MCBailey-CTS/0Library/0Customer/Tower/Bardstown-specific/Nitro Manifold/photo 1.JPG

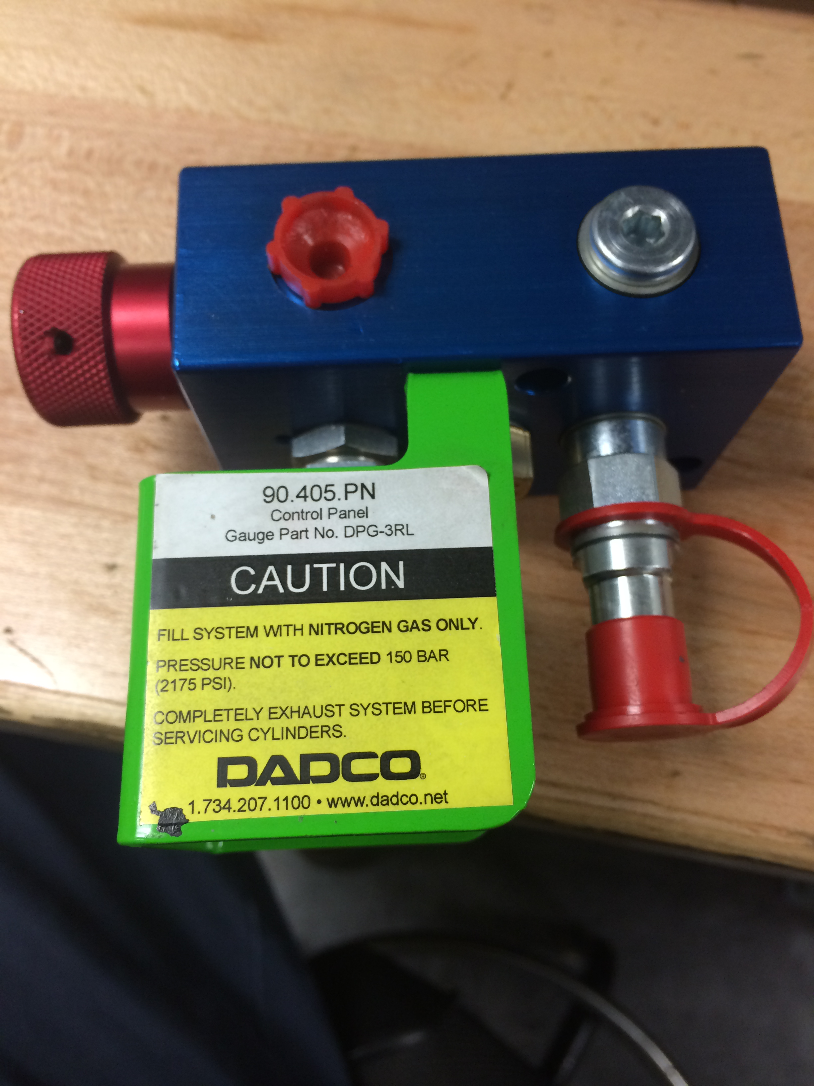
0Customer/Tower/Bardstown-specific/Nitro Manifold/photo 1.JPG
