MCBailey-CTS/0Library/CurveImport/ReadMe.txt

User Defined Reusable Object

Select Folder location from Folder View
Enter Descriptive Name and Part File.
Define Preview Image with Graphic Area
Select all objects with "General" filter (at the top)
