MCBailey-CTS/0Library/SeedFiles/ClampFeetDocs/Van Rob Aurora clamping and hilo info.txt

All clamping lugs/ears should be a standard height of 2" x 3" wide x 3" deep 
All slots in clamping lugs/ears to be 1.125" - 1.250" (clearance for a 1" T-bolt) 
All clamping is manual with the exception of P221 which has hydraulic clamps, 
for which you are not building any tools To confirm, all Van-Rob locations use the same cone type locators.

Regards,

Chuck Haller
Tooling Co-ordinator
Van-Rob, Aurora
Tel. 905-727-8585 ext. 207
Cell. 647-296-0548

HI-LO

6 inches wide forks 
72 outside to outside is max width
