MCBailey-CTS/0Library/0Customer/UGS/Sample Design/2103-000_Binder Cover.docx

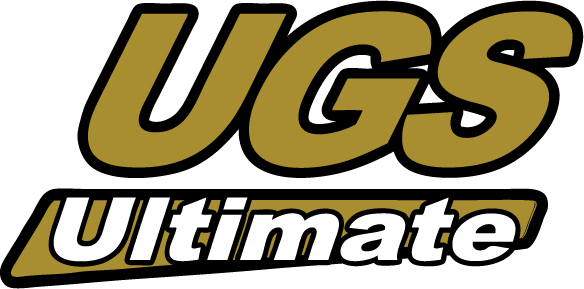
[picture p3: figure]
UGS-Logo

Ultimate Gaging Systems

555 Plymouth Ave. NE

Grand Rapids, MI 49505

616-264-6962

Part name: BRKT SPARE TIRE HOIS

Part #: anu21851.geo_fin001.001002

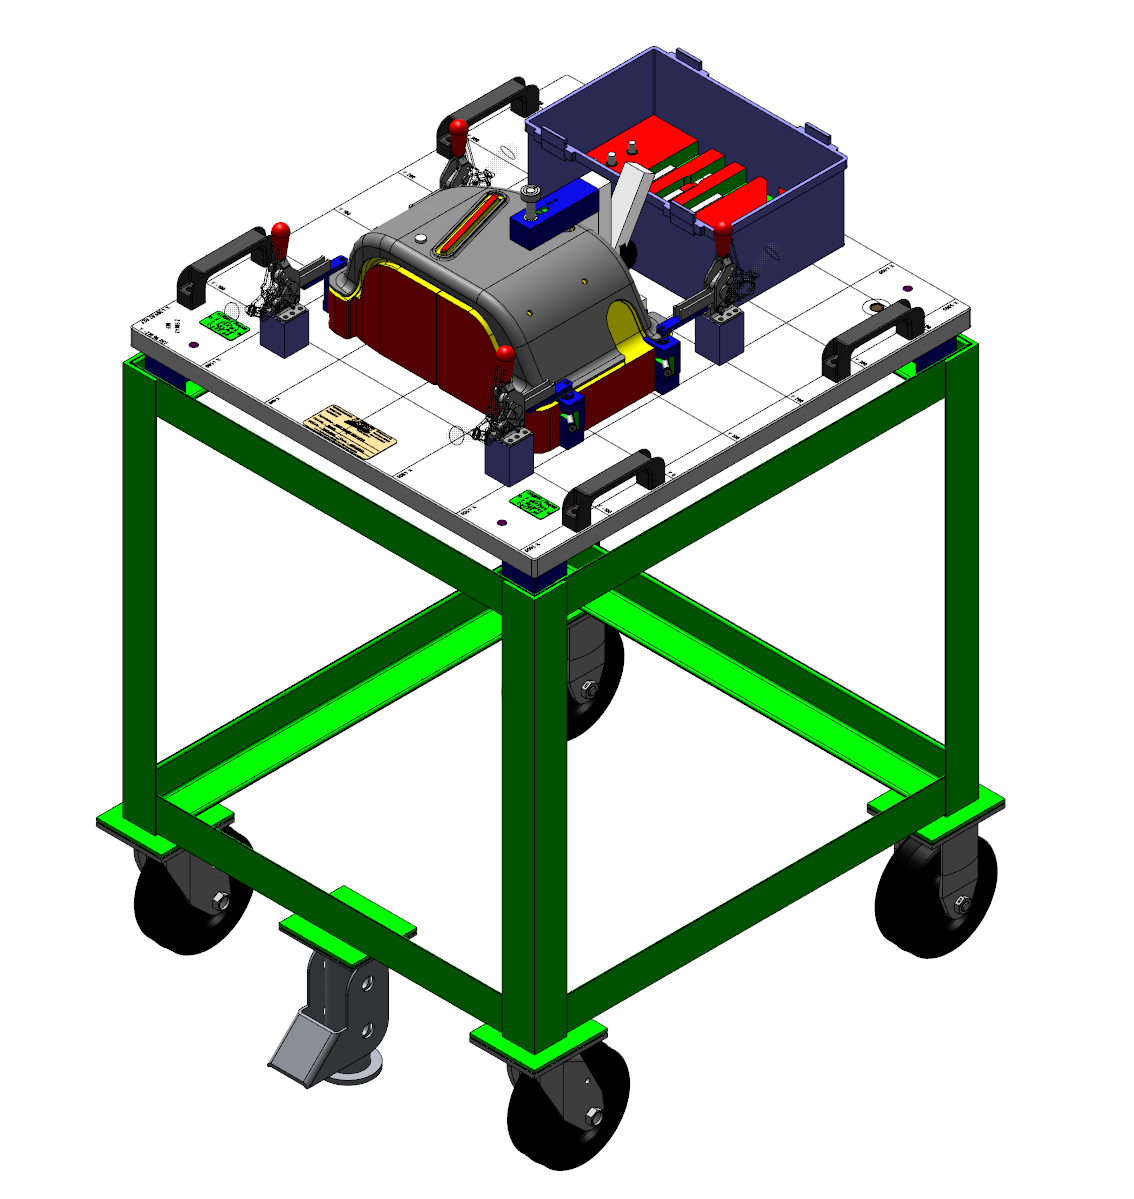
[picture p4: figure]

UGS Job: 2103-000

Customer: ETS

Contact: Brian Bkius
