MCBailey-CTS/0Library/Gauges/Misumi/Misumi Nest Gauges Upper Sub Tools.docx

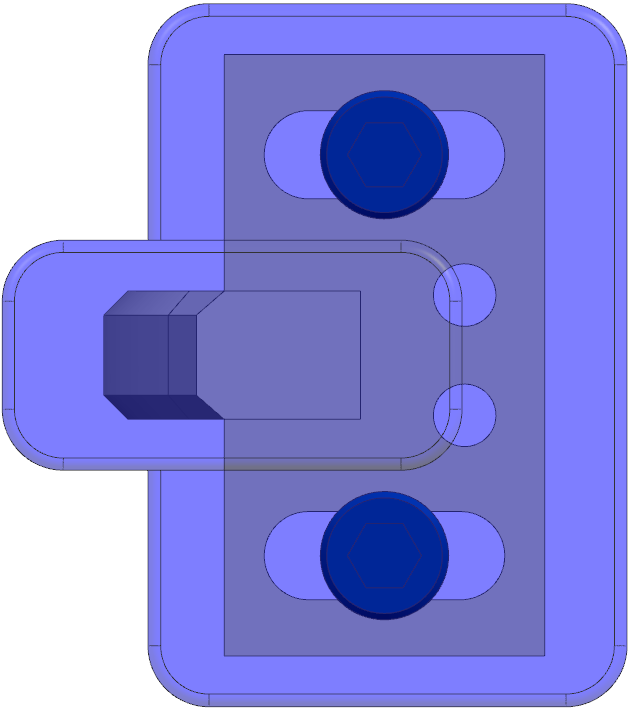
[picture p5: figure]

LEFT

RIGHT

FRONT

BACK

FRONT & BACK – Defaults to SlotWidth/2 +.125”
