MCBailey-CTS/0Library/SeedFiles/ClampFeetDocs/Fanello Die Mounting.pptx

## Die Mounting

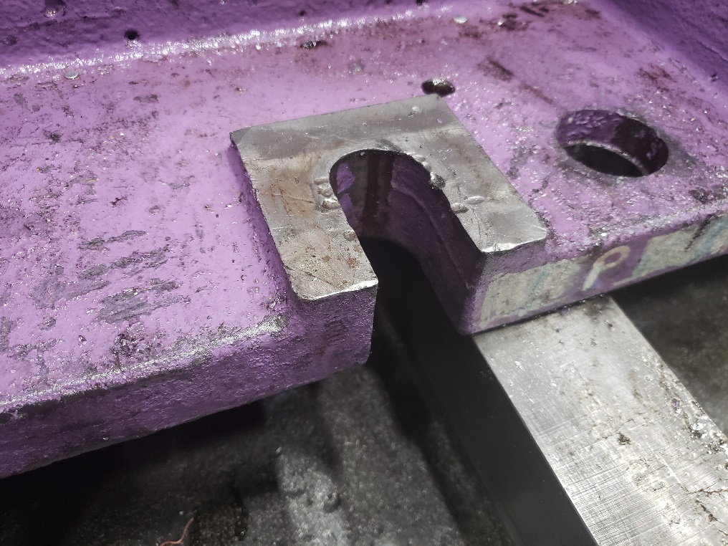
[picture p6: figure]
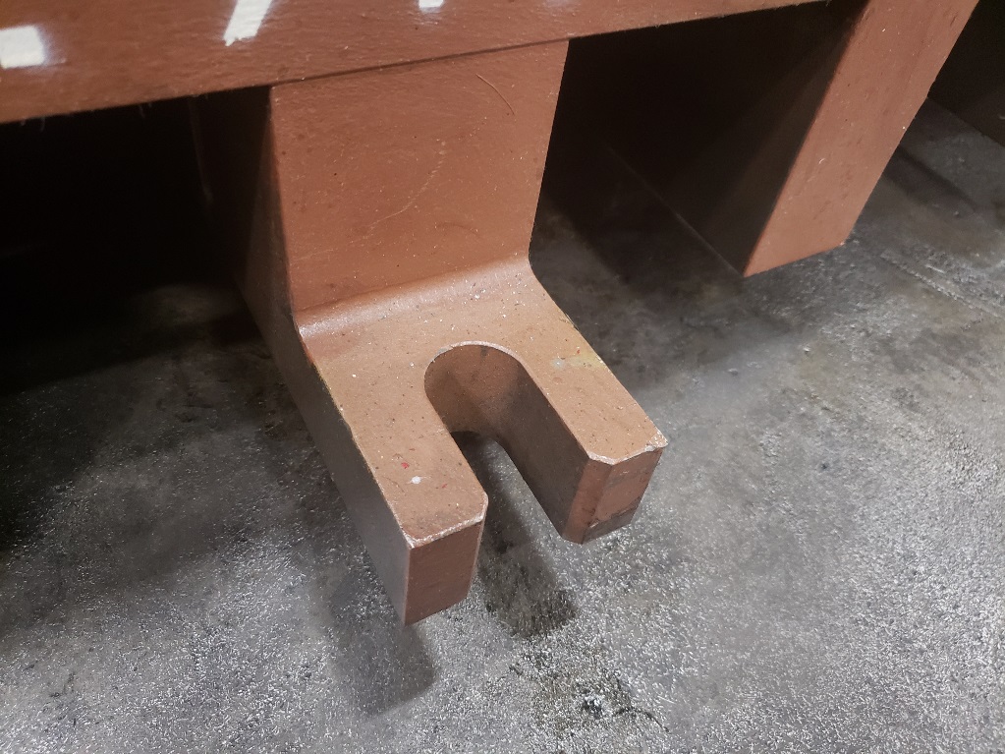
[picture p7: figure]

Slot in either die shoe or parallels. Slots must be 1.125” wide by min of 3” deep
