MCBailey-CTS/0Library/SeedFiles/ClampFeetDocs/MAGNA AUTOTEK.pptx

MAGNA AUTOTEK LOWER

125mm

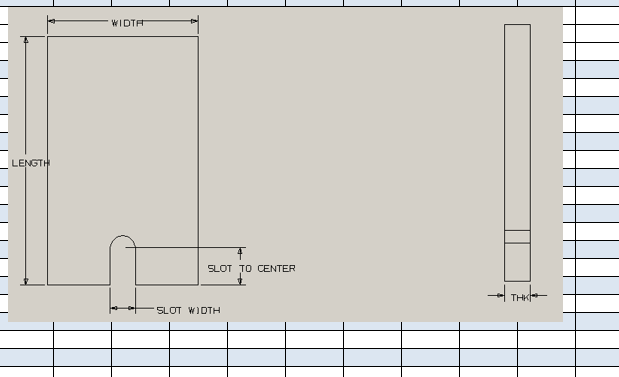
[picture p8: figure]

135mm

98.5mm

63.5mm

35mm

## Slide 2

MAGNA AUTOTEK UPPER

125mm

135mm

98.5mm

63.5mm

50mm
