MCBailey-CTS/0Library/Documentation/CamPositiveReturns.pdf

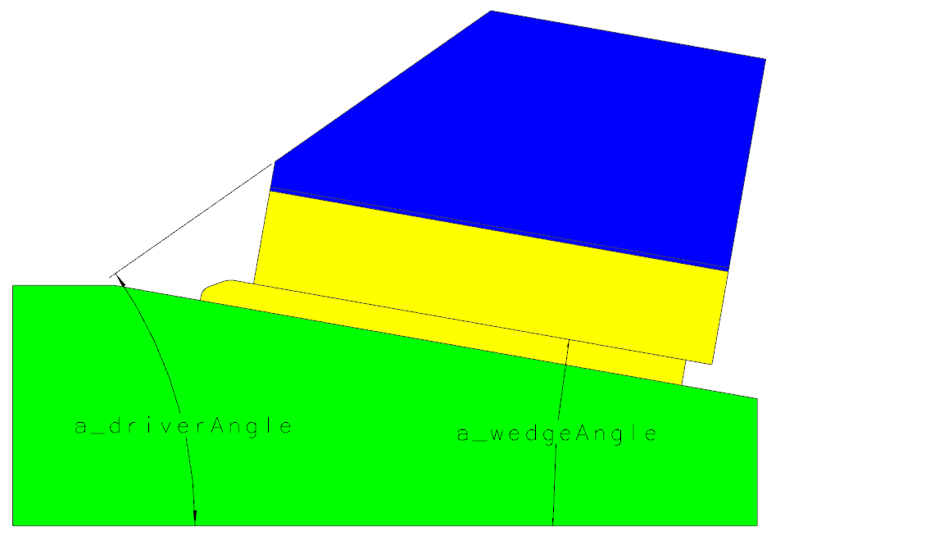
[picture p13: page 1]

DIE MOUNT CAM

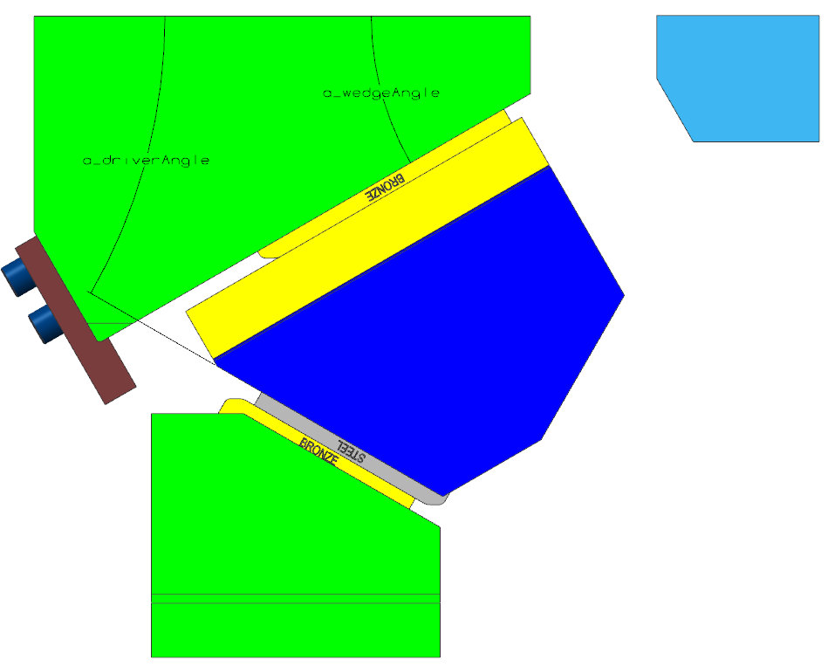
[picture p14: page 2]

AERIAL CAM

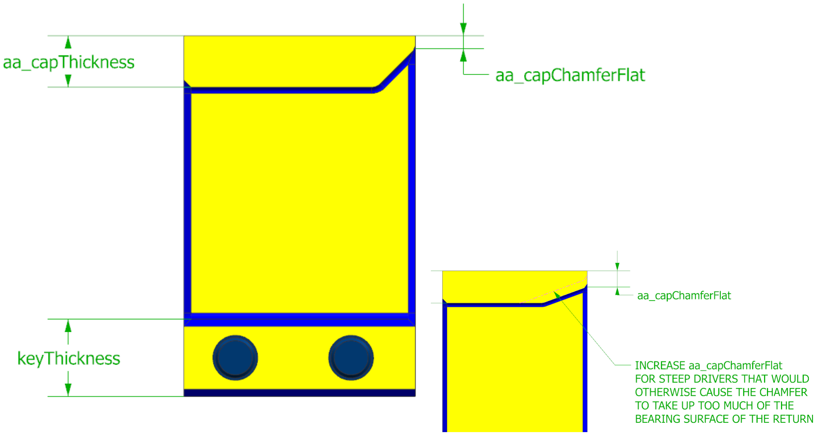
[picture p15: page 3]
