MCBailey-CTS/0Library/SeedFiles/ClampFeetDocs/AE_Metals Stamping Global_2012 21.pdf

Johnson Controls Automotive Experience Global Supplier Standards Manual Tooling and Equipment
Chapter 2
Metals Stamping Dies – Global Tooling Standards

December 2012

Uncontrolled if printed | Page 21 of 40
4.12.3. Stops to be manufactured to the exact inside shut height. Each stop block to be grooved at the center 10mm wide and 1.25mm deep.
4.12.4. All stop blocks to be located between upper and lower parallels.
4.12.5. One safety-block location to be provided on each side of the die.

### 4.13. Parallels

4.13.1. All parallels are to be ground top and bottom.
4.13.2. Proper feed line and shut height to be maintained on all dies per Figure 4.
4.13.3. Parallels used for clamping and locating must be dowelled to the die shoes and sub plates (if present).

4.13.3.a. Parallels must have slotted feet for clamping. Slots will be 28.5mm wide and 65mm long. The position of the upper and lower clamping slots must match the JCI/CM press specified.

4.13.3.b. Clamping flat area must be 100mm long and wide.

4.13.3.c. Clamping height above press ram and bolster must be 50mm.

4.13.3.d. If feet are not outside the die-set periphery, 127mm clearance is required above the clamping surface, for both upper and lower die-set.

4.13.3.e. Lower parallels must have locating features to match the JCI/CM press specified. Tools must have die locators as shown in Figure 8.

4.13.4. Parallels for dies 300 ton and over will be a minimum of 50mm thick.
4.13.5. Parallels for dies 800 ton and over will be a minimum of 62mm thick.
4.13.6. Bolts used for fastening parallels must be a minimum of 19mm diameter.

### 4.14. Transfer Tools

4.14.1 All transfer tools require lower change master plate.
