MCBailey-CTS/0Library/SeedFiles/ClampFeetDocs/Pages from UPDATED FORMEX DIE STD_September-2017 R1.pdf

# FORMEX DIE STANDARDS

## Clamps Model PTC & AIDA Presses

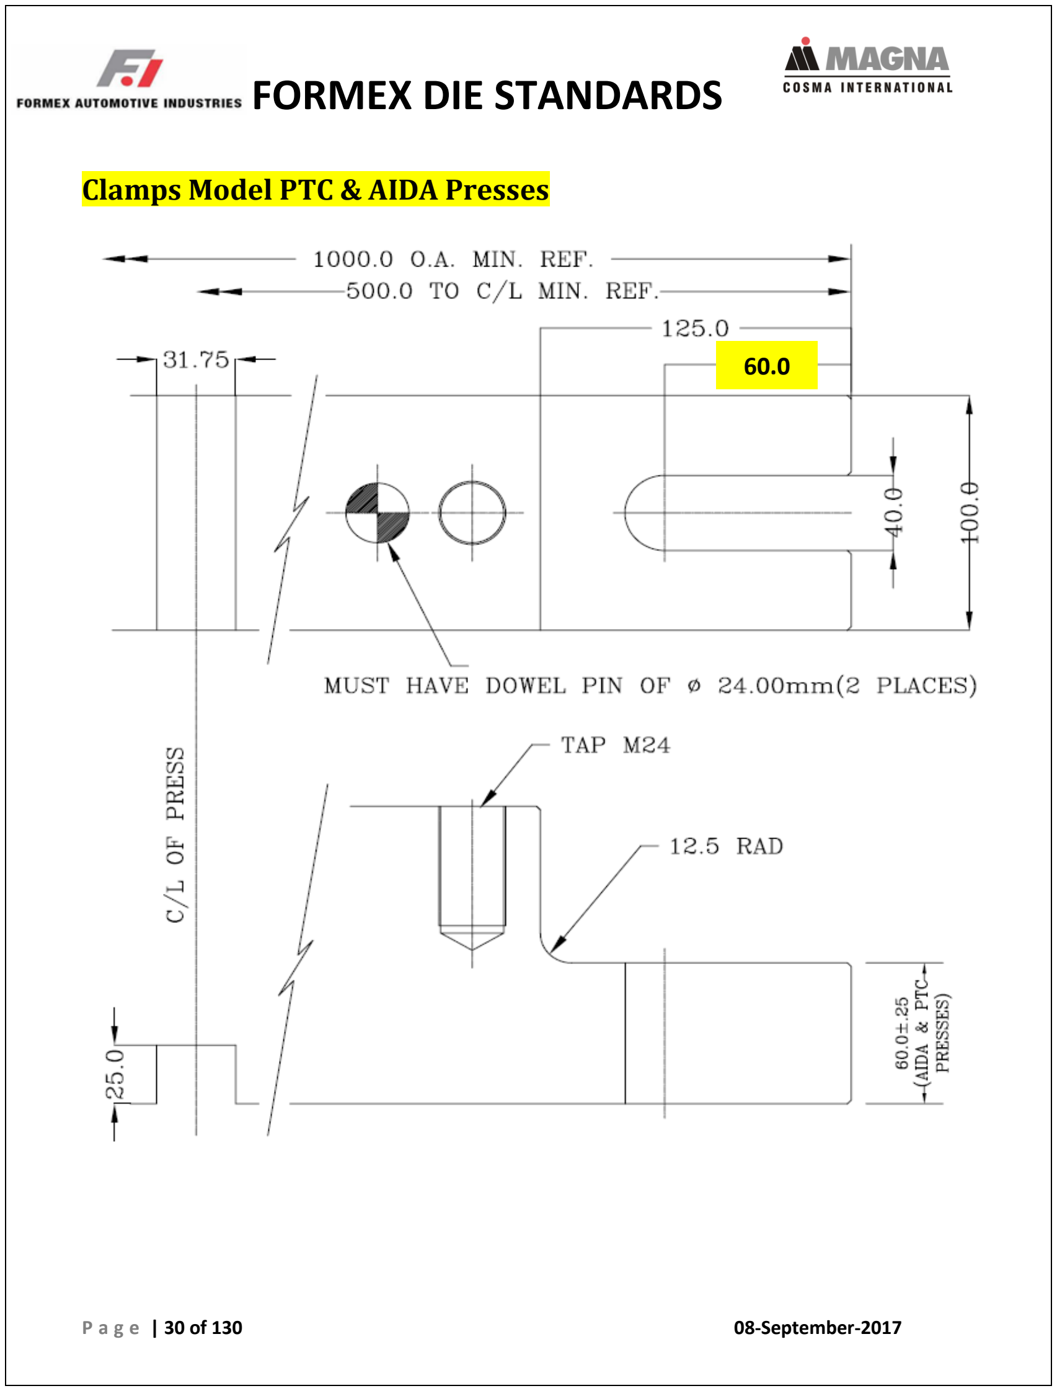
[picture p16: page 1]

P a g e | 30 of 130 | 08-September-2017

60.0
