MCBailey-CTS/0Library/0Customer/UGS/Design Worksheet Checklist 6-21-2017.xls

Design Worksheet Checklist |  | YES | NO | N/A | FIXED
1 | Verify design satisfy all items on Quote & GD&T are Being Checked
2 | Verify datums match GD&T
3 | Verify flatness area is identified
4 | Verify SPC Checks are identified
5 | Verify that if possible the base is within our CNC work envelope
 | The vise max opening in 12.250"
 | The Hurco is 24.5" X 52"
 | The YCM is 24.5" X 52" or 21" X 57"
6 | Verify all Go/Nogo pins are identified and accounted for
7 | Verify feeler and flush areas are identified.
8 | Verify stabs are identified and it's clear where they are used.
9 | Verify Layout Drawing(s) indicate usage of hand apply items.
10 | Verify that any missing information is noted.
11 | Verify design used customer standards.
12 | Is any missing information noted
13 | Does GD&T match the CAD.
14 | Verify the proper data level is being used.
15 | Verify the proper GD&T level is being used.
16 | Verify all details are useable.
 | Can you use all the stabs on the job without interference.
 | Can you use the indicators in all SPC bushings without interference.
 | Can you open the clamps without interference.
 | Can you open the swings without interference.
17 | Verify mountings holes matched to their mating details.
18 | Verify details are using the proper material type.
19 | Verify all details included in stocklist with correct quantity.
20 | Can you load and unload a part
21 | Is there any features that require adjustability
22 | Do purchase items have the correct part number
23 | Verify details prints indicate additional process if needed.
24 | Verify pin tolerances are labeled to customer tolerances.
25 | Did you create Edrawing files
26 | Did you create .iges files for CMM
27 | Did you update the 2D and 3D .pdf files
28 | Did you export a .step file of the model
29 | Verify the gage instructions are in the book.
30 | Make outsource files if needed.
31 | Delete old files.
Note for Design Update:
