MCBailey-CTS/0Library/SeedFiles/ClampFeetDocs/Toledo Clamp Specs for 1000 3000 presses.xlsx

1000 T CLAMPING INFORMATION UPPER AND LOWER
3000 T CLAMPING INFORMATION UPPER AND LOWER
