MCBailey-CTS/0Library/0Customer/UGS/Sample Design/2103-000_Booking Check List 6-8-2017.xls

Design Checker Checklist |  |  | DATE : |  | 2018-05-08
CUSTOMER : |  | ETS | JOB# : |  | 2103
CHECKED BY : |  | TN | YES | NO | N/A | FIXED
1 | Can part be load / unload without interference?
2 | Verify all details are useable?
3 | Can you use all the stabs on the job without interference?
4 | Can you use the indicators in all SPC bushings without interference?
5 | Can you open the clamps without interference?
6 | Can you open the swings without interference?
7 | Verify all details included in stocklist with correct quantity.
8 | Verify mountings holes matched to their mating details.
9 | Verify all details that requires details print accounted for.
10 | Verify details prints & stocklist for proper material type.
11 | Verify details prints & stocklist use the proper size.
12 | Verify details prints indicate additional process if needed.
13 | Verify details prints include all info required to make details.
14 | Verify pin tolerances are labeled to customer tolerances.
15 | Create Edrawing files
16 | Create .iges files for CMM
17 | Update the 2D and 3D .pdf files
18 | Export a .step file of the model
19 | Verify the gage instructions are in the book.
20 | Make outsource files if needed.
21 | Delete old files.
Note for Design Update:
