MCBailey-CTS/0Library/SeedFiles/ClampFeetDocs/Gonvarri_Clamp_Specs.pptx

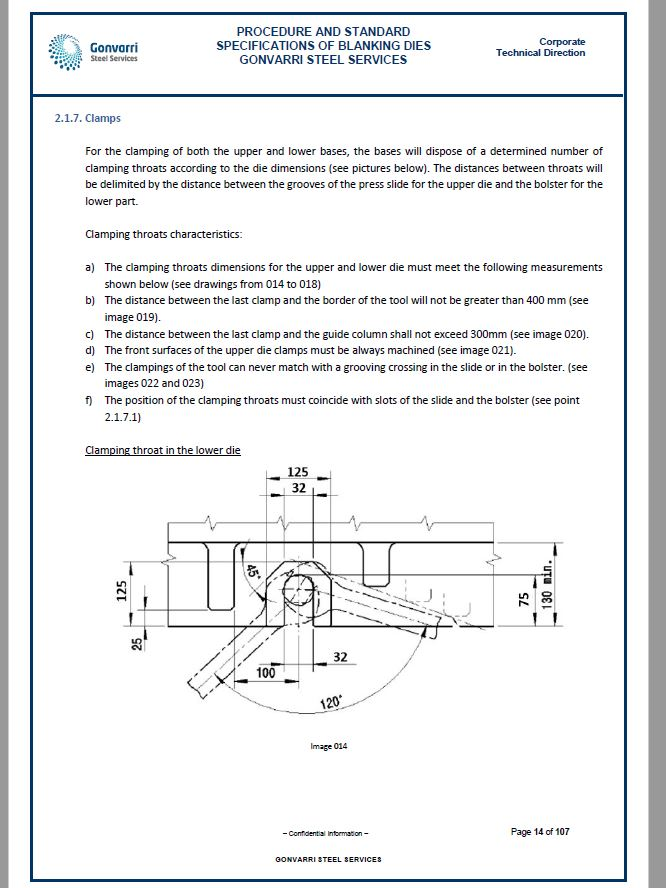
[picture p17: figure]

## Slide 2

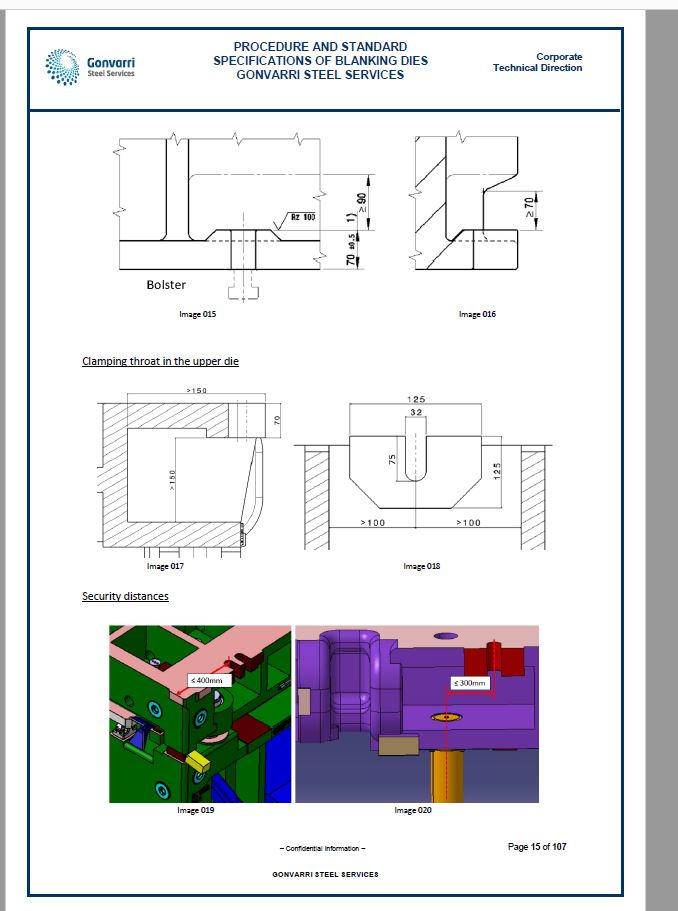
[picture p18: figure]

## Slide 3

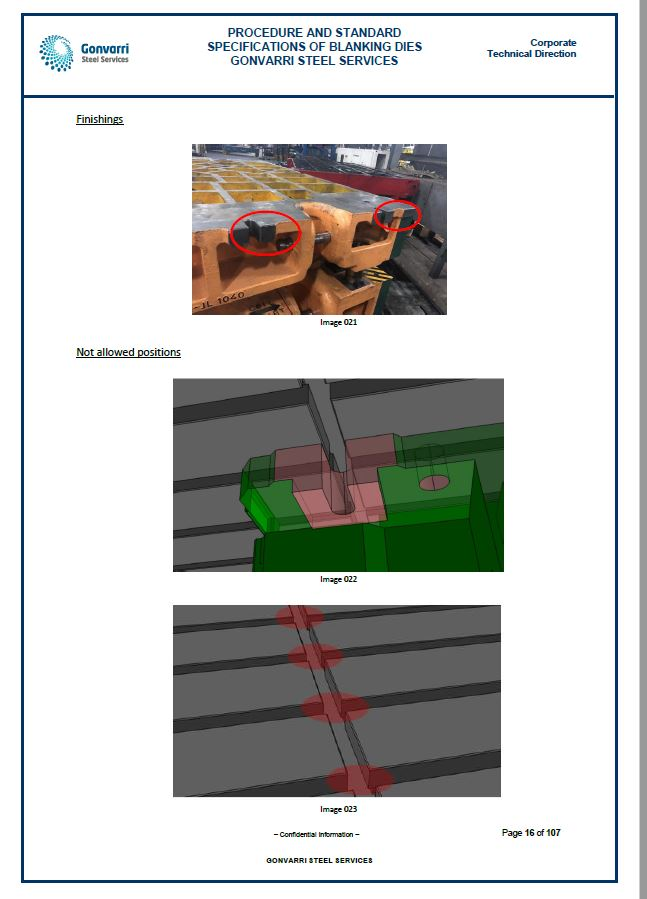
[picture p19: figure]

## Slide 4

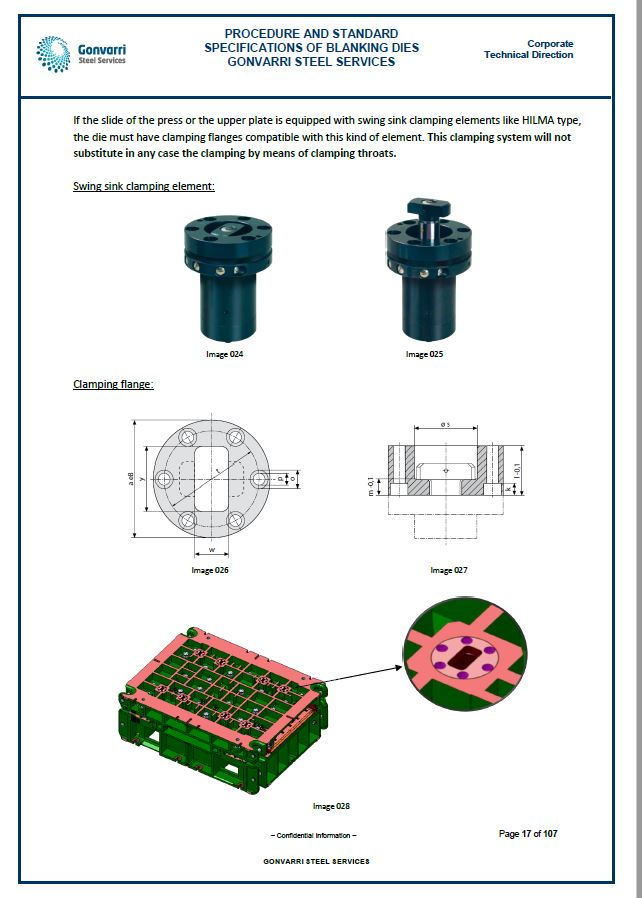
[picture p20: figure]
