MCBailey-CTS/0Library/SeedFiles/ClampFeetDocs/Shiloh Clamp Feet Specs.docx

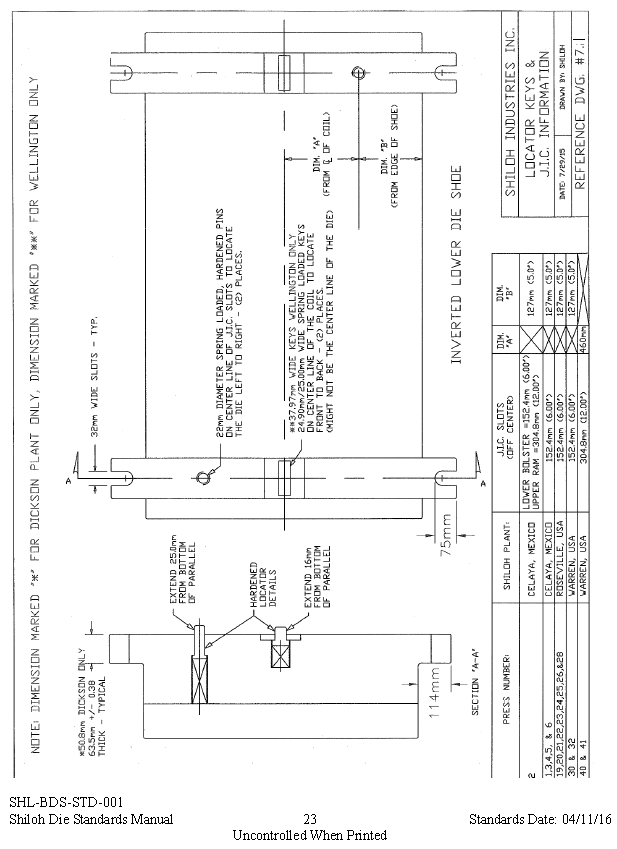
[picture p21: figure]
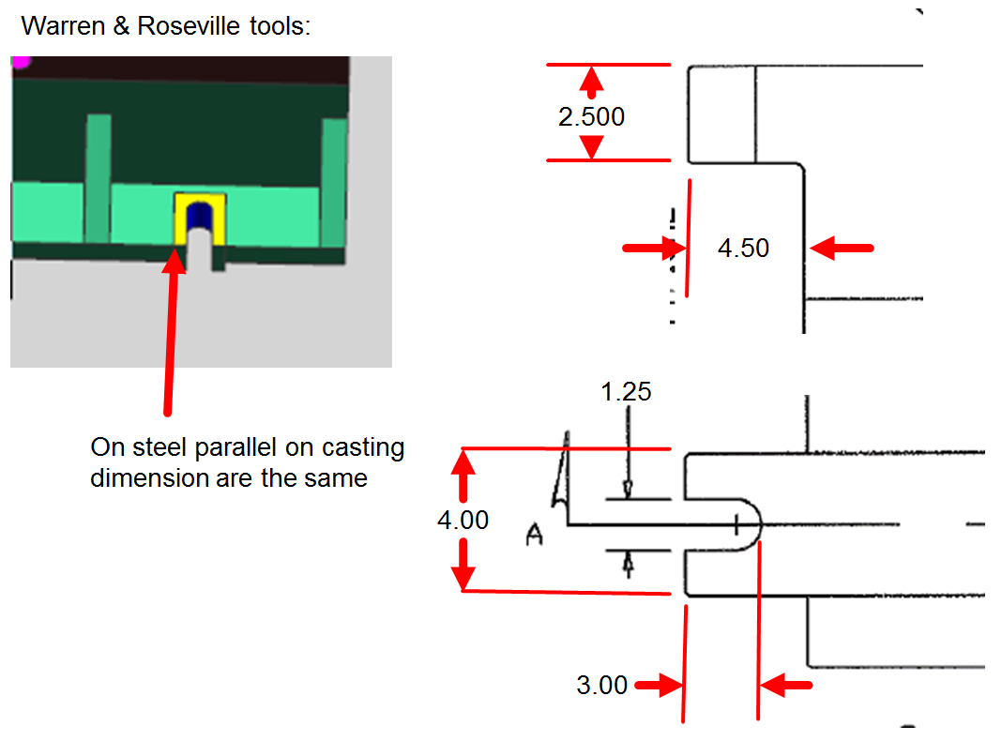
[picture p22: figure]
