MCBailey-CTS/0Library/SeedFiles/ClampFeetDocs/186 - PK USA - 200Ton C Frame.docx

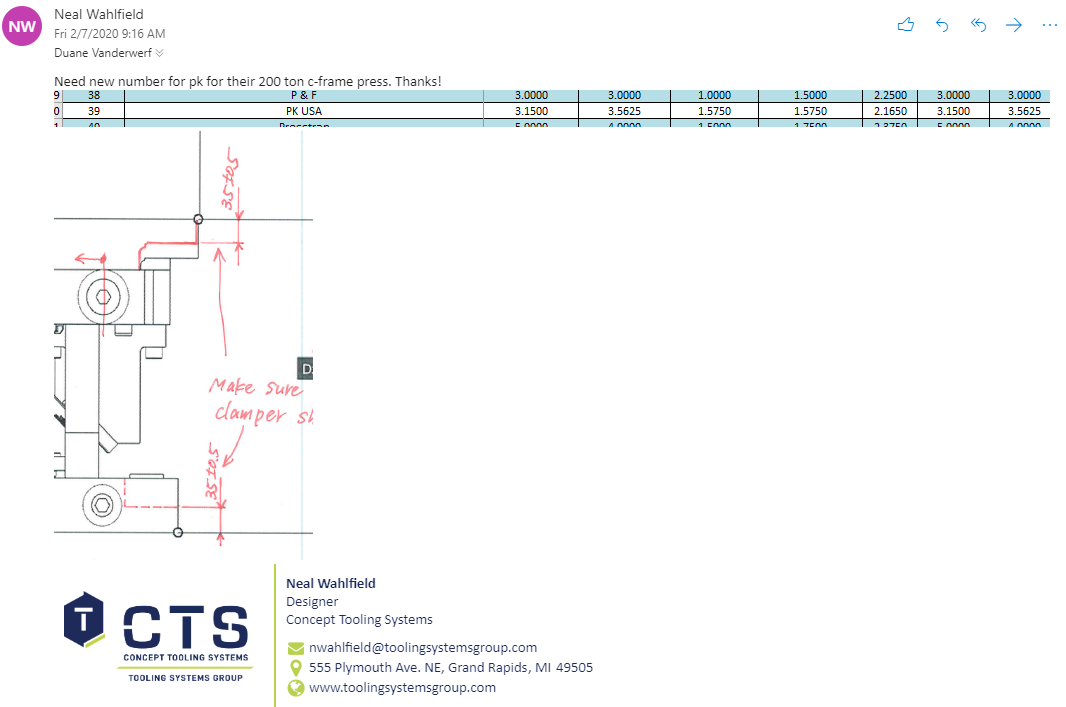
[picture p69: figure]
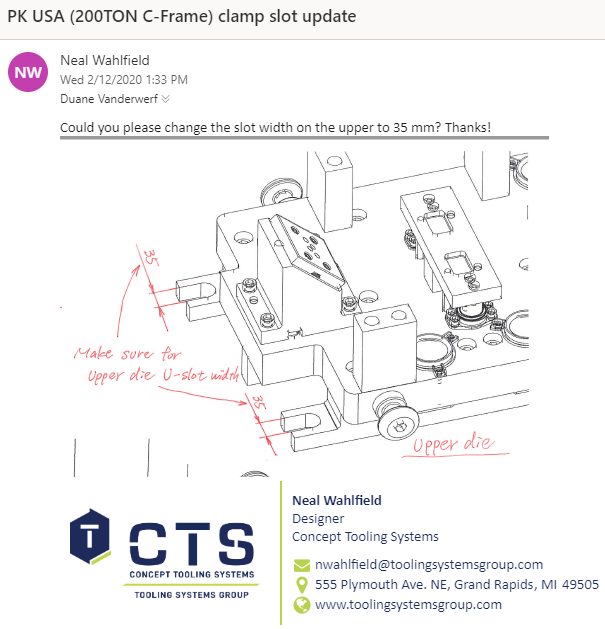
[picture p70: figure]
