MCBailey-CTS/0Library/SeedFiles/ClampFeetDocs/209 - Kirchhoff 550 Ton Press.docx

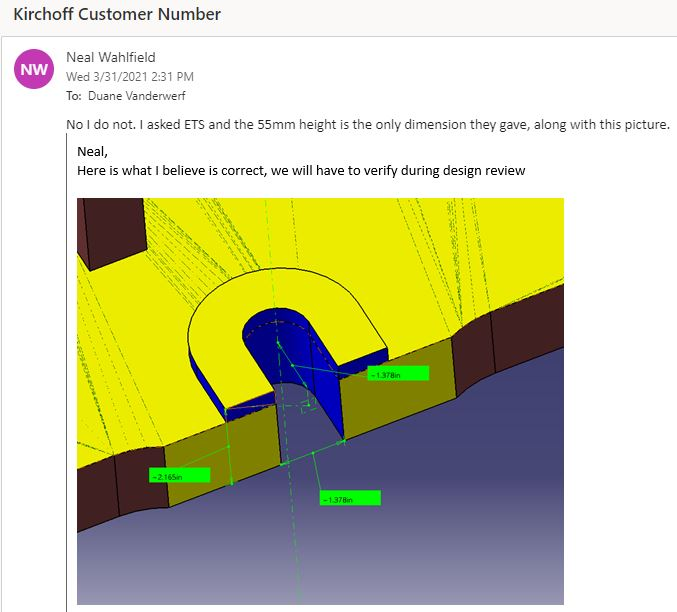
[picture p71: figure]
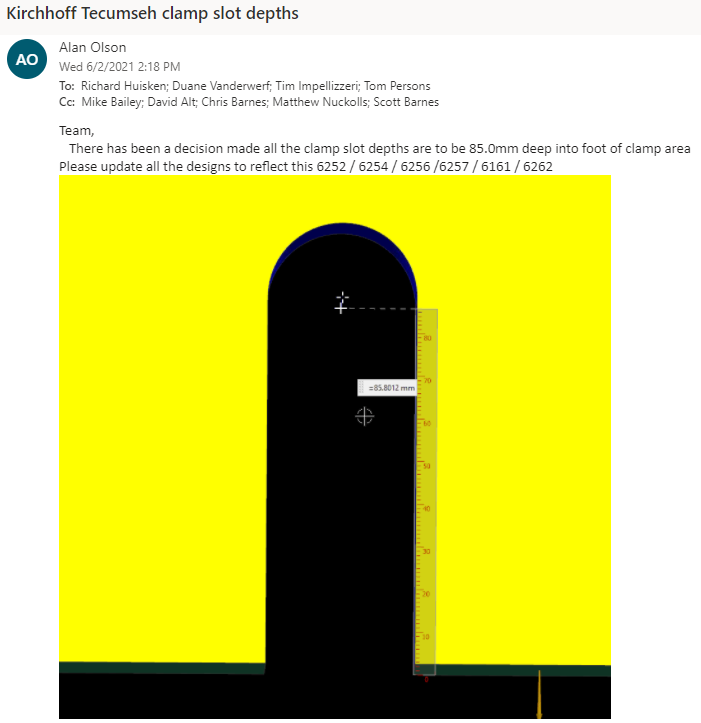
[picture p72: figure]
