MCBailey-CTS/0Library/SeedFiles/ClampFeetDocs/213 - Tesla Eson Mexico.docx

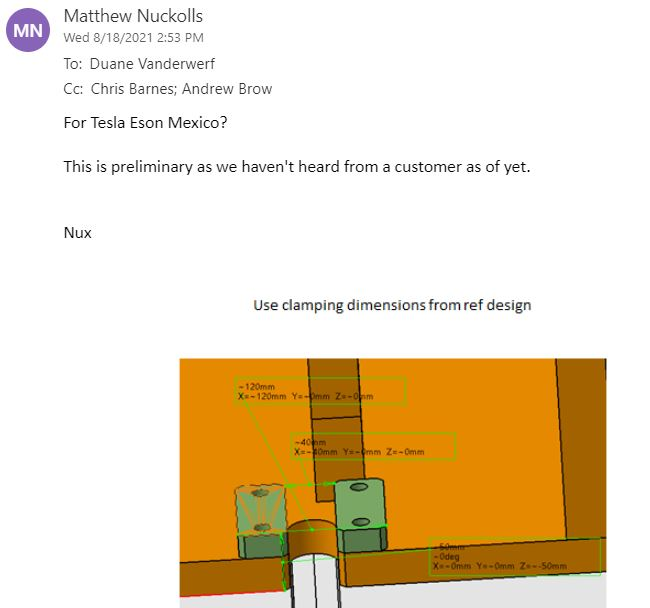
[picture p73: figure]
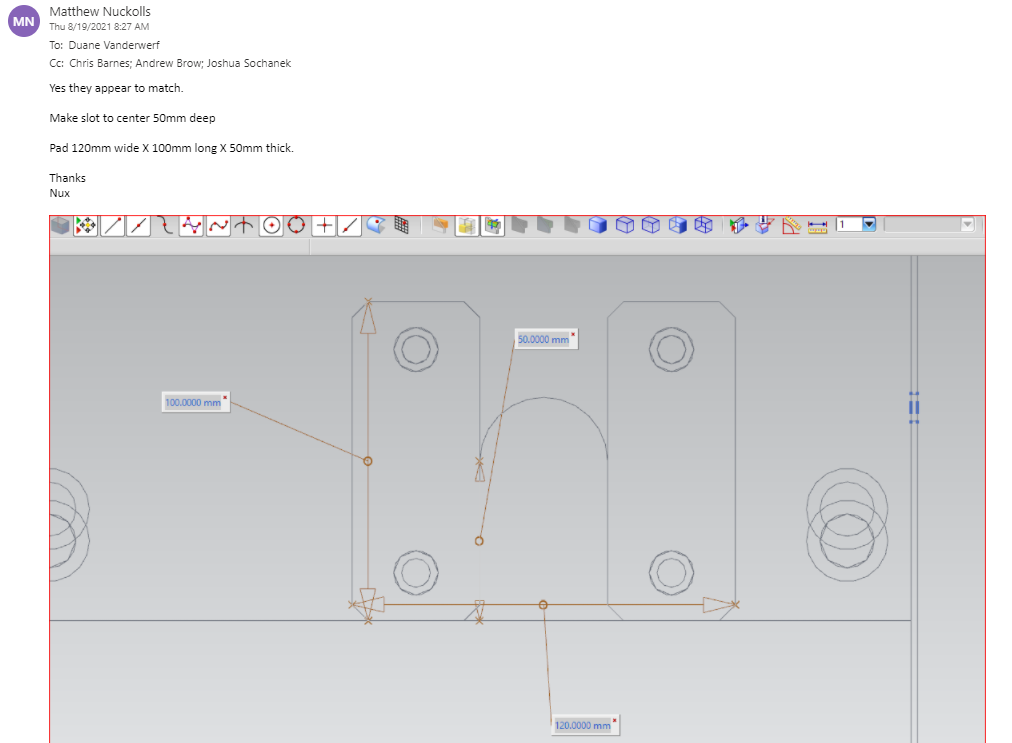
[picture p74: figure]
