MCBailey-CTS/0Library/SeedFiles/ClampFeetDocs/215 - Erdrich 500Ton.docx

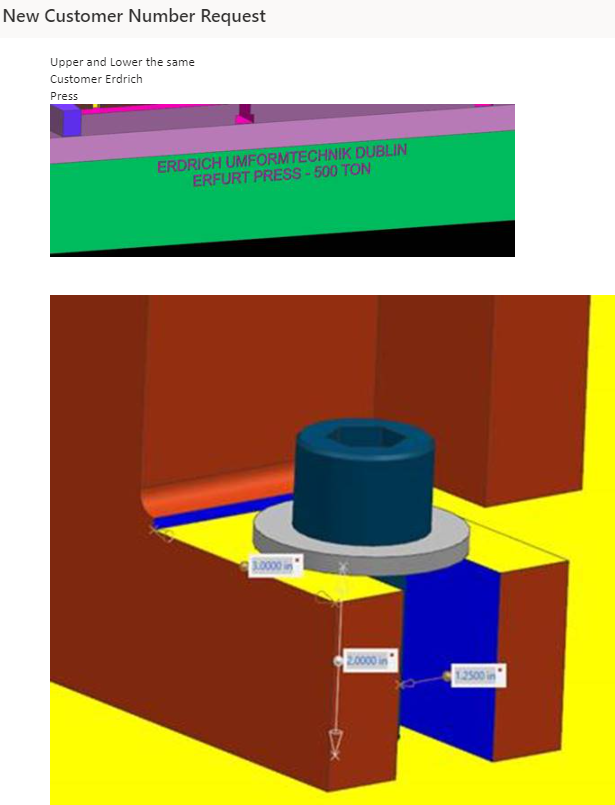
[picture p75: figure]
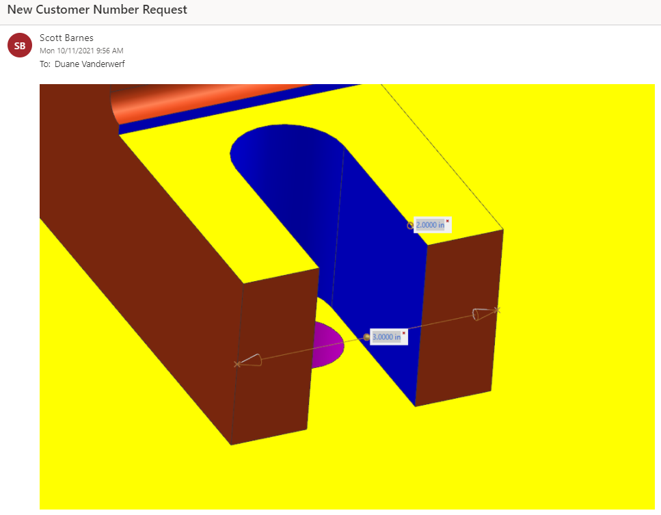
[picture p76: figure]
