MCBailey-CTS/0Library/SeedFiles/ClampFeetDocs/GeStamp Mexico CustomerNo 83.docx

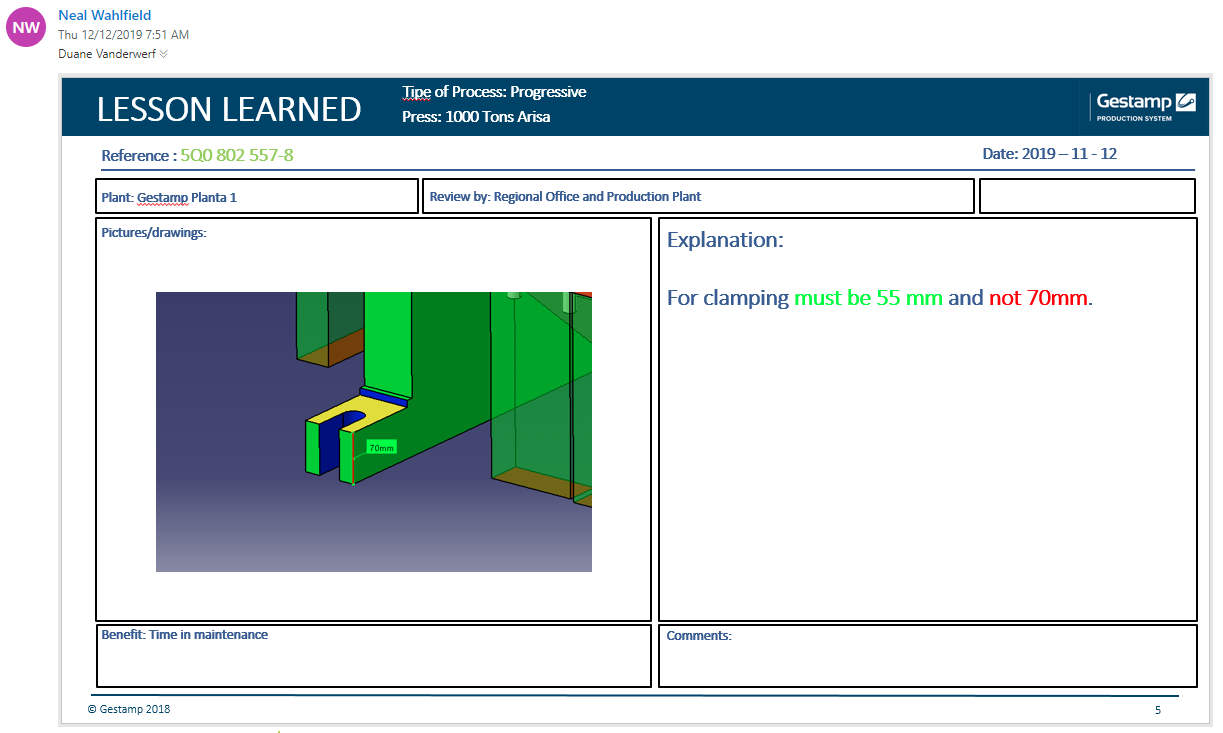
[picture p77: figure]
