MCBailey-CTS/0Library/SeedFiles/ClampFeetDocs/Highland Diversified Services.docx

Chad Kooienga

Mon 4/15/2019 9:53 AM

https://toolingsystemsgroup.sharepoint.com/TSG/PM20/Customer%20Standards%20Library/Forms/AllItems.aspx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

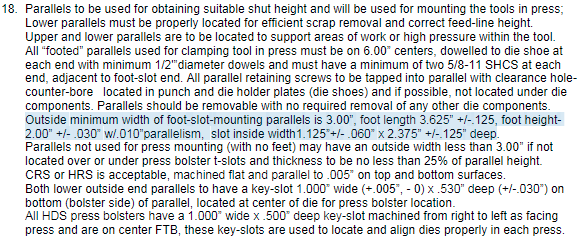
[picture p78: figure]

Chad Kooienga

CTS

Designer/Diemaker

ckooienga@toolingsystemsgroup.com

616-264-6952
