MCBailey-CTS/0Library/SeedFiles/ClampFeetDocs/Tenneco Walker-Elkhart 400 Ton.docx

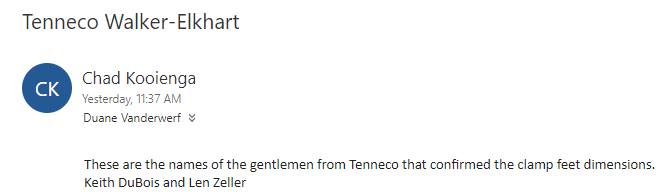
[picture p79: figure]
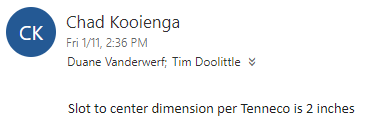
[picture p80: figure]
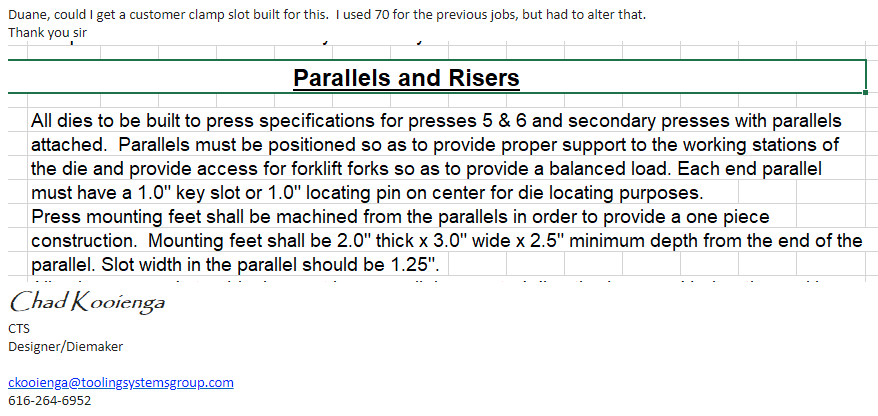
[picture p81: figure]
