MCBailey-CTS/0Library/SeedFiles/ClampFeetDocs/Tower Bardstown Press 1 and 2.docx

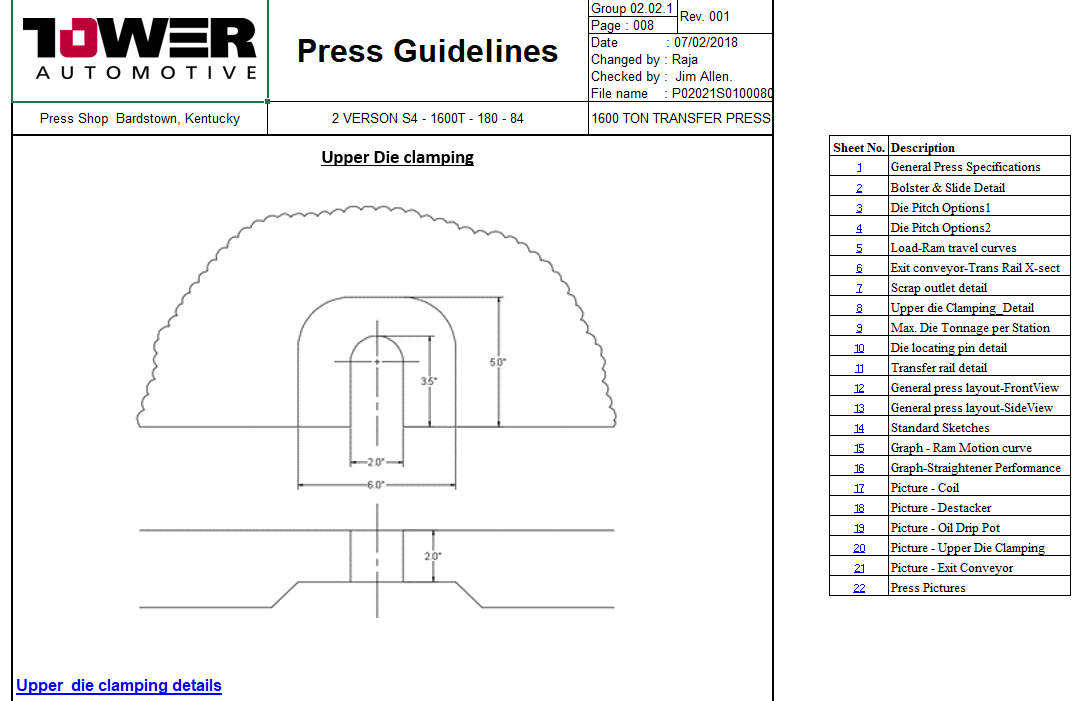
[picture p82: figure]

SharePoint – Presses – Tower Automotive – Press Documents – Bardstown – 02-1600Ton
