MCBailey-CTS/0Library/SeedFiles/ClampFeetDocs/Tower Chicago Presses 1-2-3.pptx

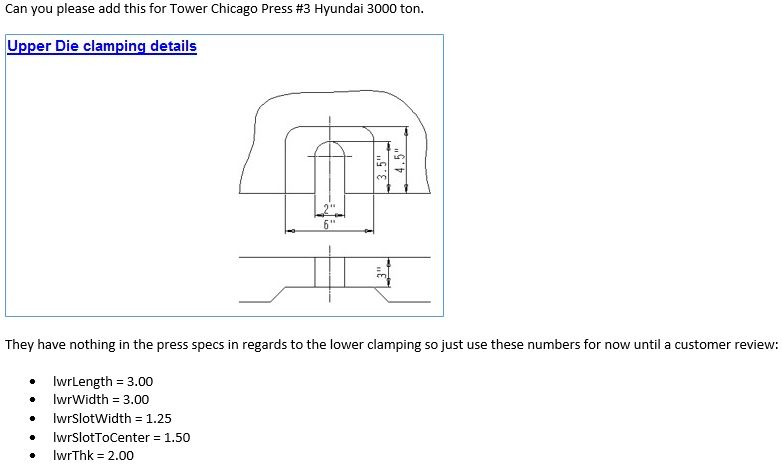
[picture p83: figure]

## Slide 2

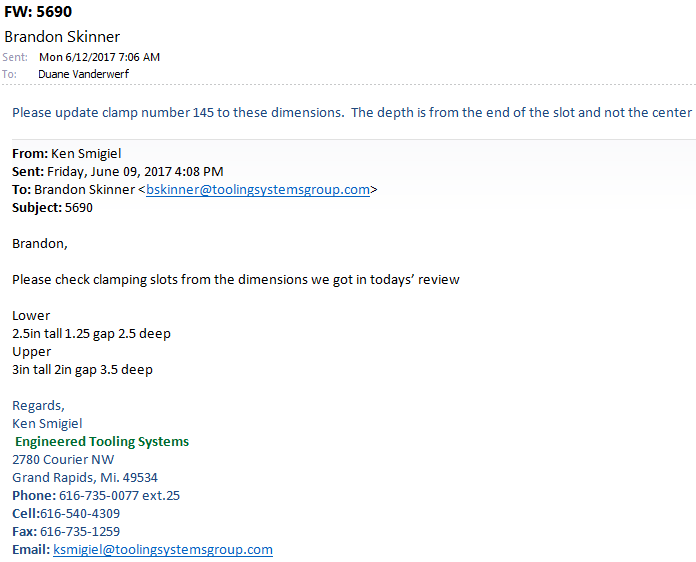
[picture p84: figure]
