MCBailey-CTS/0Library/SeedFiles/Layout/Deploy Updates Process.docx

XXXX-900-strip

XXXX-010-strip

XXXX-010-strip

XXXX-010-layout

XXXX-020-layout

XXXX-strip-control

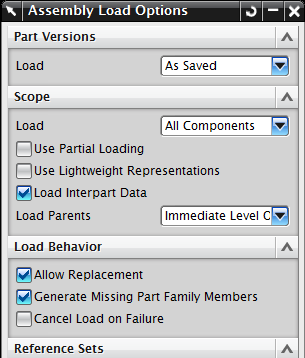
[picture p85: figure]
