MCBailey-CTS/0Library/Stamps/CumsaMarkingUnits/4-digit stamp.pptx

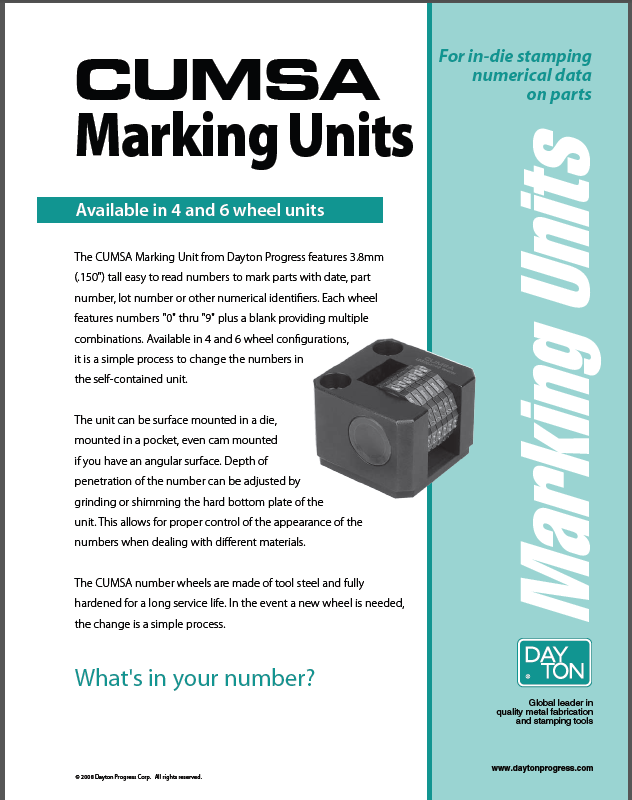
[picture p86: figure]

## Slide 2

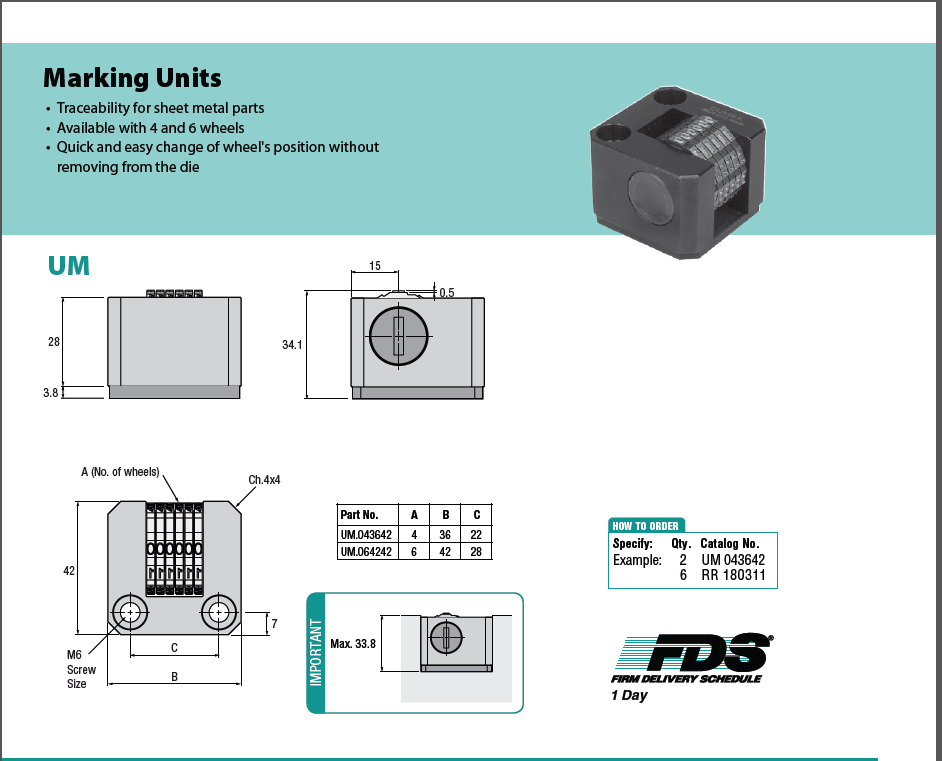
[picture p87: figure]

We will be using the 4-digit version
