MCBailey-CTS/0Library/SeedFiles/ClampFeetDocs/Gedia Standard Page 43.pdf

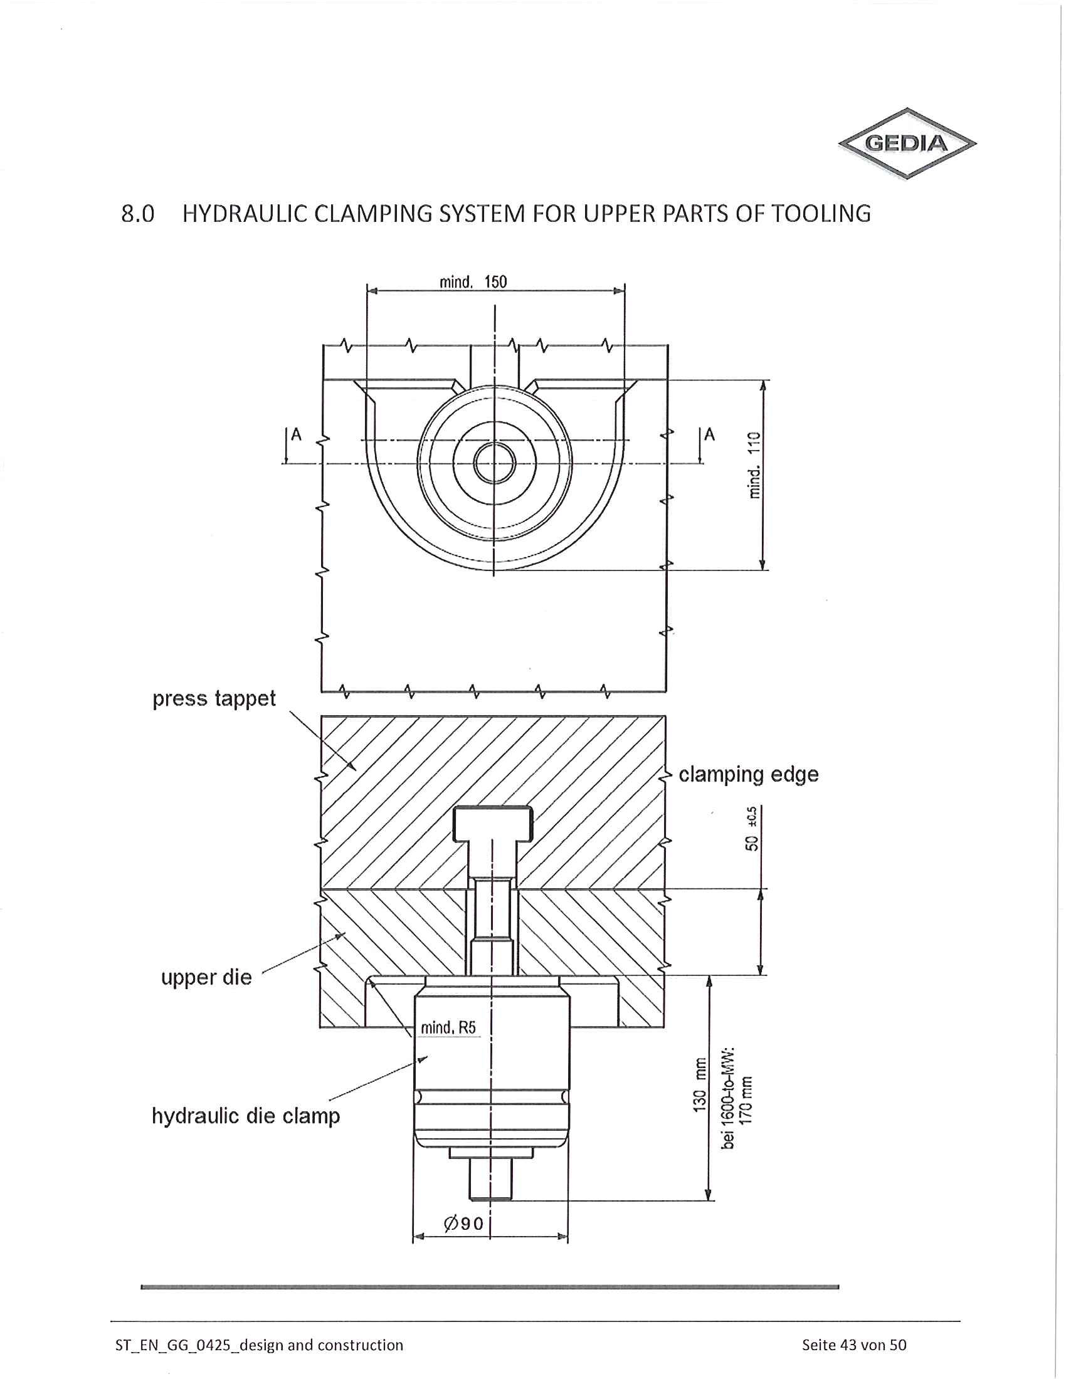
[picture p88: page 1]
