MCBailey-CTS/0Library/SeedFiles/ClampFeetDocs/Shiloh Progressive Dies.pdf

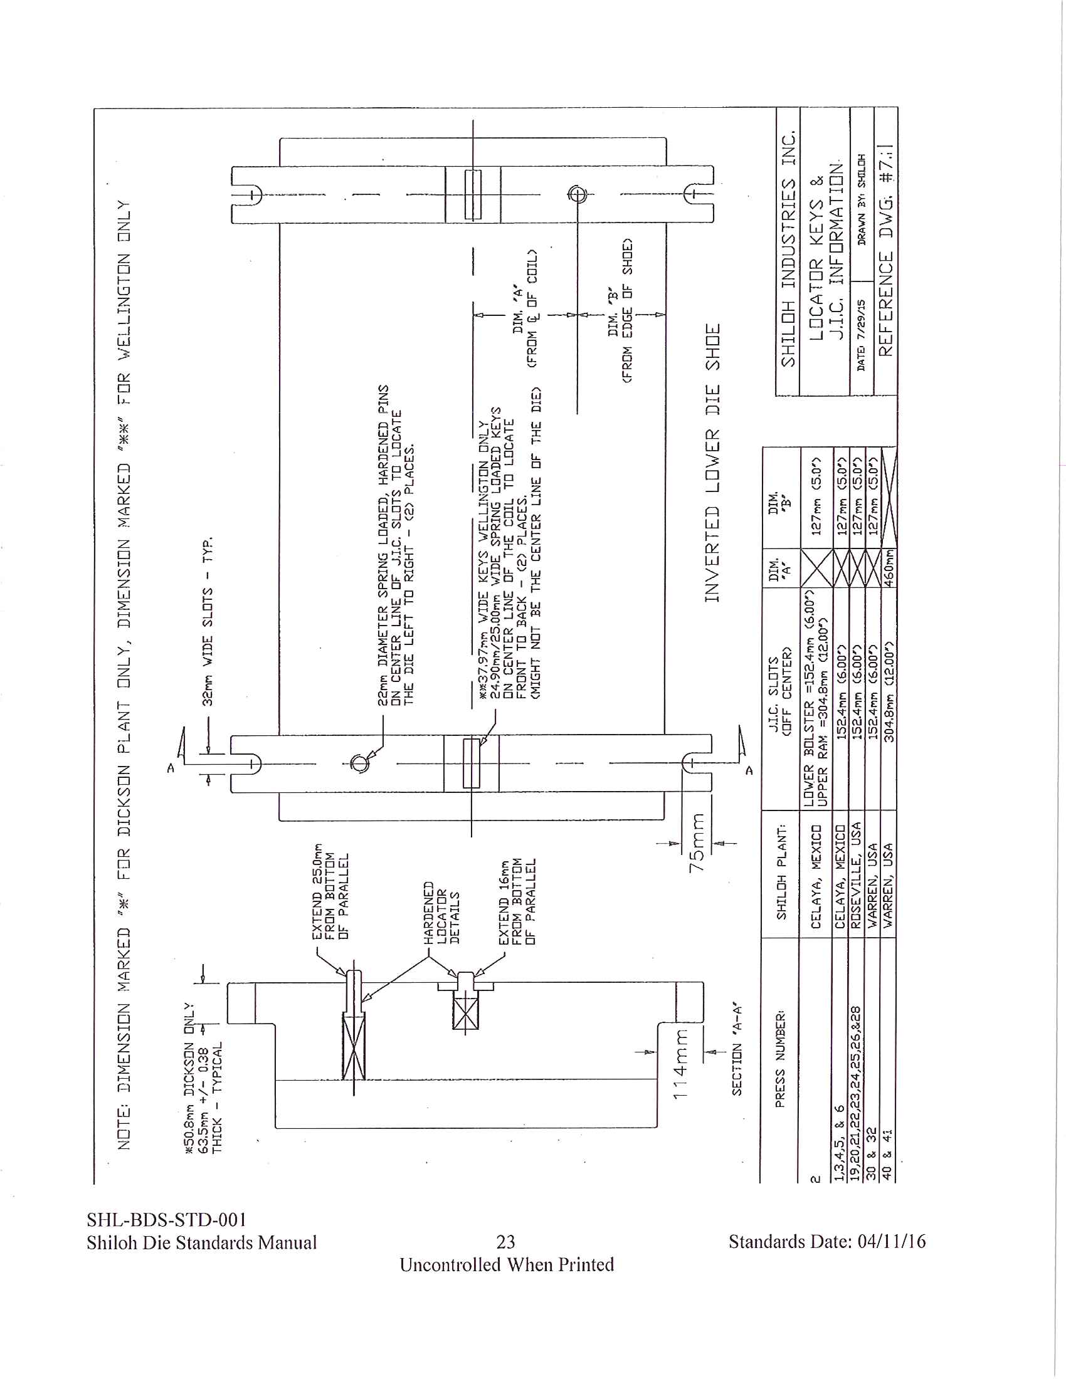
[picture p89: page 1]
