MCBailey-CTS/0Library/SeedFiles/ClampFeetDocs/Obsolete/Tower-Bardstown 136 - Addtional Sub Tool in Upper.docx

Needs additional sub tool in upper as shown below.

W:\standards\Tower\Standards\Tower-Plant-specific\Bardstown-specific\start shoe for 1600 ton presses\1600ton-prog-501.prt

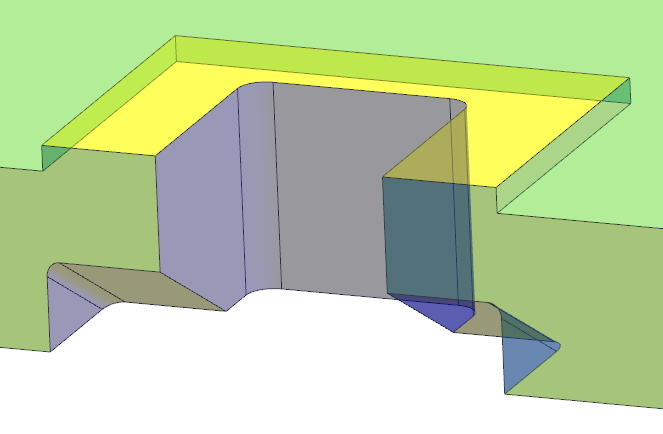
[picture p90: figure]
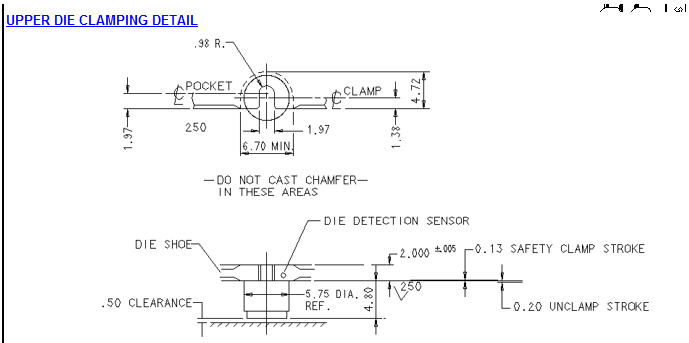
[picture p91: figure]
