MCBailey-CTS/0Library/Documentation/90 deg. arial cam.PNG

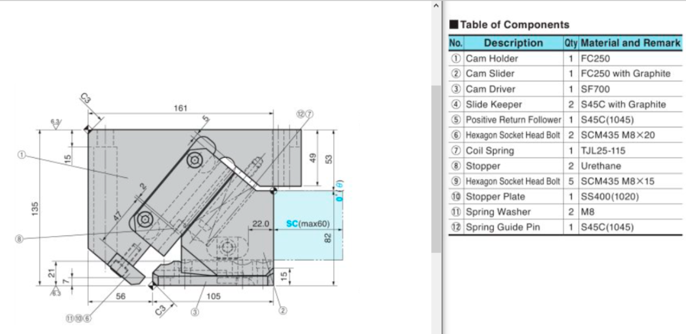
Documentation/90 deg. arial cam.PNG
