MCBailey-CTS/0Library/Documentation/999 Block.PNG

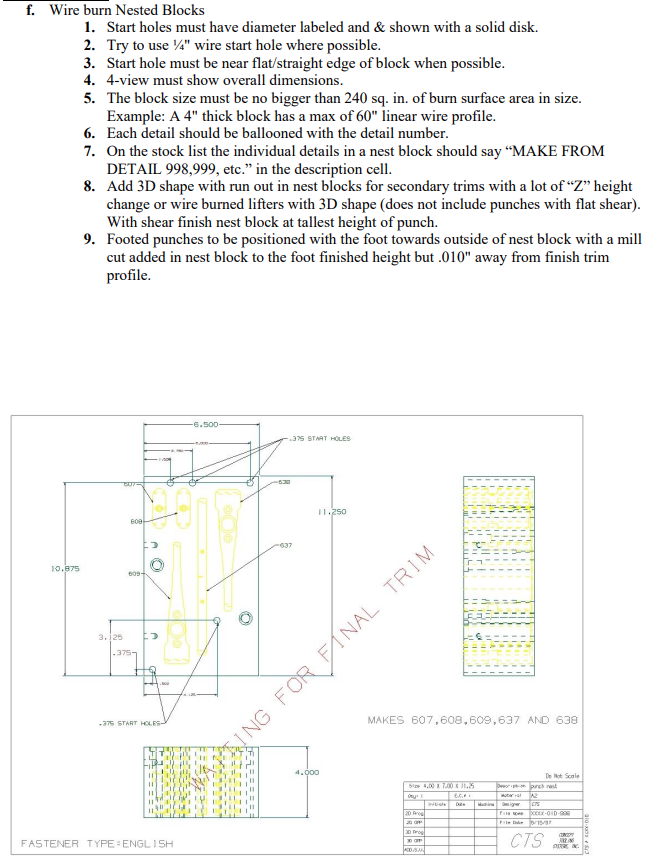
Documentation/999 Block.PNG
