MCBailey-CTS/0Library/Documentation/AerialCamParallel.JPG

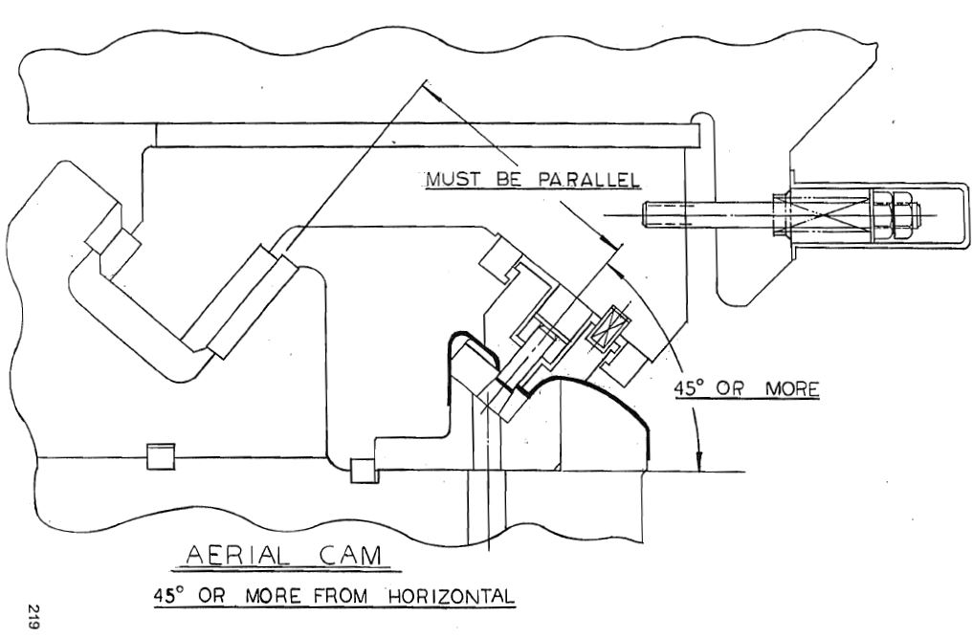
Documentation/AerialCamParallel.JPG
