MCBailey-CTS/0Library/Documentation/Bypass Notches.PNG

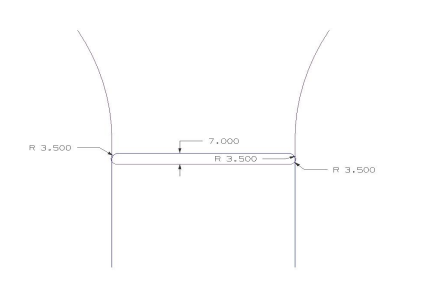
Documentation/Bypass Notches.PNG
