MCBailey-CTS/0Library/Documentation/Color Codes.PNG

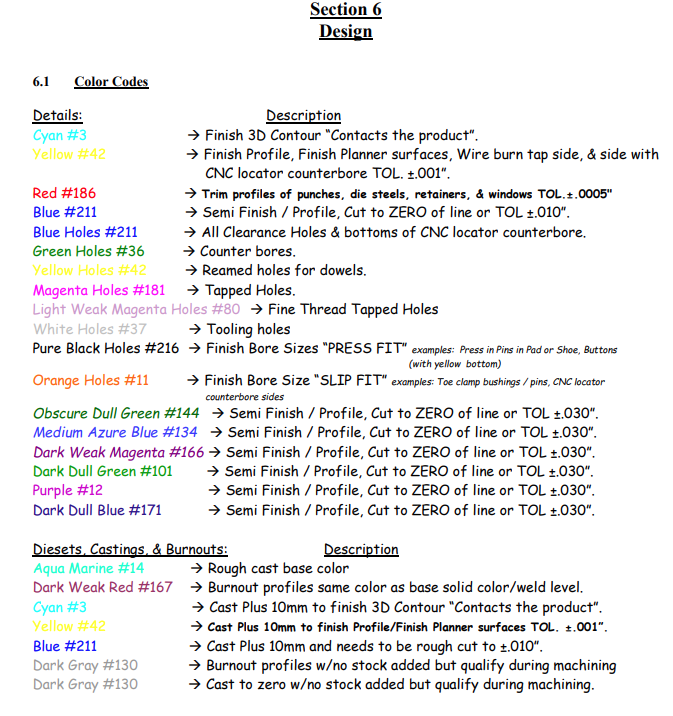
Documentation/Color Codes.PNG
