MCBailey-CTS/0Library/Documentation/Drop Thru.PNG

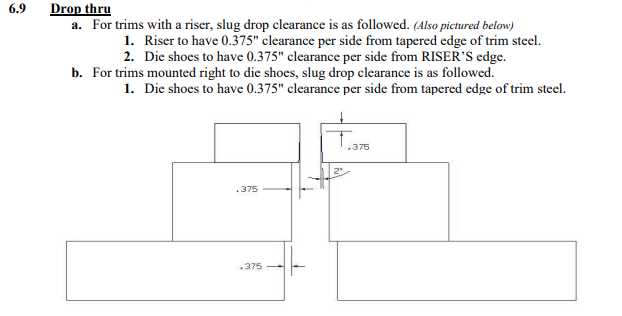
Documentation/Drop Thru.PNG
