MCBailey-CTS/0Library/Documentation/Scrap Cutter.PNG

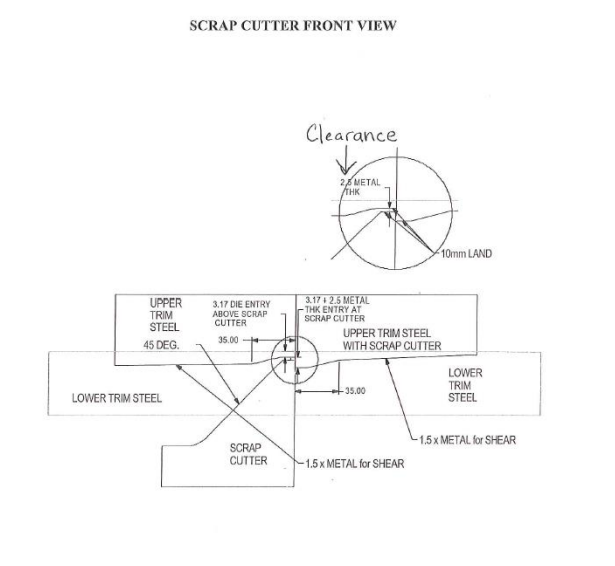
Documentation/Scrap Cutter.PNG
