MCBailey-CTS/0Library/Documentation/Standard Tooling Length.PNG

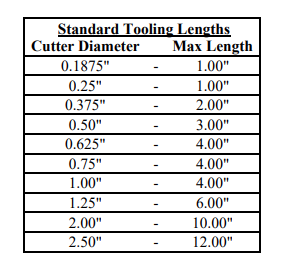
Documentation/Standard Tooling Length.PNG
