MCBailey-CTS/0Library/Documentation/StopBlocks.JPG

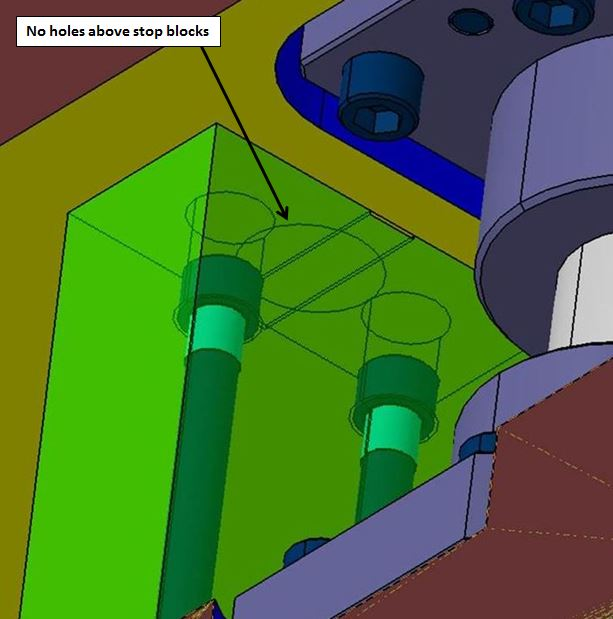
Documentation/StopBlocks.JPG
