MCBailey-CTS/0Library/Documentation/Vertical Trim.PNG

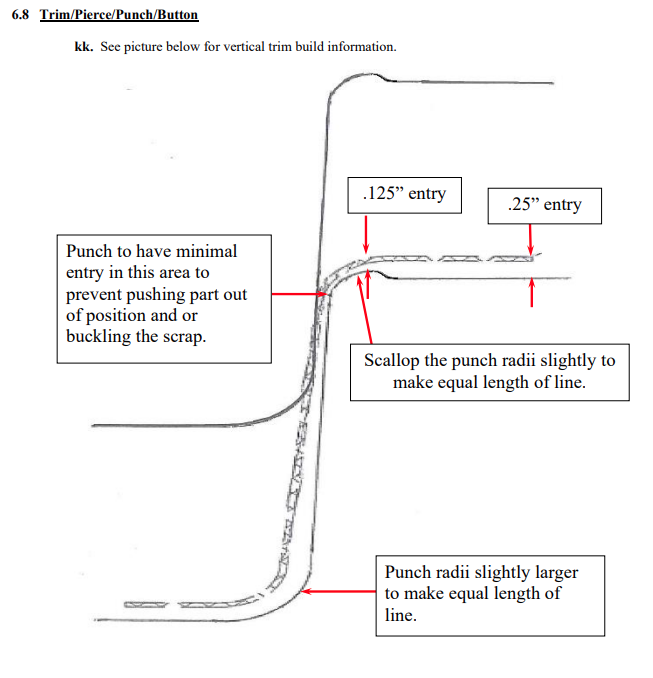
Documentation/Vertical Trim.PNG
