MCBailey-CTS/0Library/Fittings/Dadco/(LEDGEND).PNG

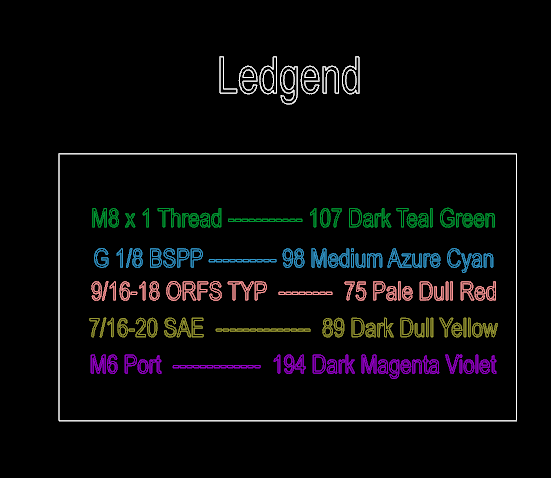
Fittings/Dadco/(LEDGEND).PNG
