MCBailey-CTS/0Library/Fittings/Kaller/MICRO EO24 COMPONETS/MICRO HOSE.JPG

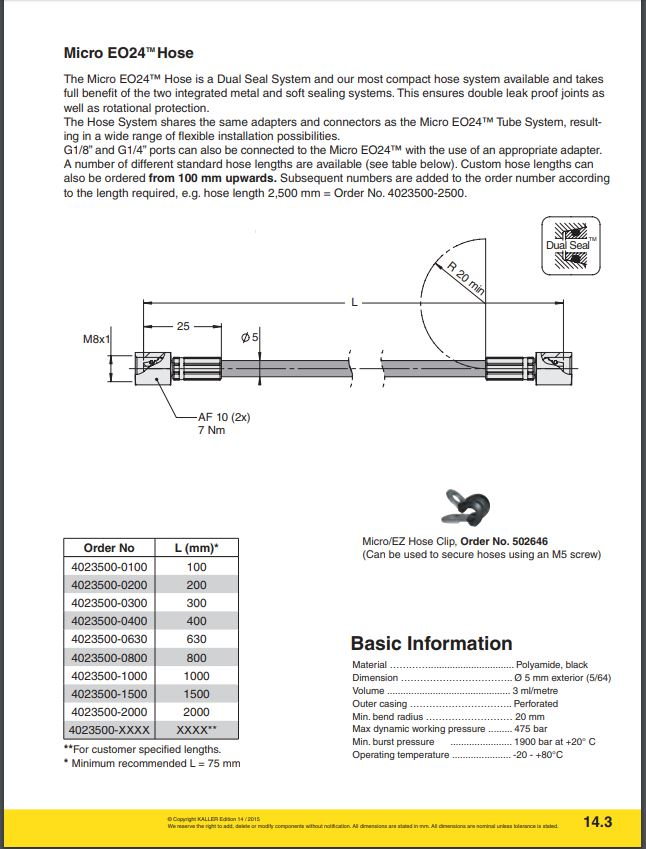
Fittings/Kaller/MICRO EO24 COMPONETS/MICRO HOSE.JPG
