MCBailey-CTS/0Library/LiftLugs/Metric/DoorKnob/door knob size chart.JPG

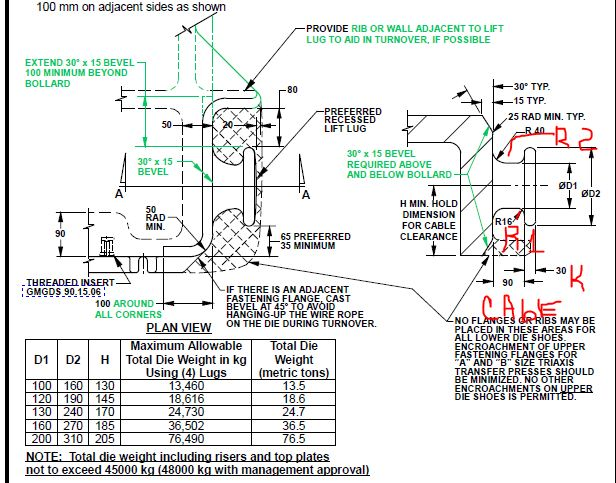
LiftLugs/Metric/DoorKnob/door knob size chart.JPG
