MCBailey-CTS/0Library/LiftLugs/Metric/ScrewIn/Lift Lugs Preview Pic.JPG

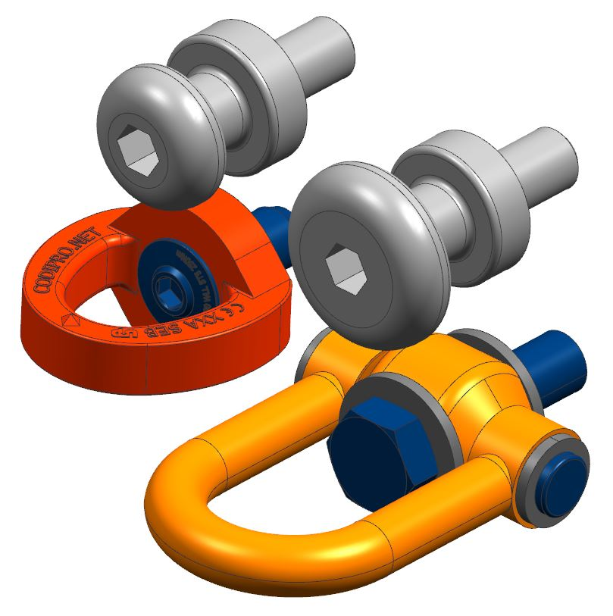
LiftLugs/Metric/ScrewIn/Lift Lugs Preview Pic.JPG
