MCBailey-CTS/0Library/NitroCylinders/Metric/Kaller/Catalog/Dadco C - Kaller Micro.PNG

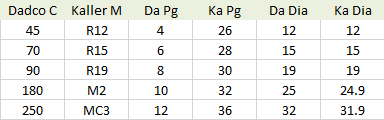
NitroCylinders/Metric/Kaller/Catalog/Dadco C - Kaller Micro.PNG
