MCBailey-CTS/0Library/NitroCylinders/Metric/Kaller/Catalog/Dadco U - Kaller X.PNG

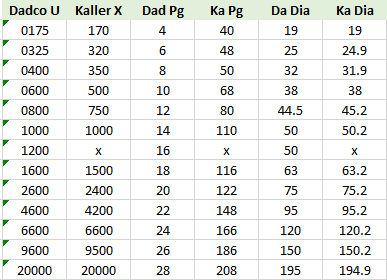
NitroCylinders/Metric/Kaller/Catalog/Dadco U - Kaller X.PNG
