MCBailey-CTS/0Library/NitroCylinders/Metric/Kaller/Catalog/Kaller C-Series Equivelent.PNG

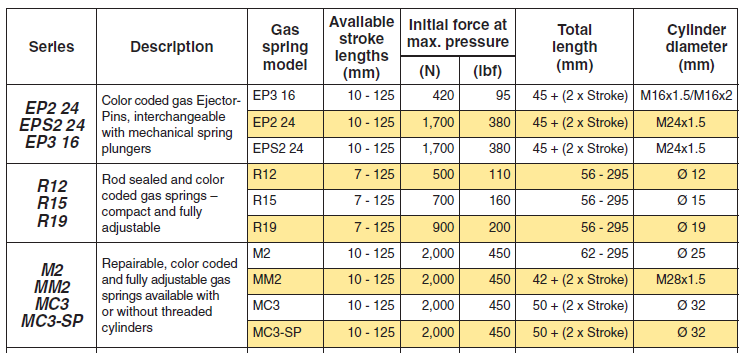
NitroCylinders/Metric/Kaller/Catalog/Kaller C-Series Equivelent.PNG
