MCBailey-CTS/0Library/NitroCylinders/Metric/Kaller/Catalog/Kaller U-Series Equivelent.PNG

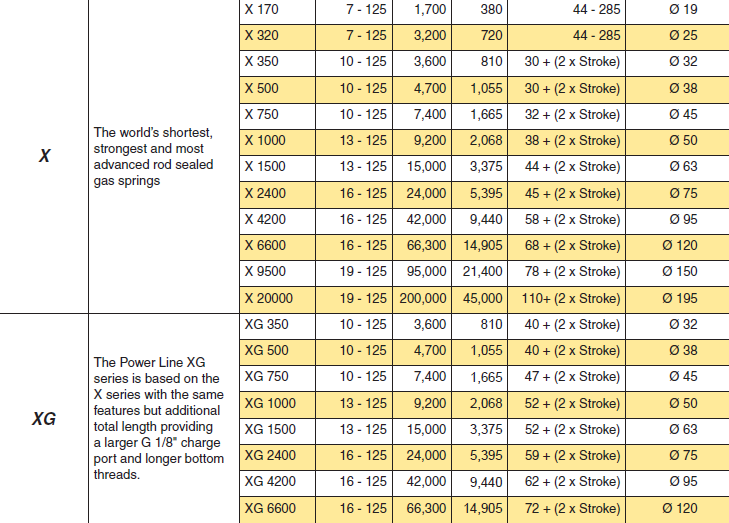
NitroCylinders/Metric/Kaller/Catalog/Kaller U-Series Equivelent.PNG
