MCBailey-CTS/0Library/SeedFiles/ClampFeetDocs/32 - Metalsa E-Town (Press K3 & K4).PNG

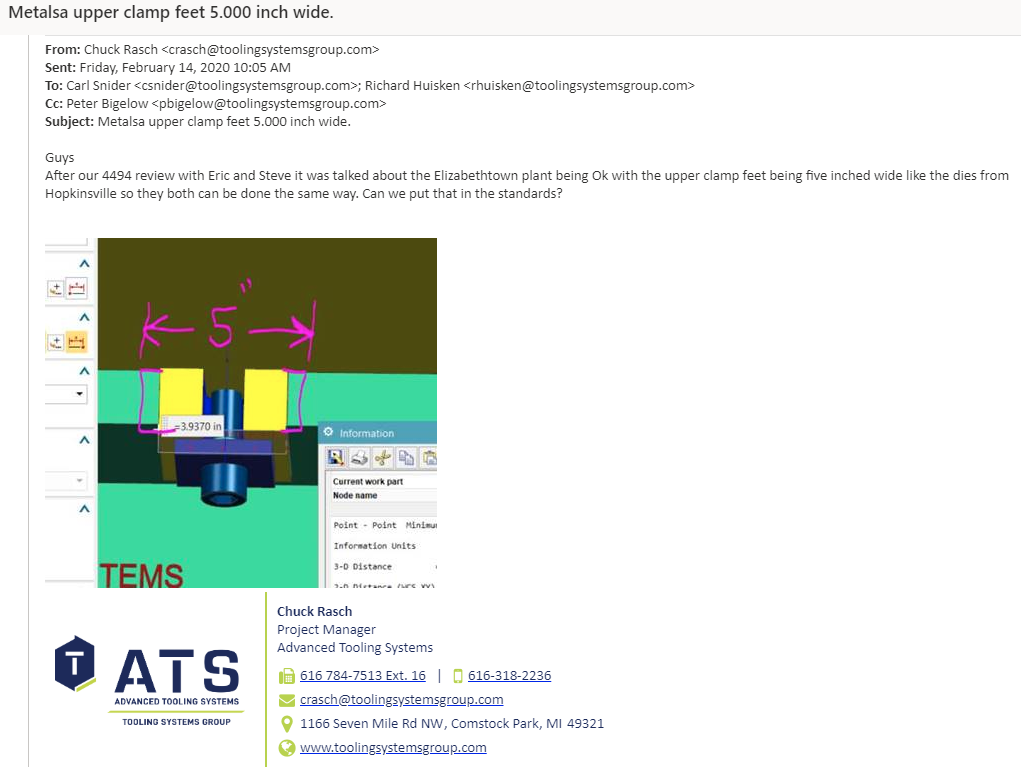
SeedFiles/ClampFeetDocs/32 - Metalsa E-Town (Press K3 & K4).PNG
