MCBailey-CTS/0Library/SeedFiles/ClampFeetDocs/109 - Tower Elkton V-Line.PNG

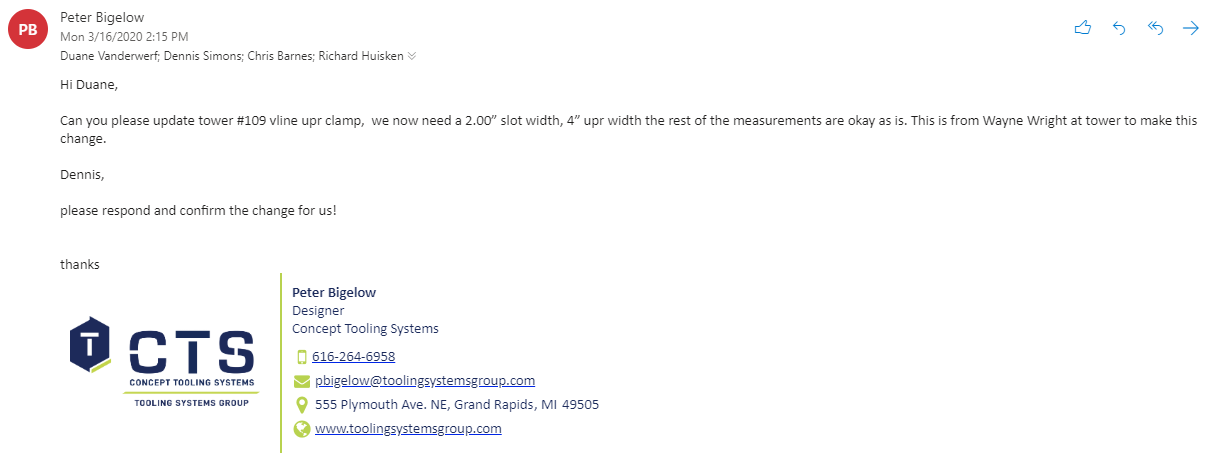
SeedFiles/ClampFeetDocs/109 - Tower Elkton V-Line.PNG
