MCBailey-CTS/0Library/SeedFiles/ClampFeetDocs/184 - Lydall S-550.PNG

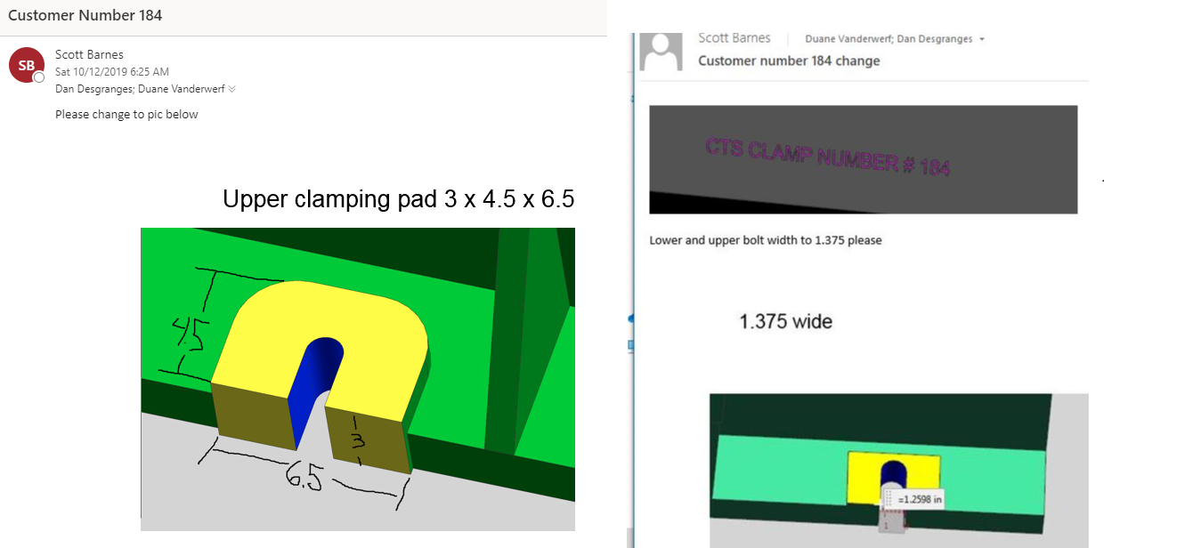
SeedFiles/ClampFeetDocs/184 - Lydall S-550.PNG
