MCBailey-CTS/0Library/SeedFiles/ClampFeetDocs/195 - Bopp and Busch - Kamatsu AP142 Press - 300 Ton.JPG

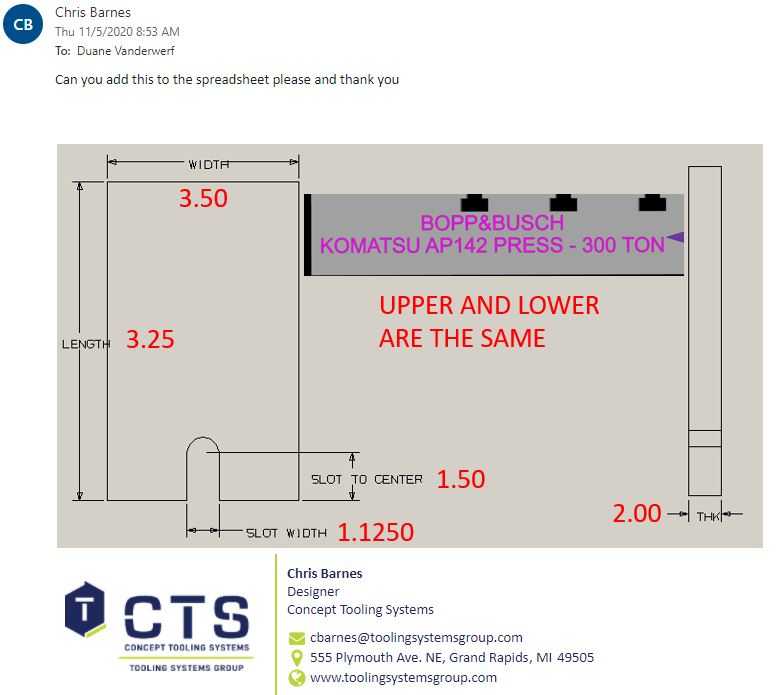
SeedFiles/ClampFeetDocs/195 - Bopp and Busch - Kamatsu AP142 Press - 300 Ton.JPG
