MCBailey-CTS/0Library/SeedFiles/ClampFeetDocs/AGS.JPG

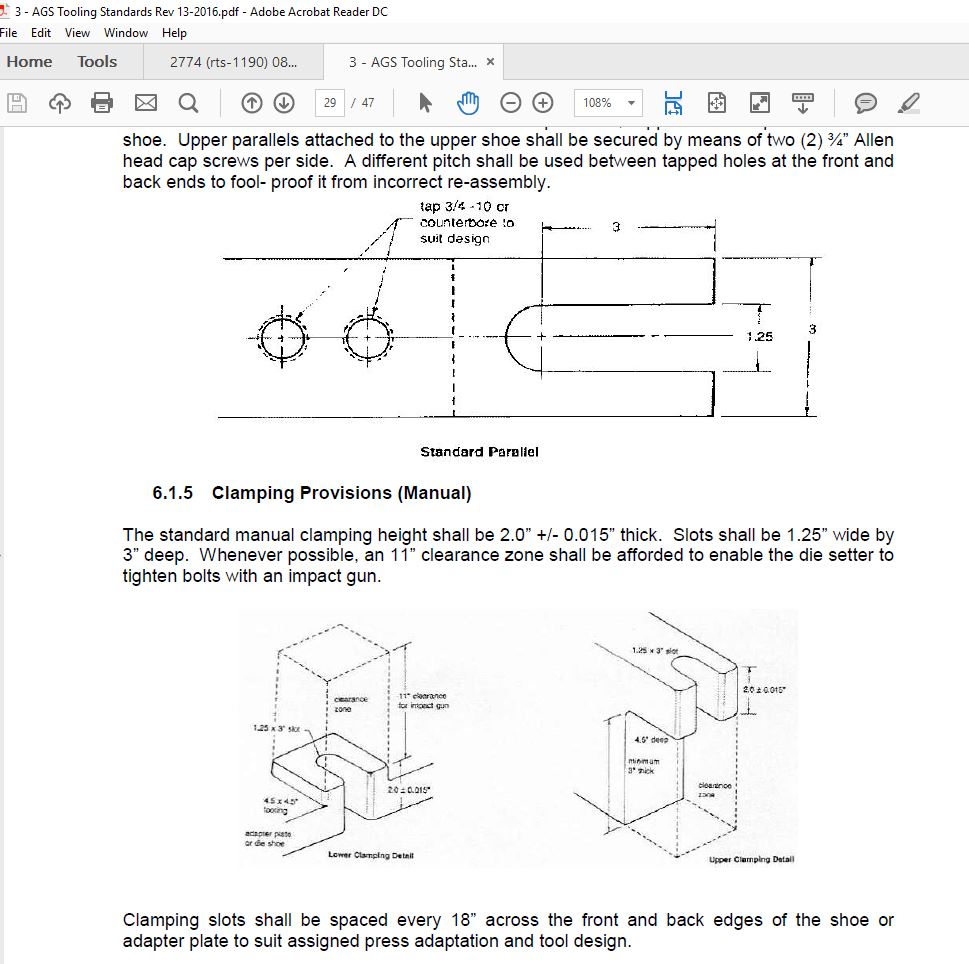
SeedFiles/ClampFeetDocs/AGS.JPG
