MCBailey-CTS/0Library/SeedFiles/ClampFeetDocs/ARJ.JPG

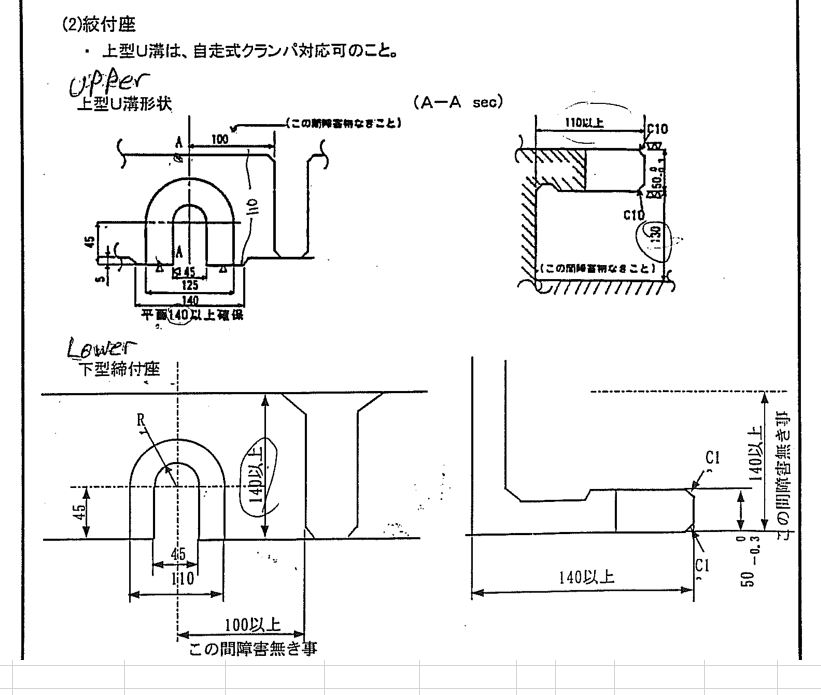
SeedFiles/ClampFeetDocs/ARJ.JPG
