MCBailey-CTS/0Library/SeedFiles/ClampFeetDocs/Camaco-Amvian.JPG

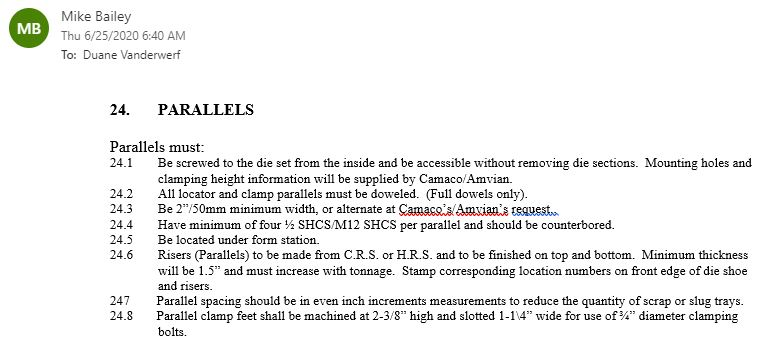
SeedFiles/ClampFeetDocs/Camaco-Amvian.JPG
