MCBailey-CTS/0Library/SeedFiles/ClampFeetDocs/F-N-G Globel Standards REV5 1 JULY 19.PNG

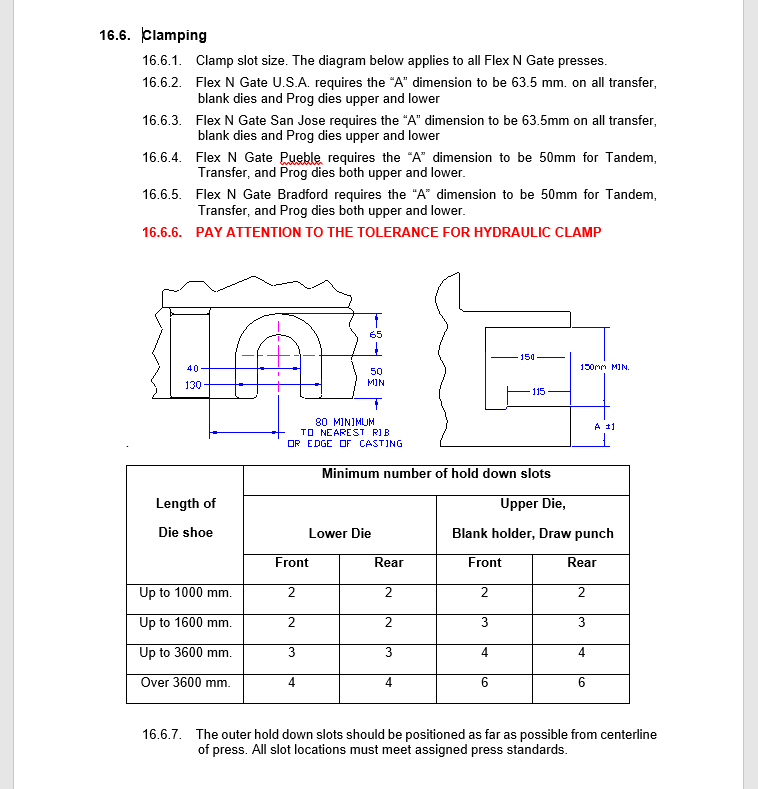
SeedFiles/ClampFeetDocs/F-N-G Globel Standards REV5 1 JULY 19.PNG
