MCBailey-CTS/0Library/SeedFiles/ClampFeetDocs/Flex N Gate Detroit Schuler 2750 ton.JPG

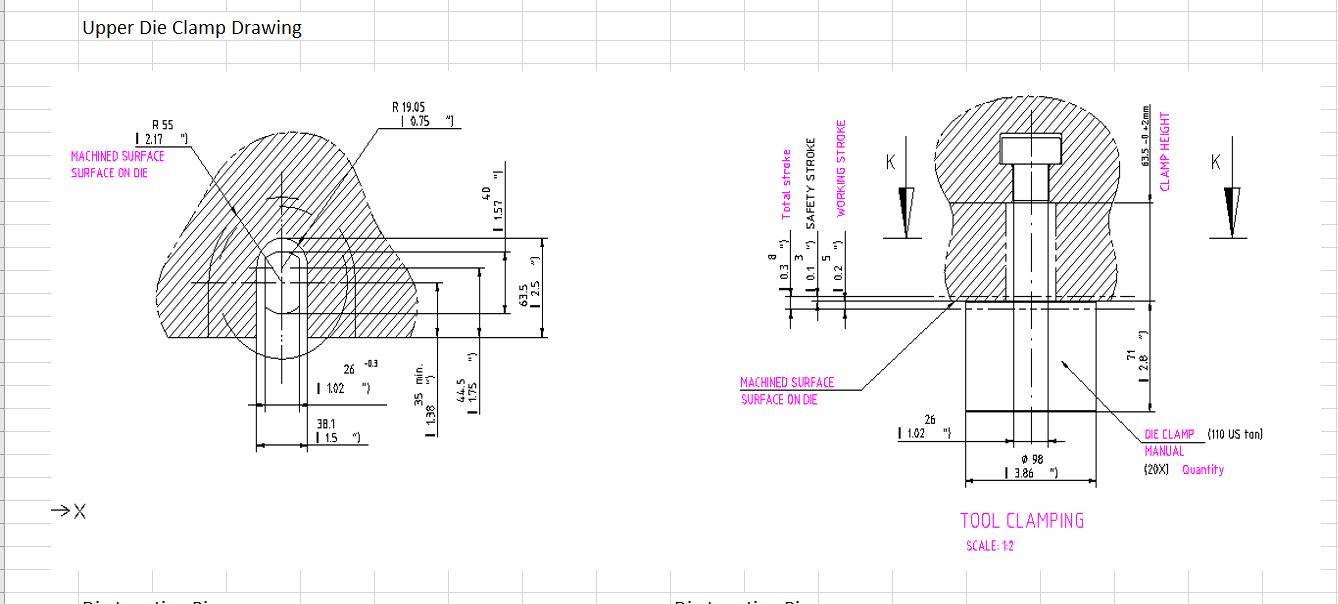
SeedFiles/ClampFeetDocs/Flex N Gate Detroit Schuler 2750 ton.JPG
