MCBailey-CTS/0Library/SeedFiles/ClampFeetDocs/Flex N Gate Howard Plant.PNG

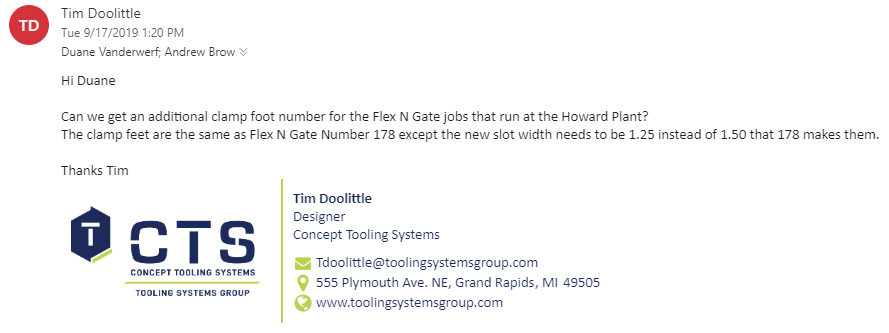
SeedFiles/ClampFeetDocs/Flex N Gate Howard Plant.PNG
