MCBailey-CTS/0Library/SeedFiles/ClampFeetDocs/GA PRESS.JPG

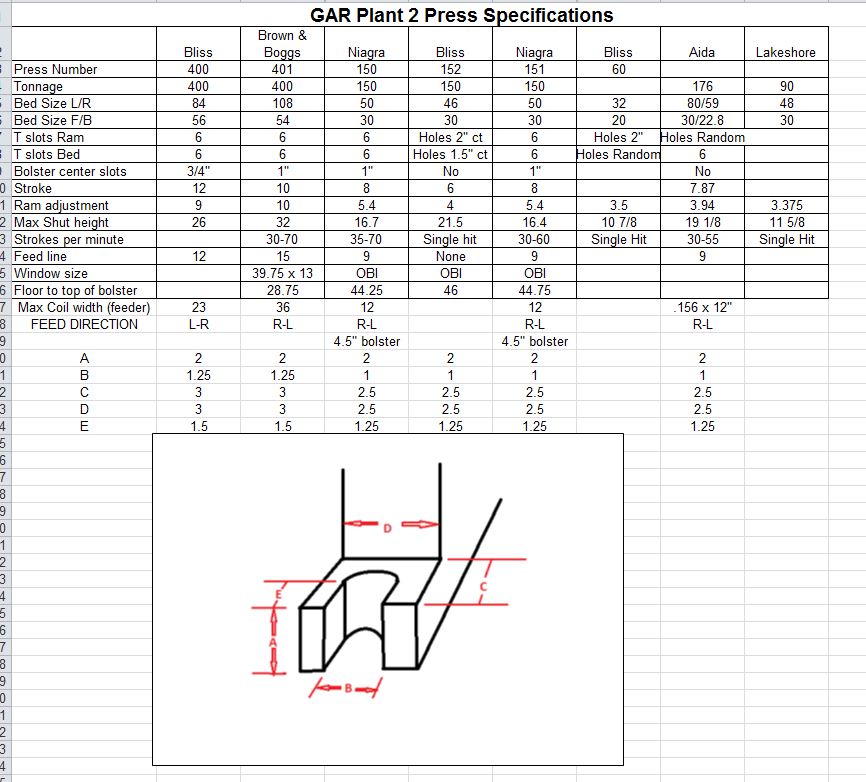
SeedFiles/ClampFeetDocs/GA PRESS.JPG
