MCBailey-CTS/0Library/SeedFiles/ClampFeetDocs/GE Kentucky.PNG

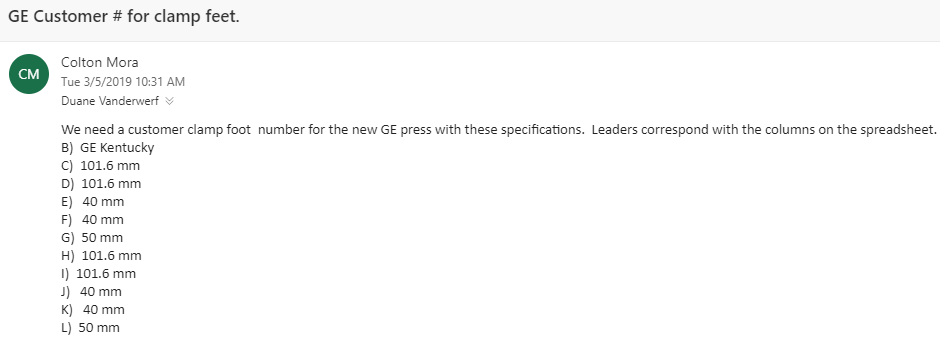
SeedFiles/ClampFeetDocs/GE Kentucky.PNG
