MCBailey-CTS/0Library/SeedFiles/ClampFeetDocs/GEA_From_RFQ_Die_STD..JPG

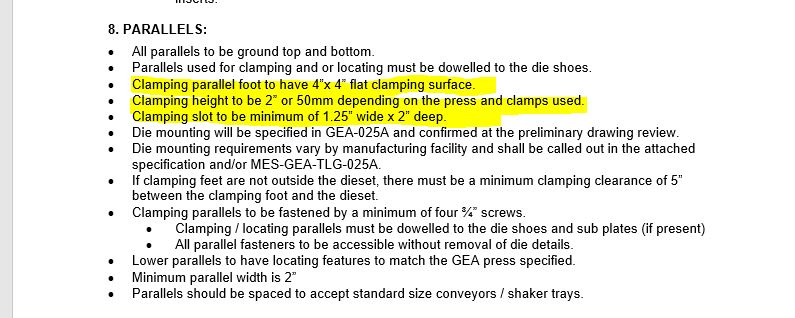
SeedFiles/ClampFeetDocs/GEA_From_RFQ_Die_STD..JPG
