MCBailey-CTS/0Library/SeedFiles/ClampFeetDocs/GestampChattenooga2ClampSpecs.JPG

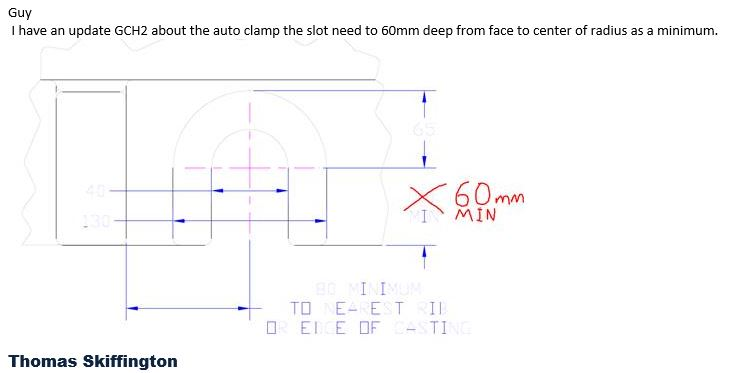
SeedFiles/ClampFeetDocs/GestampChattenooga2ClampSpecs.JPG
