MCBailey-CTS/0Library/SeedFiles/ClampFeetDocs/Kirchhoff Queretaro Presses202thru206-208-222.JPG

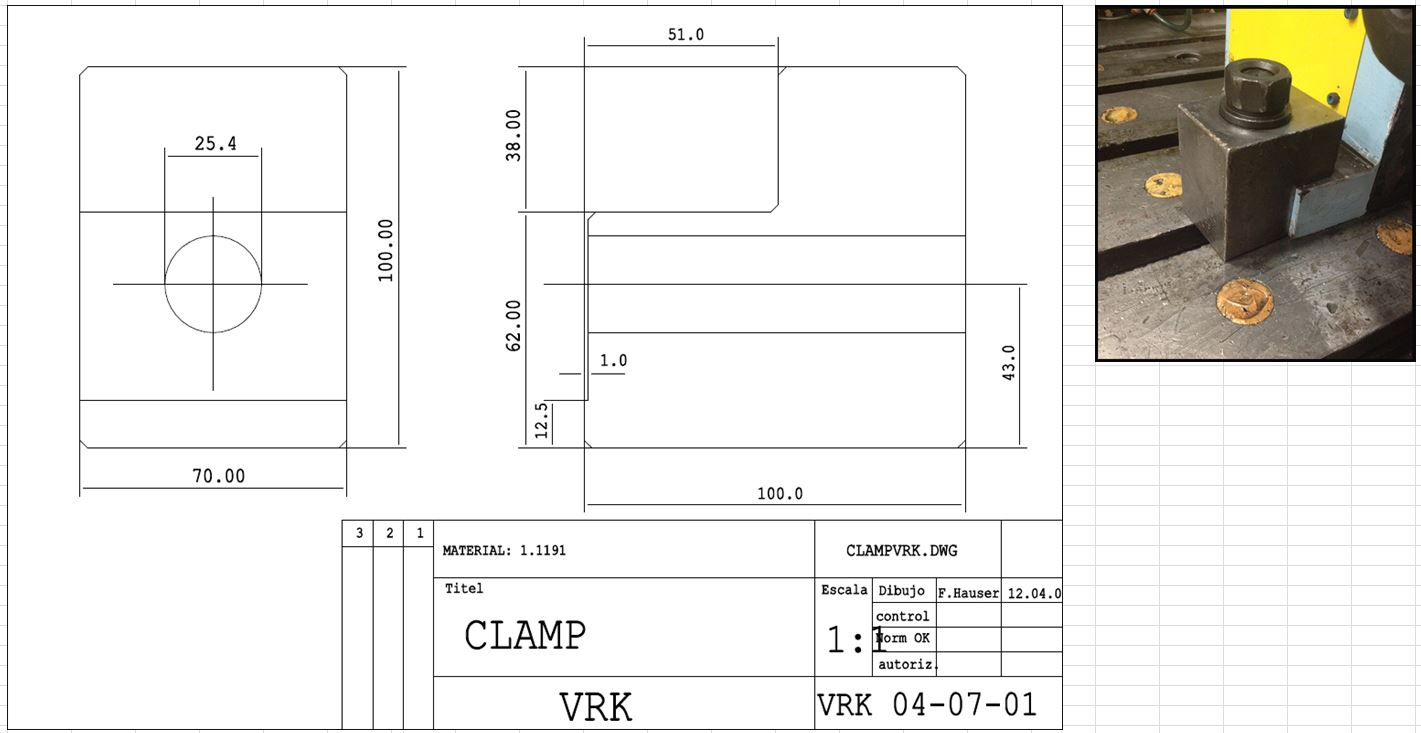
SeedFiles/ClampFeetDocs/Kirchhoff Queretaro Presses202thru206-208-222.JPG
