MCBailey-CTS/0Library/SeedFiles/ClampFeetDocs/Kirchhoff Queretaro Presses New550.JPG

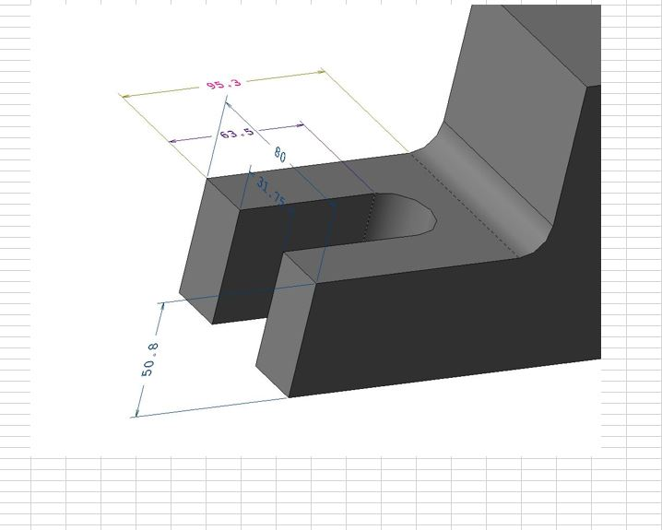
SeedFiles/ClampFeetDocs/Kirchhoff Queretaro Presses New550.JPG
