MCBailey-CTS/0Library/SeedFiles/ClampFeetDocs/L & W (Plant 2 - 1200 Ton - Verson T1).PNG

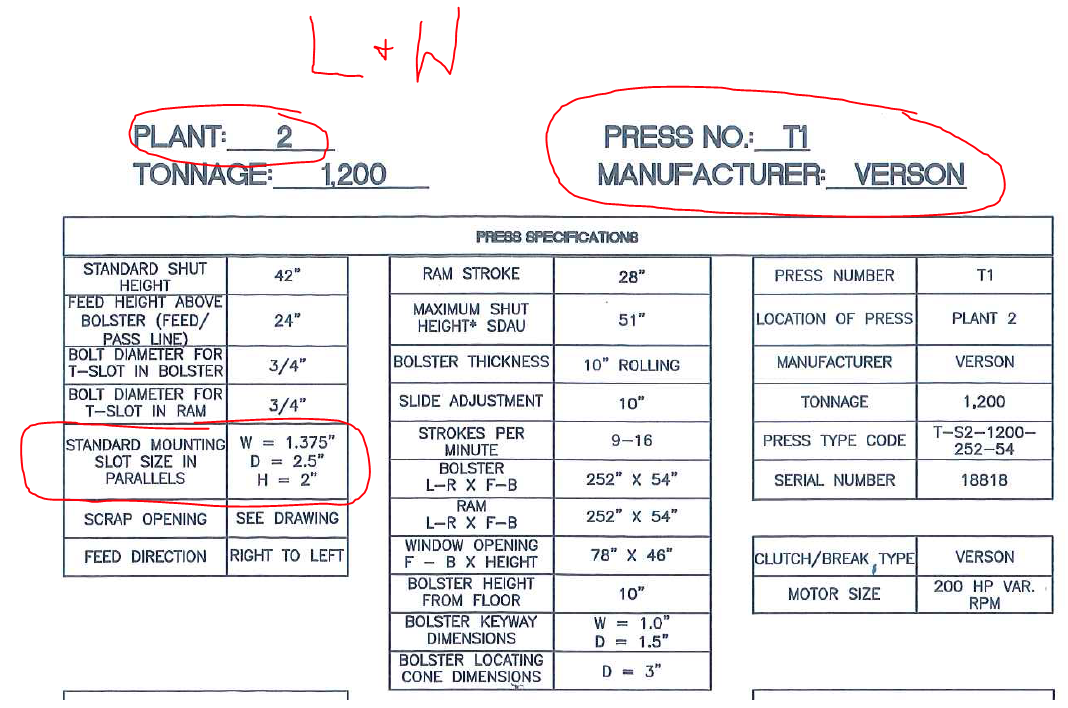
SeedFiles/ClampFeetDocs/L & W (Plant 2 - 1200 Ton - Verson T1).PNG
