MCBailey-CTS/0Library/SeedFiles/ClampFeetDocs/L&W_Plant2_T3_1700Ton.PNG

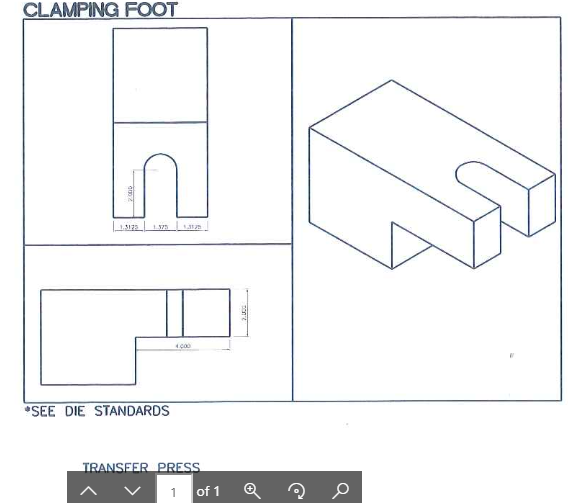
SeedFiles/ClampFeetDocs/L&W_Plant2_T3_1700Ton.PNG
