MCBailey-CTS/0Library/SeedFiles/ClampFeetDocs/McGREGOR.JPG

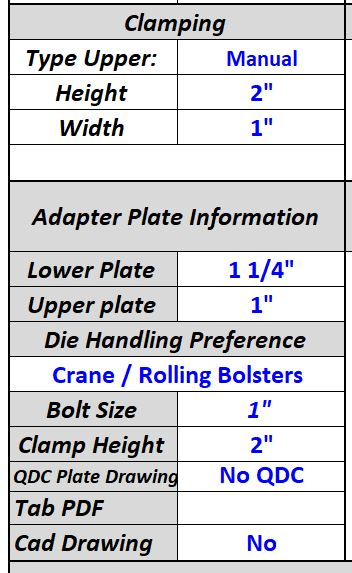
SeedFiles/ClampFeetDocs/McGREGOR.JPG
