MCBailey-CTS/0Library/SeedFiles/ClampFeetDocs/Metalsa Apodaca WW & CO Press Clamp Dims.jpeg

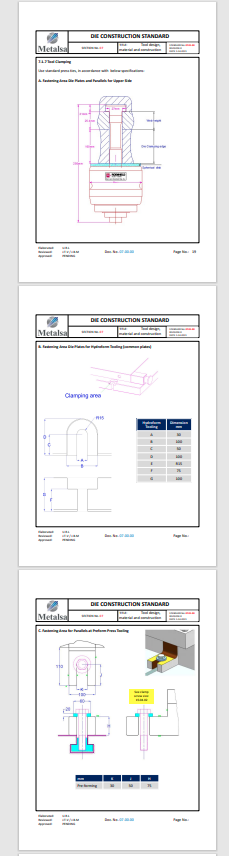
SeedFiles/ClampFeetDocs/Metalsa Apodaca WW & CO Press Clamp Dims.jpeg
