MCBailey-CTS/0Library/SeedFiles/ClampFeetDocs/Metalsa_Hopkinsville_rev52.JPG

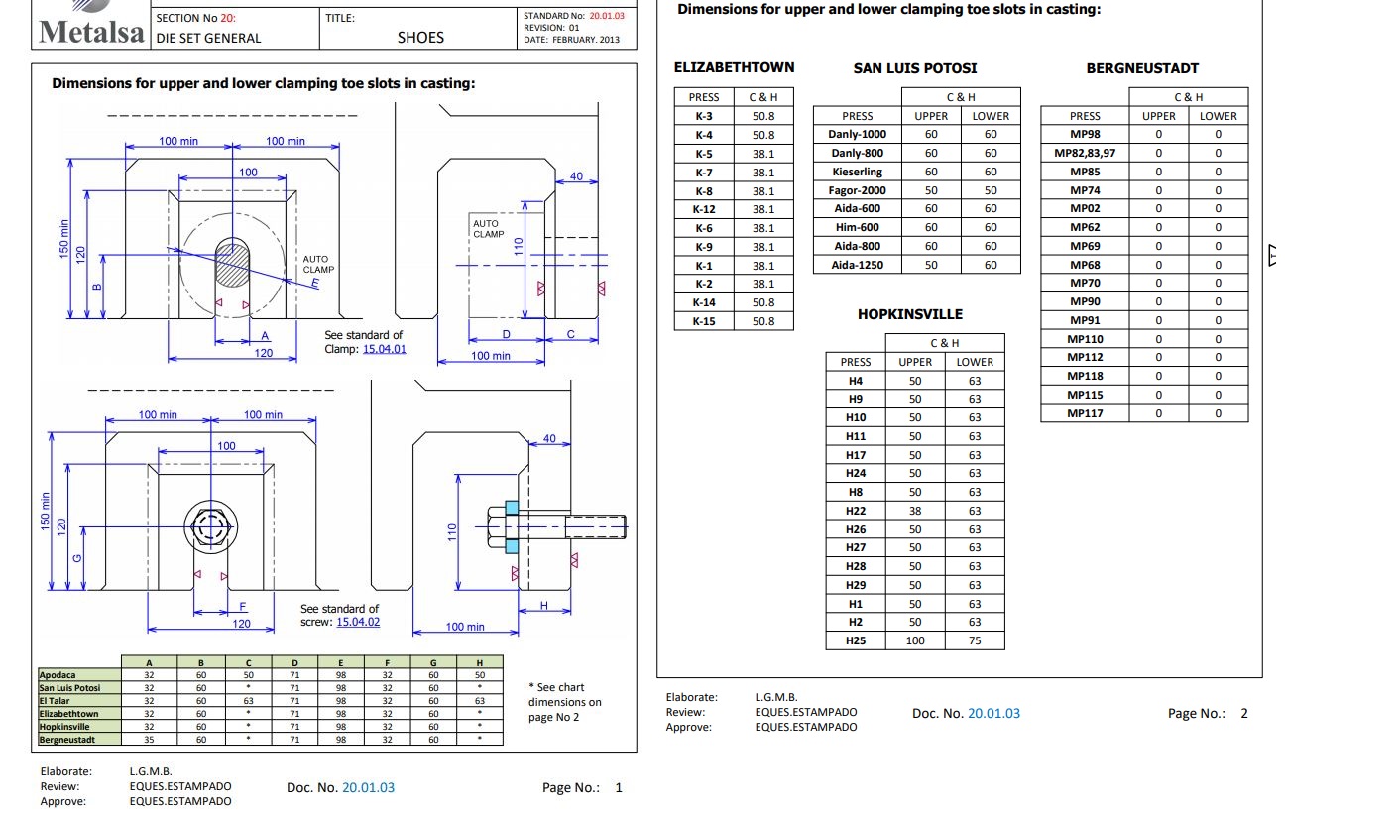
SeedFiles/ClampFeetDocs/Metalsa_Hopkinsville_rev52.JPG
