MCBailey-CTS/0Library/SeedFiles/ClampFeetDocs/Midway_Generic_Clamp_Size.JPG

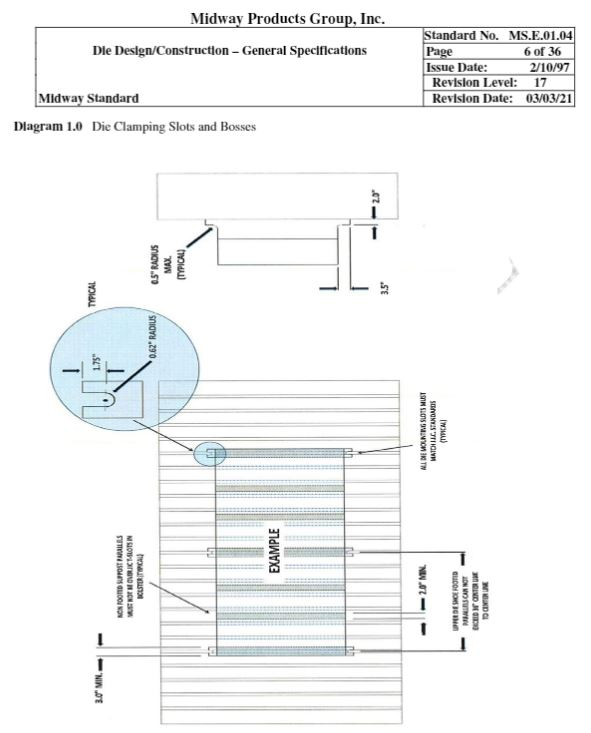
SeedFiles/ClampFeetDocs/Midway_Generic_Clamp_Size.JPG
