MCBailey-CTS/0Library/SeedFiles/ClampFeetDocs/Midway_PPI_T1_2200Ton.JPG

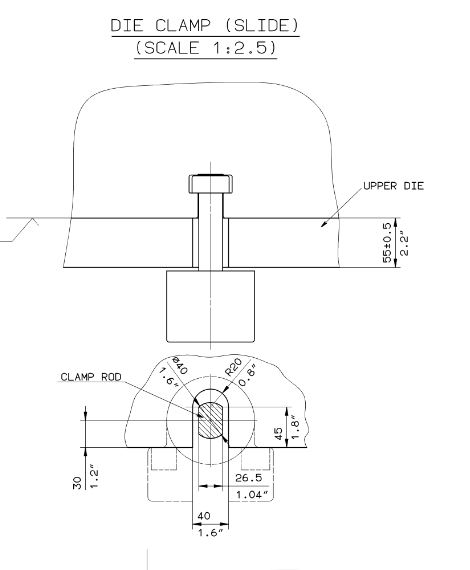
SeedFiles/ClampFeetDocs/Midway_PPI_T1_2200Ton.JPG
