MCBailey-CTS/0Library/SeedFiles/ClampFeetDocs/MPI-Page_33_rev02JPG.JPG

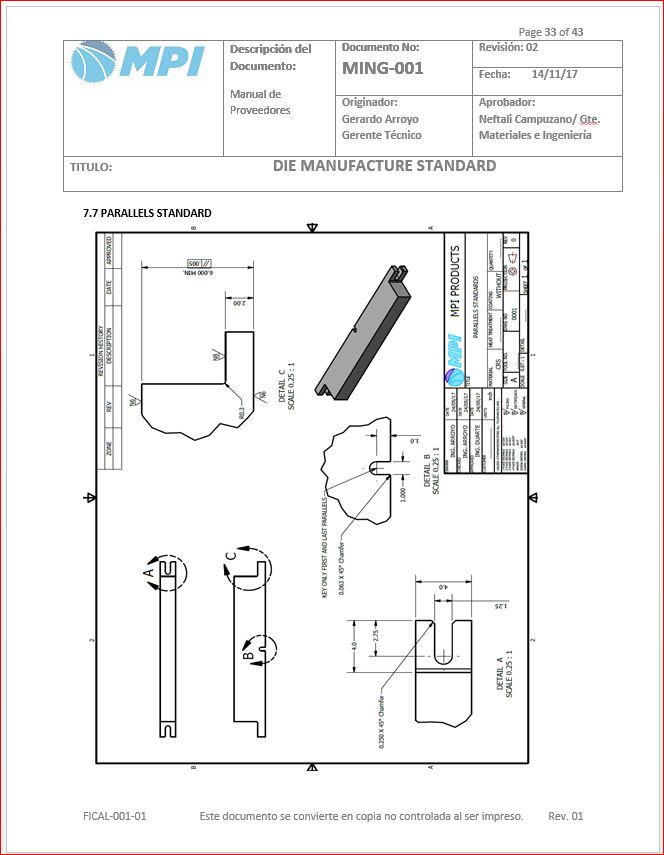
SeedFiles/ClampFeetDocs/MPI-Page_33_rev02JPG.JPG
