MCBailey-CTS/0Library/SeedFiles/ClampFeetDocs/Multimatic Toledo Press 101.JPG

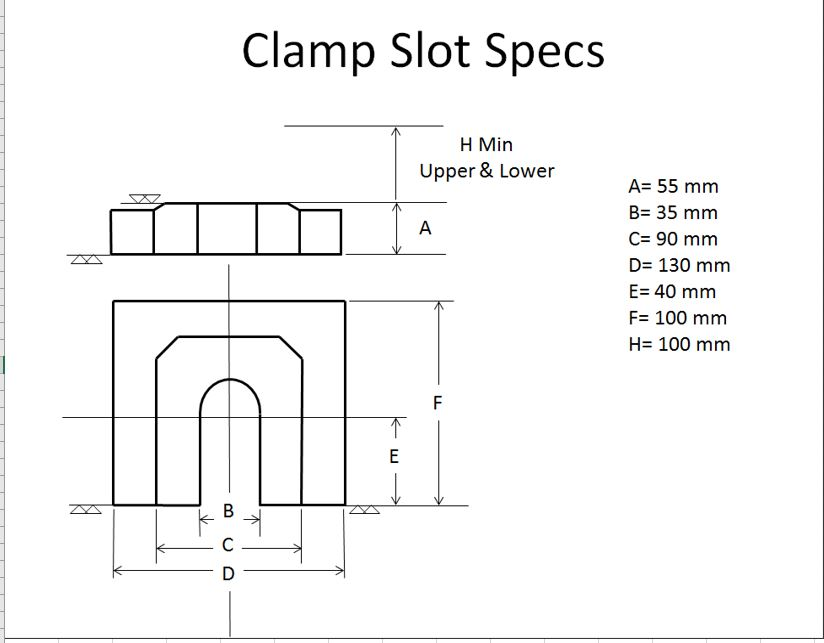
SeedFiles/ClampFeetDocs/Multimatic Toledo Press 101.JPG
