MCBailey-CTS/0Library/SeedFiles/ClampFeetDocs/Multimatic_Page13_14.JPG

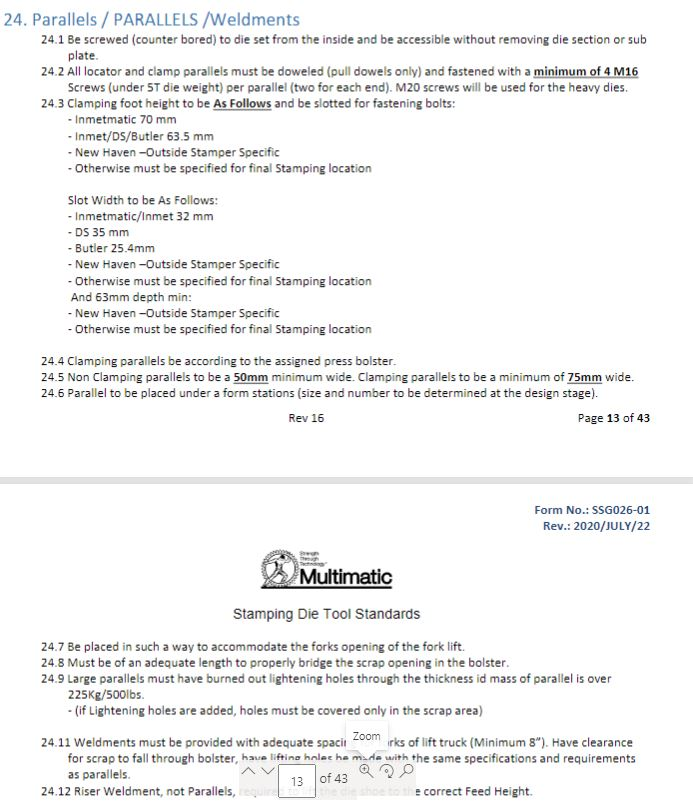
SeedFiles/ClampFeetDocs/Multimatic_Page13_14.JPG
