MCBailey-CTS/0Library/SeedFiles/ClampFeetDocs/ODM P10 1000Ton.JPG

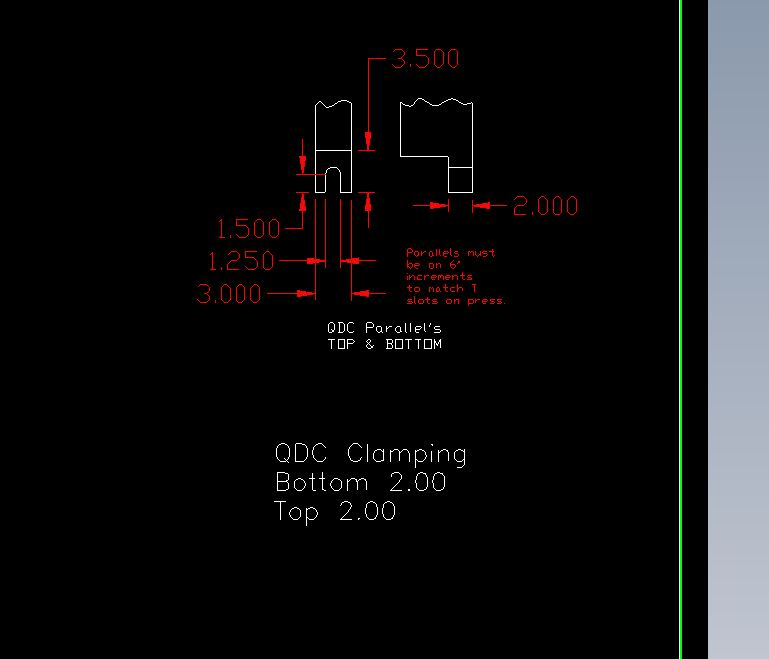
SeedFiles/ClampFeetDocs/ODM P10 1000Ton.JPG
