MCBailey-CTS/0Library/SeedFiles/ClampFeetDocs/Otscon 300 Ton.PNG

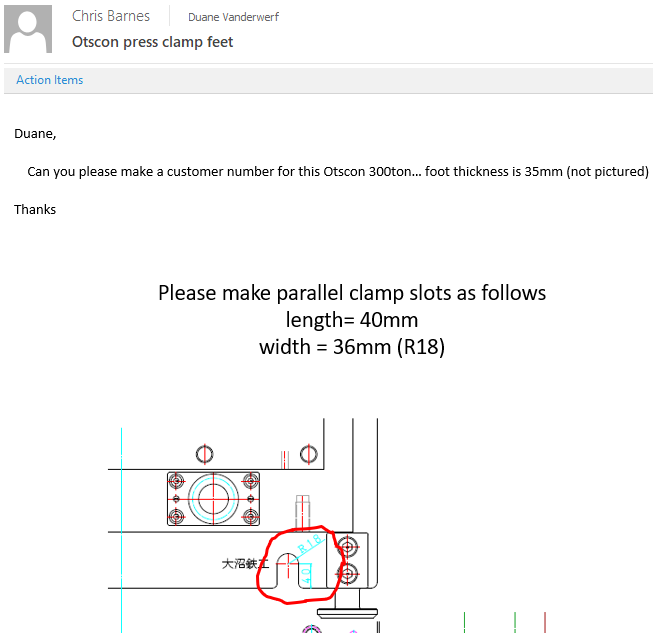
SeedFiles/ClampFeetDocs/Otscon 300 Ton.PNG
