MCBailey-CTS/0Library/SeedFiles/ClampFeetDocs/Rivian - C-Line.JPG

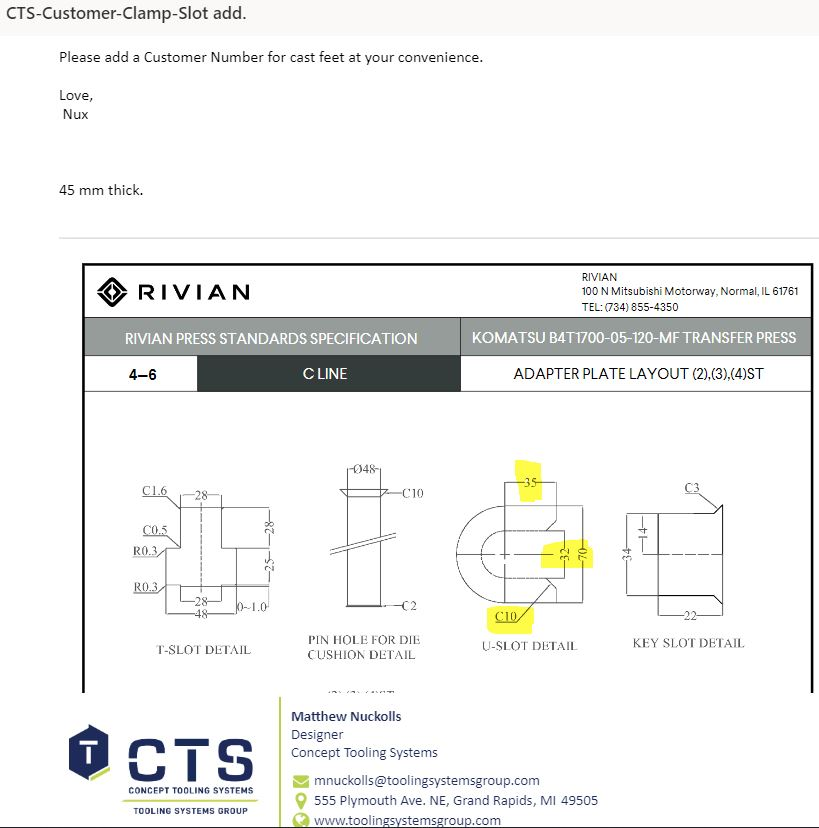
SeedFiles/ClampFeetDocs/Rivian - C-Line.JPG
