MCBailey-CTS/0Library/SeedFiles/ClampFeetDocs/Schaller Group Presses.JPG

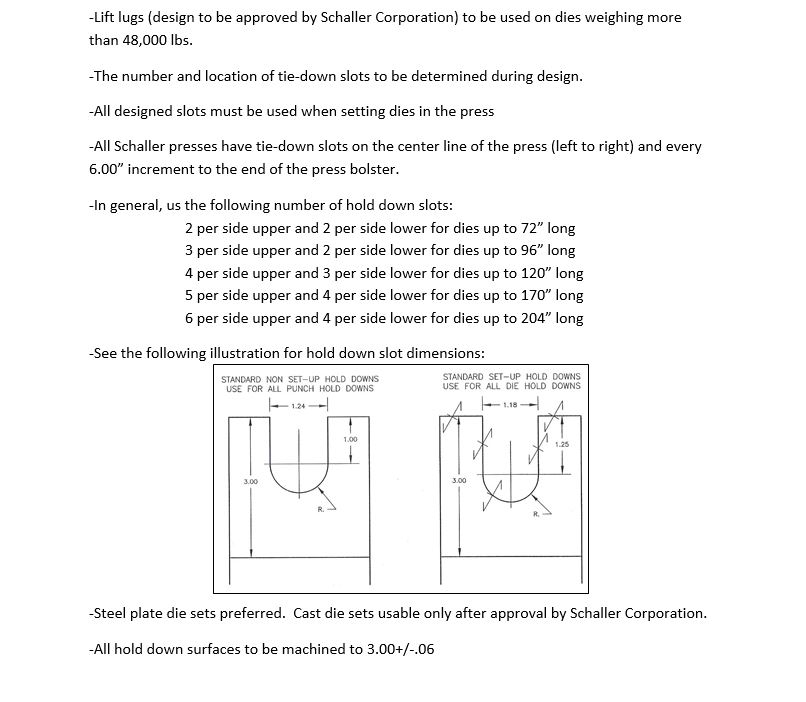
SeedFiles/ClampFeetDocs/Schaller Group Presses.JPG
