MCBailey-CTS/0Library/SeedFiles/ClampFeetDocs/ShapeLwrClampFoot.PNG

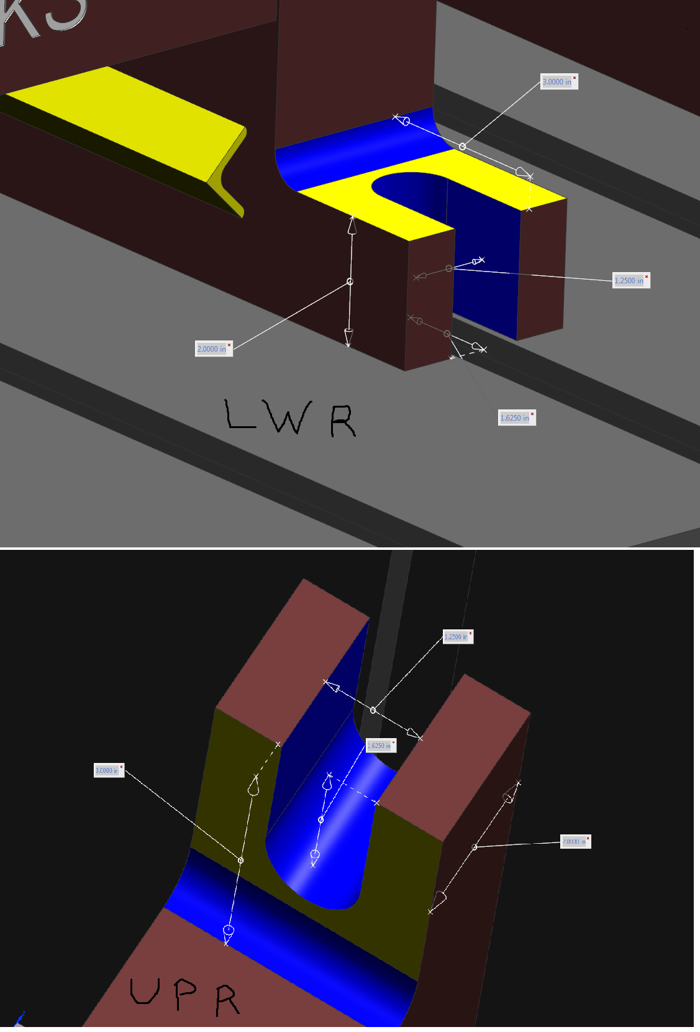
SeedFiles/ClampFeetDocs/ShapeLwrClampFoot.PNG
