MCBailey-CTS/0Library/SeedFiles/ClampFeetDocs/ShapeUprClampFoot.PNG

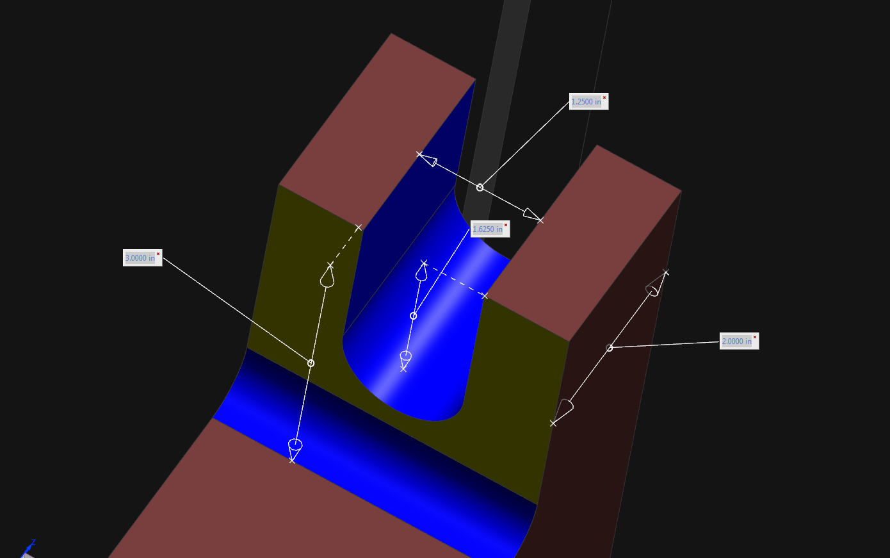
SeedFiles/ClampFeetDocs/ShapeUprClampFoot.PNG
