MCBailey-CTS/0Library/SeedFiles/ClampFeetDocs/Thai Summit South Africa 250Ton Press Upper.JPG

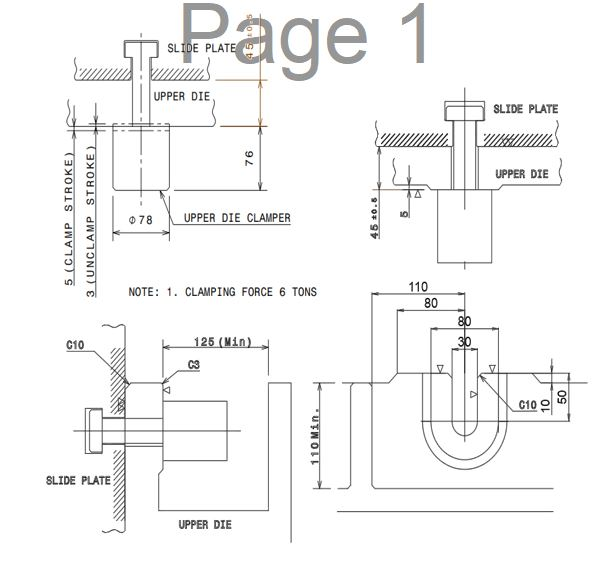
SeedFiles/ClampFeetDocs/Thai Summit South Africa 250Ton Press Upper.JPG
