MCBailey-CTS/0Library/SeedFiles/ClampFeetDocs/Thai Summit South Africa 250Ton Prress.JPG

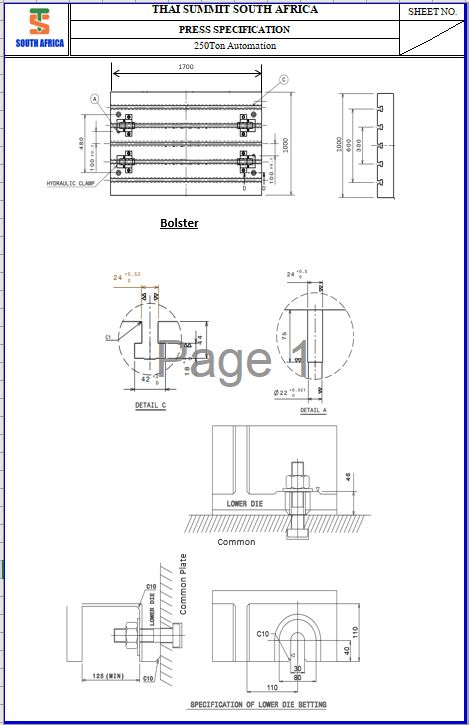
SeedFiles/ClampFeetDocs/Thai Summit South Africa 250Ton Prress.JPG
