MCBailey-CTS/0Library/SeedFiles/ClampFeetDocs/Thai Summit South Africa 300, 600, 1200, 2500Ton Press Upper.JPG

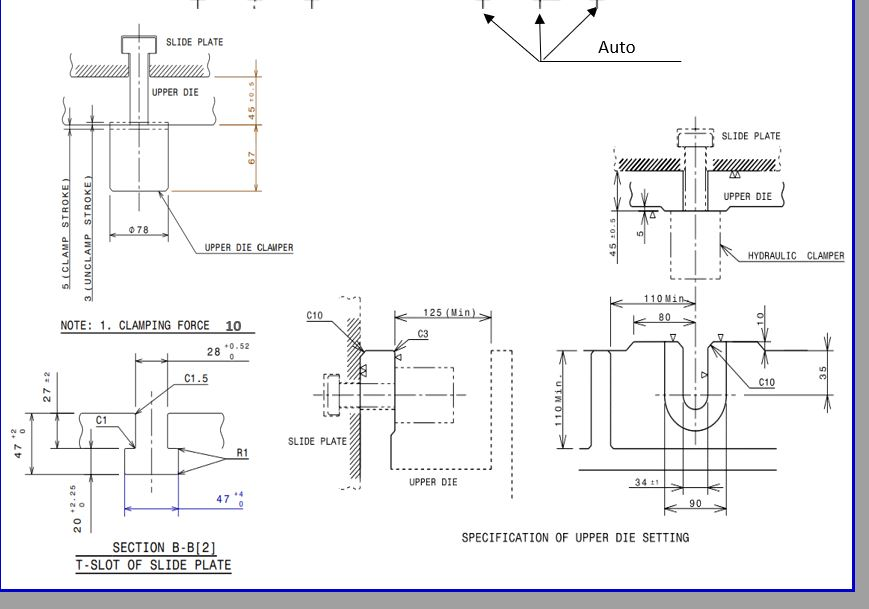
SeedFiles/ClampFeetDocs/Thai Summit South Africa 300, 600, 1200, 2500Ton Press Upper.JPG
