MCBailey-CTS/0Library/SeedFiles/ClampFeetDocs/Tower Auburn 1000 Ton.JPG

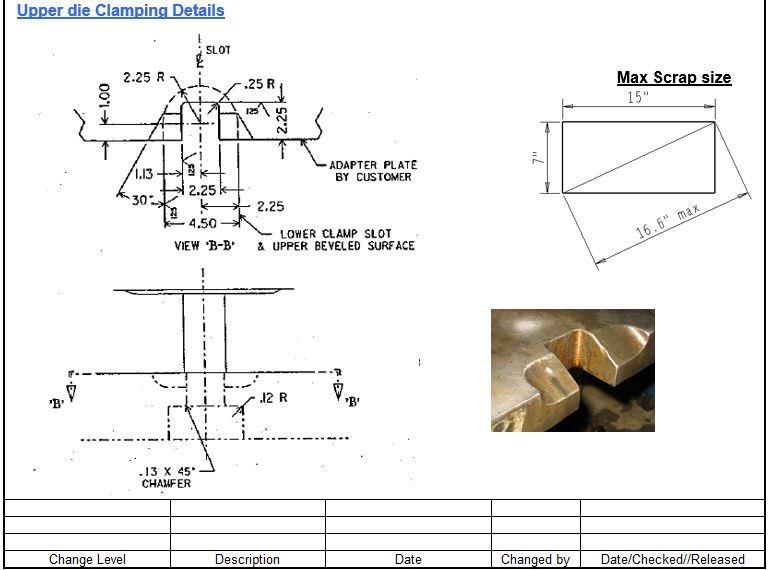
SeedFiles/ClampFeetDocs/Tower Auburn 1000 Ton.JPG
