MCBailey-CTS/0Library/SeedFiles/ClampFeetDocs/Tower Bardstown Press 9.JPG

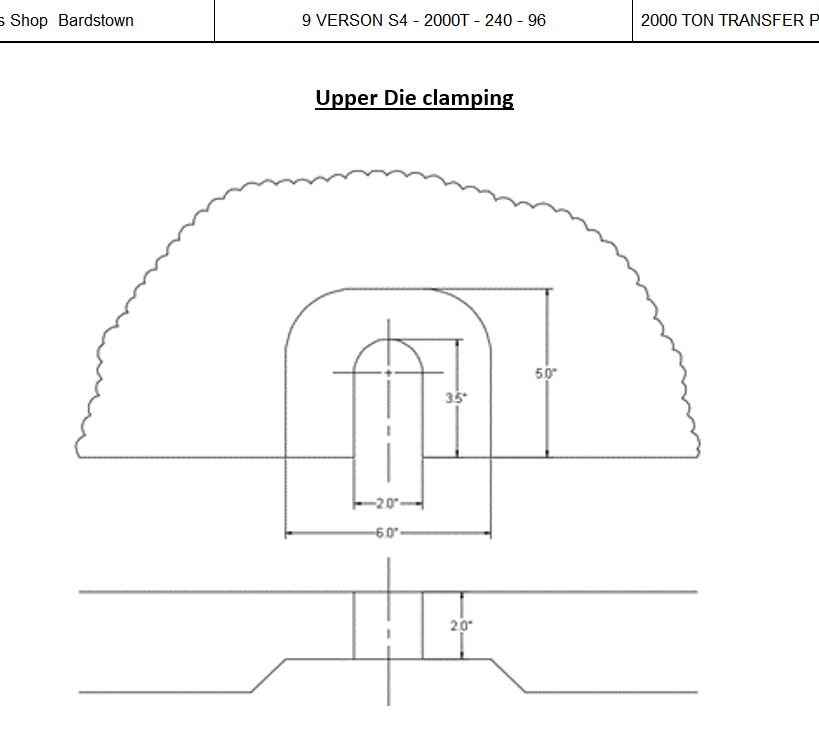
SeedFiles/ClampFeetDocs/Tower Bardstown Press 9.JPG
