MCBailey-CTS/0Library/SeedFiles/ClampFeetDocs/Tower Clinton A line press A1.JPG

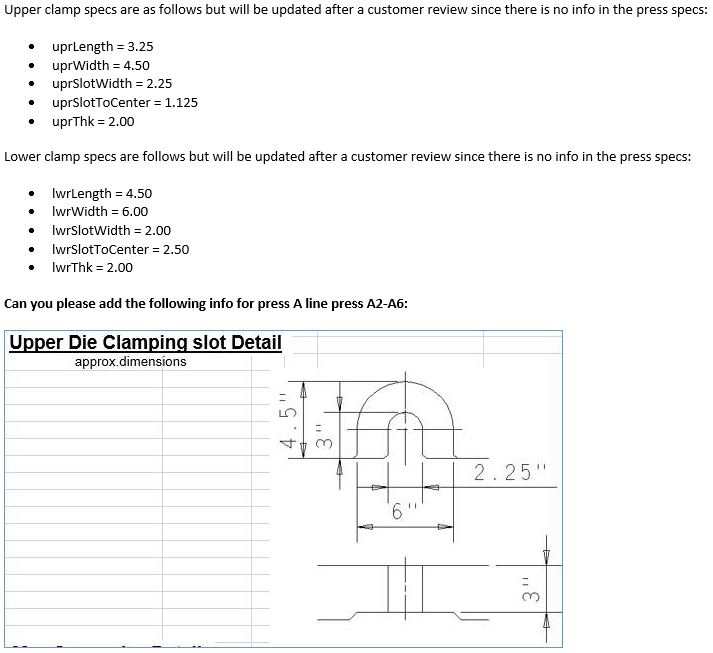
SeedFiles/ClampFeetDocs/Tower Clinton A line press A1.JPG
