MCBailey-CTS/0Library/SeedFiles/ClampFeetDocs/Tower Elkton W-Line.JPG

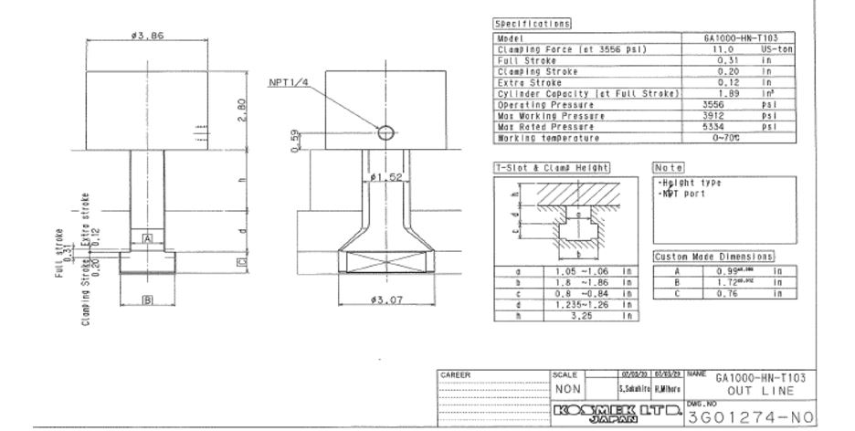
SeedFiles/ClampFeetDocs/Tower Elkton W-Line.JPG
