MCBailey-CTS/0Library/SeedFiles/ClampFeetDocs/Walker Corp Clamp Info.JPG

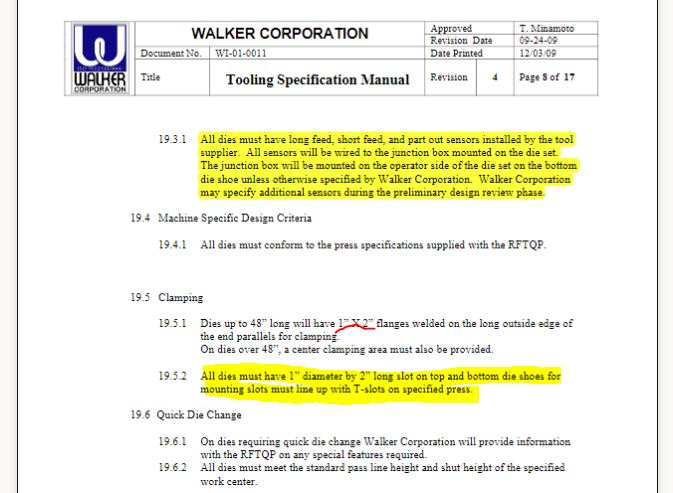
SeedFiles/ClampFeetDocs/Walker Corp Clamp Info.JPG
