MCBailey-CTS/0Library/TriggerPitchStop/Metric/Martinrea/Martinrea Corporate Die Eng Std Pitch Notches.JPG

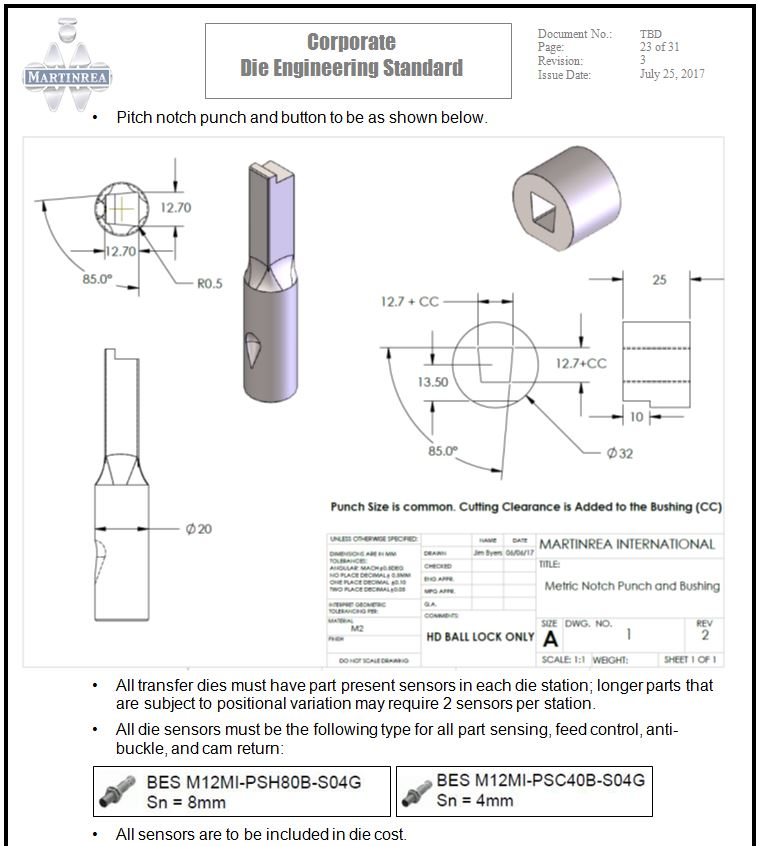
TriggerPitchStop/Metric/Martinrea/Martinrea Corporate Die Eng Std Pitch Notches.JPG
