MCBailey-CTS/0Library/0Customer/UGS/Sample Design/2103-000_Stock List.xlsx

 |  | Ultimate Gaging Systems
 |  | A Tooling Systems Group Member
 |  | 555 PLYMOUTH AVENUE NE, Grand Rapids, MI 49505 |  |  |  |  | SFT Ref #
 |  |  |  |  | Hold
 |  |  |  |  | Change/Re-order
 |  |  |  |  | Already Ordered
http://www.toolingsystemsgroup.com/ |  |  |  |  | Additional Detail
 |  |  |  |  | Not Ordered
 |  |  |  |  | Customer Specified Item
 |  |  | Date: | 2018-04-24
 |  |  | Job No. | 2103-000
 |  |  | CUSTOMER: | ETS
DETAIL | REQ'D | DESCRIPTION | MATERIAL | VENDOR | RAW STEEL PO # | MACHINE COMPLETE | NOTES / FINISH MACHINE PO# | E.C. # / DELIVERY DATE FOR RAW STEEL | DELIVERY DATE FOR MACHINE COMPLETE | COST CODE | OPTIONAL INFO
100 | 1 | 25.00 X 27.00 X 1.00 | CT & J Aluminum | Clinton
101 | 4 | Plastic Handle JCL-1675 | PUR | ESS
102 | 4 | DESTACO CLAMP # TC-2002-U | PUR | ESS
103 | 4 | 1/2 ID X 5/8 OD X 3/4 L | PUR | United
104 | 1 | 200.00 X 200.00 X 150.00 - NBF-32018 | PUR | MouserElectronics
105 | 1 | 9.00 X 6.00 X 7.50 | 4140 PRE-HARD | Goodmet
106 | 1 | 7.75 X 7.50 X 6.50 | 4140 PRE-HARD | Goodmet
107 | 1 | Shaft Collar #6435K130 | PUR | McMaster
108 | 4 | Shoulder Screw 91259A544 | PUR | McMaster
109 | 1 | DIA 9/16" HSS DB | PUR | United
110 | 2 | 1.500 X 1.500 X 2.25 | 6061 ALUM | Clinton
111 | 2 | .250 X .500 X 2.750 | CRS | Goodmet
112 | 2 | 2.0000 X 1.500 X 1.500 | 6061 ALUM | Clinton
113 | 2 | .250 X .500 X 2.750 | CRS | Goodmet
114 | 4 | Bushing P-20-8-0.1563ID | PUR | United
115 | 1 | Bushing P-40-12-0.4063ID | PUR | United
116 | 4 | Bushing P-40-8-0.5000ID | PUR | United
120 | 1 | 8.50(+.00/-.02)MM X 11.50(+.02/-.00)MM Straight Feeler | PUR | United
121 | 1 | 5.50(+.00/-.02)MM X 6.50(+.02/-.00)MM Ball Feeler | PUR | United
122 | 1 | 0.125 X 0.375 X 0.500 | O-1 GS | UGS Stock
123 | 1 | 1.000 X 1.250 X 4.250 | Aluminum | CLINTON
131 | 1 | 5/8" HSS DB | PUR | United
136 | 1 | 1.250 X 7.500 X 7.500 | RED BOARD (PP-1052) | UGS
138 | 2 | 3WSE (HANDLE) | PUR | United
139 | 1 | 3WDE (HANDLE) | PUR | United
140 | 1 | DIA 4.60 MM HSS DB | PUR | United
144 | 1 | DIA 3/8" HSS DB | PUR | United
145 | 1 | DIA 3/8" HSS DB | PUR | United
147 | 1 | DIA 13/32" HSS DB | PUR | United
148 | 1 | 7.00 MM HSS RB | PUR | United
149 | 1 | DIA 10.50 MM HSS RB | PUR | United
155 | 1 | Misumi Vertical Hinge_JHTS30-60 | PUR | MISUMI
167 | 2 | 1/2" HSS DB | PUR | United
168 | 2 | 1/2" HSS DB | PUR | United
171 | 1 | DIA 3/8" HSS DB | PUR | United
172 | 1 | 1.0000 X 2.2500 X 4.0000 | Aluminum | Clinton
180 | 4 | .5000 X 0.5000 X 1.0000 | O-1 GS | Goodmet
200 | 1 | Cart Weldment Fit Base 24.000 x 26.000 See Print | PUR | TSG
