MCBailey-CTS/0Library/0Customer/UGS/2103-000 VTAM  summary.xlsx

Sheet: Dim & Weight
D2LC/D2JC/D2SB - Formex Automotive Industries
GM MILESTONES
Item | Visual ID | Supplier Part Number | GM Part Number | Description | PLACA ID VTAM | Dim. X | Dim. Y | Dim. Z | Weight
1 |  | 00181264 | anu82283 | BRKT SPARE TIRE HOIST |  | 635 | 685.8 | 254 | 109 kg

Sheet: A1,A2,A3
anu82283
 | X | Y | Z
A1 | 4536.79 | 54.9 | 653.03
A2 | 4536.79 | -32.32 | 653.03
A3 | 4886.18 | 118.34 | 659.1
A4 | 4886.18 | -30.91 | 659.1
