MCBailey-CTS/0Library/SeedFiles/ClampFeetDocs/DEXTER 1200ton clamp_.xls

Sheet: Summary
Press |  | 1 | 2 | 3 | 5 | 8 | 9 | 10 | 14 | 20 | 22 | 24 | 25 | 26 | 27 | 30 | 32 | 34 | TN 1200 TON | TN 400 TON | TN PRESS 15 | TN 600 TON | TN 60 TON
Make |  | BLISS | NIAGARA | BLISS | BLISS | BLISS | BLISS | MINSTER | NIAGARA | VERSON | JOHNSON | BLISS | BLISS | MINSTER | MINSTER | MINSTER | MUELLER | AIDA | AIDA | AIDA | NIAGARA | AIDA | Kamatsu
Tonnage |  | 300 | 200 | 45 | 35 | 35 | 150 | 300 | 300 | 800 | 27 | 200 | 250 | 600C | 600B | 1200 | 1000 Metric | 400 Metric (440.92 Ton) | 1200 TON | 400 TON | 300 TON | 600 TON | 60 TON
Bed Size | L | 72" | 72" | 29" | 26" | 26" | 72" | 96" | 84" | 108” |  | 58" | 58" | 108" | 84" | 144" | 4500mm | 3650mm (143.71") | 6000mm | 2450mm | 84" | 3650mm (143.71') | 800mm
 | W | 42" | 36" | 19" | 17" | 17" | 36" | 48" | 48" | 60" |  | 34" | 34" | 54" | 48" | 72" | 1200mm | 1800mm (70.87") | 2000mm | 1250mm | 48" | 1500mm (59.06") | 550mm
Ram Size | L | 72" | 72" | 29" | 26" | 26" | 72" | 96" | 84" | 108” |  | 36" | 39" | 108" | 84" | 144" | 4500mm | 3650mm (143.71") | 6000mm | 2450mm | 84" | 3650mm (143.71') | 450mm
 | W | 36" | 36" | 19" | 17" | 17" | 24" | 48" | 48" | 60" |  | 28" | 28" | 54" | 48" | 72" | 1200mm | 1800mm (70.87") | 2000mm | 1150mm | 48" | 1500mm (59.06") | 350mm
Max Shut Height |  | 20” | 25” | 9.75" | 9.75" | 9.75" | 18" | 26" | 25" | 30.0” |  | 20” | 20” | 25.0” | 25.0” | 30.0” | 700mm | 800mm (31.5") | 1000mm | 550mm | 25" | 850mm (33.46") | 285mm
Ram Adj. |  | 6” | 10” | 3" | 2.5" | 2.5" | 4" | 6” | 11” | 10” |  | 4.5" | 4.5" | 6” | 6” | 6” | 160mm | 300mm (11.81") | 200mm | 100mm | 11” | 300mm (11.81") | 70mm
Precision Shut Height |  | 20.0” | 20.0” |  |  |  |  |  |  | 24.25” |  | 19.0" | 19.0" | 24.25” | 24.25” | 29.0” | 450mm | 800mm (31.5") | 450mm | 510mm |  | 762MM
Feed Height (above Bolster) |  | 9.5” ±1 | 9.5” ±1 | 4.5" ± 0.25 | 4.0" ± 0.25 | 4.0" ± 0.25 | 10.5" ± 0.25 | 11.0" ± 0.25 | 10.5" ± 0.25 | NA |  | NA | NA | 12” ±1 | 12” ±1 | 15.0” ±1 | 500mm |  |  | 310mm | 10.5" ± 0.25 | 381mm - 533mm
Window Size | W | 27” | 22” |  |  |  | 18" | 28" | 30" | 40" |  |  |  | 33” | 33” | 56” | 900mm | 1950mm (76.78") | 200mm | 1170mm | mm | 1250mm (49.218")
 | H | 23" | 24" |  |  |  | 12" | 14" | 16" | 20" |  |  |  | 20" | 20" | 35" | 500mm |  | 80mm | 820mm | 16" | 850mm (33.46")
Stroke |  | 6” | 6” | 4" | 2" | 3" | 6" | 12” | 8” | 16” |  | 10" | 10" | 12” | 12” | 16” | 450mm | 400mm (15.75") | 450mm | 200mm | 8” | 400mm (15.75") | 150mm
Strokes/Minute |  | 0 – 70 | 0 – 70 | 30-100 |  | 100 | 30 – 90 | 0 – 80 | 35-70 | 18 – 20 |  | 40 – 40 | 40 – 40 | 0 – 60 | 0 – 60 | 0 – 50 | 5 – 45 | 20 - 50 | 15 - 30 | 30 - 80 | 35-70 | 0-86
Bolster Thickness |  | 7” | 6” |  |  |  | 6" | 6" | 7" | 18” |  | 5” | 5” | 7” | 7” | 9” | 140mm | 200mm (7.875") | -- | 270mm | 7" | 175mm (6.89") | 75mm
Coil Box OD (Min) |  |  |  |  |  |  |  |  |  |  |  |  |  |  |  |  |  |  | 20" | 20" | 20"
Coil Box OD (Max) |  | 60” | 60” |  |  |  |  | 72" | 24" | 20" |  |  |  | 72” | 72” | 72” |  | 1828.57mm (72") | 1400mm | 1500mm | 62"
Capacity (lbs) |  | 6000 | 6000 |  |  |  | 2500-4000 | 20000 | 2500-4000 | 2500-4000 |  |  |  | 20000 | 10000 | 30000 | 9070kg | 11,339.81kg (25,000lbs) | 5000kg | 5000kg (x2) | 2500-4000
Straightener Width |  | 12” Max | 18” Max | N/A |  | N/A | N/A | 30" | 18" | 18" |  |  |  | 30” Max | 36” Max | 55” Max | 1016mm | 761.90mm (30") | 300-1500mm | 100-800mm | 18"
Straightener Thickness | MIN |  | 0.02 |  |  | N/A | N/A |  |  |  |  |  |  |  | 0.02 | 0.025” | 1.00mm | 1.523mm @761.9mm (.060 @ 30") | 0.5mm | 0.5mm
 | MAX | 0.240 @ 30” | 0.200 @12” |  |  |  |  |  |  |  |  |  |  | 0.240 @ 30” | 0.240 @ 36” | 0.300” | 6.35mm | 7.923mm @304.76mm (.312 @ 12") | 3.2mm | 6.0mm
Feeder Width |  | 12” Max | 24” Max | 9" |  | 8" | 16" | 30" | 24" | 24" |  |  |  | 30” Max | 30” Max | 55” Max | 1016mm | 761mm (30") | 300-1500mm | 100-800mm | 24"
Feeder Thickness | MIN |  | 0.02 |  |  |  |  |  |  |  |  |  |  |  | 0.02 | 0.025 | 1.00mm | 1.523mm @761.9mm (.060 @ 30") | 0.5mm | 0.5mm
 | MAX | 0.24 @ 30” | 0.25 @ 6” |  |  |  | 0.187 |  | 0.187 | 0.187 |  |  |  | 0.24 @ 30” | 0.28” | 0.25 | 6.35mm | 7.923mm @304.76mm (.312 @ 12") | 3.2mm | 6.0mm | 0.187
Feeder Stroke |  | 99” | 18” | 99" |  | 4" |  |  | 99" | 99" |  |  |  | 99” | 99” | 99” | 99" |  | 30 m/min | 10-500mm | 99"

Sheet: TN 1200 TON
 |  | (5) | See the drawing below for the lower die clamp shape
 |  | (6) | Lower die base surface need to take the sharp edges out all the
 |  |  | way around (C2～3) to not hurt the bolster surface.
No. | Item | Specification Contents |  | Check
 |  | (7) | Hole size should be φ48＋0.2～＋0.4 for the locator pins.
 |  |  | Make a great chamfer on C10 for easier inserts. See the drawing
 |  |  | below
 |  | (8) | Chamfer C50 the lower common base corners.
 |  |  | (Same as the upper die)
 |  | (9) | Lower common base front and back length is 1500mm in minimum
 |  |  | and 1800mm in maximum. Try to unify the 1 part die (6 process)
 |  |  | lower common base sizes. (Include idols)
5 | Upper die clamp | (1) | See the separate attachment, "Slide drawing", for the upper die
 |  |  | clamping location. Clamp 4 locations.
 |  |  | (See the drawing below for the upper common base)
 |  | (2) | See the drawing below for the base thickness on the clamp and
 |  |  | clamp shape.
 |  |  | ・Thickness : 50mm (base plate 50mm)
 |  |  | ･Clamp diameter : φ78mm
 |  | (3) | See the drawing below for the upper die clamp shape
 |  | ・Common clamps for front and rear side
 |  | (4) | Take all the sharp edges out form the upper die base(C2～3)
 |  |  | to not damage the sliding surface.
