MCBailey-CTS/0Library/TsgComponents/DieTags/ETS DieTag.pdf

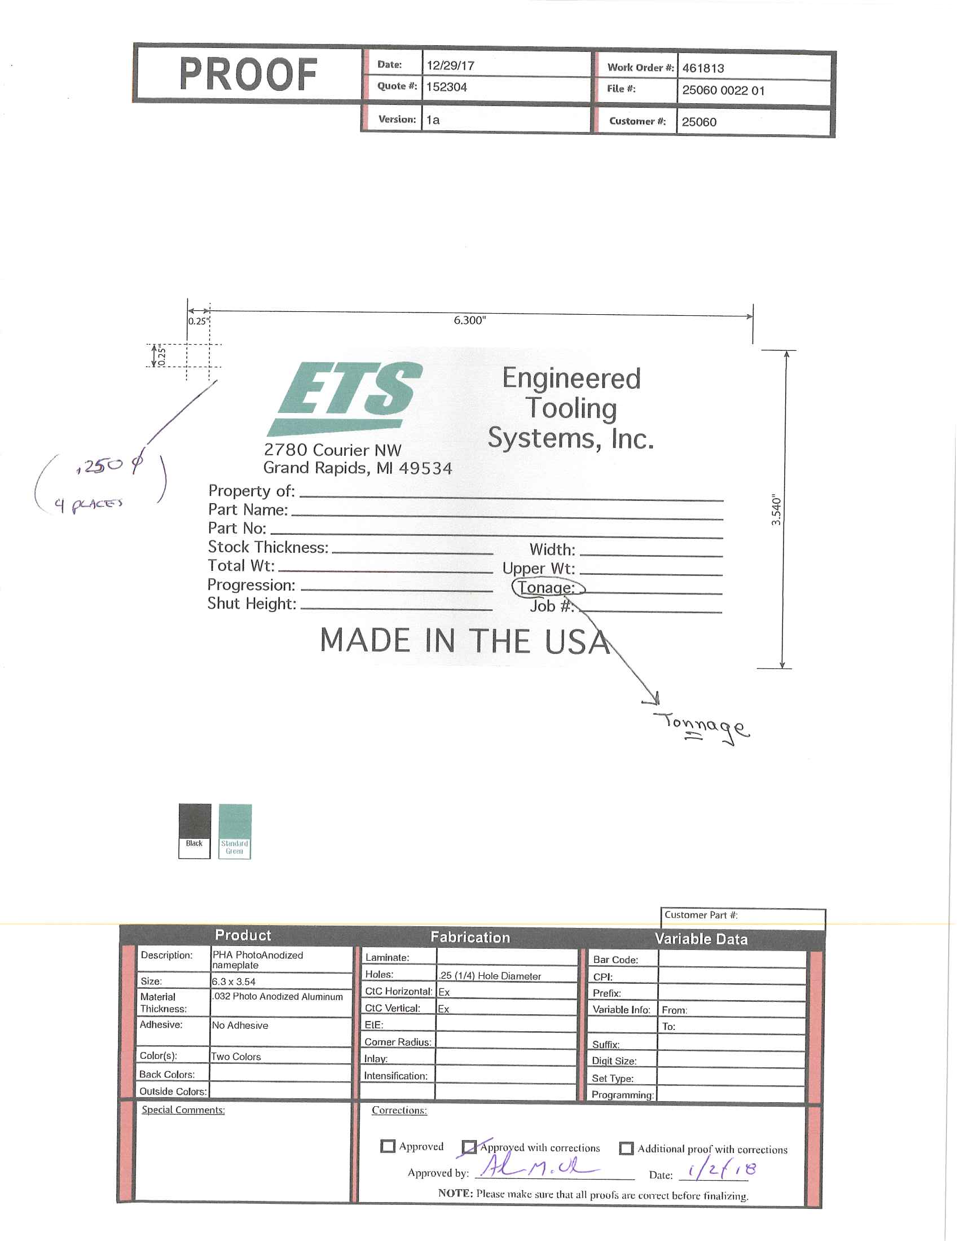
[picture p153: page 1]
