MCBailey-CTS/0Library/CamAssemblies/Cam Assembly Wear Plate Sizes.xlsx

G:\0Library\CamAssemblies\English\Components\ | Size | Description | Material | Vendor | Version
Smart Selflube NSX (Steel) English 1 | 1 X 6 X 4 | nsx8604-wearplate | Steel | SELFLUBE | 1.21
Smart Selflube NSX (Steel) English 2 | 1 X 4 X 6 | nsx8406-wearplate | Steel | SELFLUBE | 1.21
Smart Selflube NSX (Steel) English 3 | 1 X 4 X 5 | nsx8405-wearplate | Steel | SELFLUBE | 1.21
Smart Selflube NYG (Bronze) English 1 | 1 X 5 X 8 | nyg8508-wearplate | Bronze | SELFLUBE | 1.41
Smart Selflube NYG (Bronze) English 2 | 1 X 6 X 4 | nyg8604-wearplate | Bronze | SELFLUBE | 1.41
Smart Selflube NYG (Bronze) English 3 | 1 X 6 X 8 | nyg8608-wearplate | Bronze | SELFLUBE | 1.41
Smart Selflube NYG (Bronze) English 4 | 1 X 4 X 5 | nyg8405-wearplate | Bronze | SELFLUBE | 1.41
Smart Selflube NYG (Bronze) English 5 | 1 X 4 X 6 | nyg8406-wearplate | Bronze | SELFLUBE | 1.41
Smart Selflube Wearstrips English 1 | 0.625 X 1.5 X 6 | 5-12-48G wearstrip | Bronze-Graphite | SELFLUBE | 2.00
G:\0Library\CamAssemblies\Metric\Components\ | Size | Description | Material | Vendor | Version
Smart NAAMS Wearplate Metric 1 | 20 X 160 X 100 | W031610 WEARPLATE | Bronze-Graphite | NAAMS | 1.22
Smart NAAMS Wearplate Metric 2 | 20 X 160 X 200 | W031620 WEARPLATE | Bronze-Graphite | NAAMS | 1.22
Smart NAAMS Wearplate Metric 3 | 20 X 125 X 200 | W031220 WEARPLATE | Bronze-Graphite | NAAMS | 1.22
Smart NAAMS Wearplate Metric 4 | 20 X 100 X 150 | W031015 WEARPLATE | Bronze-Graphite | NAAMS | 1.22
Smart NAAMS Wearplate Metric 5 | 20 X 160 X 100 | W021610 WEARPLATE | Steel | NAAMS | 1.22
Smart NAAMS Wearplate Metric 6 | 20 X 100 X 150 | W021015 WEARPLATE | Steel | NAAMS | 1.22
Smart Selflube G Wearstrips Metric 1 | 0.625 X 1.5 X 6 | metric 5-12-48g wearstrip M8shcs | Bronze-Graphite | SELFLUBE | 2.01
Smart Misumi-Selflube-Sankyo Wearplate Metric 1 | 20 X 58 X 75 | SEW 58 - 75 WEARPLATE | Bronze-Graphite | Misumi | 1.90
Smart Misumi-Selflube-Sankyo Wearplate Metric 2 | 20 X 100 X 150 | SEW 100 - 150 WEARPLATE | Bronze-Graphite | Misumi | 1.90
Smart Misumi-Selflube-Sankyo Wearplate Metric 3 | 10 X 28 X 150 | STW 28 - 150 WEARPLATE | Bronze-Graphite | Misumi | 1.90
