MCBailey-CTS/0Library/0Customer/UGS/2103-000 Formex checking fixture summary pin chart (002).xls

Sheet: EXAMPLE
 |  |  | Checking fixture summary pin chart
 | Project |  |  | Part name |  |  |  |  |  |  | Part number |  |  |  | Engineering level
 | QRXX |  |  | Extension front floor |  |  |  |  |  |  | 123456 |  |  |  | AB
TYPE | LABEL | NOMINAL |  | +TOL. | -TOL. | POS. TOL. |  | CHECK SIZE |  | TOL. |  | GO SIZE | TOL. |  | NO-GO SIZE | TOL.
4-WAY | B | 8.000 |  | 0.120 | 0.030 | 0.000 |  | 7.970 |  | + | 0.000 | 7.970 | + | 0.000 | 8.120 | + | 0.020
MALE |  |  |  |  |  |  |  |  |  | - | 0.020 |  | - | 0.020 |  | - | 0.000
2-WAY | C | 10.000 |  | 0.120 | 0.030 | 0.000 |  | 9.970 |  | + | 0.000 | 9.970 | + | 0.000 | 10.120 | + | 0.020
MALE |  |  |  |  |  |  |  |  |  | - | 0.020 |  | - | 0.020 |  | - | 0.000
2-WAY |  | 13.000 |  | 0.250 | 0.250 | 1.000 |  | 11.750 |  | + | 0.000 | 12.750 | + | 0.000 | 13.250 | + | 0.020
MALE |  |  |  |  |  |  |  |  |  | - | 0.020 |  | - | 0.020 |  | - | 0.000
STAKE | D | 15.000 |  | 0.500 | 0.500 | 1.500 |  | 13.000 |  | + | 0.000 | 14.500 | + | 0.000 | 15.500 | + | 0.020
MALE |  |  |  |  |  |  |  |  |  | - | 0.020 |  | - | 0.020 |  | - | 0.000
STAKE | E | 5.000 |  | 0.200 | 0.200 | 1.000 |  | 3.800 |  | + | 0.000 | 4.800 | + | 0.000 | 5.200 | + | 0.020
MALE |  |  |  |  |  |  |  |  |  | - | 0.020 |  | - | 0.020 |  | - | 0.000
 |  |  |  |  |  |  |  | FALSE |  | + | FALSE | FALSE | + | FALSE | FALSE | + | FALSE
 |  |  |  |  |  |  |  |  |  | - | FALSE |  | - | FALSE |  | - | FALSE
 |  |  |  |  |  |  |  | FALSE |  | + | FALSE | FALSE | + | FALSE | FALSE | + | FALSE
 |  |  |  |  |  |  |  |  |  | - | FALSE |  | - | FALSE |  | - | FALSE
 |  |  |  |  |  |  |  | FALSE |  | + | FALSE | FALSE | + | FALSE | FALSE | + | FALSE
 |  |  |  |  |  |  |  |  |  | - | FALSE |  | - | FALSE |  | - | FALSE
 |  |  |  |  |  |  |  | FALSE |  | + | FALSE | FALSE | + | FALSE | FALSE | + | FALSE
 |  |  |  |  |  |  |  |  |  | - | FALSE |  | - | FALSE |  | - | FALSE
 |  |  |  |  |  |  |  | FALSE |  | + | FALSE | FALSE | + | FALSE | FALSE | + | FALSE
 |  |  |  |  |  |  |  |  |  | - | FALSE |  | - | FALSE |  | - | FALSE
 |  |  |  |  |  |  |  | FALSE |  | + | FALSE | FALSE | + | FALSE | FALSE | + | FALSE
 |  |  |  |  |  |  |  |  |  | - | FALSE |  | - | FALSE |  | - | FALSE
 |  |  |  |  |  |  |  | FALSE |  | + | FALSE | FALSE | + | FALSE | FALSE | + | FALSE
 |  |  |  |  |  |  |  |  |  | - | FALSE |  | - | FALSE |  | - | FALSE
 |  |  |  |  |  |  |  | FALSE |  | + | FALSE | FALSE | + | FALSE | FALSE | + | FALSE
 |  |  |  |  |  |  |  |  |  | - | FALSE |  | - | FALSE |  | - | FALSE
 |  |  |  |  |  |  |  | FALSE |  | + | FALSE | FALSE | + | FALSE | FALSE | + | FALSE
 |  |  |  |  |  |  |  |  |  | - | FALSE |  | - | FALSE |  | - | FALSE
 |  |  |  |  |  |  |  | FALSE |  | + | FALSE | FALSE | + | FALSE | FALSE | + | FALSE
 |  |  |  |  |  |  |  |  |  | - | FALSE |  | - | FALSE |  | - | FALSE
 |  |  |  |  |  |  |  | FALSE |  | + | FALSE | FALSE | + | FALSE | FALSE | + | FALSE
 |  |  |  |  |  |  |  |  |  | - | FALSE |  | - | FALSE |  | - | FALSE
 |  |  |  |  |  |  |  | FALSE |  | + | FALSE | FALSE | + | FALSE | FALSE | + | FALSE
 |  |  |  |  |  |  |  |  |  | - | FALSE |  | - | FALSE |  | - | FALSE
 |  |  |  |  |  |  |  | FALSE |  | + | FALSE | FALSE | + | FALSE | FALSE | + | FALSE
 |  |  |  |  |  |  |  |  |  | - | FALSE |  | - | FALSE |  | - | FALSE
 |  |  |  |  |  |  |  | FALSE |  | + | FALSE | FALSE | + | FALSE | FALSE | + | FALSE
 |  |  |  |  |  |  |  |  |  | - | FALSE |  | - | FALSE |  | - | FALSE
 |  |  |  |  |  |  |  | FALSE |  | + | FALSE | FALSE | + | FALSE | FALSE | + | FALSE
 |  |  |  |  |  |  |  |  |  | - | FALSE |  | - | FALSE |  | - | FALSE
 |  |  |  |  |  |  |  | FALSE |  | + | FALSE | FALSE | + | FALSE | FALSE | + | FALSE
 |  |  |  |  |  |  |  |  |  | - | FALSE |  | - | FALSE |  | - | FALSE
 |  |  |  |  |  |  |  | FALSE |  | + | FALSE | FALSE | + | FALSE | FALSE | + | FALSE
 |  |  |  |  |  |  |  |  |  | - | FALSE |  | - | FALSE |  | - | FALSE
 |  |  |  |  |  |  |  | FALSE |  | + | FALSE | FALSE | + | FALSE | FALSE | + | FALSE
 |  |  |  |  |  |  |  |  |  | - | FALSE |  | - | FALSE |  | - | FALSE
 |  |  |  | FEELERS
 |  |  |  | LABEL | NOMINAL | +TOL. | -TOL. | GO SIZE | NO-GO SIZE
 |  |  |  | A | 6.000 | 0.600 | 0.600 | 5.400 | 6.600
 |  |  |  | B | 6.000 | 0.900 | 0.900 | 5.100 | 6.900
 |  |  |  | C | 10.000 | 0.500 | 0.500 | 9.500 | 10.500
 |  |  |  |  |  |  |  | 0.000 | 0.000
 |  |  |  |  |  |  |  | 0.000 | 0.000

Sheet: Pin Chart
 |  |  | Checking fixture summary pin chart
 | Project |  |  | Part name |  |  |  |  |  |  | Part number |  |  |  | Engineering level
TYPE | LABEL | NOMINAL |  | +TOL. | -TOL. | POS. TOL. |  | CHECK SIZE |  | TOL. |  | GO SIZE | TOL. |  | NO-GO SIZE | TOL.
 |  |  |  |  |  |  |  | FALSE |  | + | FALSE | FALSE | + | FALSE | FALSE | + | FALSE
 |  |  |  |  |  |  |  |  |  | - | FALSE |  | - | FALSE |  | - | FALSE
 |  |  |  |  |  |  |  | FALSE |  | + | FALSE | FALSE | + | FALSE | FALSE | + | FALSE
 |  |  |  |  |  |  |  |  |  | - | FALSE |  | - | FALSE |  | - | FALSE
 |  |  |  |  |  |  |  | FALSE |  | + | FALSE | FALSE | + | FALSE | FALSE | + | FALSE
 |  |  |  |  |  |  |  |  |  | - | FALSE |  | - | FALSE |  | - | FALSE
 |  |  |  |  |  |  |  | FALSE |  | + | FALSE | FALSE | + | FALSE | FALSE | + | FALSE
 |  |  |  |  |  |  |  |  |  | - | FALSE |  | - | FALSE |  | - | FALSE
 |  |  |  |  |  |  |  | FALSE |  | + | FALSE | FALSE | + | FALSE | FALSE | + | FALSE
 |  |  |  |  |  |  |  |  |  | - | FALSE |  | - | FALSE |  | - | FALSE
 |  |  |  |  |  |  |  | FALSE |  | + | FALSE | FALSE | + | FALSE | FALSE | + | FALSE
 |  |  |  |  |  |  |  |  |  | - | FALSE |  | - | FALSE |  | - | FALSE
 |  |  |  |  |  |  |  | FALSE |  | + | FALSE | FALSE | + | FALSE | FALSE | + | FALSE
 |  |  |  |  |  |  |  |  |  | - | FALSE |  | - | FALSE |  | - | FALSE
 |  |  |  |  |  |  |  | FALSE |  | + | FALSE | FALSE | + | FALSE | FALSE | + | FALSE
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
 |  |  |  | FEELERS
 |  |  |  | LABEL | NOMINAL | +TOL. | -TOL. | GO SIZE | NO-GO SIZE
 |  |  |  |  |  |  |  | 0.000 | 0.000
 |  |  |  |  |  |  |  | 0.000 | 0.000
 |  |  |  |  |  |  |  | 0.000 | 0.000
 |  |  |  |  |  |  |  | 0.000 | 0.000
 |  |  |  |  |  |  |  | 0.000 | 0.000

Sheet: INFO
4-WAY | MALE | D
2-WAY | FEMALE | C
STAKE |  | P
GO/NOGO |  | JE
 |  | E
 |  | O
