MCBailey-CTS/0Library/0Customer/UGS/2103-000 Model BRKT Spare Tire Hoist_Pn 181264.SLDASM

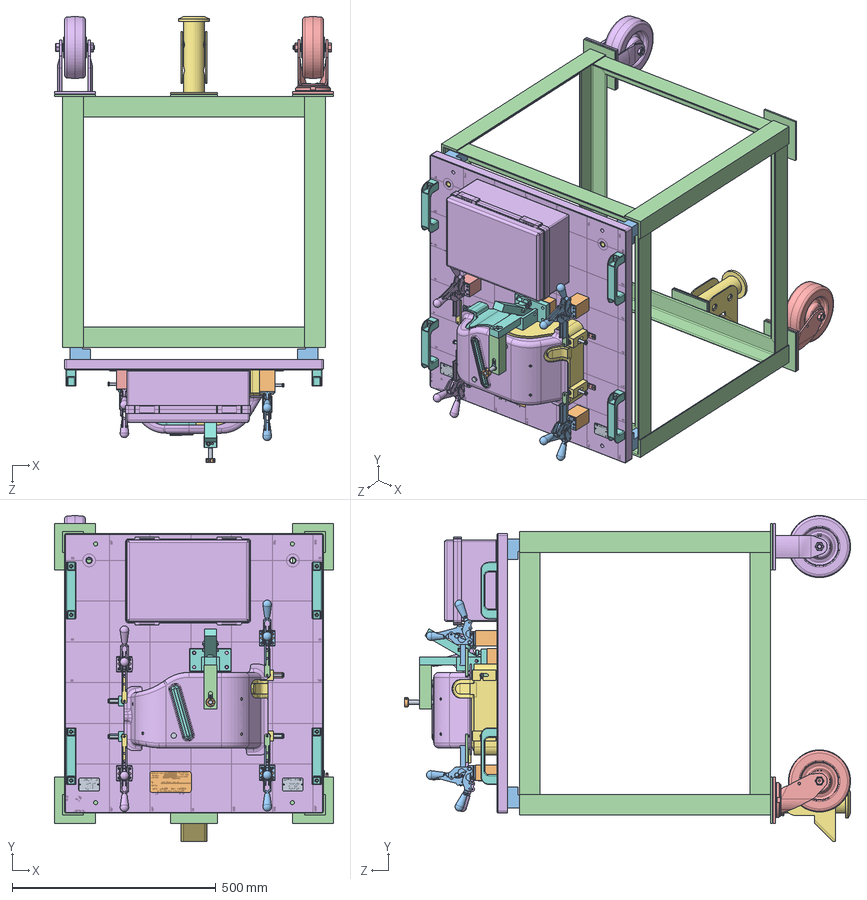
[picture p154: CAD file, 2026-10-29]
0Customer/UGS/2103-000 Model BRKT Spare Tire Hoist_Pn 181264.SLDASM
685.8 x 800.1 x 1094.9 mm
2103-000-109 -B-, -C- MMC Locator x 2
2103-000-110 2002 Clamp Riser x 2
2103-000 Destaco TC-2002_U x 2
2103-000-111 Clamp Ext x 2
2103-000 M6 Softip Set Screw x 4
2103-000 NEMA Box - Configurable (Bud Industries Inc)
2103-000 'B' Straight Feeler
2103-000 3WDE HANDLE
2103-000-131 -B-, -C- GoNogo
2103-000-149 Stab #2 GoNogo
2103-000 3WSE HANDLE x 2
2103-000-148 Stab #1 GoNogo
2103-000-136 Pin Holder
2103-000-144 Flush Gage 'A'
2103-000-140 Stab #1
2103-000 Ball Feeler 'A'
2103-000-145 Flush Gage 'B'
2103-000-171 Flush Gage 'C'
2103-000 Ball Feeler 'C'
2103-000 'D' Straight Feeler
2103-000-112 1 2002 Clamp Riser x 2
2103-000 1 Destaco TC-2002_U x 2
2103-000-113 1 Clamp Ext x 2
2103-000-167 Retractable A1, A2 x 2
2103-000 91259A544_ALLOY STEEL SHOULDER SCREW x 4
2103-000 Retractable -A- Net Bushing x 8
2103-000-180 Retractable Net Stop x 2
2103-000-168 Retractable A3, A4 x 2
2103-000-181 Retractor Stop Block x 2
2103-000-100 Base Plate With Bushings for Single Part
2103-000-103 Setup Bushing x 4
2103-000-101 Gage Handle x 4
2103-000 Tooling Bushing Tag x 2
2103-000 UGS Tag
2103-000-170 Formex Base Foot x 4
2103-000-155 Misumi Vertical Hinge_JHTS30-60
2103-000-147 Stab #2
2103-000 6435K130_ONE-PIECE CLAMP-ON SHAFT COLLAR (1)
2130-000-122 Key
2103-000-123 Stab Block
2103-000 Bushing
anu82283.geo_fin001.002001
2103-000-105 Main Riser #1
2103-000-106 Main Riser #2
2103-000 Stab Bushing 1 x 4
2103-000-172_Hinge-Riser
