MCBailey-CTS/0Library/0Customer/UGS/Gage Details/Asm & Pur Components/Stab #4 GoNogo, -B-, -C- GoNogo.SLDASM

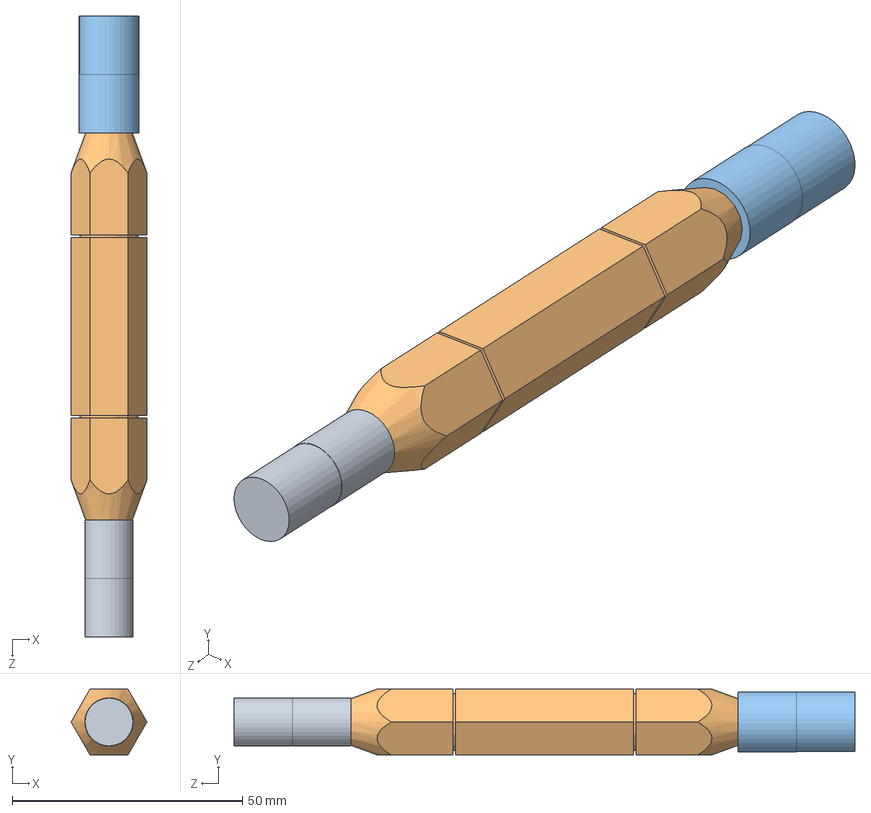
[picture p156: CAD file, 2026-10-29]
0Customer/UGS/Gage Details/Asm & Pur Components/Stab #4 GoNogo, -B-, -C- GoNogo.SLDASM
16.5 x 14.3 x 134.9 mm
2103-000 3WDE HANDLE
2103-000-131 -B-, -C- GoNogo
2103-000-149 Stab #2 GoNogo
