MCBailey-CTS/0Library/0Customer/UGS/Gage Details/2103-000-105 Main Riser #1.SLDPRT

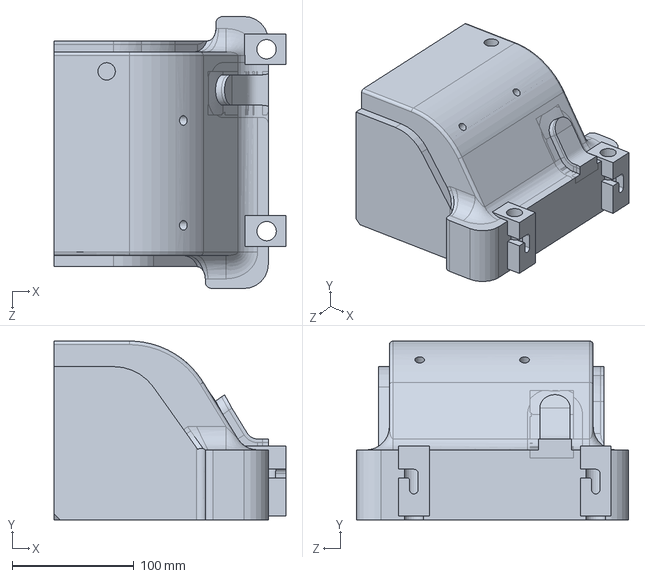
[picture p157: CAD file, 2026-10-29]
0Customer/UGS/Gage Details/2103-000-105 Main Riser #1.SLDPRT
190.3 x 146.8 x 223.2 mm
