MCBailey-CTS/0Library/0Customer/UGS/Gage Details/Asm & Pur Components/Swing Stab Asm.SLDASM

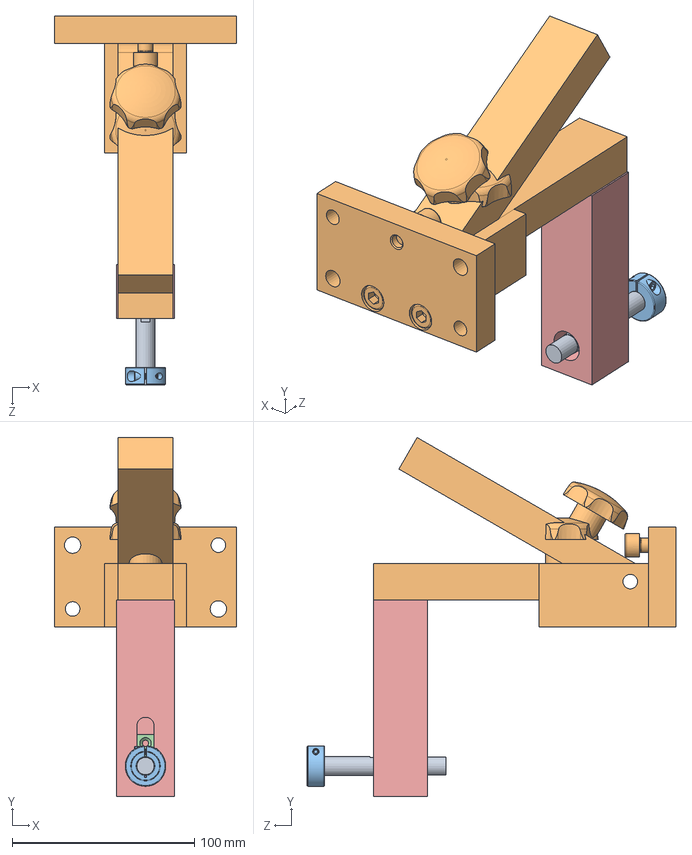
[picture p158: CAD file, 2026-10-29]
0Customer/UGS/Gage Details/Asm & Pur Components/Swing Stab Asm.SLDASM
100.0 x 197.1 x 202.4 mm
2103-000-155 Misumi Vertical Hinge_JHTS30-60
2103-000-147 Stab #2
2103-000 6435K130_ONE-PIECE CLAMP-ON SHAFT COLLAR (1)
2130-000-122 Key
2103-000-123 Stab Block
2103-000 Bushing
