MCBailey-CTS/0Library/0Customer/UGS/Gage Details/2103-000_Feeler Blate With Clip.SLDASM

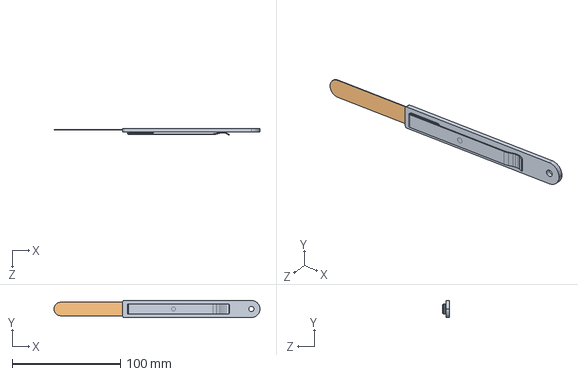
[picture p159: CAD file, 2026-10-29]
0Customer/UGS/Gage Details/2103-000_Feeler Blate With Clip.SLDASM
190.5 x 15.9 x 6.24 mm
2103-000_Gage Stock Holder
2103-000_Feeler Blade
