MCBailey-CTS/0Library/0Customer/UGS/Gage Details/2103-000-106 Main Riser #2.SLDPRT

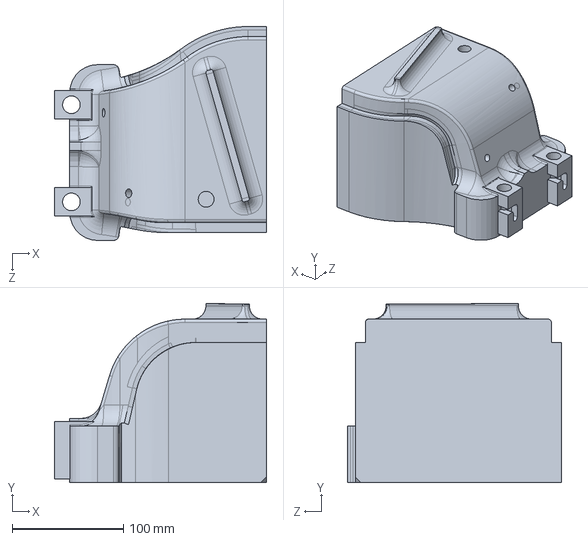
[picture p160: CAD file, 2026-10-29]
0Customer/UGS/Gage Details/2103-000-106 Main Riser #2.SLDPRT
190.5 x 160.9 x 192.2 mm
