MCBailey-CTS/0Library/0Customer/UGS/Gage Details/Asm & Pur Components/Stab #2 GoNogo.SLDASM

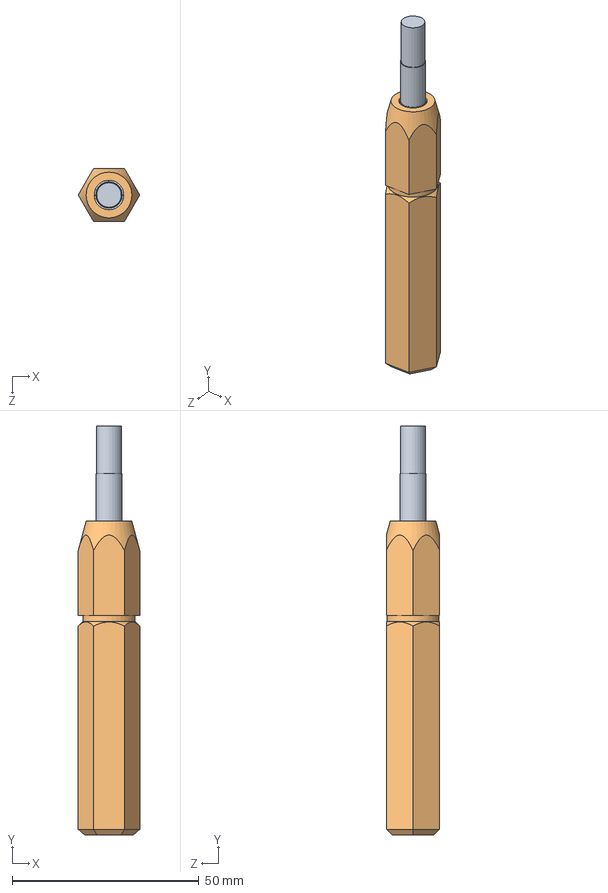
[picture p161: CAD file, 2026-10-29]
0Customer/UGS/Gage Details/Asm & Pur Components/Stab #2 GoNogo.SLDASM
16.5 x 109.5 x 14.3 mm
2103-000 3WSE HANDLE
2103-000-148 Stab #1 GoNogo
