MCBailey-CTS/0Library/0Customer/UGS/Gage Details/Asm & Pur Components/Pin Box.SLDASM

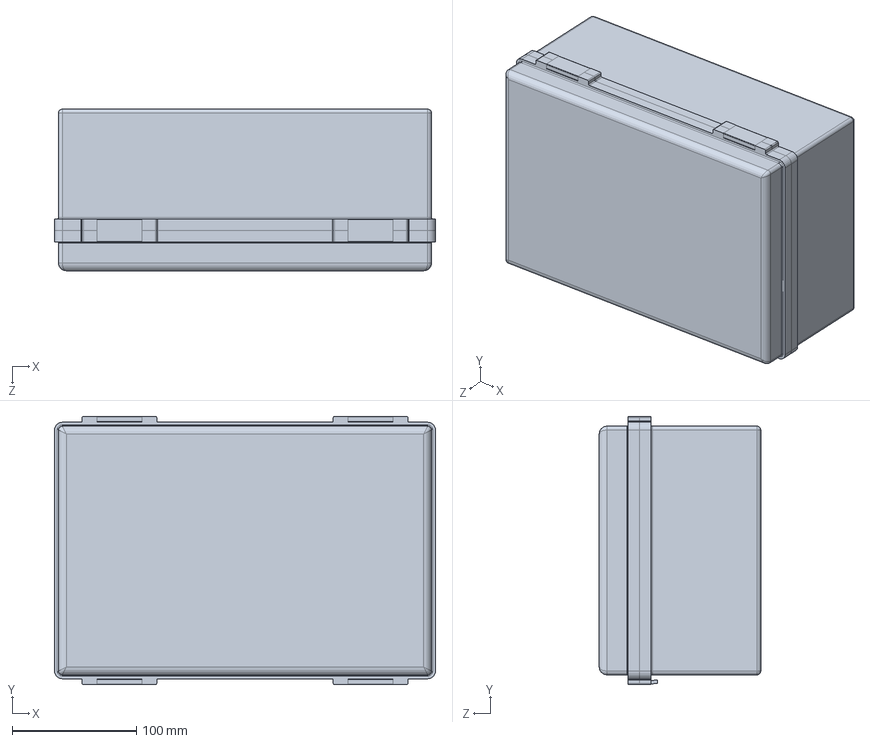
[picture p162: CAD file, 2026-10-29]
0Customer/UGS/Gage Details/Asm & Pur Components/Pin Box.SLDASM
306.4 x 215.9 x 130.0 mm
2103-000 NEMA Box - Configurable (Bud Industries Inc)
2103-000 'B' Straight Feeler
2103-000 3WDE HANDLE
2103-000-131 -B-, -C- GoNogo
2103-000-149 Stab #2 GoNogo
2103-000 3WSE HANDLE x 2
2103-000-148 Stab #1 GoNogo
2103-000-136 Pin Holder
2103-000-144 Flush Gage 'A'
2103-000-140 Stab #1
2103-000 Ball Feeler 'A'
2103-000-145 Flush Gage 'B'
2103-000-171 Flush Gage 'C'
2103-000 Ball Feeler 'C'
2103-000 'D' Straight Feeler
