MCBailey-CTS/0Library/0Customer/UGS/Gage Details/Asm & Pur Components/2103-000 1 Clamp Asm 2002-U_With Ext.SLDASM

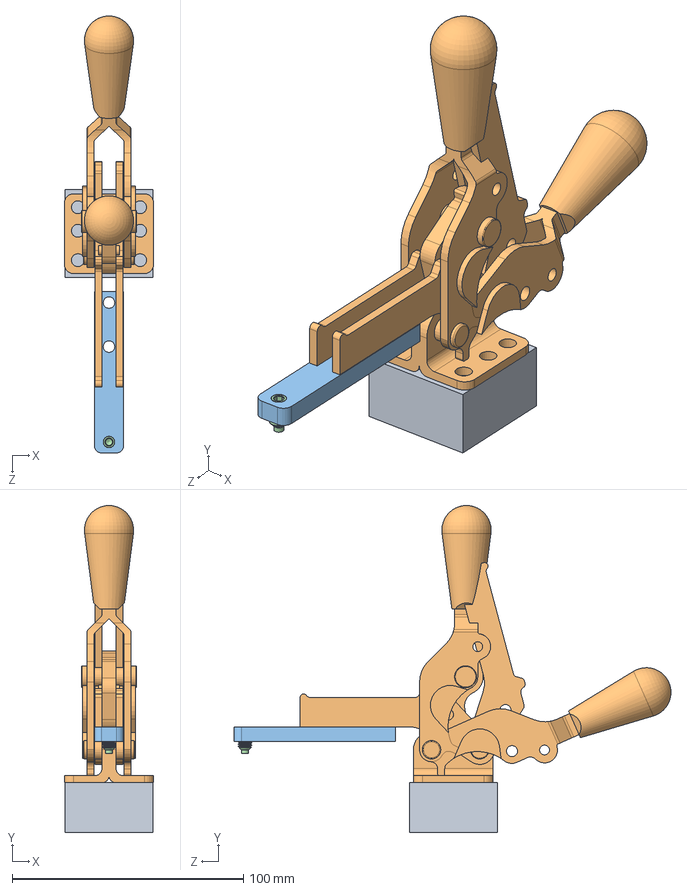
[picture p163: CAD file, 2026-10-29]
0Customer/UGS/Gage Details/Asm & Pur Components/2103-000 1 Clamp Asm 2002-U_With Ext.SLDASM
38.6 x 141.5 x 189.1 mm
2103-000-112 1 2002 Clamp Riser
2103-000 1 Destaco TC-2002_U
2103-000-113 1 Clamp Ext
2103-000 M6 Softip Set Screw
