MCBailey-CTS/0Library/0Customer/UGS/Gage Details/Asm & Pur Components/2103-000- Retractable Net #2 Asm.SLDASM

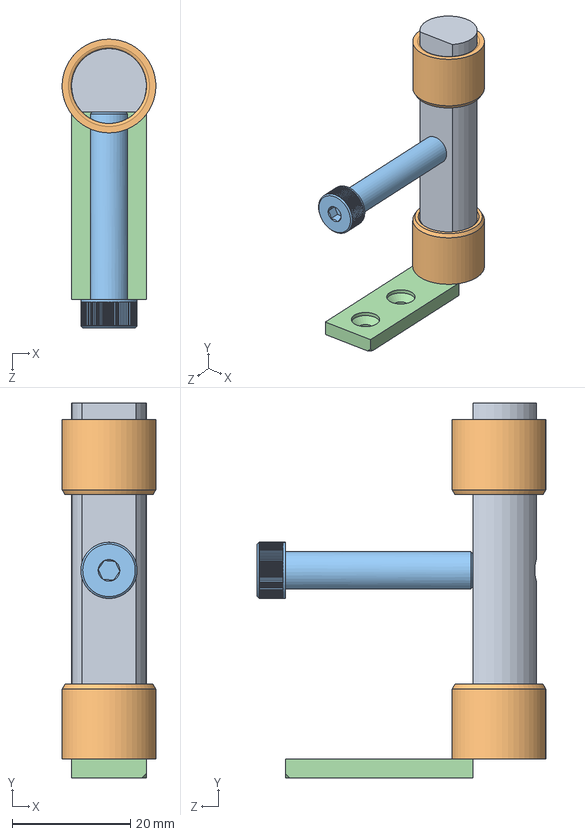
[picture p164: CAD file, 2026-10-29]
0Customer/UGS/Gage Details/Asm & Pur Components/2103-000- Retractable Net #2 Asm.SLDASM
15.9 x 63.5 x 48.9 mm
2103-000-168 Retractable A3, A4
2103-000 Retractable -A- Net Bushing x 2
2103-000 91259A544_ALLOY STEEL SHOULDER SCREW
2103-000-181 Retractor Stop Block
