MCBailey-CTS/0Library/0Customer/UGS/Gage Details/Asm & Pur Components/2103-000 Clamp Asm 2002-U_With Ext.SLDASM

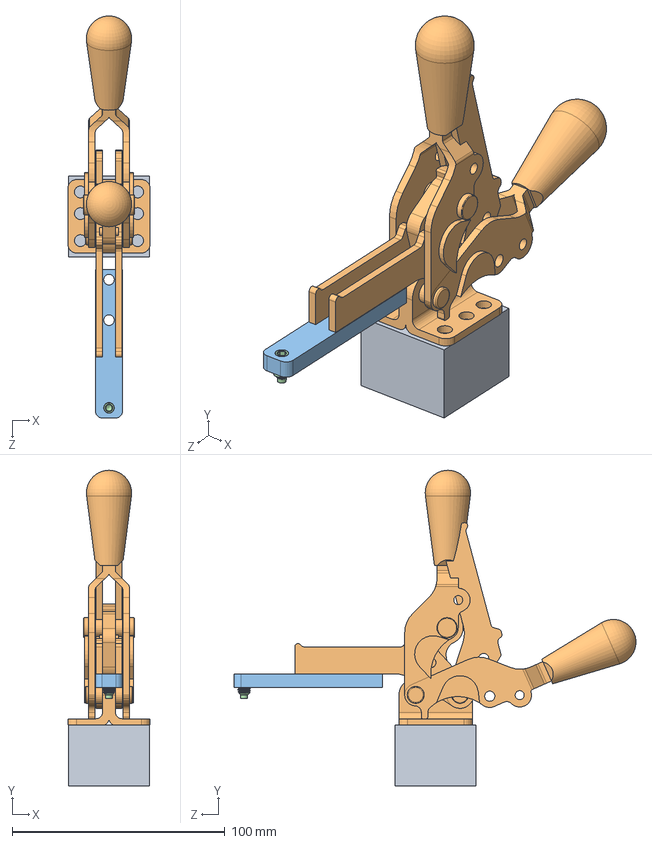
[picture p165: CAD file, 2026-10-29]
0Customer/UGS/Gage Details/Asm & Pur Components/2103-000 Clamp Asm 2002-U_With Ext.SLDASM
38.6 x 148.4 x 189.1 mm
2103-000-110 2002 Clamp Riser
2103-000 Destaco TC-2002_U
2103-000-111 Clamp Ext
2103-000 M6 Softip Set Screw
