MCBailey-CTS/0Library/0Customer/UGS/Gage Details/Asm & Pur Components/2103-000 Angle Cart Weldment Asm (Configurable_4Post_6post_8post).SLDASM

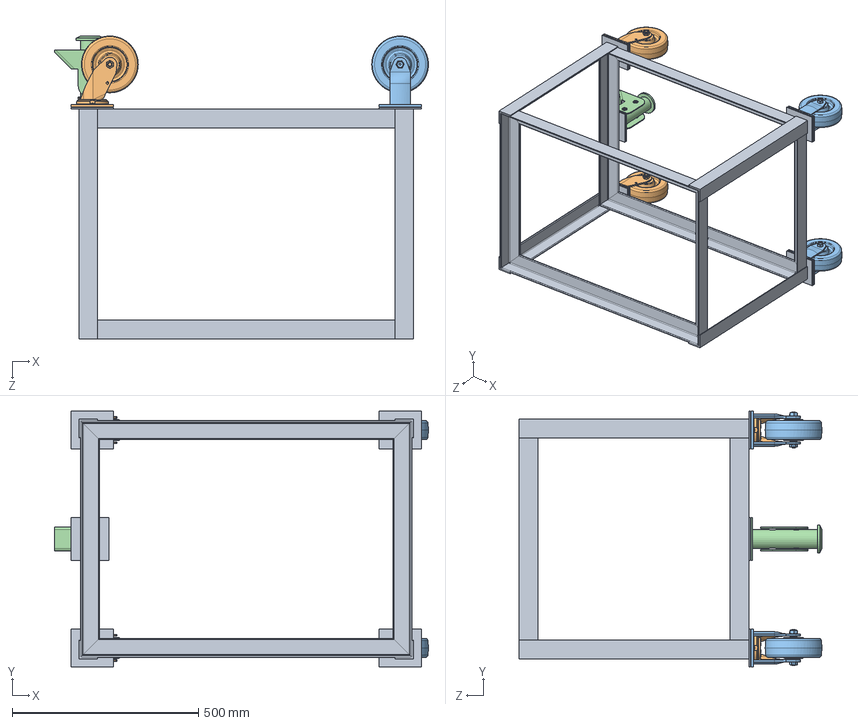
[picture p166: CAD file, 2026-10-29]
0Customer/UGS/Gage Details/Asm & Pur Components/2103-000 Angle Cart Weldment Asm (Configurable_4Post_6post_8post).SLDASM
1003.3 x 685.8 x 812.8 mm
2103-000 Angle Cart Weldment_2017Oct02
2103-000 Colson 6 in. Swivel Phen. Caster - (4.06109.339) - GLC x 2
2103-000 Colson 6 in. Rigid Phen. Caster - (4.06108.339) - GLC x 2
2103-000 Colson 6 in. Floor Lock - (9.06045.6) - GLC
