MCBailey-CTS/0Library/0Customer/UGS/Gage Details/Asm & Pur Components/2103-000 Base With Bushings Asm_for Single Part.SLDASM

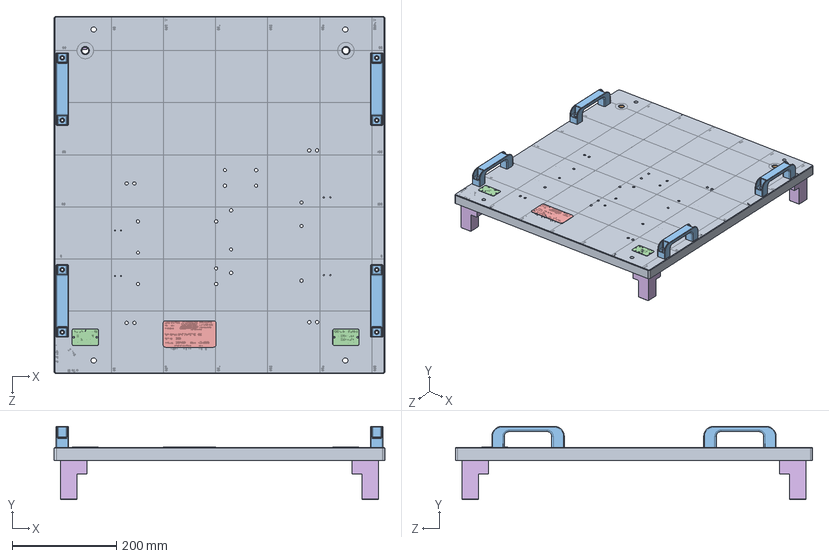
[picture p167: CAD file, 2026-10-29]
0Customer/UGS/Gage Details/Asm & Pur Components/2103-000 Base With Bushings Asm_for Single Part.SLDASM
635.0 x 140.5 x 685.8 mm
2103-000-100 Base Plate With Bushings for Single Part
2103-000-103 Setup Bushing x 4
2103-000-101 Gage Handle x 4
2103-000 Tooling Bushing Tag x 2
2103-000 UGS Tag
2103-000-170 Formex Base Foot x 4
