MCBailey-CTS/0Library/0Customer/UGS/Gage Details/Asm & Pur Components/2103-000 Stab #1 Asm.SLDASM

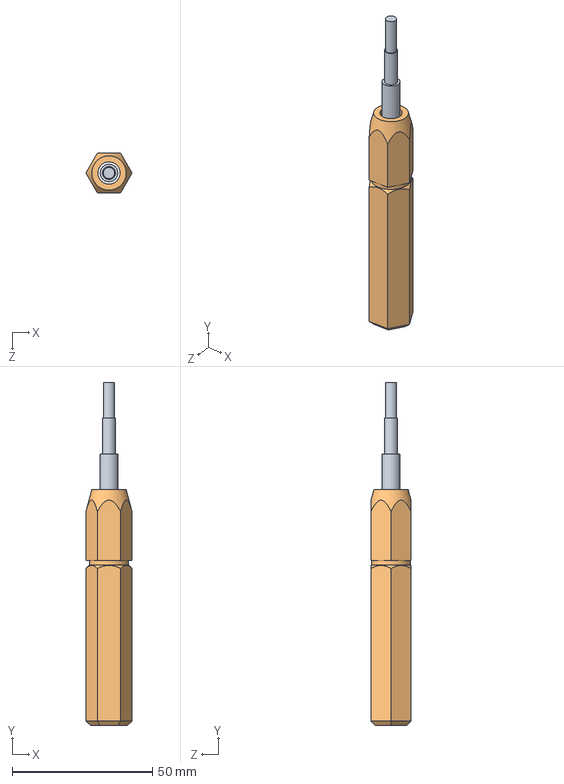
[picture p168: CAD file, 2026-10-29]
0Customer/UGS/Gage Details/Asm & Pur Components/2103-000 Stab #1 Asm.SLDASM
16.5 x 122.2 x 14.3 mm
2103-000-140 Stab #1
2103-000 3WSE HANDLE
