MCBailey-CTS/0Library/0Customer/UGS/Gage Details/2103-000-144 Flush Gage 'A'.SLDPRT

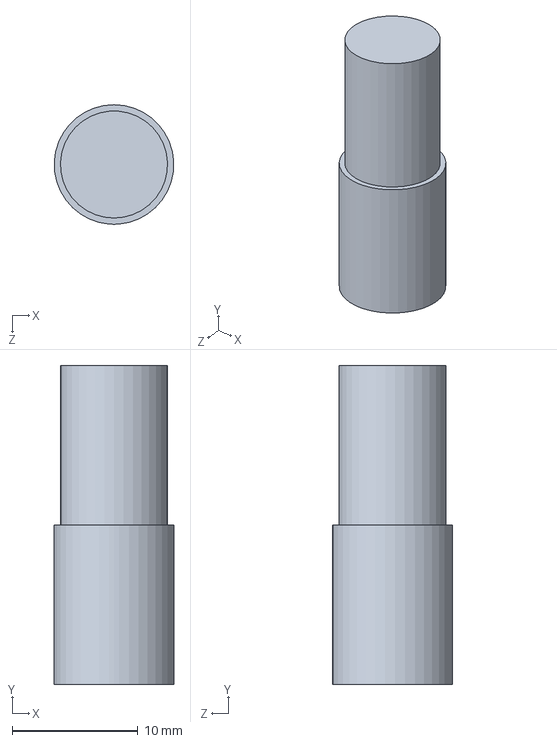
[picture p169: CAD file, 2026-10-29]
0Customer/UGS/Gage Details/2103-000-144 Flush Gage 'A'.SLDPRT
9.52 x 25.4 x 9.53 mm
