MCBailey-CTS/0Library/0Customer/UGS/Gage Details/Asm & Pur Components/2103-000 Ball Feeler 'C'.SLDPRT

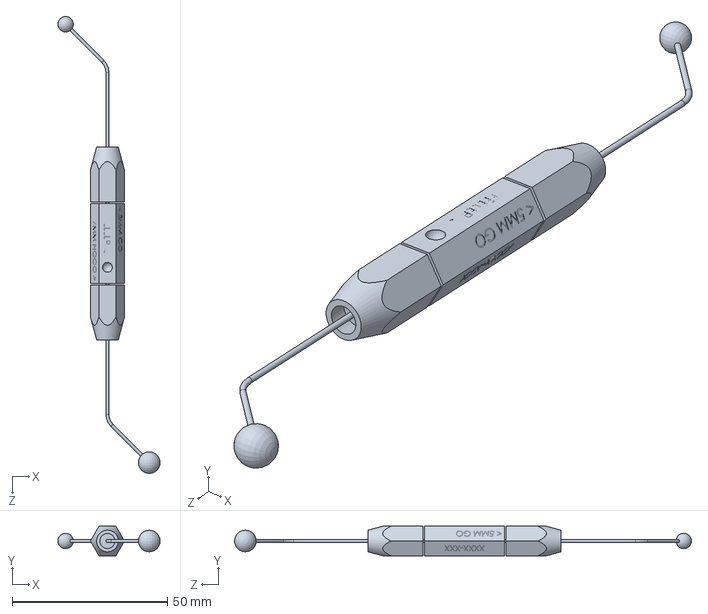
[picture p170: CAD file, 2026-10-29]
0Customer/UGS/Gage Details/Asm & Pur Components/2103-000 Ball Feeler 'C'.SLDPRT
32.9 x 9.53 x 147.2 mm
