MCBailey-CTS/0Library/0Customer/UGS/Gage Details/Parts/2103-000_Feeler Blade.SLDPRT

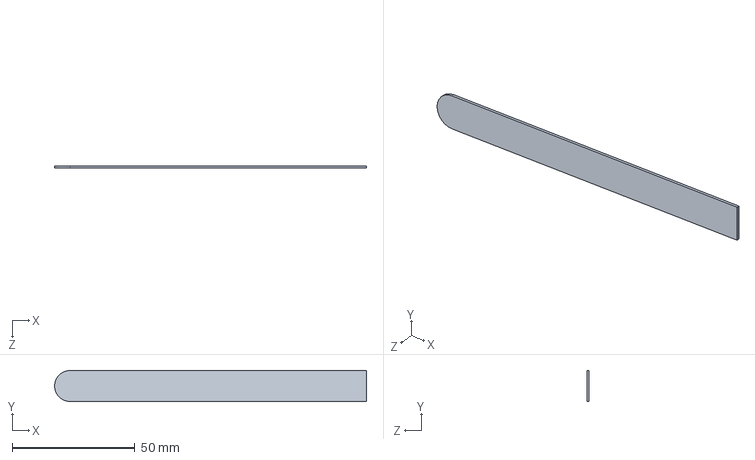
[picture p171: CAD file, 2026-10-29]
0Customer/UGS/Gage Details/Parts/2103-000_Feeler Blade.SLDPRT
127.0 x 12.7 x 1.00 mm
