MCBailey-CTS/0Library/0Customer/UGS/Outsource/2103-000-200_Cart.STEP

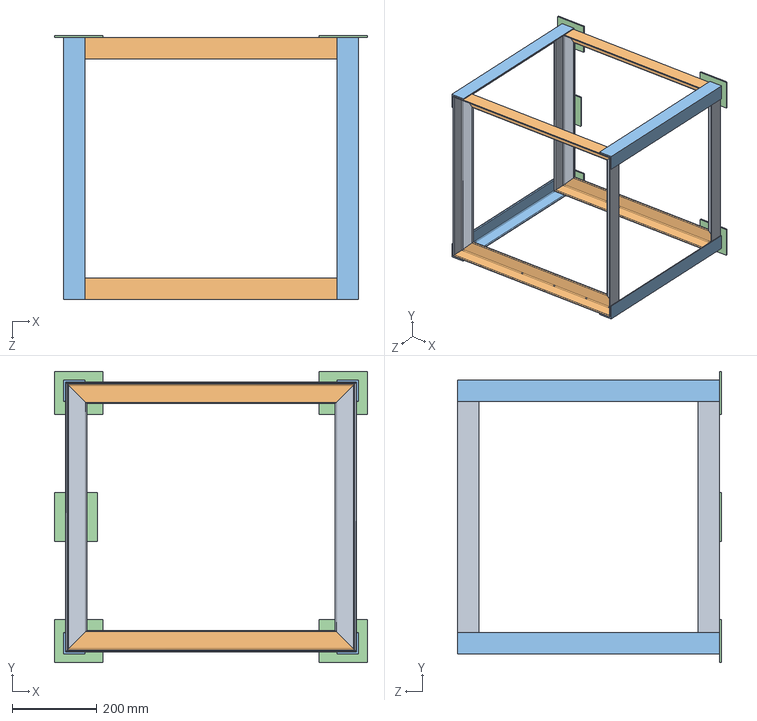
[picture p172: CAD file, 2026-10-29]
0Customer/UGS/Outsource/2103-000-200_Cart.STEP
736.6 x 685.8 x 621.4 mm
