MCBailey-CTS/0Library/0Customer/UGS/Gage Details/2103-000-180 Retractable Net Stop.SLDPRT

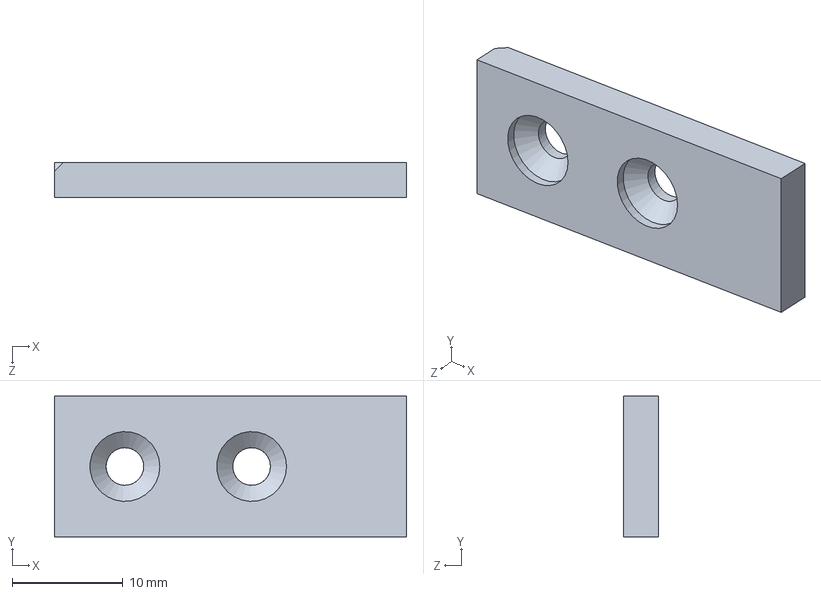
[picture p173: CAD file, 2026-10-29]
0Customer/UGS/Gage Details/2103-000-180 Retractable Net Stop.SLDPRT
31.8 x 12.7 x 3.17 mm
