MCBailey-CTS/0Library/0Customer/UGS/Gage Details/Asm & Pur Components/2103-000-101 Gage Handle.SLDPRT

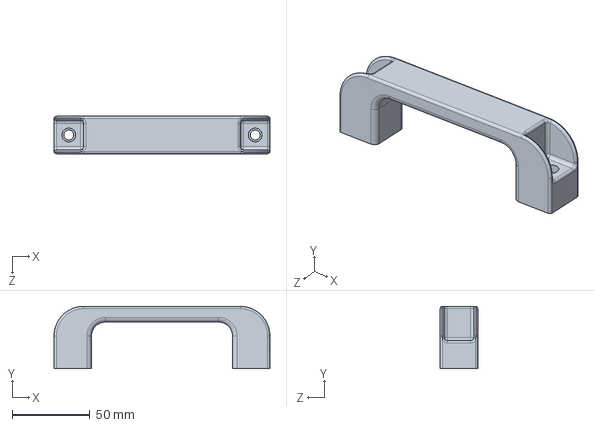
[picture p174: CAD file, 2026-10-29]
0Customer/UGS/Gage Details/Asm & Pur Components/2103-000-101 Gage Handle.SLDPRT
138.9 x 40.1 x 24.1 mm
