MCBailey-CTS/0Library/0Customer/UGS/Gage Details/Parts/2103-000_Gage Stock Holder.SLDPRT

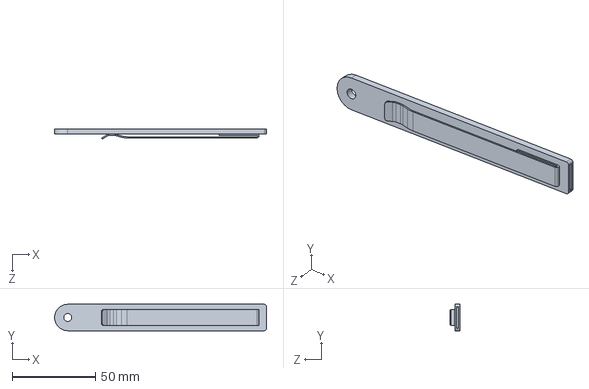
[picture p175: CAD file, 2026-10-29]
0Customer/UGS/Gage Details/Parts/2103-000_Gage Stock Holder.SLDPRT
127.0 x 15.9 x 6.24 mm
