MCBailey-CTS/0Library/0Customer/UGS/Outsource/2103-000-100_Base.STEP

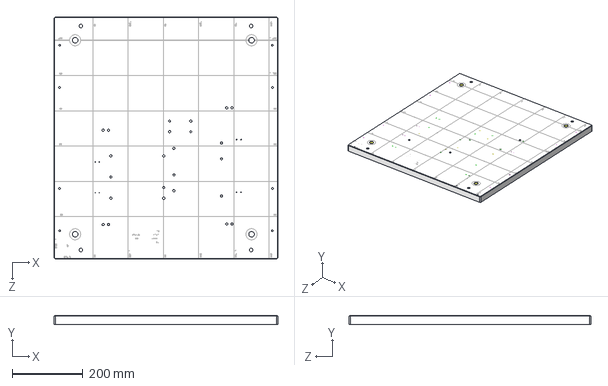
[picture p176: CAD file, 2026-10-29]
0Customer/UGS/Outsource/2103-000-100_Base.STEP
635.0 x 25.4 x 685.8 mm
