MCBailey-CTS/0Library/0Customer/UGS/Gage Details/2103-000-131 -B-, -C- GoNogo.SLDPRT

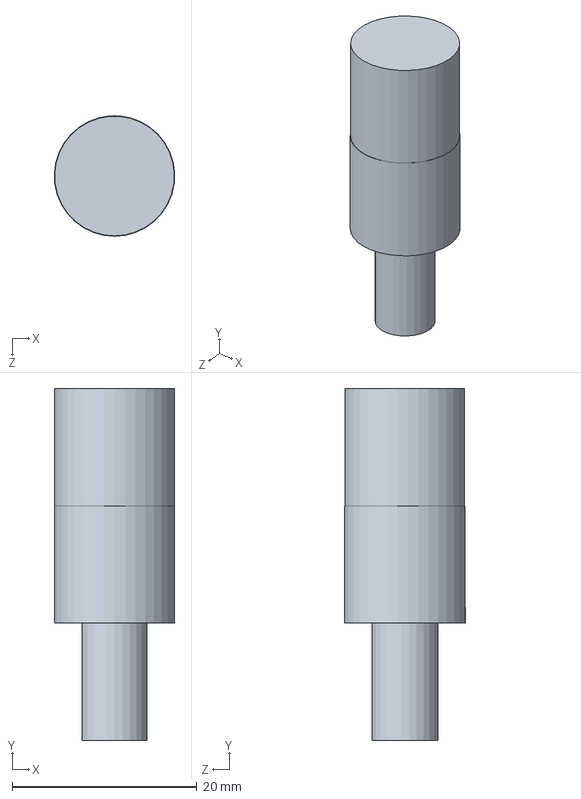
[picture p177: CAD file, 2026-10-29]
0Customer/UGS/Gage Details/2103-000-131 -B-, -C- GoNogo.SLDPRT
13.0 x 38.1 x 13.1 mm
