MCBailey-CTS/0Library/0Customer/UGS/Gage Details/Asm & Pur Components/2103-000-103 Setup Bushing.SLDPRT

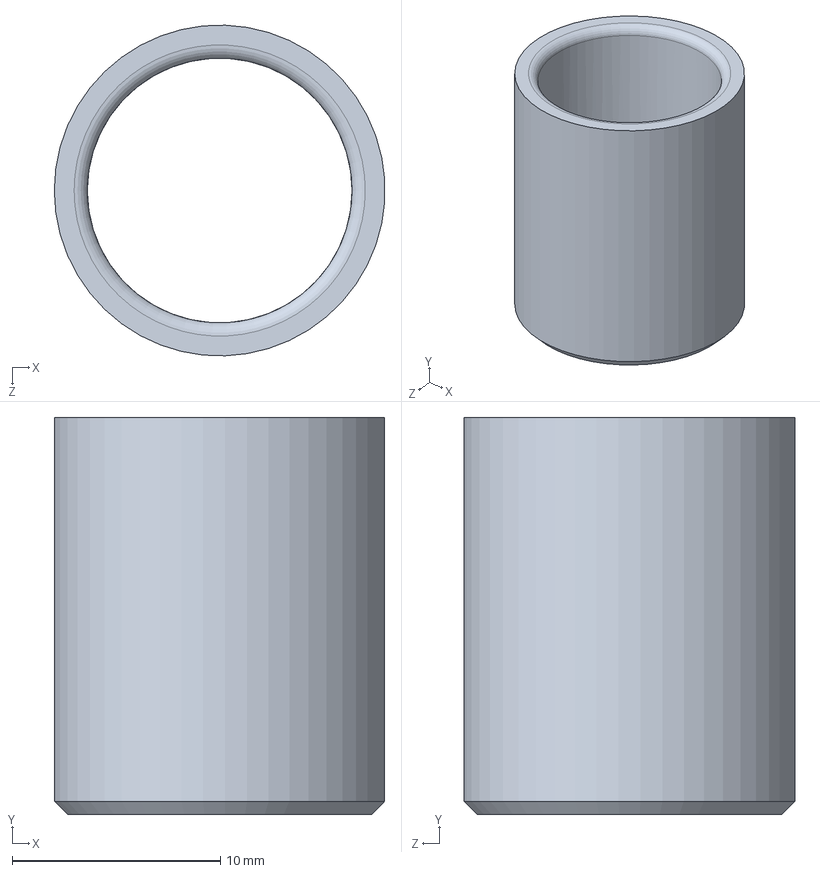
[picture p178: CAD file, 2026-10-29]
0Customer/UGS/Gage Details/Asm & Pur Components/2103-000-103 Setup Bushing.SLDPRT
15.9 x 19.1 x 15.9 mm
