MCBailey-CTS/0Library/0Customer/UGS/Gage Details/2103-000-172_Hinge-Riser.SLDPRT

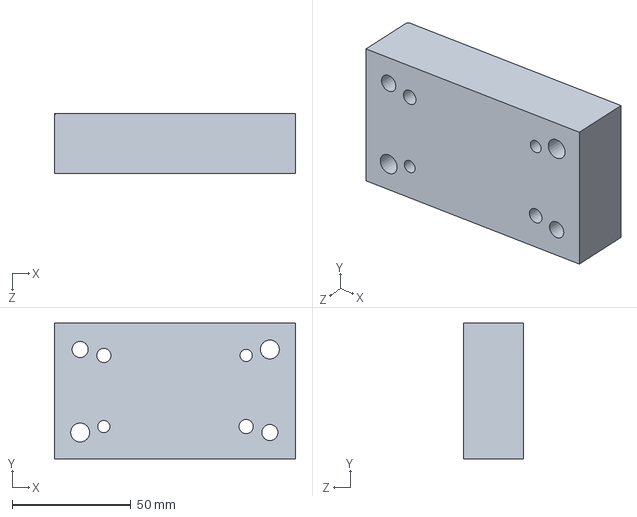
[picture p179: CAD file, 2026-10-29]
0Customer/UGS/Gage Details/2103-000-172_Hinge-Riser.SLDPRT
101.6 x 57.1 x 25.4 mm
