MCBailey-CTS/0Library/0Customer/UGS/Gage Details/2103-000-147 Stab #2.SLDPRT

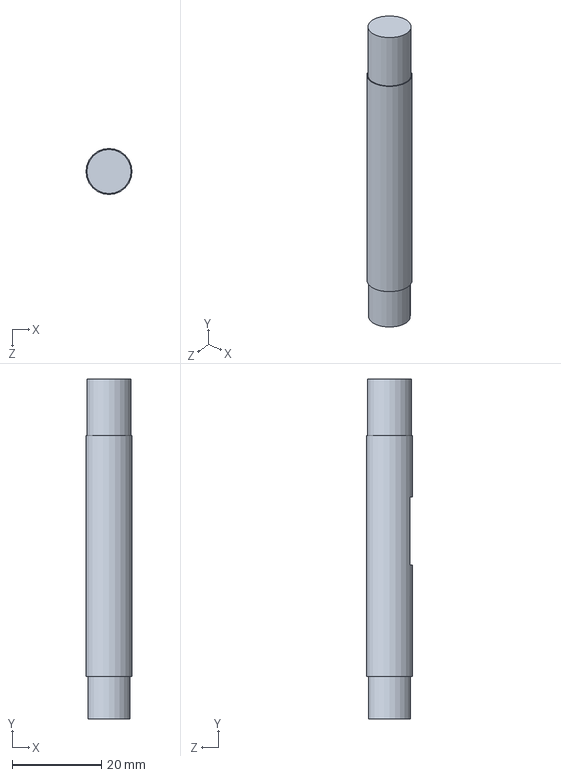
[picture p180: CAD file, 2026-10-29]
0Customer/UGS/Gage Details/2103-000-147 Stab #2.SLDPRT
10.3 x 76.2 x 10.3 mm
