MCBailey-CTS/0Library/0Customer/UGS/Gage Details/Asm & Pur Components/2103-000 'D' Straight Feeler.SLDPRT

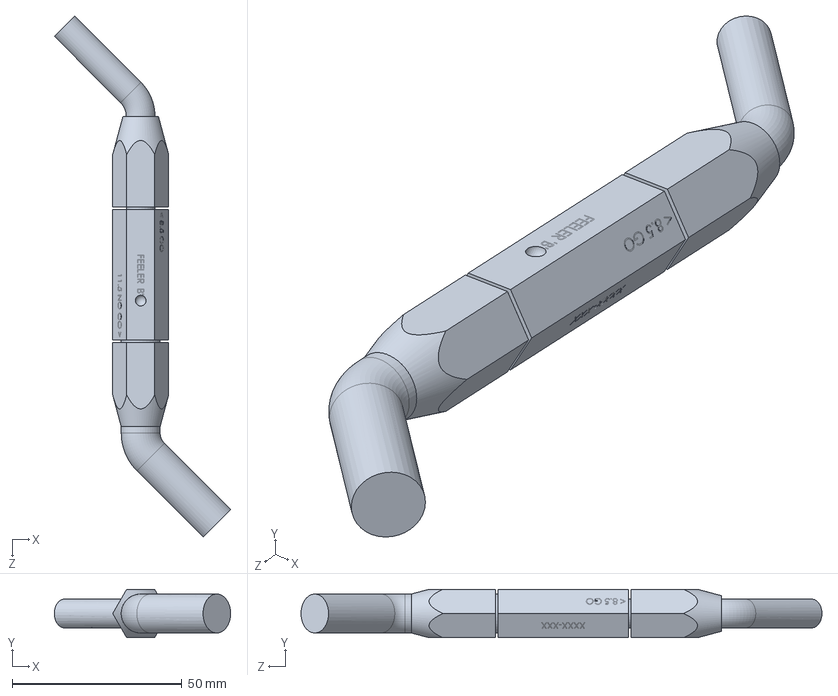
[picture p181: CAD file, 2026-10-29]
0Customer/UGS/Gage Details/Asm & Pur Components/2103-000 'D' Straight Feeler.SLDPRT
52.0 x 14.3 x 153.6 mm
