MCBailey-CTS/0Library/0Customer/UGS/Gage Details/2103-000-109 -B-, -C- MMC Locator.SLDPRT

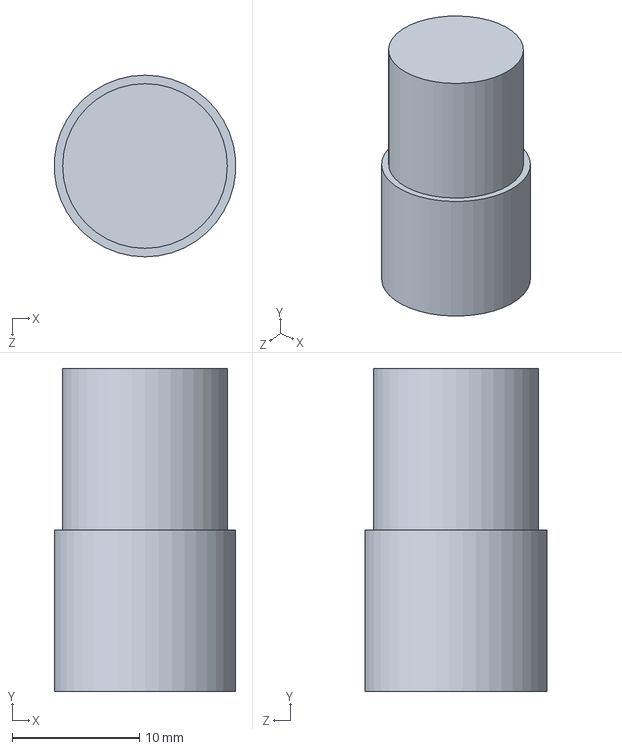
[picture p182: CAD file, 2026-10-29]
0Customer/UGS/Gage Details/2103-000-109 -B-, -C- MMC Locator.SLDPRT
14.2 x 25.4 x 14.3 mm
