MCBailey-CTS/0Library/0Customer/UGS/Gage Details/Asm & Pur Components/2103-000 6435K130_ONE-PIECE CLAMP-ON SHAFT COLLAR (1).SLDPRT

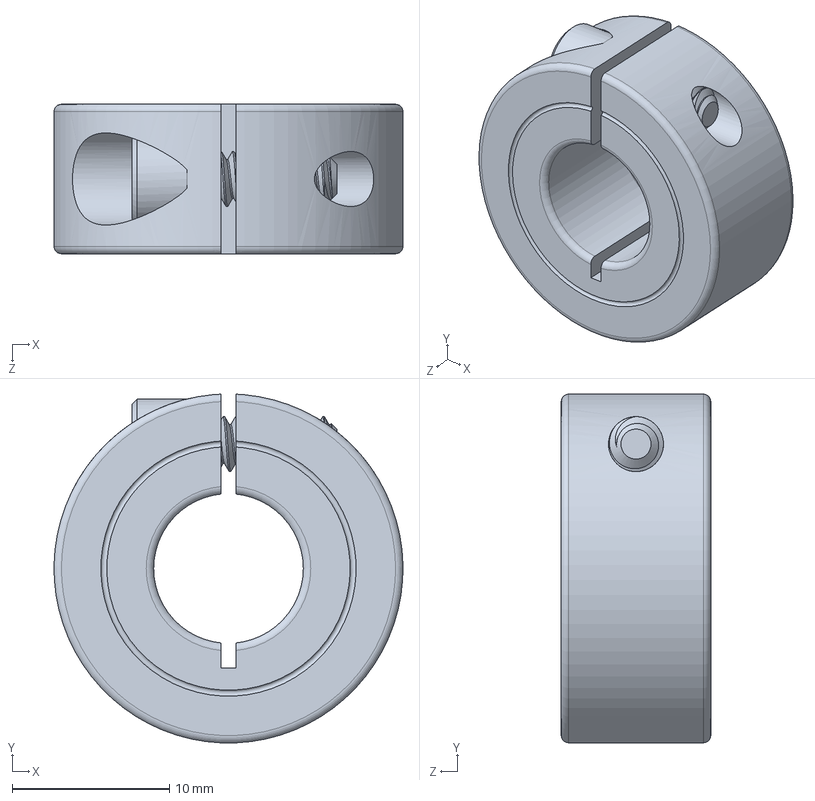
[picture p183: CAD file, 2026-10-29]
0Customer/UGS/Gage Details/Asm & Pur Components/2103-000 6435K130_ONE-PIECE CLAMP-ON SHAFT COLLAR (1).SLDPRT
22.2 x 22.2 x 9.53 mm
