MCBailey-CTS/0Library/0Customer/UGS/Gage Details/2103-000-171 Flush Gage 'C'.SLDPRT

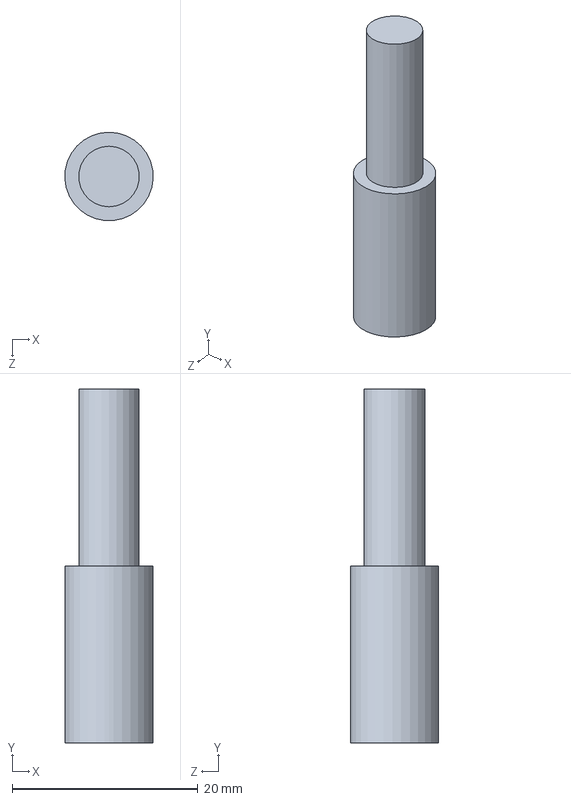
[picture p184: CAD file, 2026-10-29]
0Customer/UGS/Gage Details/2103-000-171 Flush Gage 'C'.SLDPRT
9.51 x 38.1 x 9.53 mm
