MCBailey-CTS/0Library/0Customer/UGS/Gage Details/Asm & Pur Components/2103-000 NEMA Box - Configurable (Bud Industries Inc).SLDPRT

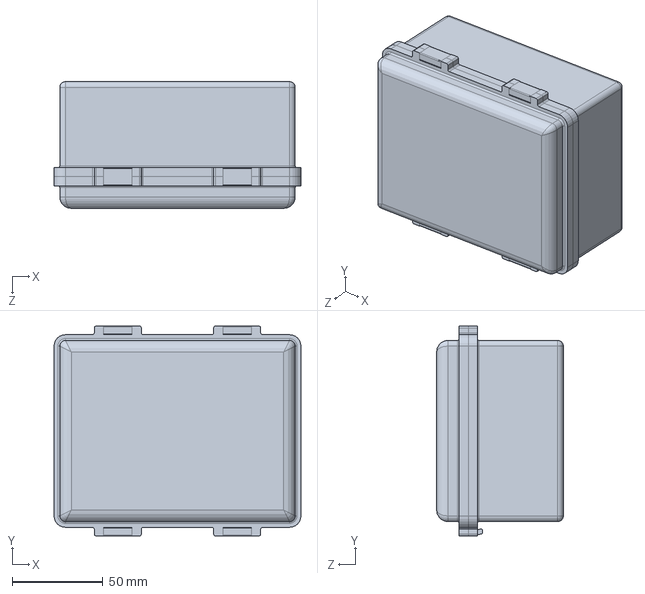
[picture p185: CAD file, 2026-10-29]
0Customer/UGS/Gage Details/Asm & Pur Components/2103-000 NEMA Box - Configurable (Bud Industries Inc).SLDPRT
136.4 x 115.9 x 70.0 mm
