MCBailey-CTS/0Library/0Customer/UGS/Gage Details/2103-000-145 Flush Gage 'B'.SLDPRT

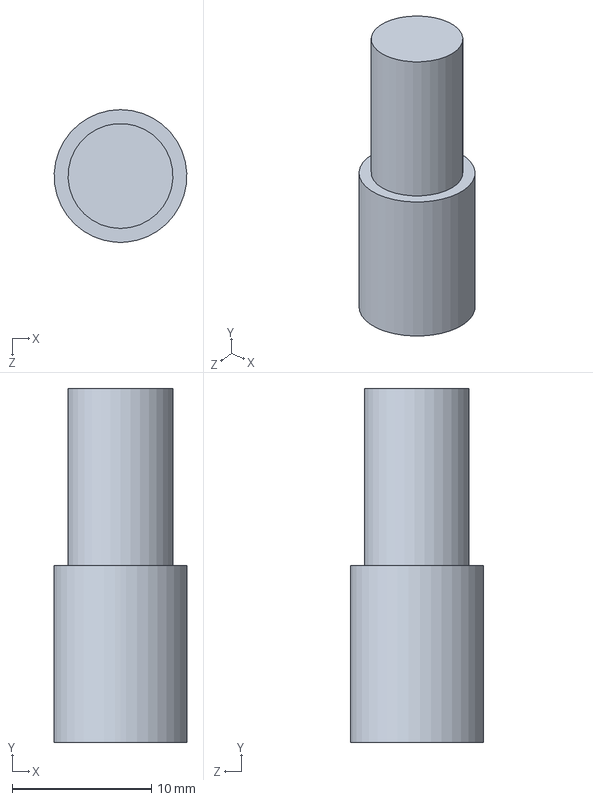
[picture p186: CAD file, 2026-10-29]
0Customer/UGS/Gage Details/2103-000-145 Flush Gage 'B'.SLDPRT
9.52 x 25.4 x 9.53 mm
