MCBailey-CTS/0Library/0Customer/UGS/Gage Details/2103-000-110 2002 Clamp Riser.SLDPRT

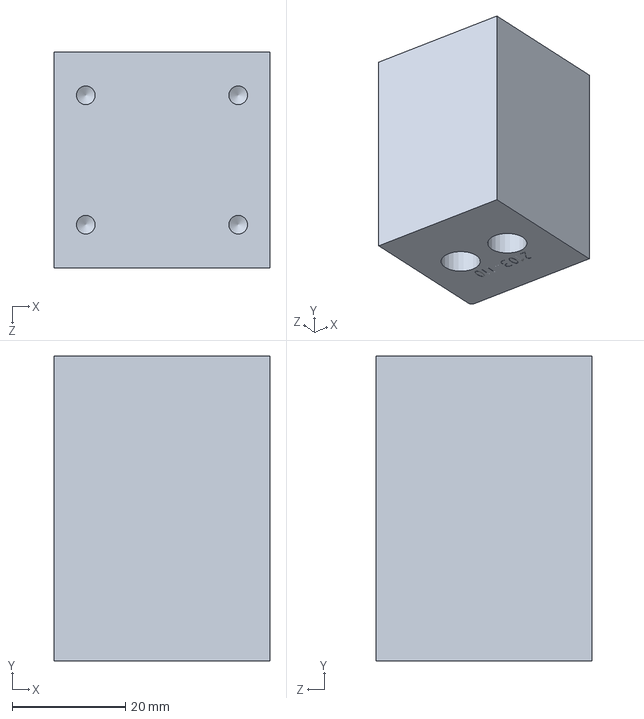
[picture p187: CAD file, 2026-10-29]
0Customer/UGS/Gage Details/2103-000-110 2002 Clamp Riser.SLDPRT
38.1 x 53.9 x 38.1 mm
