MCBailey-CTS/0Library/0Customer/UGS/Gage Details/Asm & Pur Components/2103-000 Colson 6 in. Floor Lock - (9.06045.6) - GLC.SLDPRT

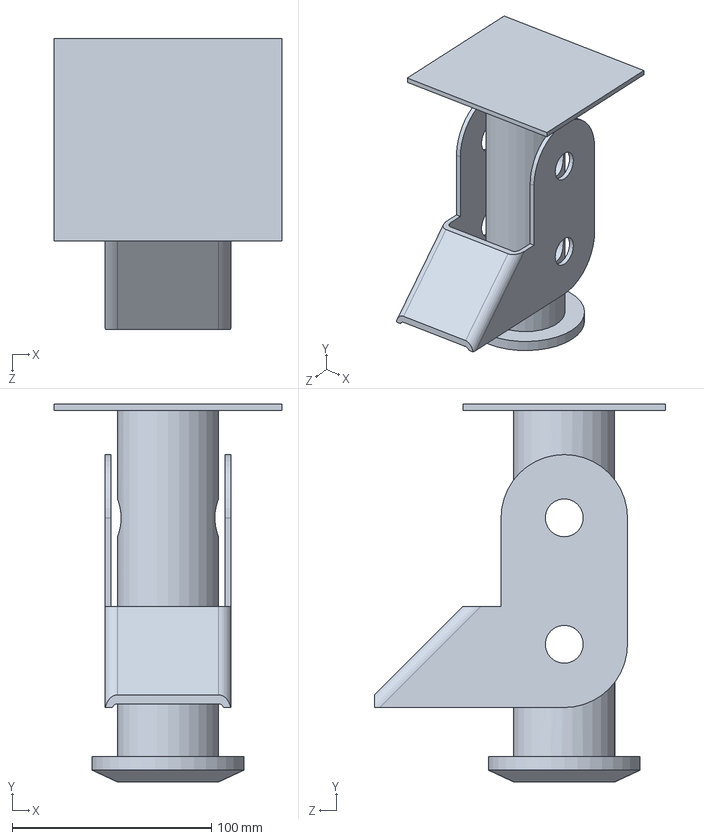
[picture p188: CAD file, 2026-10-29]
0Customer/UGS/Gage Details/Asm & Pur Components/2103-000 Colson 6 in. Floor Lock - (9.06045.6) - GLC.SLDPRT
114.3 x 189.8 x 146.1 mm
