MCBailey-CTS/0Library/0Customer/UGS/Gage Details/2130-000-122 Key.SLDPRT

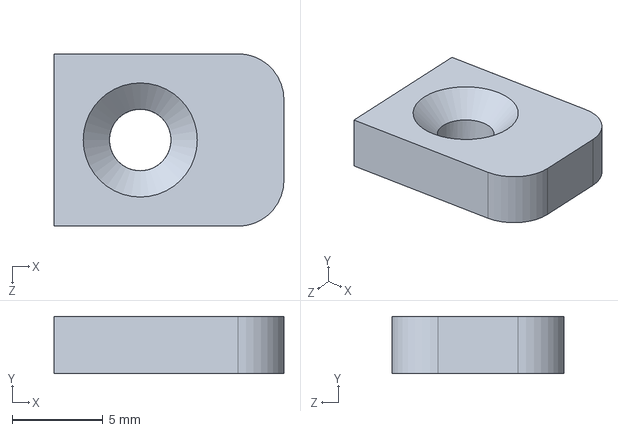
[picture p189: CAD file, 2026-10-29]
0Customer/UGS/Gage Details/2130-000-122 Key.SLDPRT
12.7 x 3.17 x 9.53 mm
