MCBailey-CTS/0Library/0Customer/UGS/Gage Details/Asm & Pur Components/2103-000 UGS Tag.SLDPRT

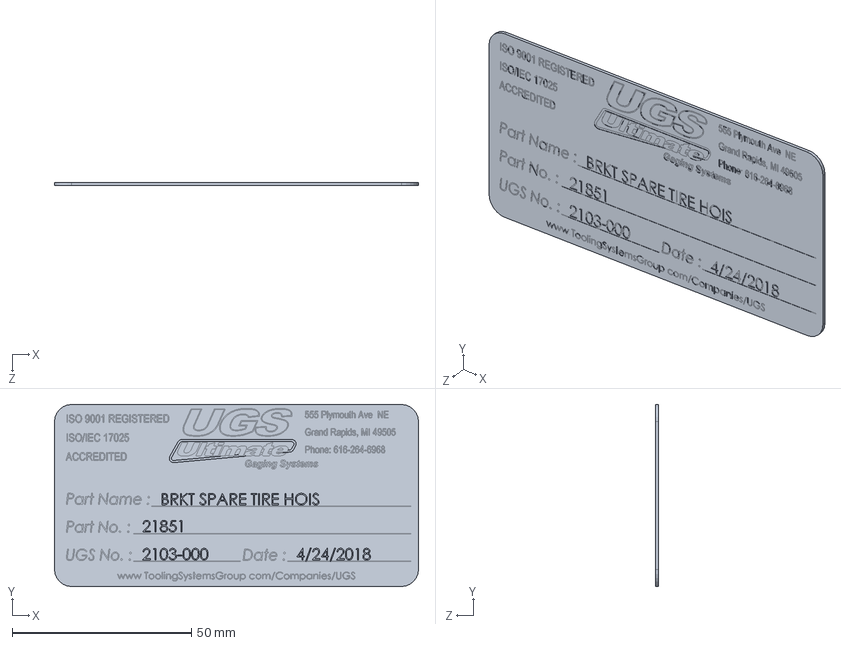
[picture p190: CAD file, 2026-10-29]
0Customer/UGS/Gage Details/Asm & Pur Components/2103-000 UGS Tag.SLDPRT
101.6 x 50.8 x 0.813 mm
