MCBailey-CTS/0Library/0Customer/UGS/Gage Details/2103-000-140 Stab #1.SLDPRT

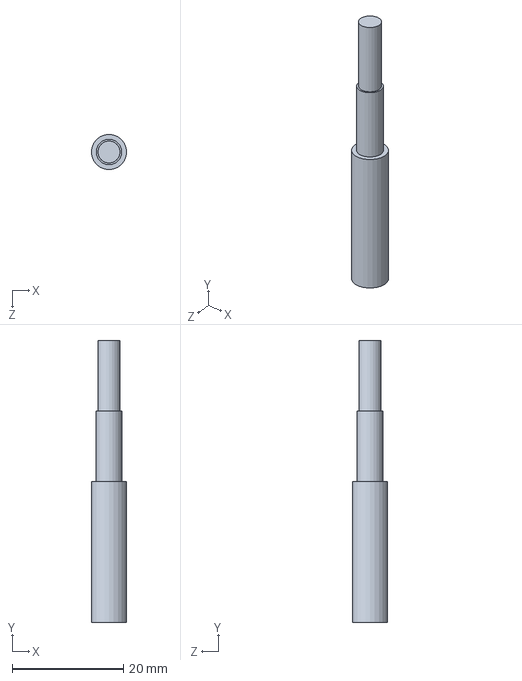
[picture p191: CAD file, 2026-10-29]
0Customer/UGS/Gage Details/2103-000-140 Stab #1.SLDPRT
6.35 x 50.8 x 6.35 mm
