MCBailey-CTS/0Library/0Customer/UGS/Gage Details/2103-000-170 Formex Base Foot.SLDPRT

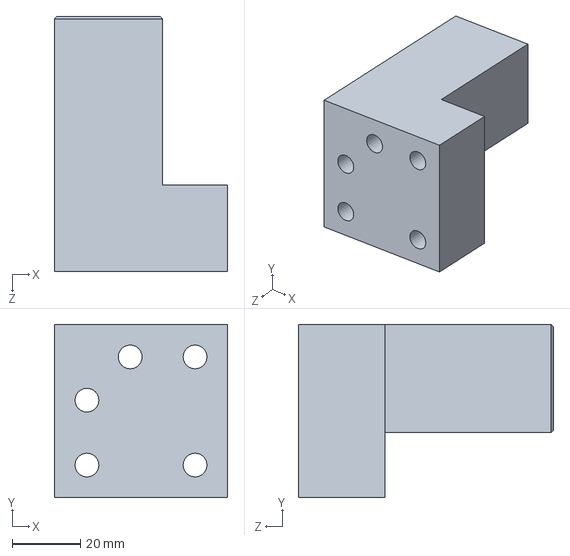
[picture p192: CAD file, 2026-10-29]
0Customer/UGS/Gage Details/2103-000-170 Formex Base Foot.SLDPRT
50.8 x 50.8 x 75.0 mm
