MCBailey-CTS/0Library/0Customer/UGS/Gage Details/2103-000-136 Pin Holder.SLDPRT

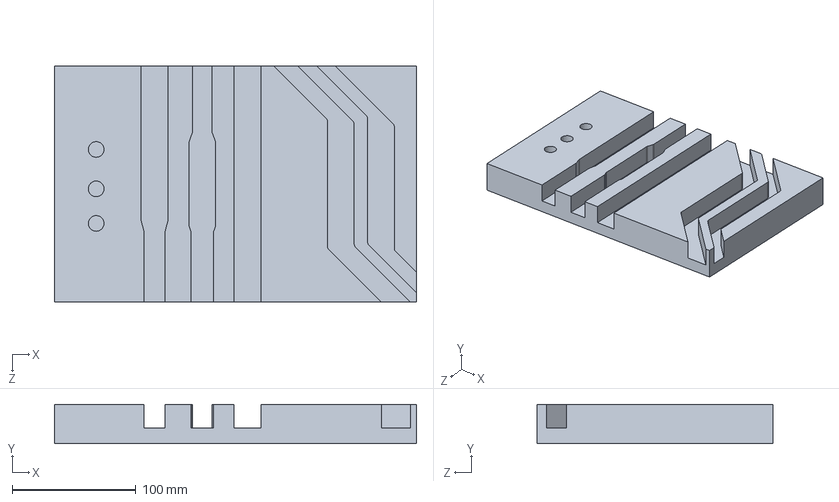
[picture p193: CAD file, 2026-10-29]
0Customer/UGS/Gage Details/2103-000-136 Pin Holder.SLDPRT
292.1 x 31.8 x 190.5 mm
