MCBailey-CTS/0Library/0Customer/UGS/Gage Details/Asm & Pur Components/2103-000 Colson 6 in. Swivel Phen. Caster - (4.06109.339) - GLC.SLDPRT

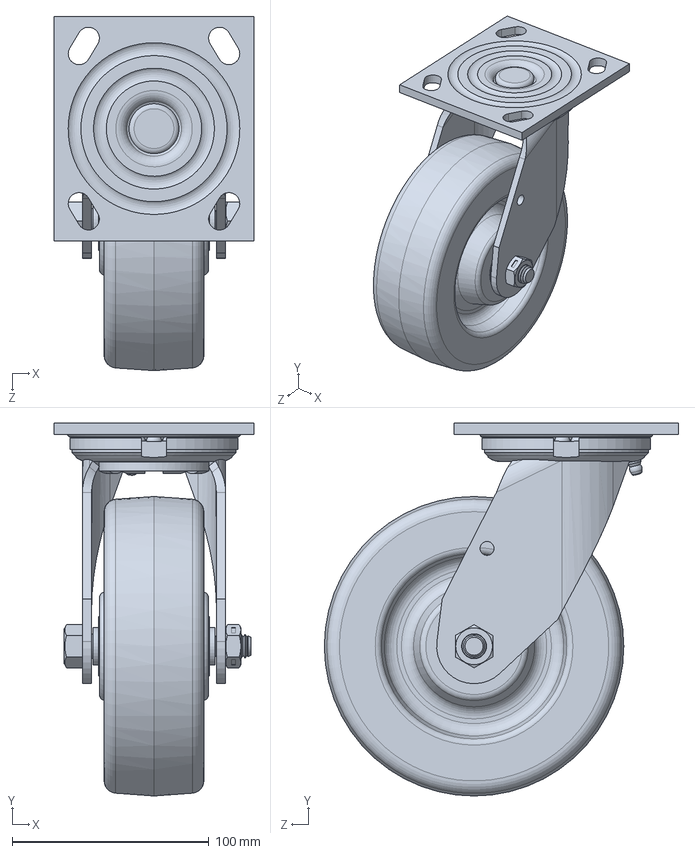
[picture p194: CAD file, 2026-10-29]
0Customer/UGS/Gage Details/Asm & Pur Components/2103-000 Colson 6 in. Swivel Phen. Caster - (4.06109.339) - GLC.SLDPRT
101.6 x 189.8 x 180.3 mm
