MCBailey-CTS/0Library/0Customer/UGS/Gage Details/Asm & Pur Components/2103-000 Retractable -A- Net Bushing.SLDPRT

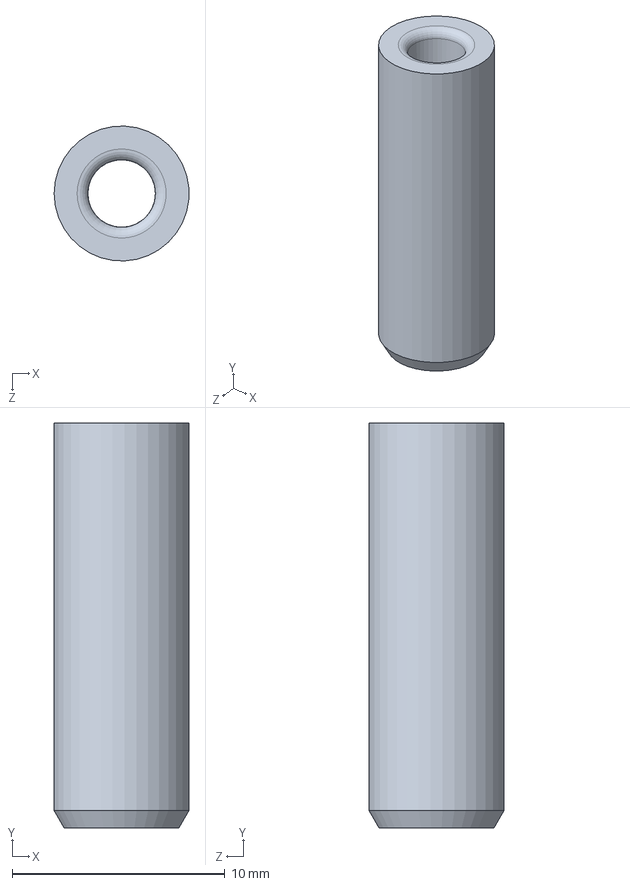
[picture p195: CAD file, 2026-10-29]
0Customer/UGS/Gage Details/Asm & Pur Components/2103-000 Retractable -A- Net Bushing.SLDPRT
6.34 x 19.1 x 6.34 mm
