MCBailey-CTS/0Library/0Customer/UGS/Gage Details/Asm & Pur Components/2103-000 Colson 6 in. Rigid Phen. Caster - (4.06108.339) - GLC.SLDPRT

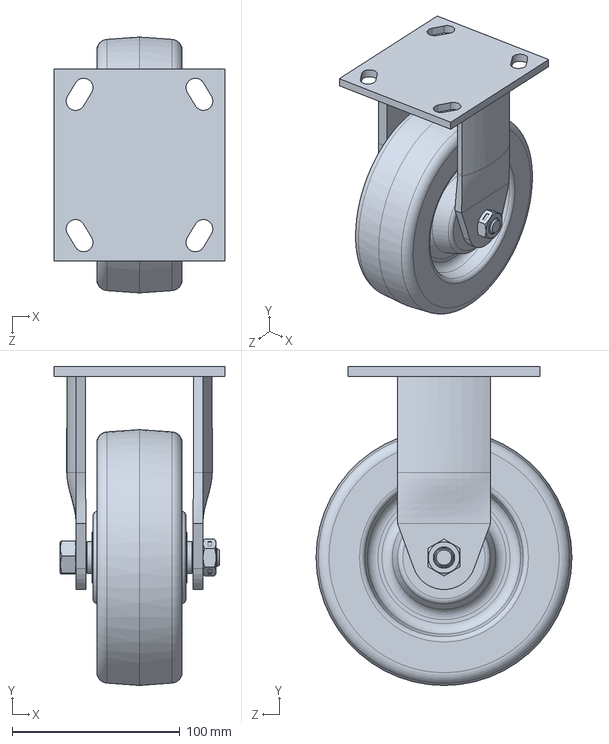
[picture p196: CAD file, 2026-10-29]
0Customer/UGS/Gage Details/Asm & Pur Components/2103-000 Colson 6 in. Rigid Phen. Caster - (4.06108.339) - GLC.SLDPRT
101.6 x 190.0 x 152.4 mm
