MCBailey-CTS/0Library/0Customer/UGS/Gage Details/2103-000-113 1 Clamp Ext.SLDPRT

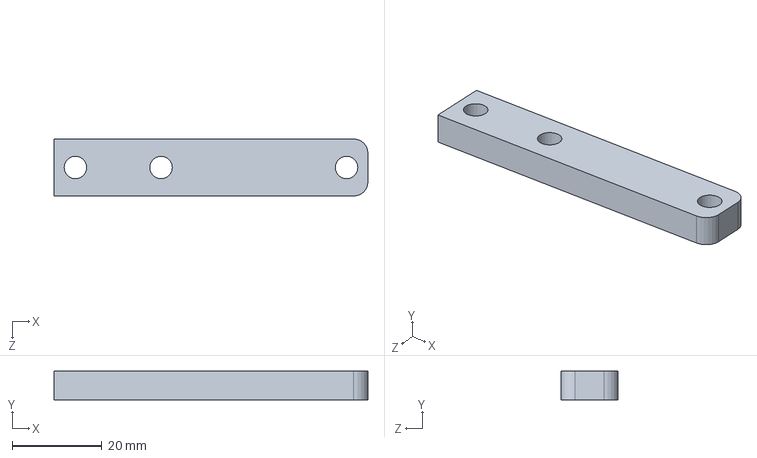
[picture p197: CAD file, 2026-10-29]
0Customer/UGS/Gage Details/2103-000-113 1 Clamp Ext.SLDPRT
69.8 x 6.35 x 12.7 mm
