MCBailey-CTS/0Library/0Customer/UGS/Gage Details/2103-000-148 Stab #1 GoNogo.SLDPRT

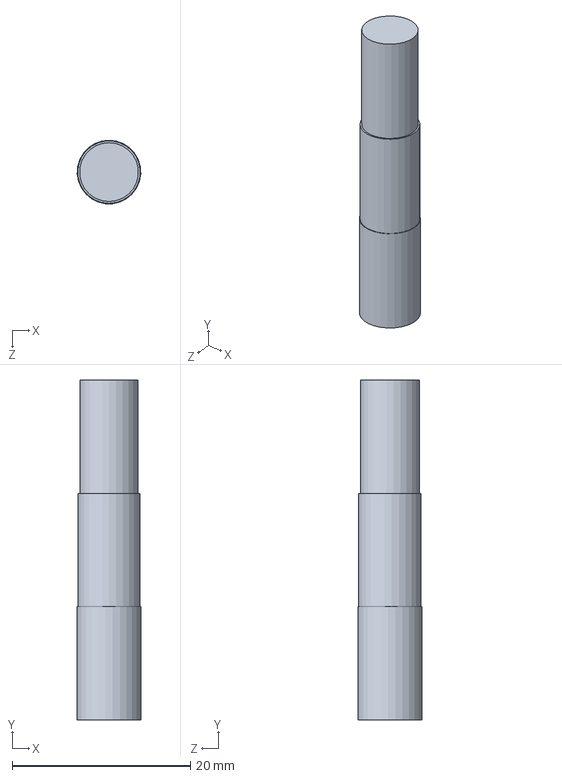
[picture p198: CAD file, 2026-10-29]
0Customer/UGS/Gage Details/2103-000-148 Stab #1 GoNogo.SLDPRT
7.13 x 38.1 x 7.12 mm
