MCBailey-CTS/0Library/0Customer/UGS/Gage Details/2103-000-168 Retractable A3, A4.SLDPRT

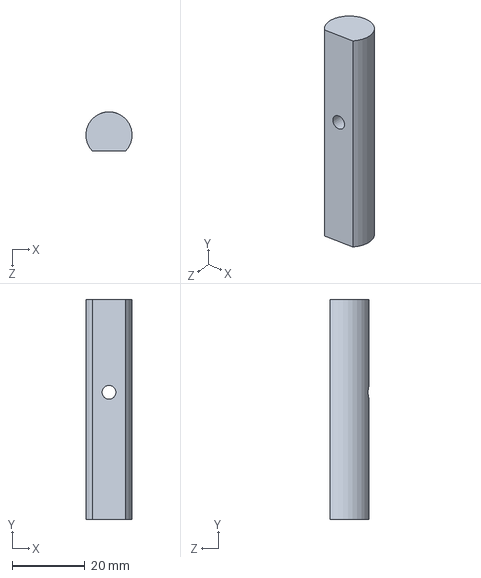
[picture p199: CAD file, 2026-10-29]
0Customer/UGS/Gage Details/2103-000-168 Retractable A3, A4.SLDPRT
12.7 x 60.3 x 10.8 mm
