MCBailey-CTS/0Library/0Customer/UGS/Gage Details/2103-000-149 Stab #2 GoNogo.SLDPRT

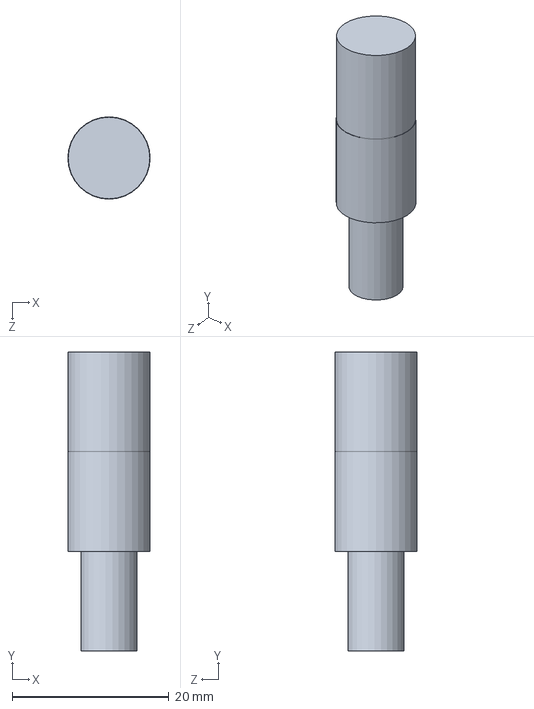
[picture p200: CAD file, 2026-10-29]
0Customer/UGS/Gage Details/2103-000-149 Stab #2 GoNogo.SLDPRT
10.5 x 38.1 x 10.5 mm
