MCBailey-CTS/0Library/0Customer/UGS/Gage Details/Asm & Pur Components/2103-000 Destaco TC-2002_U.SLDPRT

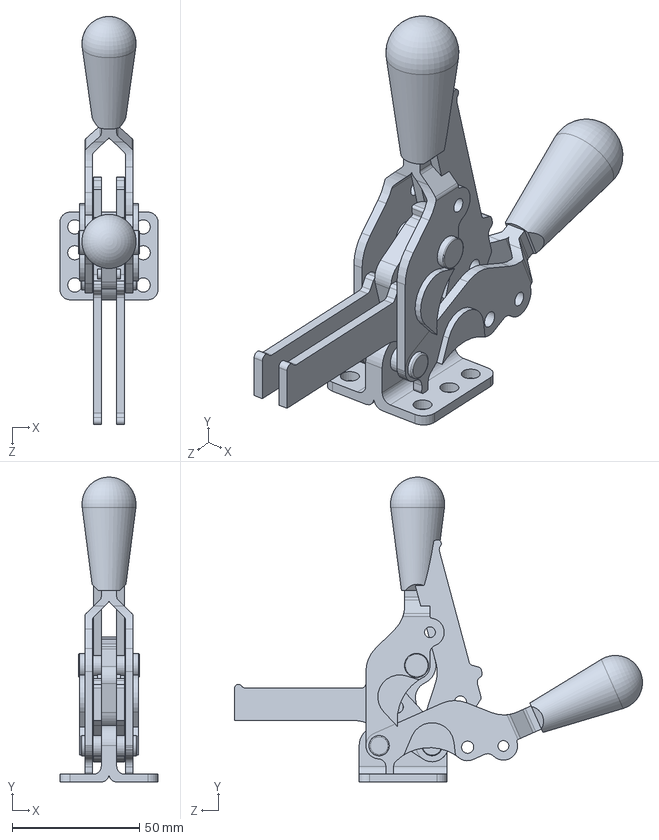
[picture p201: CAD file, 2026-10-29]
0Customer/UGS/Gage Details/Asm & Pur Components/2103-000 Destaco TC-2002_U.SLDPRT
38.6 x 119.9 x 160.5 mm
