MCBailey-CTS/0Library/0Customer/UGS/Gage Details/2103-000-112 1 2002 Clamp Riser.SLDPRT

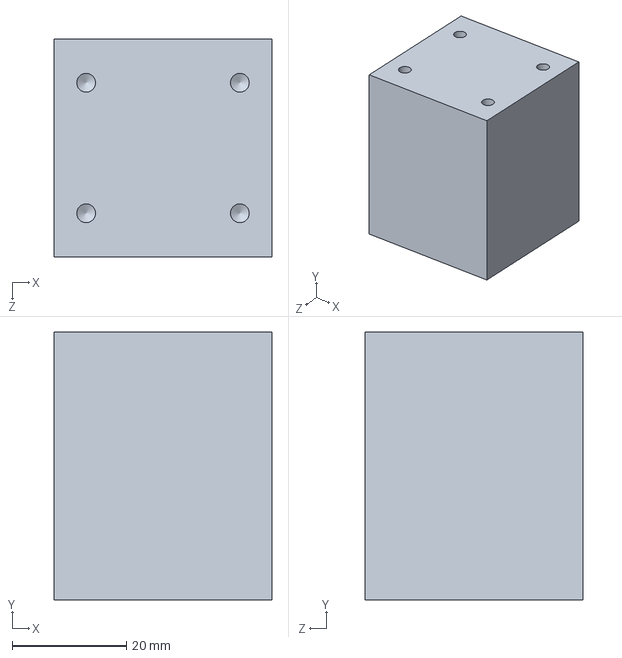
[picture p202: CAD file, 2026-10-29]
0Customer/UGS/Gage Details/2103-000-112 1 2002 Clamp Riser.SLDPRT
38.1 x 46.9 x 38.1 mm
