MCBailey-CTS/0Library/0Customer/UGS/Gage Details/2103-000-123 Stab Block.SLDPRT

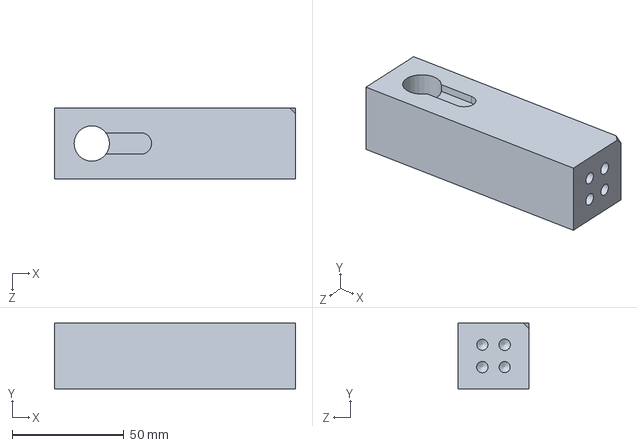
[picture p203: CAD file, 2026-10-29]
0Customer/UGS/Gage Details/2103-000-123 Stab Block.SLDPRT
108.0 x 29.5 x 31.8 mm
