MCBailey-CTS/0Library/0Customer/UGS/Gage Details/Asm & Pur Components/2103-000 Tooling Bushing Tag.SLDPRT

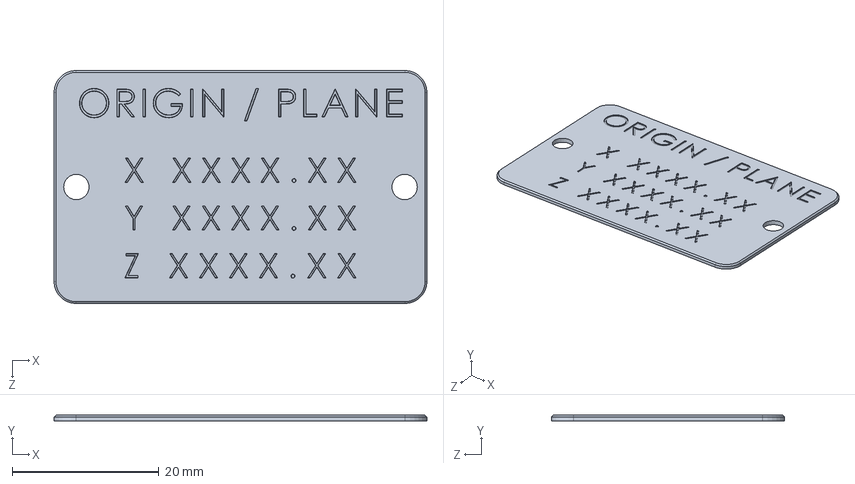
[picture p204: CAD file, 2026-10-29]
0Customer/UGS/Gage Details/Asm & Pur Components/2103-000 Tooling Bushing Tag.SLDPRT
50.8 x 0.762 x 31.8 mm
