MCBailey-CTS/0Library/0Customer/UGS/Gage Details/Asm & Pur Components/2103-000  Stab Bushing 1.SLDPRT

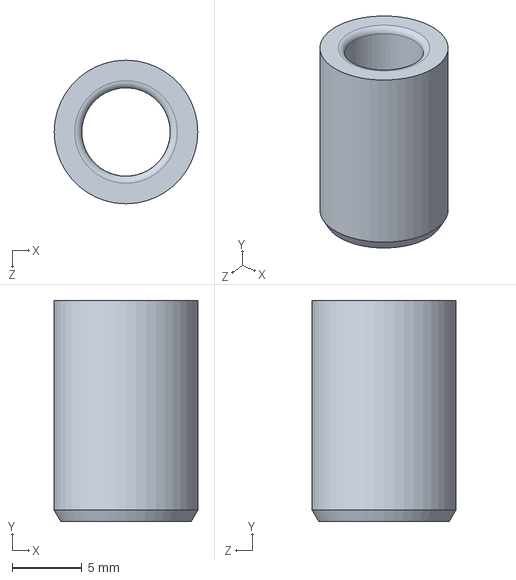
[picture p205: CAD file, 2026-10-29]
0Customer/UGS/Gage Details/Asm & Pur Components/2103-000 Stab Bushing 1.SLDPRT
10.3 x 15.9 x 10.3 mm
