MCBailey-CTS/0Library/0Customer/UGS/Gage Details/Asm & Pur Components/2103-000 Ball Feeler 'A'.SLDPRT

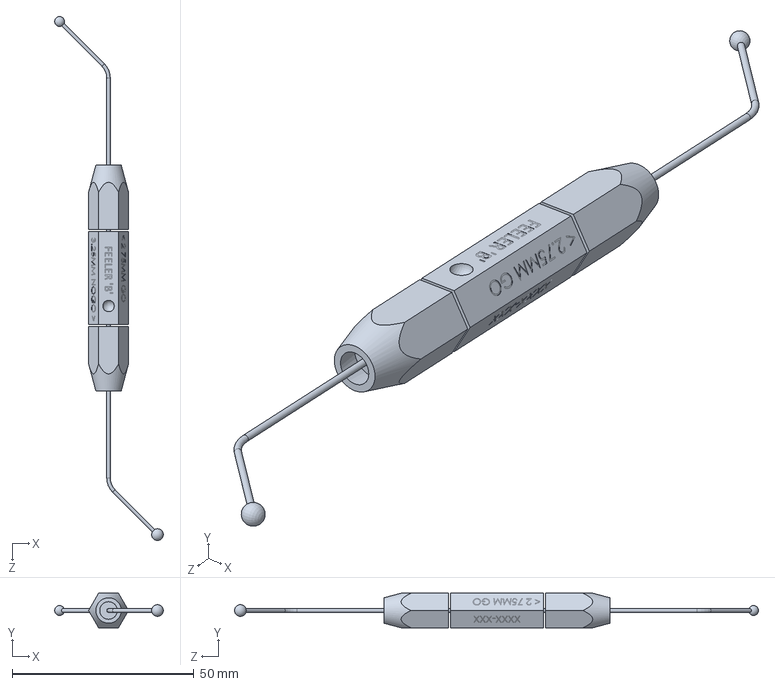
[picture p206: CAD file, 2026-10-29]
0Customer/UGS/Gage Details/Asm & Pur Components/2103-000 Ball Feeler 'A'.SLDPRT
29.9 x 9.53 x 144.2 mm
