MCBailey-CTS/0Library/0Customer/UGS/Gage Details/Asm & Pur Components/2103-000 3WSE HANDLE.SLDPRT

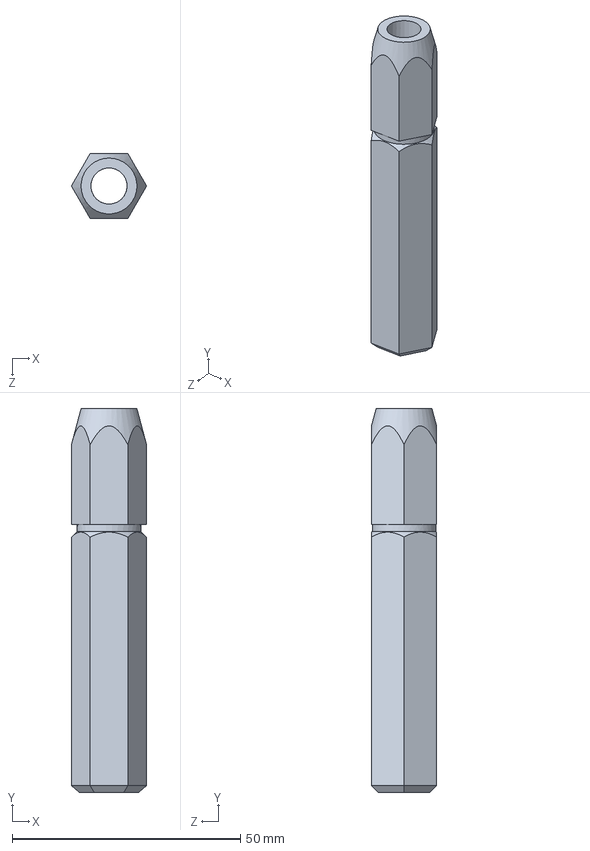
[picture p207: CAD file, 2026-10-29]
0Customer/UGS/Gage Details/Asm & Pur Components/2103-000 3WSE HANDLE.SLDPRT
16.5 x 84.1 x 14.3 mm
