MCBailey-CTS/0Library/(list of files, cad)

Other CAD files:
0Customer/UGS/Sample Design/2103-000 Model BRKT Spare Tire Hoist_Pn 181264.STEP
0Customer/UGS/Sample Design/NX/2103-000 Model BRKT Spare Tire Hoist_Pn 181264.stp
TsgComponents/StandardGuards/TSG-SINGLE-TAB.dwg
TsgComponents/StandardGuards/TSG-FOOTED-GUARD.dwg
TsgComponents/StandardGuards/TSG-DOUBLE-TAB.dwg
0Customer/UGS/Gage Details/Asm & Pur Components/2103-000 Angle Cart Weldment_2017Oct02.SLDPRT
0Customer/UGS/Gage Details/Asm & Pur Components/2103-000 'B' Straight Feeler.SLDPRT
0Customer/UGS/Gage Details/2103-000-181 Retractor Stop Block.SLDPRT
0Customer/UGS/Gage Details/2103-000-111 Clamp Ext.SLDPRT
0Customer/UGS/Gage Details/2103-000-167 Retractable A1, A2.SLDPRT
0Customer/UGS/Gage Details/Asm & Pur Components/2103-000 1 Destaco TC-2002_U.SLDPRT
0Customer/UGS/Gage Details/Asm & Pur Components/2103-000 Bushing.SLDPRT
0Customer/UGS/Gage Details/Asm & Pur Components/2103-000 3WDE HANDLE.SLDPRT
0Customer/UGS/Gage Details/Asm & Pur Components/2103-000-100 Base Plate With Bushings for Single Part.SLDPRT
0Customer/Enterprise Tool and Die/Fasteners/English/SocketHeadCapScrews/0250/0250-shcs-037_etd.prt
0Customer/Enterprise Tool and Die/Fasteners/English/SocketHeadCapScrews/0250/0250-shcs-050_etd.prt
0Customer/Enterprise Tool and Die/Fasteners/English/SocketHeadCapScrews/0250/0250-shcs-062_etd.prt
0Customer/Enterprise Tool and Die/Fasteners/English/SocketHeadCapScrews/0250/0250-shcs-075_etd.prt
0Customer/Enterprise Tool and Die/Fasteners/English/SocketHeadCapScrews/0250/0250-shcs-100_etd.prt
0Customer/Enterprise Tool and Die/Fasteners/English/SocketHeadCapScrews/0250/0250-shcs-125_etd.prt
0Customer/Enterprise Tool and Die/Fasteners/English/SocketHeadCapScrews/0250/0250-shcs-150_etd.prt
0Customer/Enterprise Tool and Die/Fasteners/English/SocketHeadCapScrews/0250/0250-shcs-175_etd.prt
0Customer/Enterprise Tool and Die/Fasteners/English/SocketHeadCapScrews/0250/0250-shcs-200_etd.prt
0Customer/Enterprise Tool and Die/Fasteners/English/SocketHeadCapScrews/0250/0250-shcs-225_etd.prt
0Customer/Enterprise Tool and Die/Fasteners/English/SocketHeadCapScrews/0250/0250-shcs-250_etd.prt
0Customer/Enterprise Tool and Die/Fasteners/English/SocketHeadCapScrews/0250/0250-shcs-275_etd.prt
0Customer/Enterprise Tool and Die/Fasteners/English/SocketHeadCapScrews/0250/0250-shcs-300_etd.prt
0Customer/Enterprise Tool and Die/Fasteners/English/SocketHeadCapScrews/0250/0250-shcs-325_etd.prt
0Customer/Enterprise Tool and Die/Fasteners/English/SocketHeadCapScrews/0250/0250-shcs-350_etd.prt
0Customer/Enterprise Tool and Die/Fasteners/English/SocketHeadCapScrews/0250/0250-shcs-400_etd.prt
0Customer/Enterprise Tool and Die/Fasteners/English/SocketHeadCapScrews/0250/0250-shcs-450_etd.prt
0Customer/Enterprise Tool and Die/Fasteners/English/SocketHeadCapScrews/0250/0250-shcs-500_etd.prt
0Customer/Enterprise Tool and Die/Fasteners/English/SocketHeadCapScrews/0313/0313-shcs-050_etd.prt
0Customer/Enterprise Tool and Die/Fasteners/English/SocketHeadCapScrews/0313/0313-shcs-062_etd.prt
0Customer/Enterprise Tool and Die/Fasteners/English/SocketHeadCapScrews/0313/0313-shcs-075_etd.prt
0Customer/Enterprise Tool and Die/Fasteners/English/SocketHeadCapScrews/0313/0313-shcs-100_etd.prt
0Customer/Enterprise Tool and Die/Fasteners/English/SocketHeadCapScrews/0313/0313-shcs-125_etd.prt
0Customer/Enterprise Tool and Die/Fasteners/English/SocketHeadCapScrews/0313/0313-shcs-150_etd.prt
0Customer/Enterprise Tool and Die/Fasteners/English/SocketHeadCapScrews/0313/0313-shcs-175_etd.prt
0Customer/Enterprise Tool and Die/Fasteners/English/SocketHeadCapScrews/0313/0313-shcs-200_etd.prt
0Customer/Enterprise Tool and Die/Fasteners/English/SocketHeadCapScrews/0313/0313-shcs-225_etd.prt
0Customer/Enterprise Tool and Die/Fasteners/English/SocketHeadCapScrews/0313/0313-shcs-250_etd.prt
0Customer/Enterprise Tool and Die/Fasteners/English/SocketHeadCapScrews/0313/0313-shcs-275_etd.prt
0Customer/Enterprise Tool and Die/Fasteners/English/SocketHeadCapScrews/0313/0313-shcs-300_etd.prt
0Customer/Enterprise Tool and Die/Fasteners/English/SocketHeadCapScrews/0313/0313-shcs-325_etd.prt
0Customer/Enterprise Tool and Die/Fasteners/English/SocketHeadCapScrews/0313/0313-shcs-350_etd.prt
0Customer/Enterprise Tool and Die/Fasteners/English/SocketHeadCapScrews/0313/0313-shcs-400_etd.prt
0Customer/Enterprise Tool and Die/Fasteners/English/SocketHeadCapScrews/0313/0313-shcs-450_etd.prt
0Customer/Enterprise Tool and Die/Fasteners/English/SocketHeadCapScrews/0313/0313-shcs-500_etd.prt
0Customer/Enterprise Tool and Die/Fasteners/English/SocketHeadCapScrews/0375/0375-shcs-062_etd.prt
0Customer/Enterprise Tool and Die/Fasteners/English/SocketHeadCapScrews/0375/0375-shcs-075_etd.prt
0Customer/Enterprise Tool and Die/Fasteners/English/SocketHeadCapScrews/0375/0375-shcs-100_etd.prt
0Customer/Enterprise Tool and Die/Fasteners/English/SocketHeadCapScrews/0375/0375-shcs-125_etd.prt
0Customer/Enterprise Tool and Die/Fasteners/English/SocketHeadCapScrews/0375/0375-shcs-150_etd.prt
0Customer/Enterprise Tool and Die/Fasteners/English/SocketHeadCapScrews/0375/0375-shcs-175_etd.prt
0Customer/Enterprise Tool and Die/Fasteners/English/SocketHeadCapScrews/0375/0375-shcs-200_etd.prt
0Customer/Enterprise Tool and Die/Fasteners/English/SocketHeadCapScrews/0375/0375-shcs-225_etd.prt
0Customer/Enterprise Tool and Die/Fasteners/English/SocketHeadCapScrews/0375/0375-shcs-250_etd.prt
0Customer/Enterprise Tool and Die/Fasteners/English/SocketHeadCapScrews/0375/0375-shcs-275_etd.prt
0Customer/Enterprise Tool and Die/Fasteners/English/SocketHeadCapScrews/0375/0375-shcs-300_etd.prt
0Customer/Enterprise Tool and Die/Fasteners/English/SocketHeadCapScrews/0375/0375-shcs-325_etd.prt
0Customer/Enterprise Tool and Die/Fasteners/English/SocketHeadCapScrews/0375/0375-shcs-350_etd.prt
0Customer/Enterprise Tool and Die/Fasteners/English/SocketHeadCapScrews/0375/0375-shcs-375_etd.prt
0Customer/Enterprise Tool and Die/Fasteners/English/SocketHeadCapScrews/0375/0375-shcs-400_etd.prt
0Customer/Enterprise Tool and Die/Fasteners/English/SocketHeadCapScrews/0375/0375-shcs-450_etd.prt
0Customer/Enterprise Tool and Die/Fasteners/English/SocketHeadCapScrews/0375/0375-shcs-500_etd.prt
0Customer/Enterprise Tool and Die/Fasteners/English/SocketHeadCapScrews/0375/0375-shcs-550_etd.prt
0Customer/Enterprise Tool and Die/Fasteners/English/SocketHeadCapScrews/0375/0375-shcs-600_etd.prt
0Customer/Enterprise Tool and Die/Fasteners/English/SocketHeadCapScrews/0500/0500-shcs-075_etd.prt
0Customer/Enterprise Tool and Die/Fasteners/English/SocketHeadCapScrews/0500/0500-shcs-100_etd.prt
0Customer/Enterprise Tool and Die/Fasteners/English/SocketHeadCapScrews/0500/0500-shcs-125_etd.prt
0Customer/Enterprise Tool and Die/Fasteners/English/SocketHeadCapScrews/0500/0500-shcs-150_etd.prt
0Customer/Enterprise Tool and Die/Fasteners/English/SocketHeadCapScrews/0500/0500-shcs-175_etd.prt
0Customer/Enterprise Tool and Die/Fasteners/English/SocketHeadCapScrews/0500/0500-shcs-200_etd.prt
0Customer/Enterprise Tool and Die/Fasteners/English/SocketHeadCapScrews/0500/0500-shcs-225_etd.prt
0Customer/Enterprise Tool and Die/Fasteners/English/SocketHeadCapScrews/0500/0500-shcs-250_etd.prt
0Customer/Enterprise Tool and Die/Fasteners/English/SocketHeadCapScrews/0500/0500-shcs-275_etd.prt
0Customer/Enterprise Tool and Die/Fasteners/English/SocketHeadCapScrews/0500/0500-shcs-300_etd.prt
0Customer/Enterprise Tool and Die/Fasteners/English/SocketHeadCapScrews/0500/0500-shcs-325_etd.prt
0Customer/Enterprise Tool and Die/Fasteners/English/SocketHeadCapScrews/0500/0500-shcs-350_etd.prt
0Customer/Enterprise Tool and Die/Fasteners/English/SocketHeadCapScrews/0500/0500-shcs-375_etd.prt
0Customer/Enterprise Tool and Die/Fasteners/English/SocketHeadCapScrews/0500/0500-shcs-400_etd.prt
0Customer/Enterprise Tool and Die/Fasteners/English/SocketHeadCapScrews/0500/0500-shcs-450_etd.prt
0Customer/Enterprise Tool and Die/Fasteners/English/SocketHeadCapScrews/0500/0500-shcs-500_etd.prt
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
