MCBailey-CTS/0Library/SeedFiles/ClampFeetDocs/Autotek Press Spec Quick Guide rev 11.2.pptx

ATK PRESS.

Revisión 11.2
25/10/18

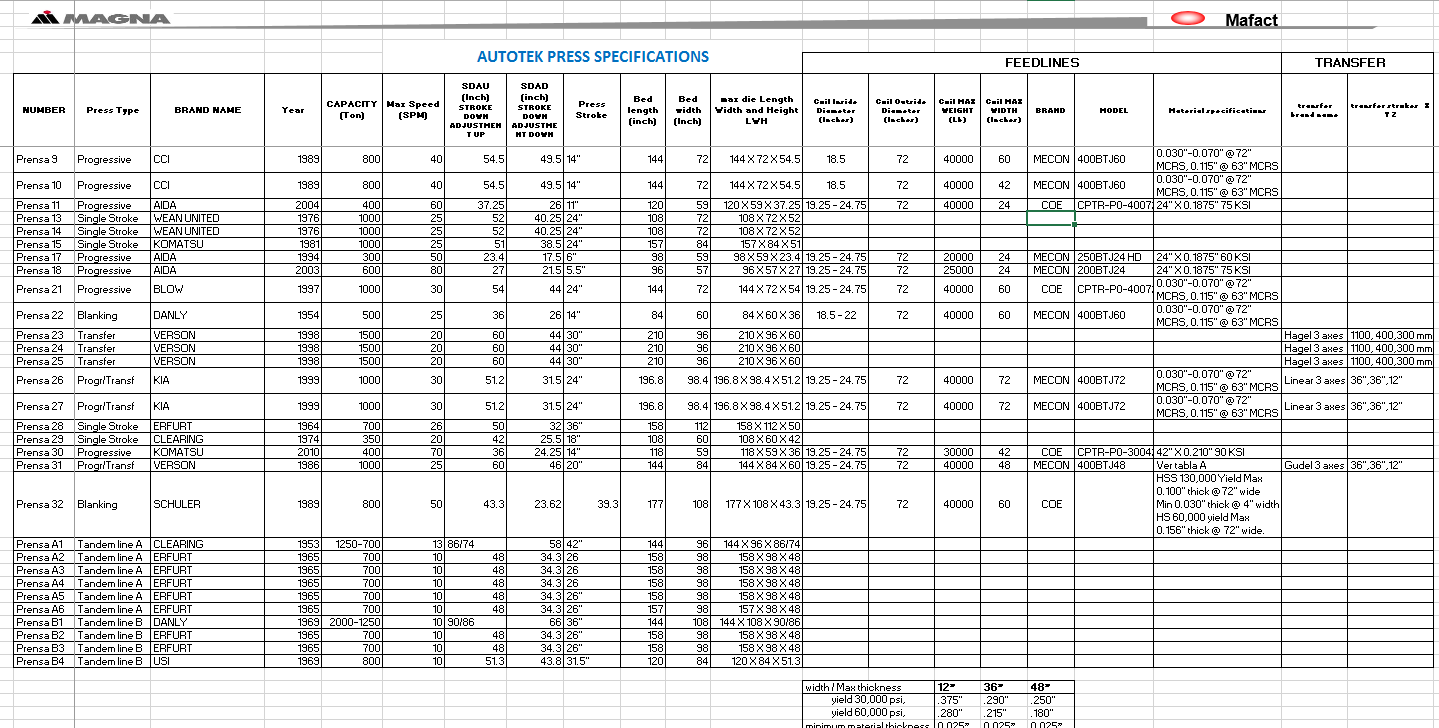
[picture p208: figure]
Recorte de pantalla

## Slide 2

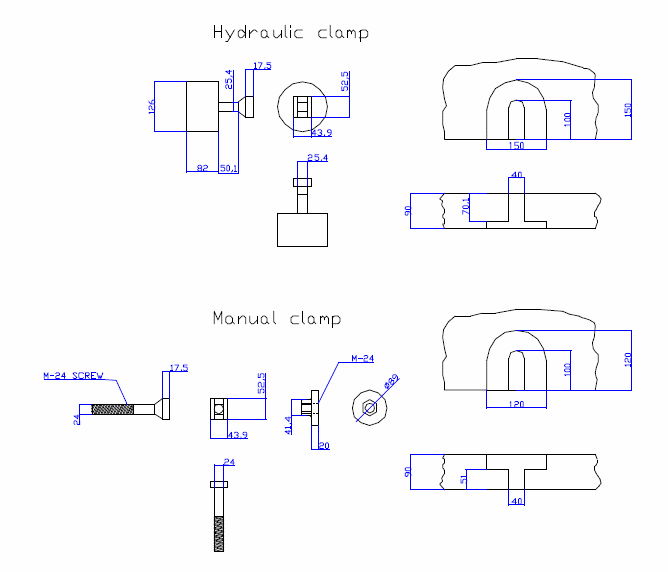
[picture p209: figure]

150

73.0

71.5

Upper Clamping

Lower Clamping

## Slide 3

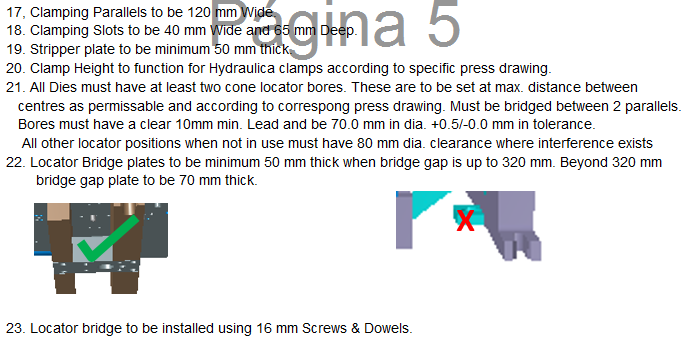
[picture p210: figure]
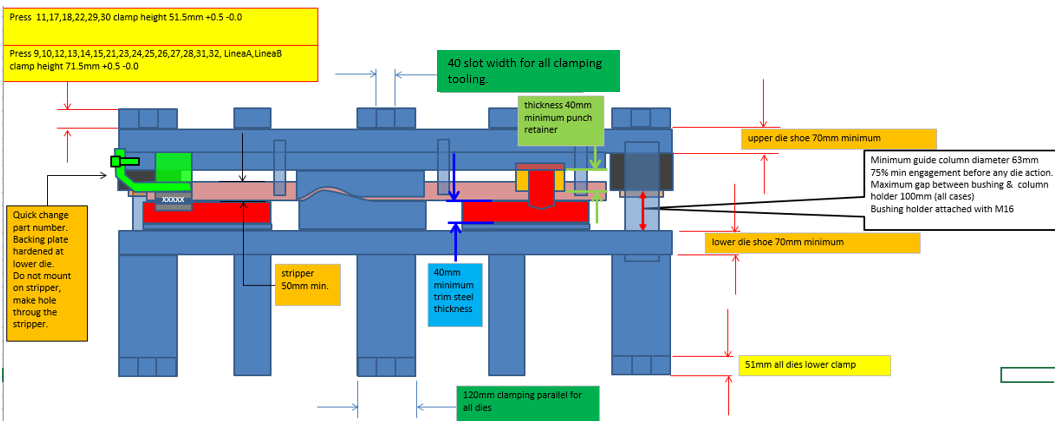
[picture p211: figure]

## Slide 4

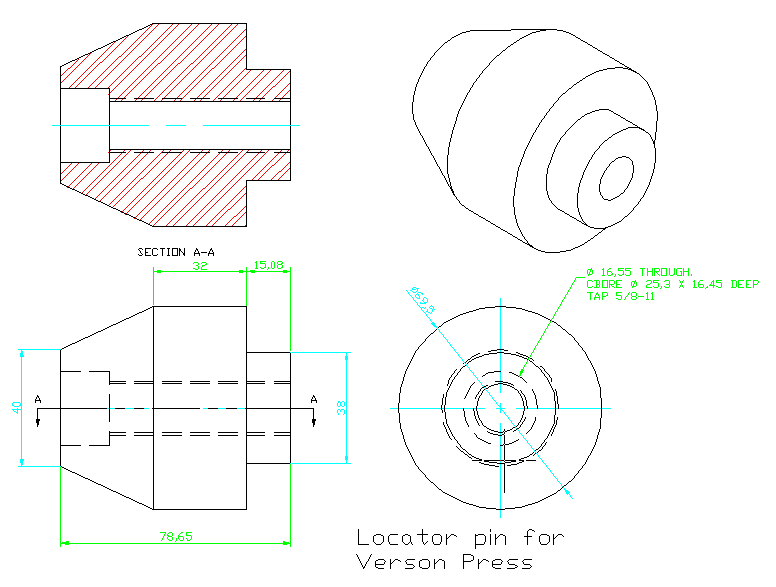
[picture p212: figure]

40

25.0

80.0

25.0

44.3
+0/-0.2

69.5
+0/-0.5

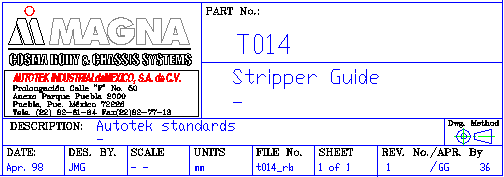
[picture p213: figure]

Press Locator
Press 9,10,21,23,24,25,26,27&31

T020

## Slide 5

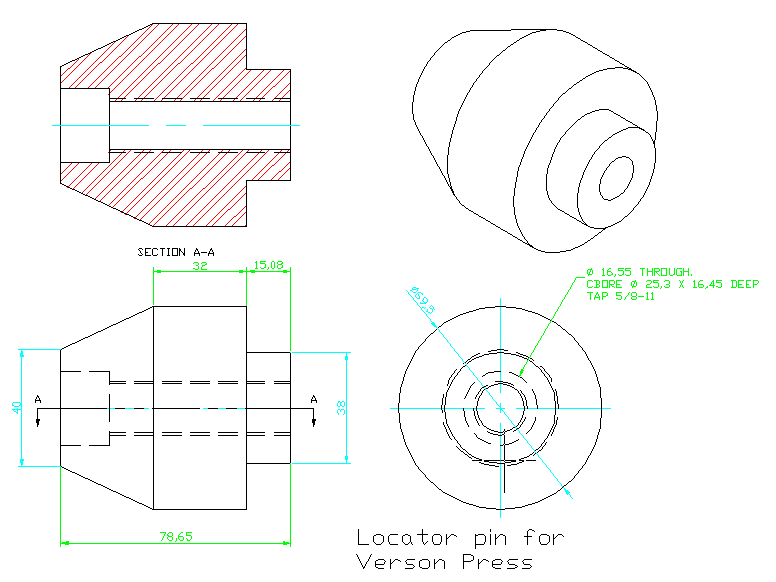
[picture p214: figure]

40

80

25.0

25.0

40.0
+0/-0.5

59.5
+0/-0.5

M 16 TAP
30mm DP

T021

## Slide 6

Make | Model | Bolster Size | Tonnage (metric) | Press Frame | Drive | SPM | Clamp Slot Pitch | Max. Shut Height | Min. Shut Height | Preferred Shut Height | Slide Stroke-(mm) | Bolster Capacity (kg) | Max Upper Die Weight (kg) | Auto Camps | Rolling Bolster Window | Furnace Layout
WIA | 1200 T | 3000mm x 2250mm | 1200 | Mono block | Hydraulic | 20 SPM | 152.4mm | 2200mm | 1000mm | 1200mm | 1200mm | 30,000 | 15,000 | Positions 0/3/6/-3/-6 | 2300mm x 2650mm | Double Roller Hearth

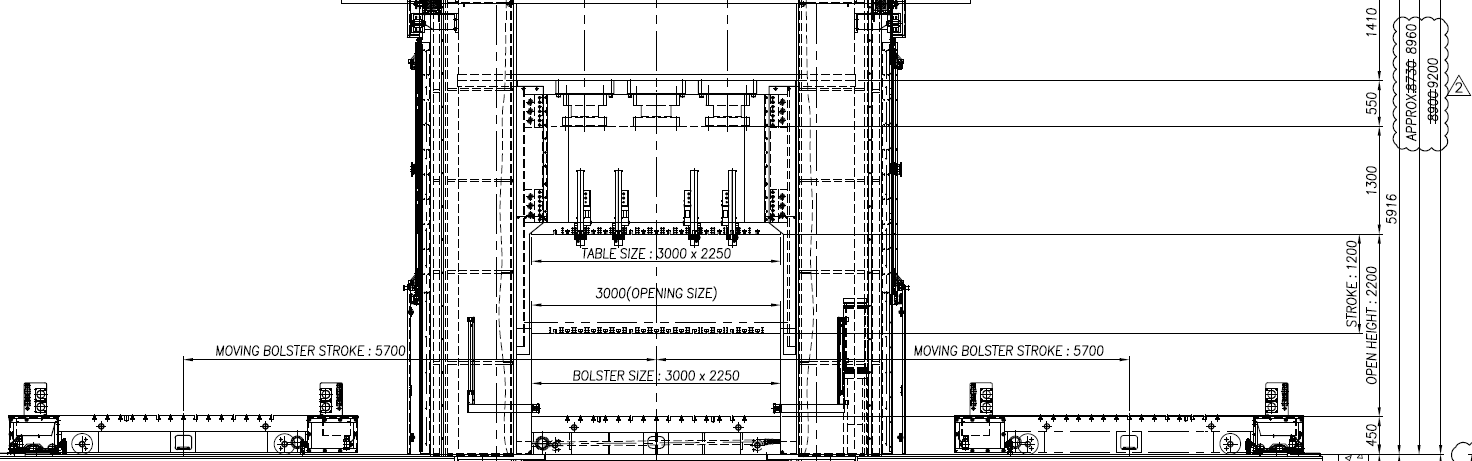
[picture p215: figure]
Recorte de pantalla

HS

PR HOT STAMPING

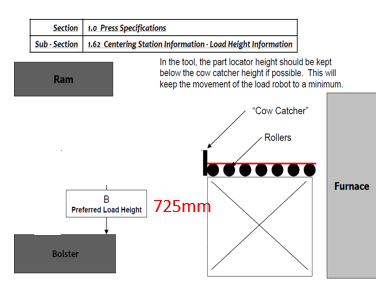
[picture p216: figure]

Common Shut Height

## Slide 7

PR13,PR14

Manual.

Press | Type | BOLSTER L-R | BOLSTER F-B | Common Coil Feed Height to Bols | STROKE | Common Shut Height | Minimum Shut Height | Maximum Shut Height | Ram Adjust | TONNAGE
PR13/PR14 | MANUAL | 2743 | 1829 | 635 | 610 | 1194 | 914 | 1321 | 406 | 1000

Image with closed press

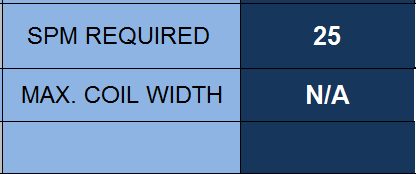
[picture p217: figure]

2743.2mm

1194mm

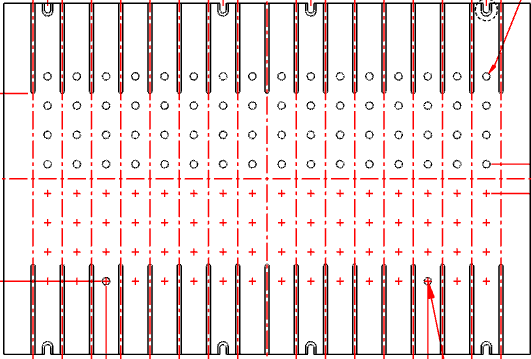
[picture p218: figure]
Recorte de pantalla

Common Shut Height

FRONT FLOW

1828.8mm

152.4mm

Distance between slots 6”

533.4mm

1676.4mm

Distance between locator

## Slide 8

PR15

Press | Type | BOLSTER L-R | BOLSTER F-B | Common Coil Feed Height to Bols | STROKE | Common Shut Height | Minimum Shut Height | Maximum Shut Height | Ram Adjust | TONNAGE
PR15 | MANUAL | 3988 | 2134 | 914 | 600 | 1194 | 991 | 1295 | 304 | 800

1194mm

225mm

300mm

Manual.

Image with closed press

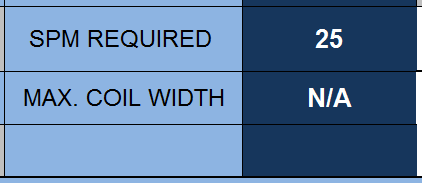
[picture p219: figure]

Common Shut Height

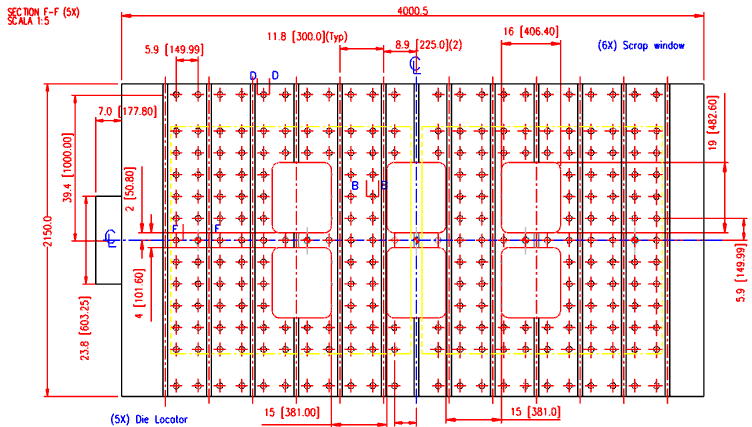
[picture p220: figure]
Recorte de pantalla

FRONT FLOW

Distance between slots

## Slide 9

PR28

Press | Type | BOLSTER L-R | BOLSTER F-B | STROKE | Common Shut Height | Minimum Shut Height | Maximum Shut Height | Ram Adjust | TONNAGE | Minimum Strokes P/Minute | Maximum Strokes P/Minute
PR28 | MANUAL | 3658 | 2438 | 950 | 1194 | 813 | 1270 | 457 | 700 | 0 | 4

Manual.

Image with closed press

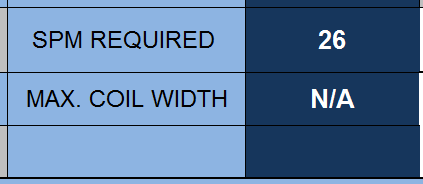
[picture p221: figure]

Common Shut Height

1200mm

3658mm

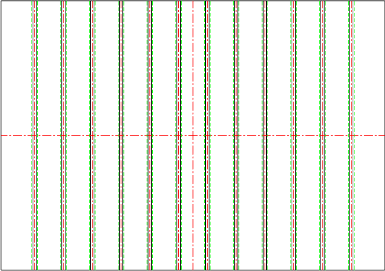
[picture p222: figure]
Recorte de pantalla

FRONT FLOW

FRONT FLOW

300mm

Distance between slots

2438mm

## Slide 10

PR29

Press | Type | BOLSTER L-R | BOLSTER F-B | STROKE | Common Shut Height | Minimum Shut Height | Maximum Shut Height | Ram Adjust | TONNAGE
PR29 | MANUAL | 6480 | 1524 | 457 | 787 | 660 | 1041 | 381 | 350

Manual.

Image with closed press

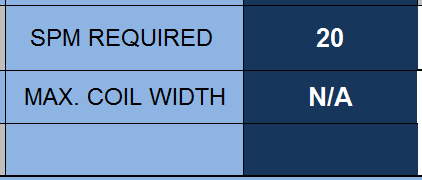
[picture p223: figure]

Common Shut Height

780mm

6480mm

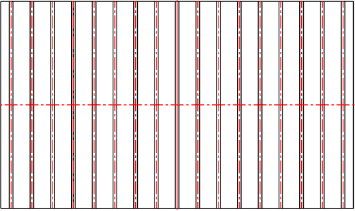
[picture p224: figure]
Recorte de pantalla

FRONT FLOW

1524mm

Distance between slots

300mm

## Slide 11

PR09,PR10,PR21

PROG

Press | Type | BOLSTER L-R | BOLSTER F-B | Common Coil Feed Height to Bols | STROKE | Common Shut Height | Minimum Shut Height | Maximum Shut Height | Ram Adjust | TONNAGE | Minimum Strokes P/Minute
PR09,PR10 ,PR21 | PROG | 3658 | 1829 | 500 | 356 | 934 | 1245 | 1372 | 140 | 800 PR21,1000 | 20

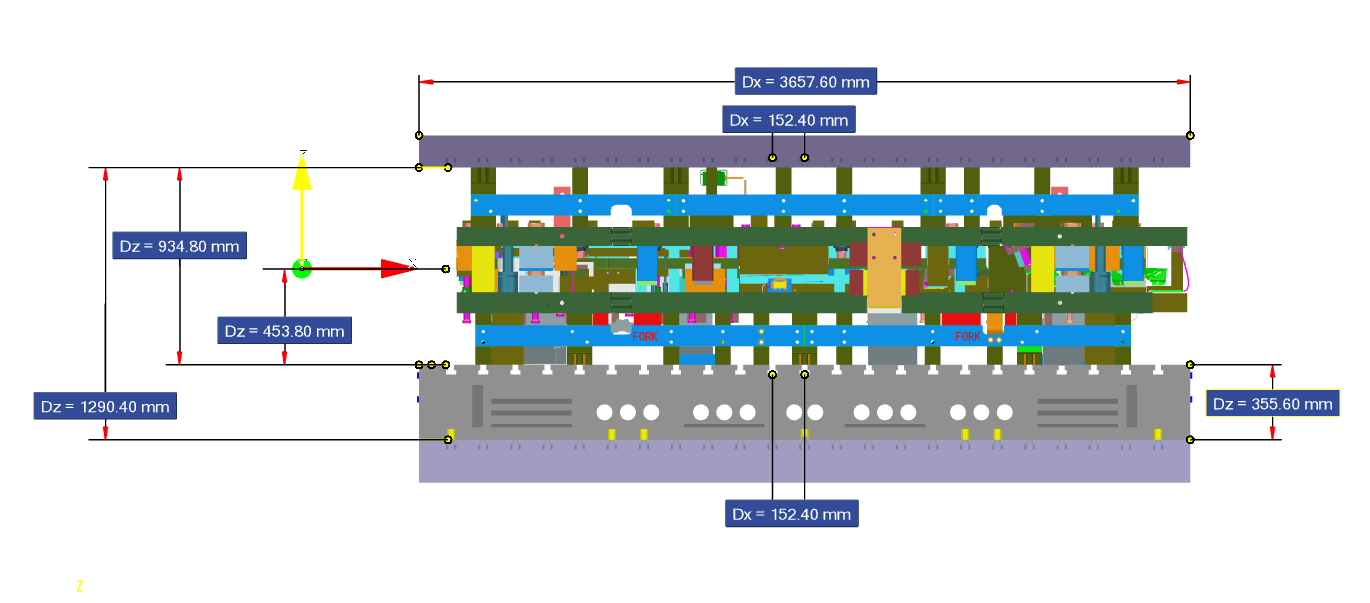
[picture p225: figure]
Recorte de pantalla

Common Shut Height

934

FRONT FLOW

Distance between slots 6”

Image with closed press

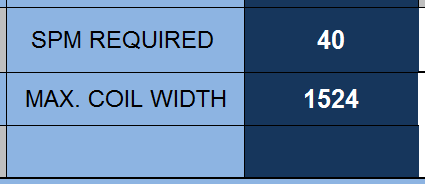
[picture p226: figure]
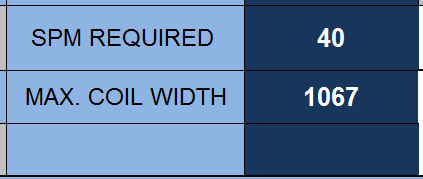
[picture p227: figure]

PR09

PR10

PR21

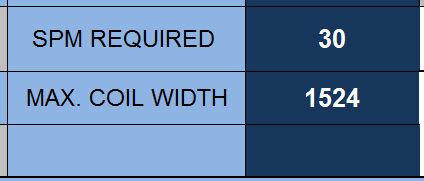
[picture p228: figure]
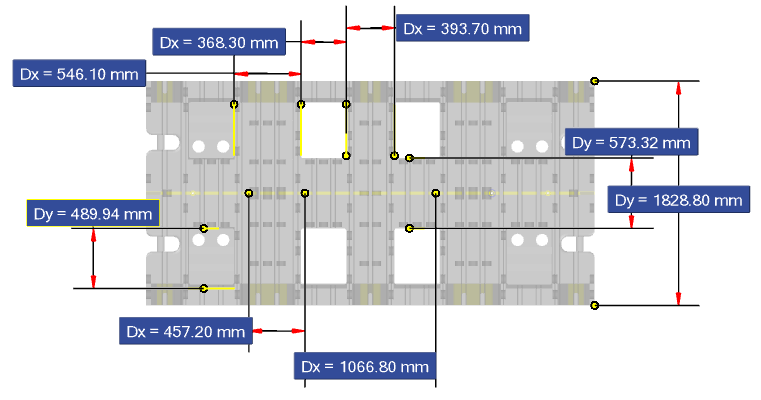
[picture p229: figure]
Recorte de pantalla

Riser

Locator T020

Distance between locator .

Common coil feed height with lifters extended

500mm

## Slide 12

PR11

Press | Type | BOLSTER L-R | BOLSTER F-B | Common Coil Feed Height to Bols | STROKE | Common Shut Height | Minimum Shut Height | Maximum Shut Height | Ram Adjust | TONNAGE | Minimum Strokes P/Minute | Maximum Strokes P/Minute
PR11 | PROG | 3050 | 1500 | 425 | 300 | 620 | 575 | 875 | 300 | 400 | 40 | 70

Hydraulic fixing system

Common Shut Height

Image with closed press

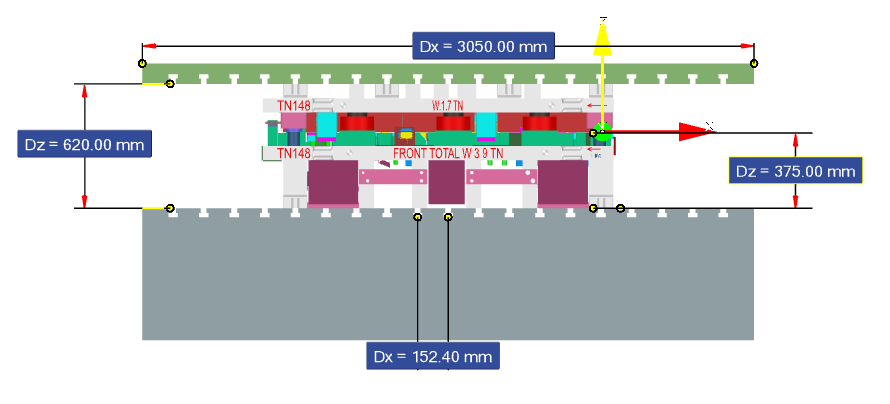
[picture p230: figure]
Recorte de pantalla

250mm

FRONT FLOW

Distance between slots 6”

PROG

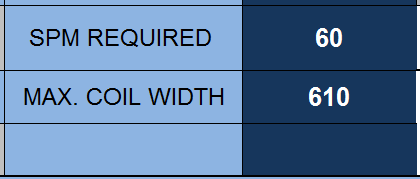
[picture p231: figure]
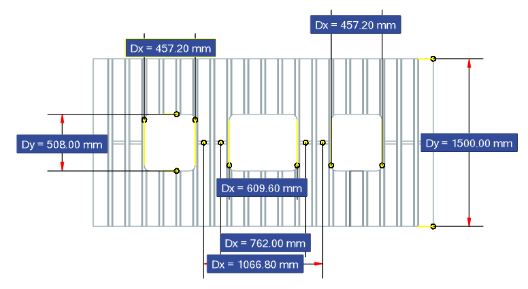
[picture p232: figure]
Recorte de pantalla

Locator T021

Bolster

Distance between locator

Common coil feed height with lifters extended

425mm

## Slide 13

PR17

Press | Type | BOLSTER L-R | BOLSTER F-B | Common Coil Feed Height to Bols | STROKE | Common Shut Height | Minimum Shut Height | Maximum Shut Height | Ram Adjust | TONNAGE | Minimum Strokes P/Minute | Maximum Strokes P/Minute
PR17 | PROG | 2500 | 1500 | 425 | 300 | 620 | 409 | 639 | 200 | 300 | 10 | 50

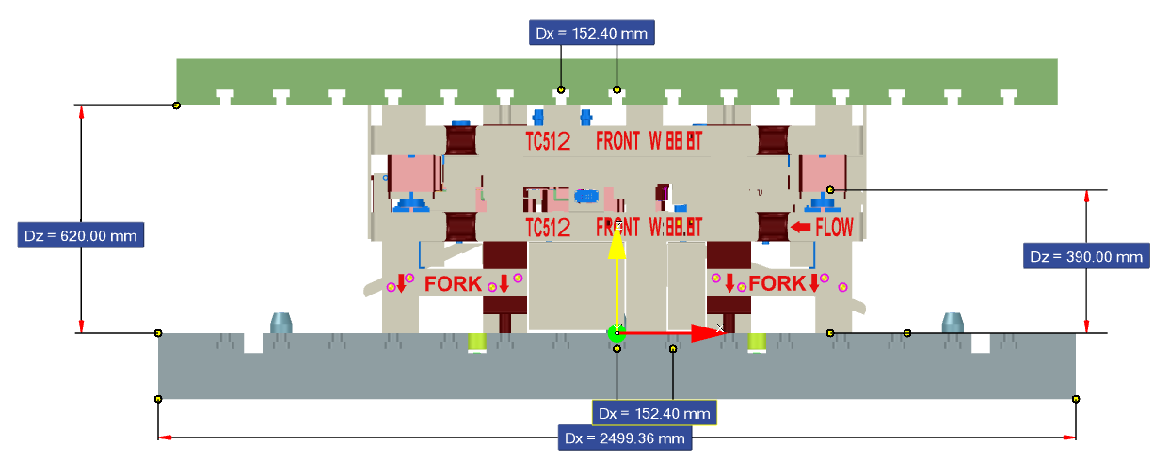
[picture p233: figure]
Recorte de pantalla

250mm

Distance between slots 6”

Common Shut Height

FRONT FLOW

Distance between slots 6”

PROG

Image with closed press

Common Coil Feed Height to Bols

425mm

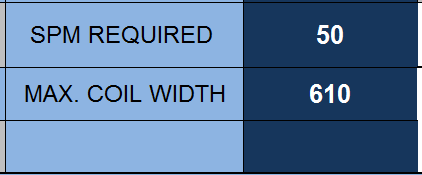
[picture p234: figure]
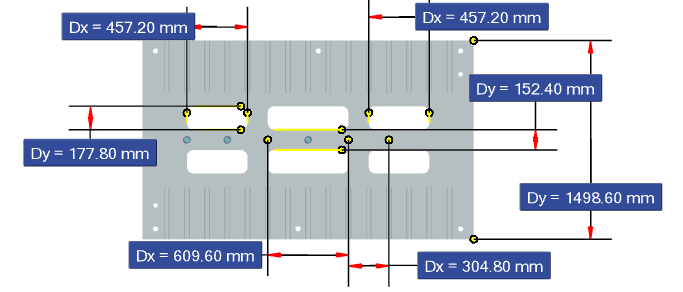
[picture p235: figure]
Recorte de pantalla

Locator T021

Distance between locator

Bolster

Common coil feed height with lifters extended

425mm

## Slide 14

PR 18

PROG

Press | Type | BOLSTER L-R | BOLSTER F-B | Common Coil Feed Height to Bols | STROKE | Common Shut Height | Minimum Shut Height | Maximum Shut Height | Ram Adjust | TONNAGE | Minimum Strokes P/Minute | Maximum Strokes P/Minute
PR18 | PROG | 2450 | 1250 | 425 | 250 | 620 | 552 | 702 | 150 | 660 | 30 | 60

Image with closed press

Hydraulic fixing system

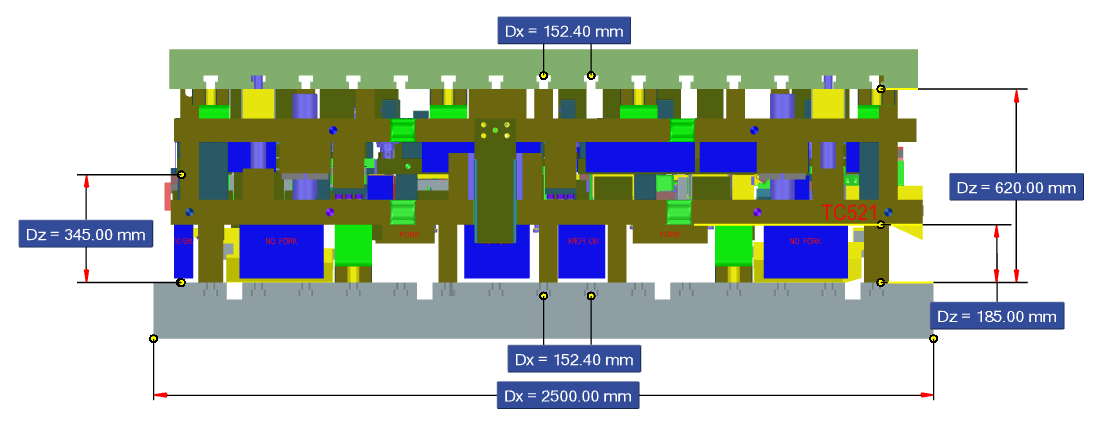
[picture p236: figure]
Recorte de pantalla

Distance between slots 6”

Common Shut Height

425 mm

200mm

FRONT FLOW

Distance between slots

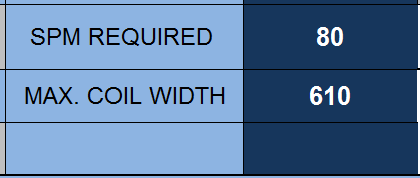
[picture p237: figure]

Common coil feed height with lifters extended

425mm

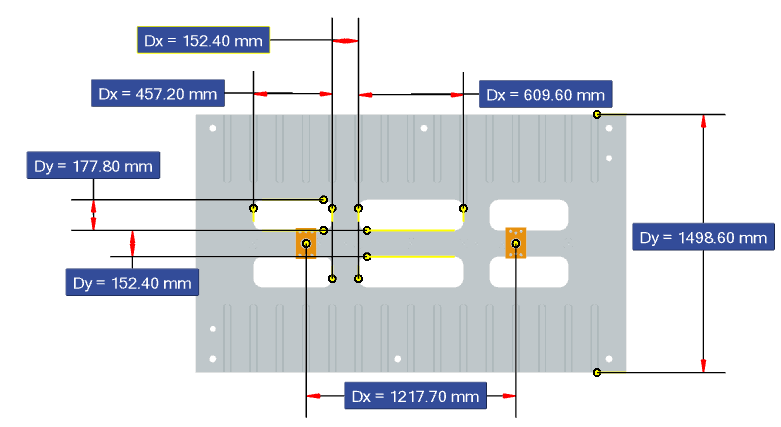
[picture p238: figure]
Recorte de pantalla

Locator T021

Distance between locator

Bolster

## Slide 15

PR22

Press | Type | BOLSTER L-R | BOLSTER F-B | Common Coil Feed Height to Bols | STROKE | Common Shut Height | Minimum Shut Height | Maximum Shut Height | Ram Adjust | TONNAGE | Minimum Strokes P/Minute | Maximum Strokes P/Minute
PR22 | PROG | 2134 | 1524 | 330 | 356 | 787 | 660 | 864 | 203 | 500 | 25 | 25

PROG BLANKING

Common coil feed height with lifters extended

Image with closed press

Common Shut Height

787mm

152.4mm

152.4mm

Distance between slots 6”

330mm

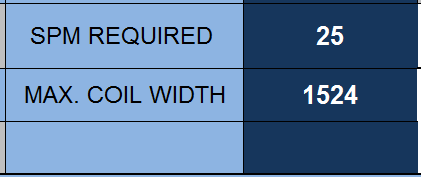
[picture p239: figure]

2134mm

FRONT FLOW

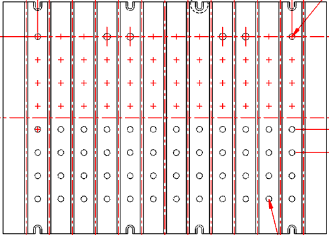
[picture p240: figure]
Recorte de pantalla

1524mm

## Slide 16

PR30

Press | Type | BOLSTER L-R | BOLSTER F-B | Common Coil Feed Height to Bols | STROKE | Common Shut Height | Minimum Shut Height | Maximum Shut Height | Ram Adjust | TONNAGE | Minimum Strokes P/Minute | Maximum Strokes P/Minute | Max Coil Width | Min Int. Dia Coil | Max Int. Dia Coil | Max Outside Dia Coil
PR30 | PROG | 3000 | 1500 | 425 | 300 | 620 | 560 | 860 | 300 | 400 | 25 | 70 | 1067 | 610 | 610 | 1829

Hydraulic fixing system

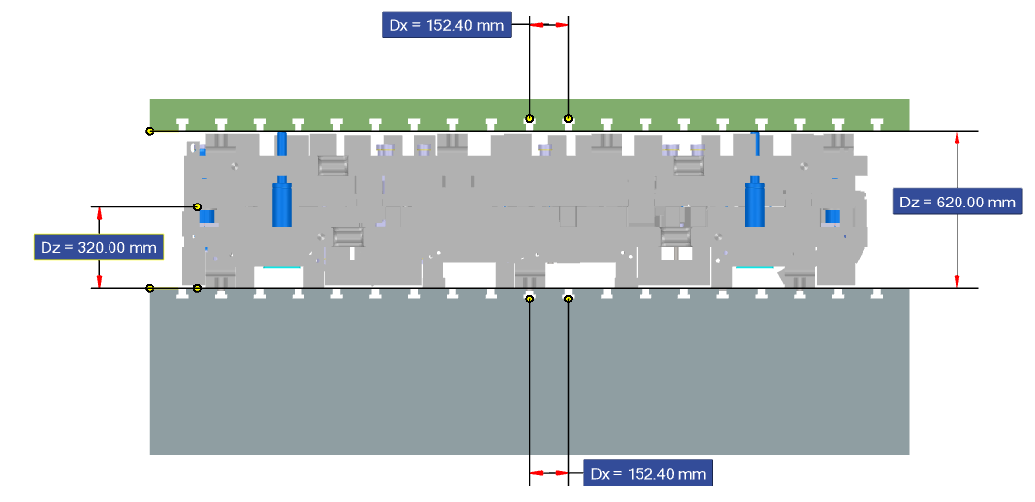
[picture p241: figure]
Recorte de pantalla

Distance between slots 6”

Common Shut Height

FRONT FLOW

Distance between slots

Image with closed press

PROG

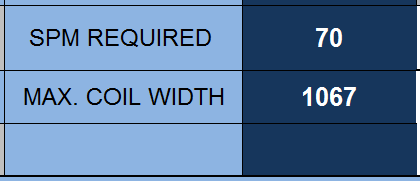
[picture p242: figure]

Common coil feed height with lifters extended

425mm

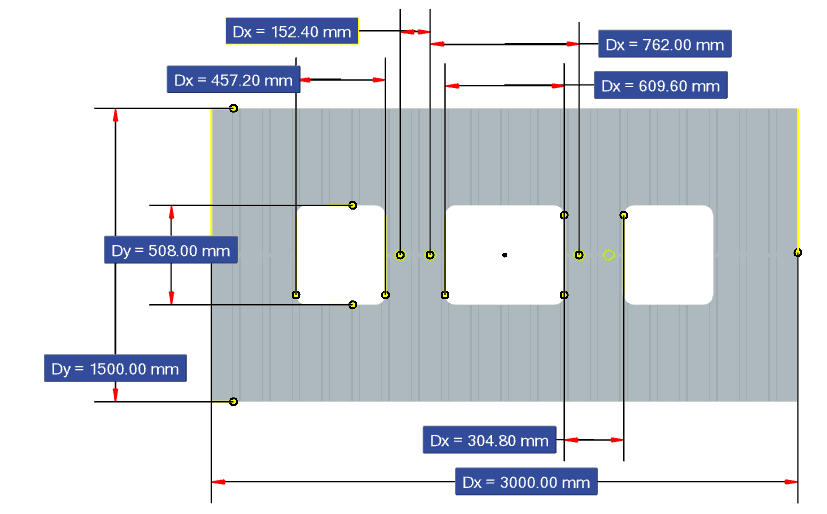
[picture p243: figure]
Recorte de pantalla

Distance between locator

Locator T021

## Slide 17

PR32

Press | Type | BOLSTER L-R | BOLSTER F-B | Common Coil Feed Height to Bols | STROKE | Common Shut Height | Minimum Shut Height | Maximum Shut Height | Ram Adjust | TONNAGE | Minimum Strokes P/Minute | Maximum Strokes P/Minute | Max Coil Width | Min Int. Dia Coil | Max Int. Dia Coil | Max Outside Dia Coil
PR32 | PROG | 4500 | 2750 | 600 | 320 | 1070 | 1050 | 1100 | 50 | 800 | 12 | 50 | 2000 | 400 | 610 | 2000

Image with closed press

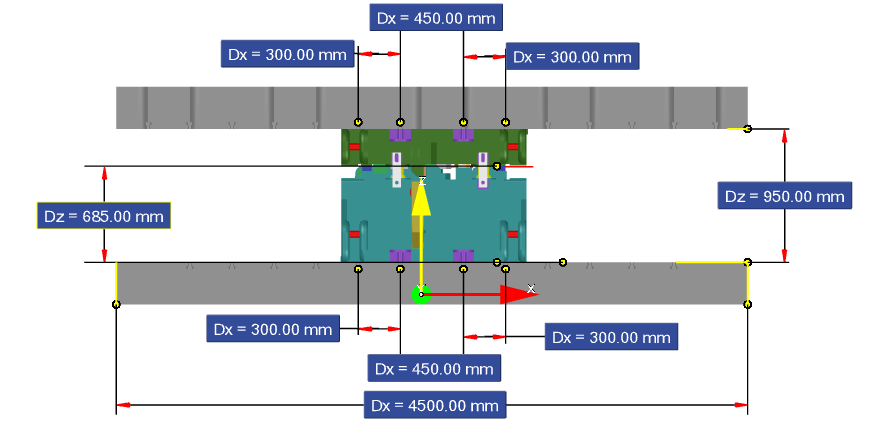
[picture p244: figure]
Recorte de pantalla

Distance between slots

1070mm

Common Shut Height

FRONT FLOW

Distance between slots

PROG BLANKING

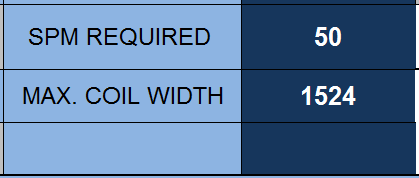
[picture p245: figure]

Common coil feed height with lifters extended

Locator T020

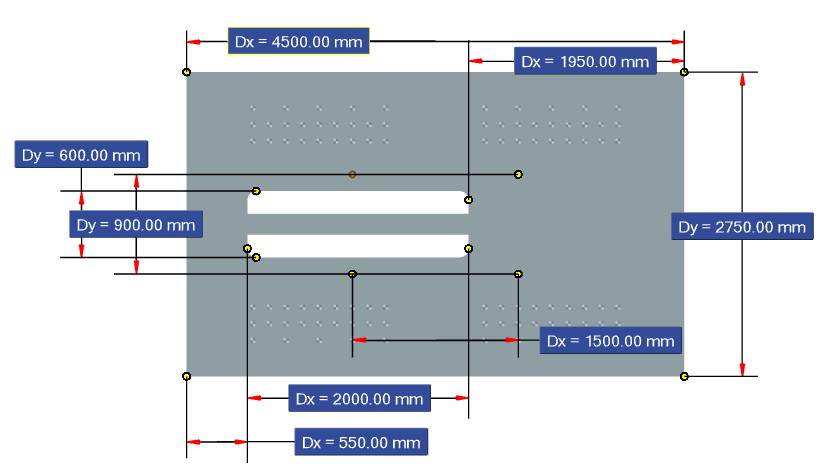
[picture p246: figure]
Recorte de pantalla

Bolster

Distance between locator

600mm

## Slide 18

PR23,PR24

Press | Type | BOLSTER L-R | BOLSTER F-B | STROKE | Common Shut Height | Minimum Shut Height | Maximum Shut Height | Ram Adjust | TONNAGE | Minimum Strokes P/Minute | Maximum Strokes P/Minute | Transfer Lift | Max. Pitch / Transfer Pitch | Common Pitch | Max. Transfer Travel In & Out | Max. distance between trans. bars | Min. distance between trans. bars
PR23 | MECH/TANS | 5334 | 2438 | 762 | 1194 | 1118 | 1524 | 406 | 1500 | 6 | 20 | 25.4-254 | 1100 | 18,24,30,36,42 | 420mm | 2650 | 1200

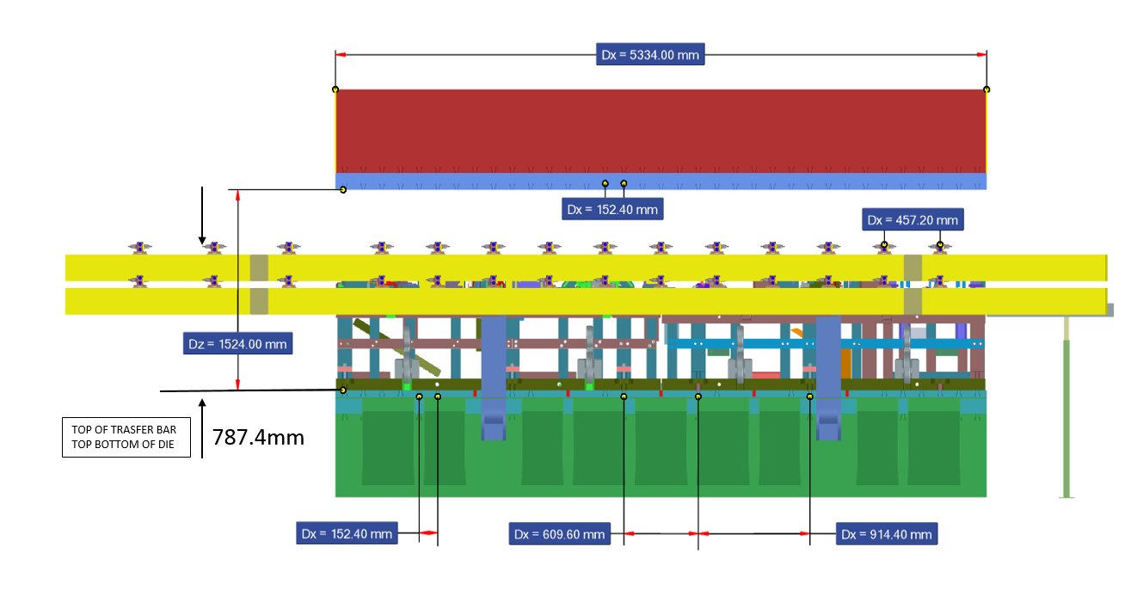
[picture p247: figure]

MECH/TRANS

Image with closed press

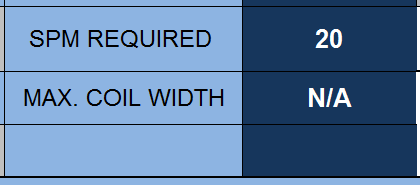
[picture p248: figure]

Distance between slots

Common Shut Height

1194 mm

FRONT FLOW

Locator T020

Distance between slots

## Slide 19

PR23,PR24

MECH/TRANS

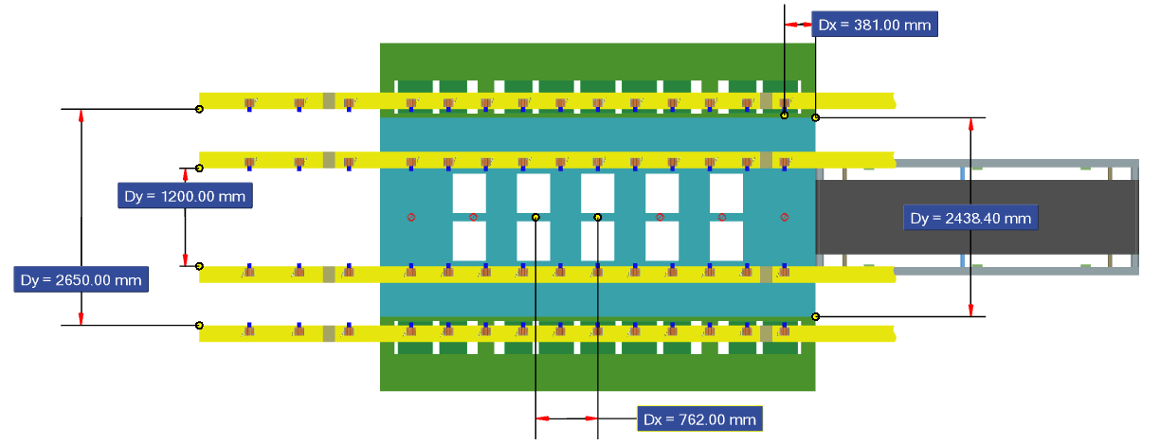
[picture p249: figure]
Recorte de pantalla

457.2mm

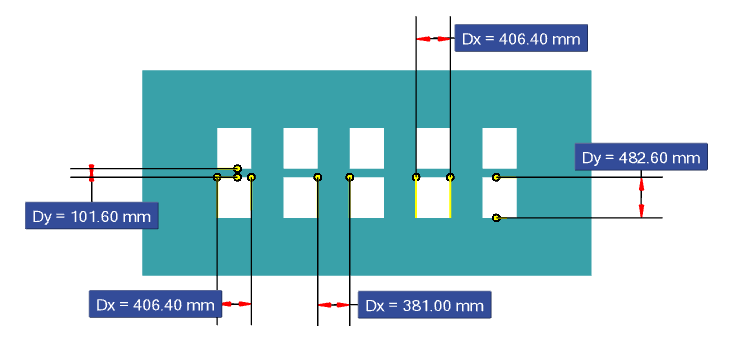
[picture p250: figure]
Recorte de pantalla

FRONT FLOW

Distance between locator

Bolster

2438mm

Locator T020

## Slide 20

PR25

Press | Type | BOLSTER L-R | BOLSTER F-B | STROKE | Common Shut Height | Minimum Shut Height | Maximum Shut Height | Ram Adjust | TONNAGE | Minimum Strokes P/Minute | Maximum Strokes P/Minute | Transfer Lift | Max. Pitch / Transfer Pitch | Common Pitch
PR25 | MECH/TANS | 5334 | 2388 | 762 | 1194 | 1117 | 1524 | 406 | 1500 | 6 | 20 | 25.4-254 | 1066.8 | 18,24,30,36,42

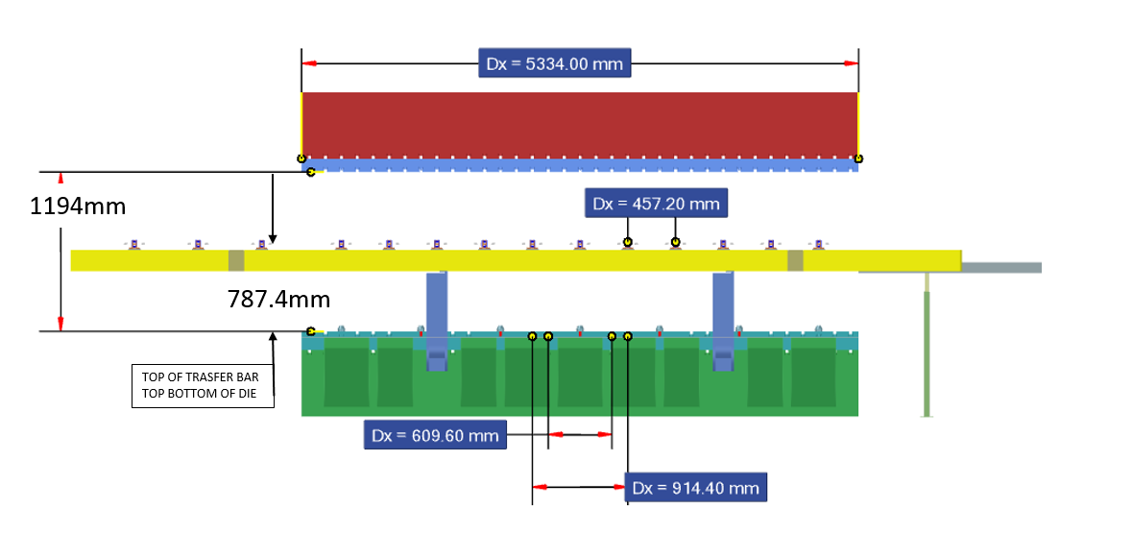
[picture p251: figure]

Common Shut Height

Locator T020

Distance between slots

MECH/TRANS

Image with closed press

FRONT FLOW

## Slide 21

PR25

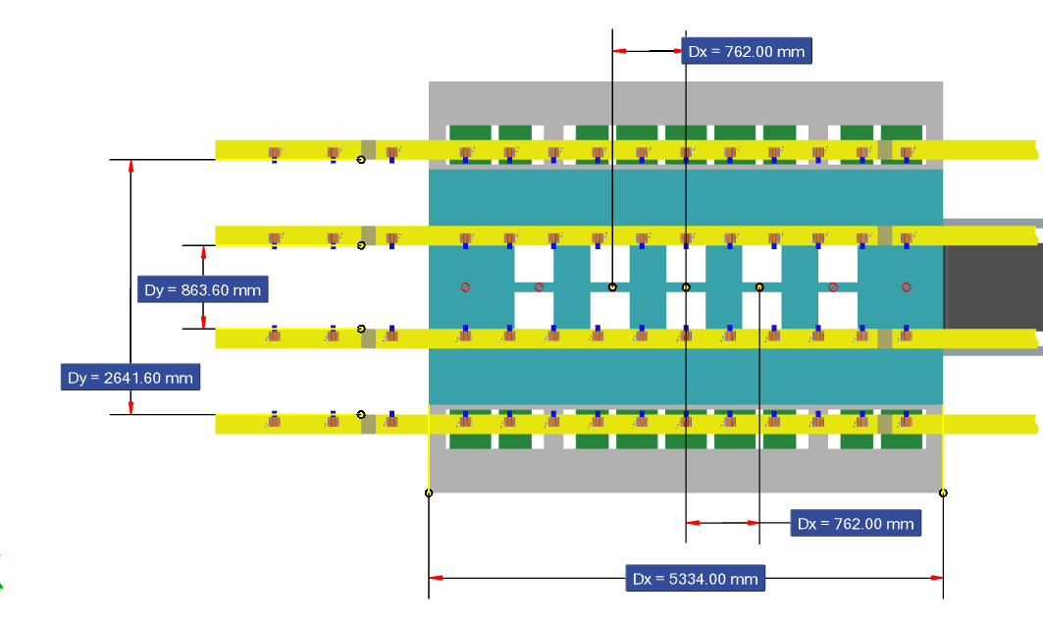
[picture p252: figure]
Recorte de pantalla

457.2mm

MECH/TRANS

FRONT FLOW

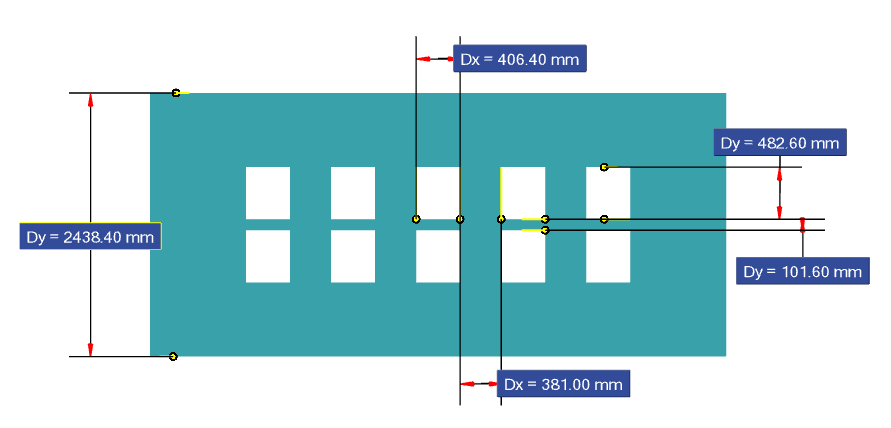
[picture p253: figure]
Recorte de pantalla

Bolster

Locator T020

## Slide 22

Press | Type | BOLSTER L-R | BOLSTER F-B | Common Coil Feed Height to Bols | STROKE | Common Shut Height | Minimum Shut Height | Maximum Shut Height | Ram Adjust | TONNAGE | Minimum Strokes P/Minute | Maximum Strokes P/Minute | Max Coil Width | Min Int. Die Coil | Max Int. Dia Coil | Max Outside Dia Coil
PR26 | PROG | 5000 | 2500 | 787 | 610 | 850 | 787 | 1295 | 508 | 1000 | 15 | 30 | 1829 | 470 | 559 | 1880

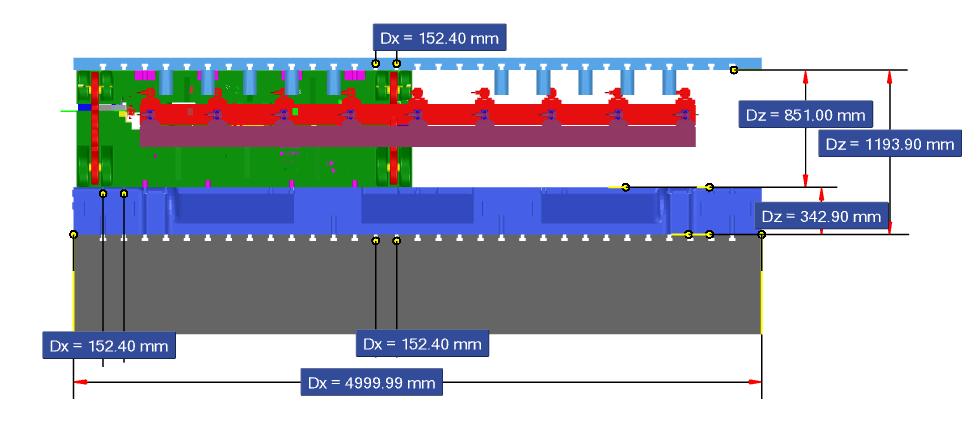
[picture p254: figure]
Recorte de pantalla

457.2mm

Locator T020

850 mm

Distance between slots

FRONT FLOW

Image with closed press

PR26,PR27

COIL FEED

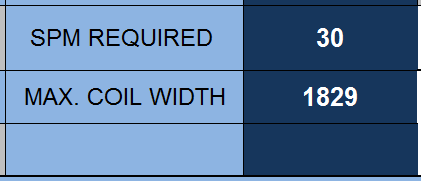
[picture p255: figure]

Common Shut Height With Riser

787mm

RISER

Distance between slots

Common coil feed height with lifters extended

## Slide 23

PR26,PR27

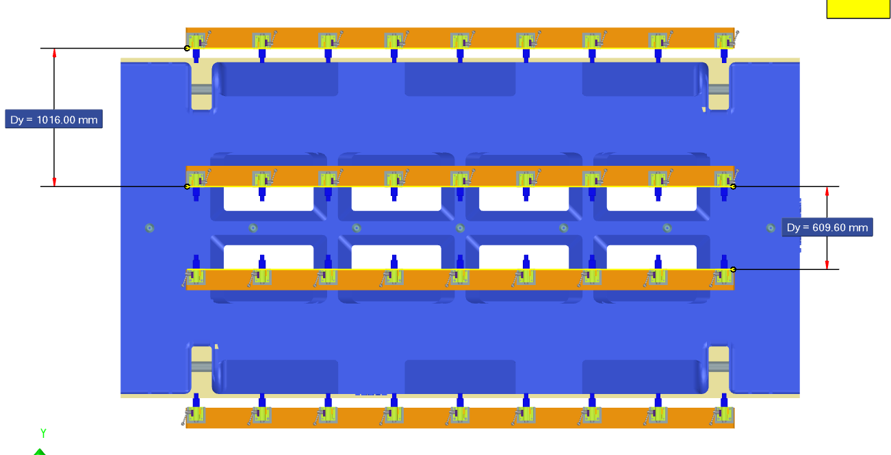
[picture p256: figure]

## Slide 24

PR26,PR27

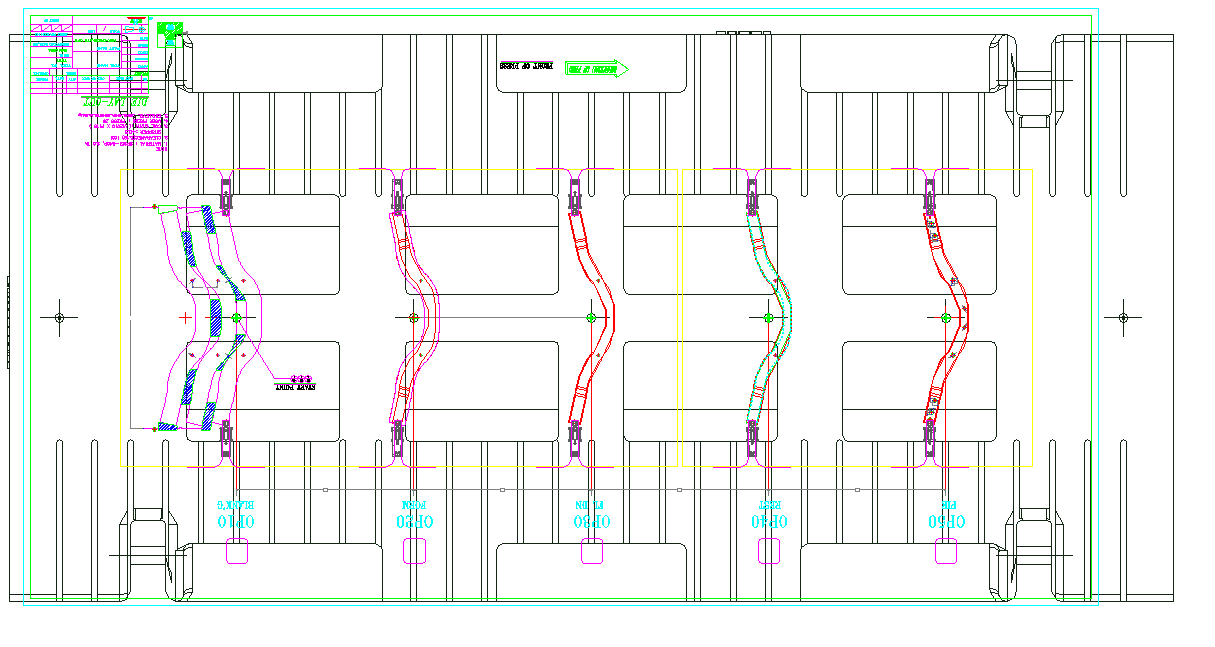
[picture p257: figure]

Consider that the Transfer system is limited to the size of our BOLSTER.
Therefore, it must be consider that a work station will be destined for the fall of the piece.

## Slide 25

RISER 26/27

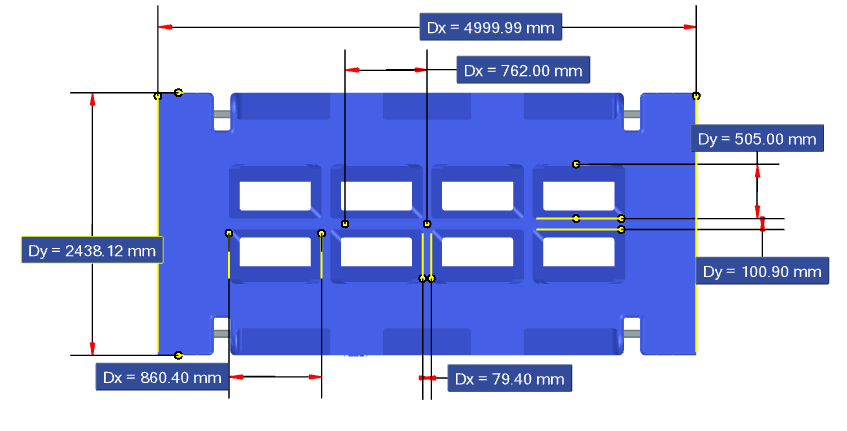
[picture p258: figure]
Recorte de pantalla

Distance between locator

Locator T020

## Slide 26

PR31

Press | Type | BOLSTER L-R | BOLSTER F-B | Common Coil Feed Height to Bols | STROKE | Common Shut Height | Minimum Shut Height | Maximum Shut Height | Ram Adjust | TONNAGE | Minimum Strokes P/Minute | Maximum Strokes P/Minute | Max Coil Width | Min Int. Dia Coil | Max Int. Dia Coil | Max Outside Dia Coil
PR31 | PROG | 3658 | 2134 | 787 | 508 | 910 | 864 | 1219 | 355 | 1000 | 13 | 26 | 1219 | 470 | 610 | 1778

Image with closed press

Distance between slots

7787.34

787mm

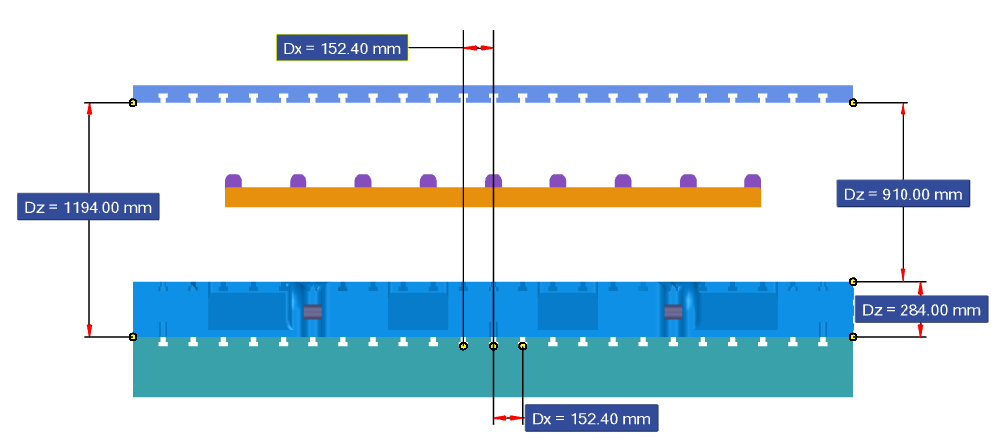
[picture p259: figure]
Recorte de pantalla

Common Shut Height With Riser

Common Coil Feed Height to Bols

FRONT FLOW

Distance between slots

COIL FEED

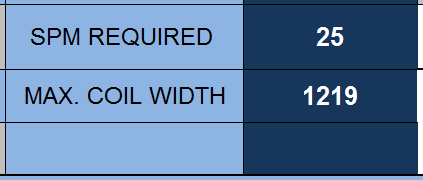
[picture p260: figure]
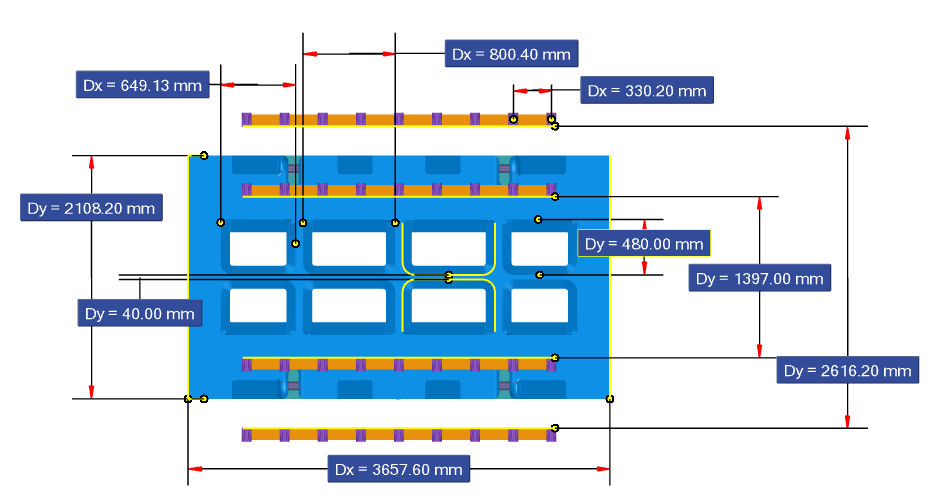
[picture p261: figure]
Recorte de pantalla

Common coil feed height with lifters extended

Locator T020

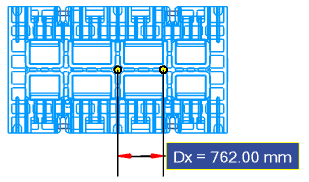
[picture p262: figure]
Recorte de pantalla

Distance between locator

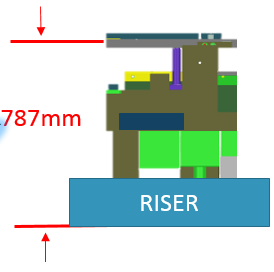
[picture p263: figure]
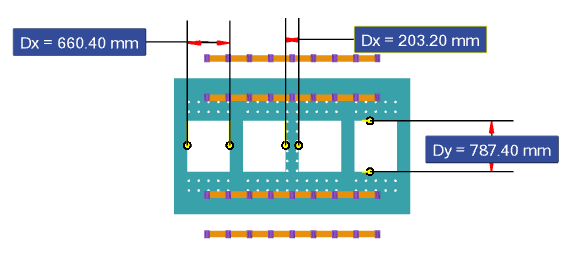
[picture p264: figure]
Recorte de pantalla

## Slide 27

PR31

Consider that the Transfer system is limited to the size of our BOLSTER.
Therefore, it must be consider that a work station will be destined for the fall of the piece.

## Slide 28

PR A1

TANDEM

Image with closed press

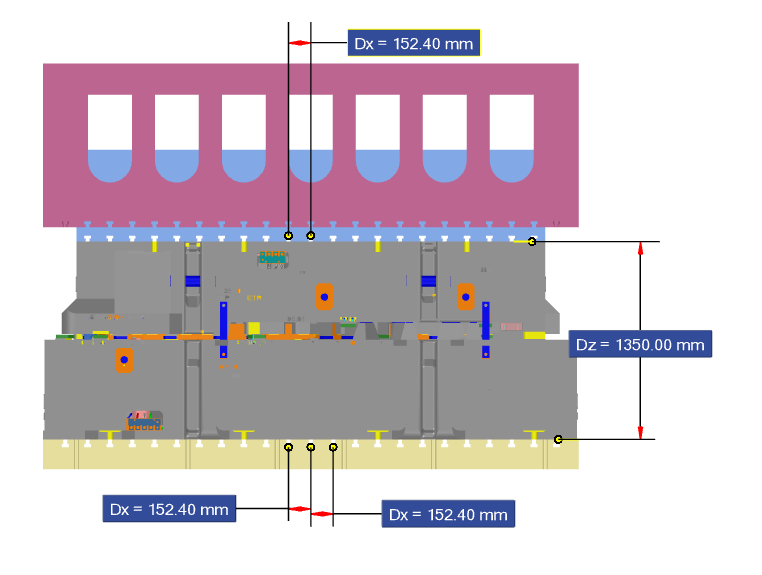
[picture p265: figure]
Recorte de pantalla

Distance between slots

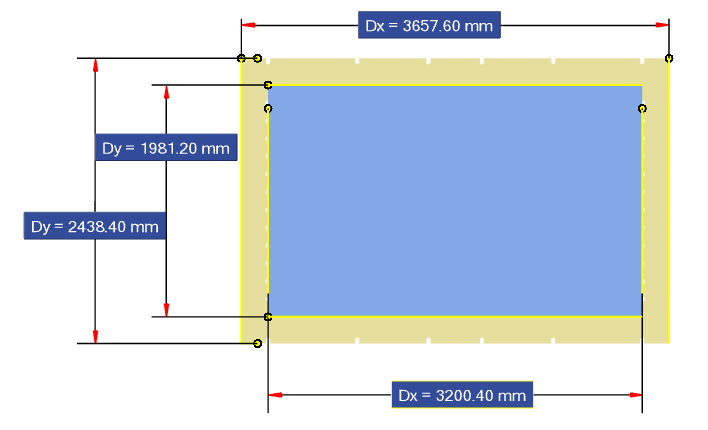
[picture p266: figure]
Recorte de pantalla

Common Shut Height

1879mm

1194mm

1194mm

Locator T021

Distance between slots

## Slide 29

PRA2,A3,A4,A5,A6

TANDEM

Press | Type | BOLSTER L-R | BOLSTER F-B | STROKE | Common Shut Height | Minimum Shut Height | Maximum Shut Height | Ram Adjust | TONNAGE | Minimum Strokes P/Minute | Maximum Strokes P/Minute
PRA2 | TANDEM | 4000 | 2500 | 660 | 1194 | 870 | 1220 | 350 | 800 | 4 | 10

Image with closed press

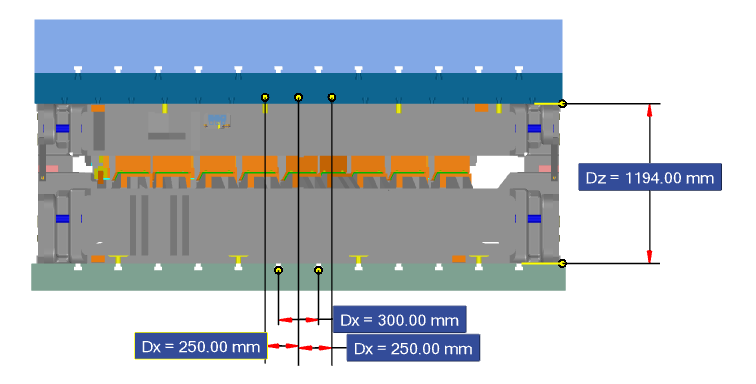
[picture p267: figure]
Recorte de pantalla

1194mm

Common Shut Height

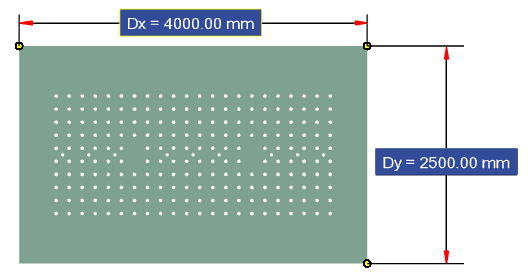
[picture p268: figure]
Recorte de pantalla

Distance between slots

Locator T021

## Slide 30

PRB1

Press | Type | BOLSTER L-R | BOLSTER F-B | STROKE | Minimum Shut Height | Maximum Shut Height | Minimum Shut Height OUT | Maximum Shut Height OUT | Ram Adjust | TONNAGE OUTER | TONNAGE INER | Minimum Strokes P/Minute | Maximum Strokes P/Minute
PRB1 | TANDEM | 3200 | 2082 | INNER 914 OUTER 686 | 1676 INNER | 2286 INNER | 1574 OUTER | 2184 OUTER | 609 | 1250 | 2000 | 4 | 10

TANDEM

Image with closed press

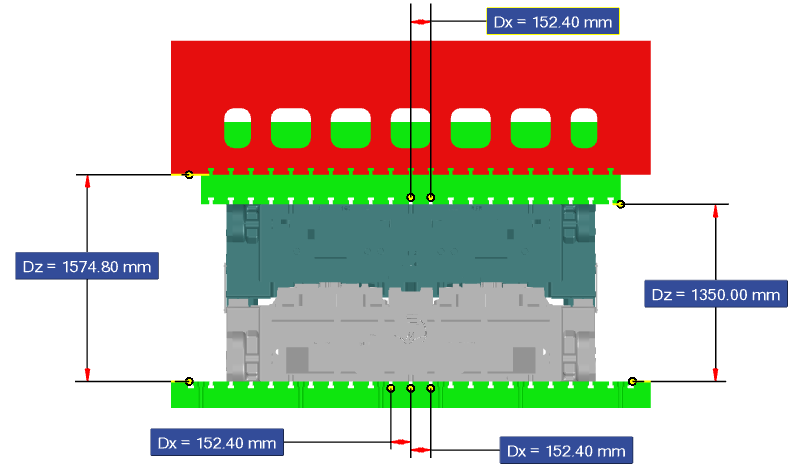
[picture p269: figure]
Recorte de pantalla

Common Shut Height

1400mm

Minimum shut Height OUT

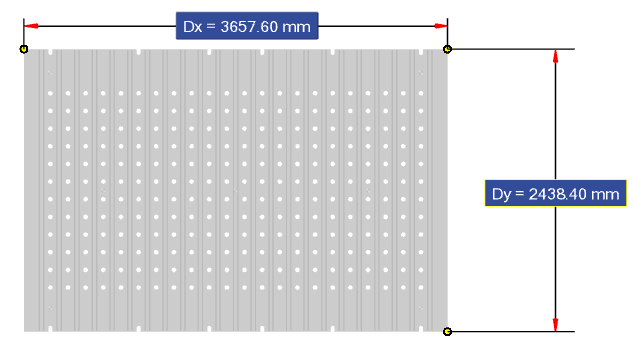
[picture p270: figure]
Recorte de pantalla

Distance between slots

Locator T021

## Slide 31

PR B2,B3

TANDEM

Press | Type | BOLSTER L-R | BOLSTER F-B | STROKE | Common Shut Height | Minimum Shut Height | Maximum Shut Height | Ram Adjust | TONNAGE | Minimum Strokes P/Minute | Maximum Strokes P/Minute
PRB2 | TANDEM | 4000 | 2500 | 660 | 1194 | 870 | 1220 | 350 | 800 | 4 | 10

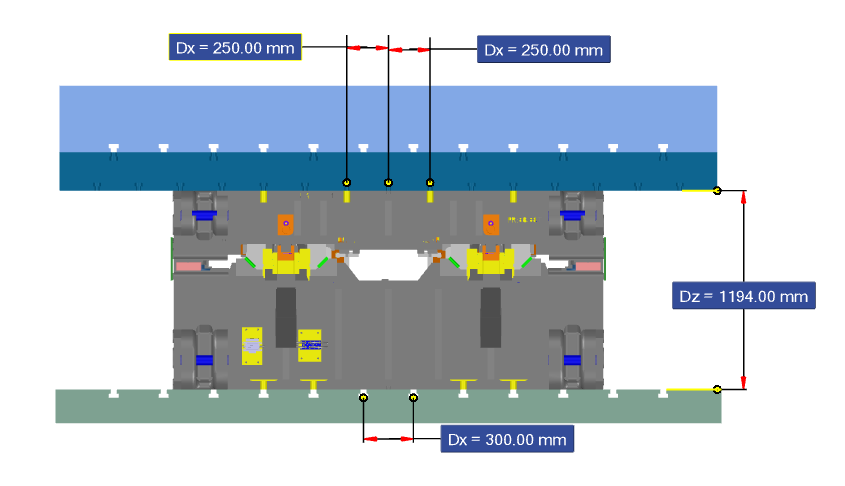
[picture p271: figure]
Recorte de pantalla

Image with closed press

Distance between slots

Common Shut Height

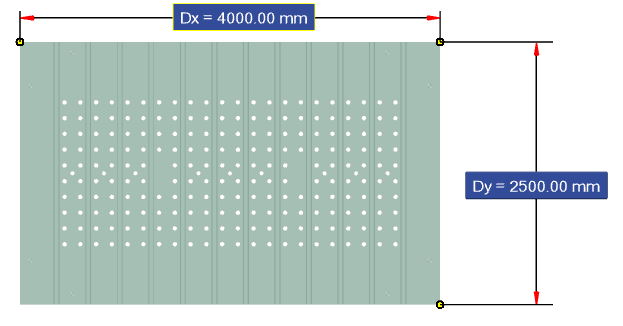
[picture p272: figure]
Recorte de pantalla

Distance between slots

Locator T021

## Slide 32

PR B4

Press | Type | BOLSTER L-R | BOLSTER F-B | STROKE | Common Shut Height | Minimum Shut Height | Maximum Shut Height | TONNAGE | Minimum Strokes P/Minute | Maximum Strokes P/Minute
PRB4 | TANDEM | 3048 | 2134 | 813 | 1194 | 1168 | 1305 | 800 | 12 | 12

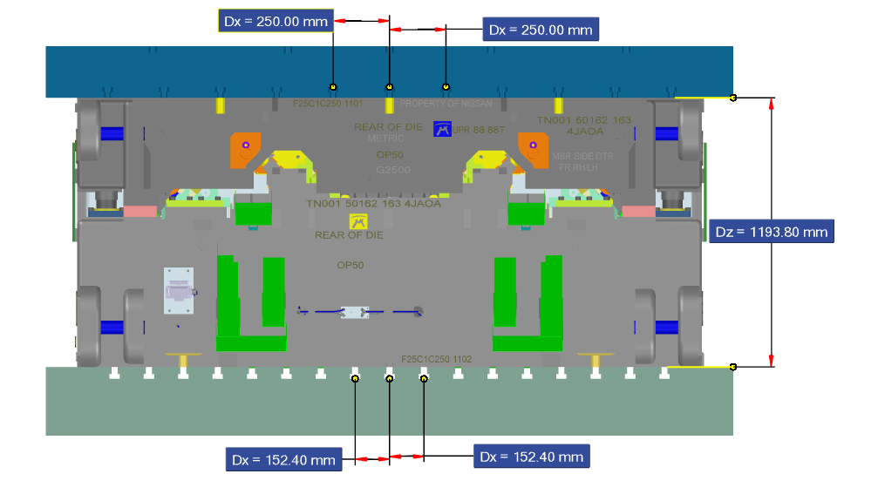
[picture p273: figure]
Recorte de pantalla

TANDEM

Image with closed press

Distance between slots

Common Shut Height

1194mm

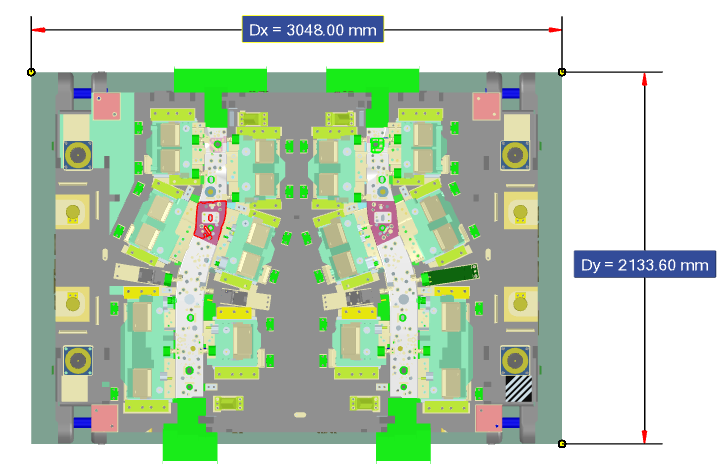
[picture p274: figure]
Recorte de pantalla

Distance between slots

Locator T021

## Slide 33

- 1-8-2018 We add ´transfer curves to press 24,25,26
- 2-8-2018 Modification in the press 11 information .(common shut height ).
- 10-8-2018 Modificación in the HS información. (common shut height ).
- 10-8-2018 We add preferred load height information to press HS
- 28/8/2018 we add information of SPM and max coil width.

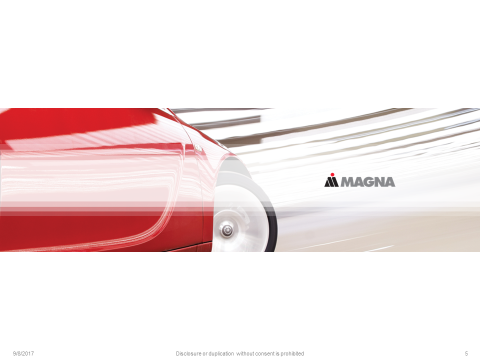
[picture p275: figure]
