MCBailey-CTS/0Library/SeedFiles/ClampFeetDocs/Dennen QOI-02.014-Die Build-Tooling Standards (Corp) Rev T Page 3.docx

Purpose: To define the standa

2.8 Parallels must have mounting feet for press clamping.

Provisions for clamping must be easily accessible.

Slot location and dimensions are shown here unless otherwise noted.

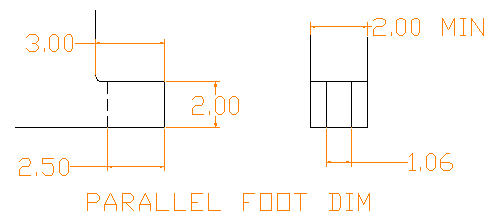
[picture p276: figure]

Dennen Quality Systems Title: Die Build -Tooling Standards Doc. # QOI-02.014 Department: Tooling Management Rev. T Date Created: 03/29/2005 Date of Last Revision: 02/08/2018
