MCBailey-CTS/0Library/SeedFiles/ClampFeetDocs/Dennen QOI-02.014-Die Build-Tooling Standards (Corp) Rev T.docx

Purpose: To define the standards for new tooling used in Dennen Steel stamping presses.

Scope: This instruction applies to all tools designed for Dennen Steel stamping presses.

Responsibility: The Corporate Engineering Manager is responsible for ensuring that this instruction is adhered to.

Method:

1. Build Sequence

1.1 Strip layout and approval.

1.2 Die design and approval. All designs are to be the property of Dennen Steel and will be supplied to Dennen Steel in a CAD format designated by Dennen Steel.

1.3 Die components are to be fully detailed outside of the die design and have CAD for each component. Any changes to details will be documented in CAD prior to sign-off. All detail CAD is to be the property of Dennen Steel and will be supplied to Dennen Steel in a format designated by Dennen Steel.

Part Quality Requirements / Tooling Approval

1.4 A minimum of 300-piece trial run-off in continuous mode is to be performed at the tool shop with tool shop personnel in attendance. Dennen Steel is to be notified of the trial run-off no less than 48 hours prior.

1.4.1 Minimum of six (6) pieces required for samples; full dimensional layout required on two (2) of the samples.

1.4.2 Tool source is to provide inspection report with road map for 2 full layout pieces. All print dimensions must be checked.

1.4.3 Parts must be certified to six sigma capabilities (1.67 or greater) for all critical dimensions.

1.4.4 Dimensional tolerances are not to exceed 80% of specification allowance.

1.4.5 Tool will not be authorized to ship until DS has reviewed and approved all inspection reports and capability studies performed.

1.5 A Die Design and Inspection Checklist (DSC-570) is to be completed and approved by the Manufacturing Engineering Manager prior to tool being shipped to Dennen Steel.

1.6 Web and last parts off are to be identified and accompany the 350 pieces from run-off and shipped along with the tool. Draw/forming tools must have latest version spotting panels shipped with the tool to show form conditions. These spotting panels should be preserved in clear lacquer prior to shipment. An 80% bearing or read through is to be demonstrated with spotting panels.

1.7 Any die failures/dimensional issues are to be corrected and documented by tool shop prior to first run on Dennen Steel equipment.

1.8 Final approval at Dennen Steel requires a run at rate for one complete lot size with approved quality sign offs.

1.9 In all cases, dimensional tolerances of sample submission parts are not to exceed 60% of print tolerance unless otherwise specified.

2. Die Sets/Parallels

2.1 Die sets are to be permanently stamped with the following on the operator side of the die. All dimensions are to be in inches: (1/4” stamp height minimum)

• Tool ownership

• Customer part number Dennen Part Number

• Operation Number Tool number

• Shut height Approximate tonnage

• Feed/Pitch Length Coil/Strip width

• Material thickness Material Grade/Type

• Die top weight Lower die weight

• Die total weight Build source

• Die size (F to B x L to R)

• “C/C” or “S/C” Identifier if part produced is Product Safety critical (WI-000049)

The die sets must also be stenciled in a large contrasting color (1” minimum stencil height). Label all four sides of the die set with the following items.

- Tool Number
- Flow
- Shut height
- Total weight
- Upper Die Weight
- “C/C” or “S/C” Identifier if part produced is Product Safety critical (WI-000049)

2.2 The top and bottom die shoes are to be tapped with 3/4″ x 10 thread handling holes minimum. The die size and weight will determine if larger holes are needed. Permanently mounted lifting devices for top and bottom die sets are preferred. Provide fork pockets/hi-lo access between lower parallels. Fork pockets must be labeled.

2.3 All die sets are to be of ball bearing pin design with four (4) pins minimum and corner heel blocks. Die sets to be manufactured by Danly, or an approved supplier. Die set thickness is to be three (3) inches minimum. One (1) ball bearing pin is to be offset left to right to error-proof die assembly. All ball bearing cages on tool to be full rotating design.

2.3.1 For dies that are form tools only, no guide pins are needed.

2.4 A minimum of four (4) stop blocks are to be mounted over parallels on all die sets and each block is to have a .500″ x .050″ groove. Stop block size to be 2" x 4" minimum. Depth of lead groove is to be stamped in each stop block.

2.5 Quick die change features are to be incorporated on all die sets. Cone locators are to be used in all new tools. Cone locator bushing will be supplied by tool source. Locator bushing retainer must be attached with screws. Any parallel or riser that controls die alignment is to be doweled to the die set with 3/4" dowels.

2.6 Drain holes extending through the die shoe must be installed in any spring pocket.

2.7 Minimum parallel width to be 2". Die set to parallel screws to be 5/8" diameter minimum.

2.8 Parallels must have mounting feet for press clamping.

Provisions for clamping must be easily accessible.

Slot location and dimensions are shown here unless otherwise noted.


2.9 The die set and parallels will be painted per Customer/Dennen Steel requirements.

3. Die Steels

3.1 Cutting steels are to be A2 or equivalent.

3.2 Form steels are to be D2 or equivalent.

3.3 Draw steels are to be D2 or equivalent.

3.4 All sharp corners are to be removed on nonfunctional surfaces.

3.5 Buttons or inserts must be used in any pierce section. Button or insert must bottom out on the retaining steel or backing plate and not on the die set or sub plate. No headed buttons are to be used.

3.6 All ball-lock punches are to be heavy duty (Dayton) coated with TIN.

All ball-lock retainers are to be Tru-Position.

3.7 Progressive dies will have an idle station towards the end of the die for future engineering changes.

3.8 All die steels must clear the guide pins 1 ½ inches to facilitate guard mounting.

3.9 All extrude punches and high wear steels are to be coated.

3.10 Maximum trim steel size is 12" x 12".

3.11 Any die steel subjected to thrust conditions must be doweled and keyed or inserted.

3.12 Dowel entry to be 200%. For example, a 1/2" dowel should enter the die set by 1" and the steel it is locating by 1".

3.13 All dowel holes to be cleared through shoe and reamed to the correct depth.

3.14 Changeover steels and any other component that will be removed frequently shall have bushing liners installed in die shoe for dowels. Changeover sections must be labeled with part numbers to assist in change-over verification. See 9.5 for documentation requirements.

3.15 All die steels are to be labeled with detail number, material type, build source, and hardness.

3.16 Upper dowels to be slip fit and capped in each detail with set screw.

3.17 Where possible, room for die protection sensors will be made available.

3.18 Any threaded hole in a hardened detail must be tapped with an oversized tap.

3.19 All details must have some type of threaded holes for handling.

4. Pierce Part and Scrap

4.1 All pierce and trim punches must have slug ejectors.

4.2 All pierce and trim buttons are to have Dayton Slug Control (XSC)

Any Pierced hole that can not be placed in a die button must still have slug control feature.

4.3 Parallels must not interfere with scrap/slug ejection.

4.4 No air ejection is to be used for part or scrap removal. Parts must fall free of die set.

4.5 Parts and scrap are not to be mixed.

4.6 All new parts are to have the capability of date code stamping. If date code stamping is required, the location is to be determined at design. A six (6) character stamp holder would then be required. Argon ARG-101 stamps/retainers to be used.

4.7 Provisions for a customer part number stamp, nine (9) characters, are to be in each part. Location to be determined by end user or DSC.

4.8 Multiple out dies must have provisions for cavity designation.

4.9 Where tool has multiple cavities and each cavity part is stamped with a unique identifier/part #, the stamp retainers shall be error proofed and designed to only locate in one cavity. For example retainers for LH and RH stamps should not be able to be reversed and installed in the incorrect cavity.

4.10 Punches to be Dayton heavy-duty ball-lock coated with TIN.

Punches for material thicker than .150” must be Dayton Tuff punches, coated with TIN.

4.9.1 Tool design features to consider for HSLA material applications

4.9.1.1 Increase punch/button clearance to 12 - 15%

4.9.1.2 Minimize punch entry

4.9.1.3 XAN punch coating

4.9.1.4 Conical tip punch

4.9.1.5 Tapered button vs. slug control style

4.11 Shear on all trim punches to be 1-1.5 times material thickness.

4.12 Pierce and trim punches shall be staggered by a minimum of one material thickness to reduce tonnage.

4.13 Pierced hole diameter to stock thickness will follow the 1.5 industry standard ratio. This is especially critical for HSLA applications. Combination chamfer and pierce punch designs will not be utilized to reduce the likelihood of punch breakage and missed holes.

4.14 Maximum slug/off fall size shall be 6.0”.

5. Pressure and Coolant Systems

5.1 Pressure pins under all pads and strippers are to be headed to prevent falling out during use and storage.

5.2 All springs are to be Dayton and must be equipped with cages.

5.3 All Nitrogen plumbing to be guarded against damage during use, storage and cleaning. Guarding is to be a minimum of 3/16" thick steel.

5.4 All gas springs are to be Hyson or Dadco.

5.5 No pre load allowed on gas springs.

5.6 Nitrogen pressure is to be stamped next to pressure gauges. Paint pen/permanent marker is not allowed.

5.7 Coil spring deflection is not to exceed 25%.

5.8 Coolant spray nozzles are to be hard mounted where feasible, and routed to a central connection. Preference is to mount nozzles in the upper tool, directed down to prevent overspray outside the tool.

6. Component Accessibility and Adjustability

6.1 All die sections must include jackscrew holes.

6.2 All pierce punches are to have window access and include clearance for punch shank and hole for punch ejection. Clearance for pliers/punch removal tool is necessary. Where windows cannot be used, entire stripper must be removable in press.

6.3 All cutting or forming details must have hardened back up plates with provisions for sharpening and/or shimming adjustments.

6.4 All forming details that are affected by material variation must be adjustable in press.

6.5 No die section for forming will have a trim area on the same steel.

6.6 Slide surfaces to be hardened and/or Lamina plates with means of adjustment. Lubrication points will be provided with ease of access for the operator /tool maker.

7. Strip Starting/Stock Guides

7.1 Pitch notch is required on front edge of strip, unless otherwise approved by Dennen Steel.

7.2 One stock guide must be adjustable to allow normal mill tolerance on the given width of material.

7.3 Strip edges that become the edge of a finished part are to be protected from gouging/galling in the tool. Roller guides, cam followers, stock guide coatings, or the equivalent must augment rail guides. Design is to be approved by Dennen Steel.

7.4 Stock guides must extend past cutoff to minimize drifting of strip.

7.5 First hit location must be clearly identified on the die.

8. Die Size/Tonnage

8.1 Tools must weigh less than 30,000 pounds at Grand Rapids MI and 15,000 pounds at Burns Harbor IN.

8.2 Tools should not exceed 90% of the total available tonnage of the press they are designed for (recommended).

8.3 Reverse tonnage should not exceed 10% of the total forward tonnage of the tool (recommended).

9. Special Build Requirements for Surface Critical parts (Class A & B)

9.1 No tool marks are allowed on show surface of the part.

9.2 All pads will need standoffs.

9.3 Clearance from pads to trim steels and punches cannot exceed .015”

9.4 Show surface of the part must be protected against rubbing or sliding across die components.

9.5 If edge of coil is edge of part, coated stock rails shall be used with the front rail fixed, and the rear one spring loaded.

9.6 Coil strip needs to be supported throughout the die to keep it flat.

9.7 All lifters should be made from brass or plastic, with rounded edges to prevent galling.

9.8 Lifter springs should be very light duty to prevent marking the part on the bottom.

10. First Production Run

10.1 Build source toolmaker support and presence is required at first production run. This includes tools made for the Dennen Steel Burns Harbor, IN facility. If changes are made during tryout run, tool source must attend subsequent run.

10.2 Tooling to be certified by tool source to six sigma capability (1.67 or greater on critical dimensions).

10.3 One complete set of back-up punches and buttons are to accompany any new die.

10.4 All die design and detail CAD will be provided on a CD or flash drive.

10.5 The tooling supplier will be responsible to provide written & electronic work instructions, (in Word, with pictures) for any die change-over process. These written & electronic work instructions for the die change over process will be clear enough that a lead operator can follow to make the tooling changes. The tooling supplier will provide a master template out of an aluminum sheet 0.12 thick to verify the change.

Note: Exceptions and changes will be made when necessary and must be agreed upon and signed off by qualified Dennen Steel representative.

Design approval by Dennen Steel does not relieve the tool source from the responsibility of supplying a tool that produces a dimensionally correct part at expected production rates.

Dennen Quality Systems Title: Die Build -Tooling Standards Doc. # QOI-02.014 Department: Tooling Management Rev. T Date Created: 03/29/2005 Date of Last Revision: 02/08/2018
