MCBailey-CTS/0Library/HeelAssemblies/Metric/Components/Pulled from CamAssemblies.txt

Smart NAAMS Wearplate Metric - W031015 WEARPLATE (20 x 100 x 150) Bronze
Smart NAAMS Wearplate Metric - W021015 WEARPLATE (20 x 100 x 150) Steel
