MCBailey-CTS/0Library/GuidePins/Catalogs/Danly mistery M values.JPG

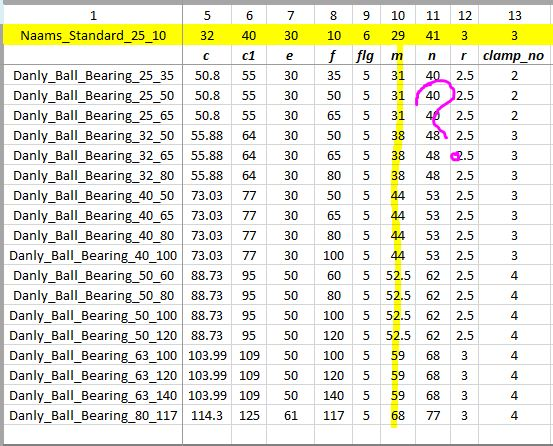
GuidePins/Catalogs/Danly mistery M values.JPG
