MCBailey-CTS/0Library/SeedFiles/ClampFeetDocs/192 - Silverton Engineering Clamp Feet (FR-944-025-TOOLING GUIDELINE.JPG

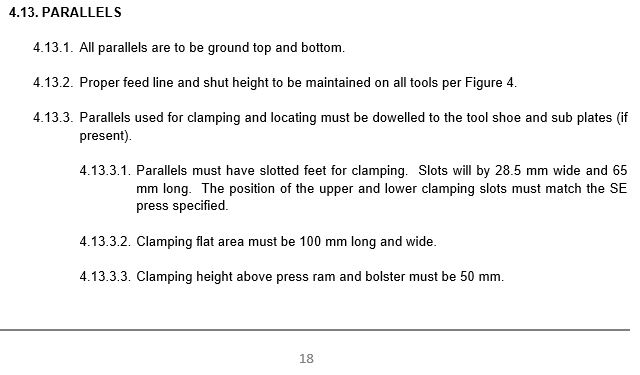
SeedFiles/ClampFeetDocs/192 - Silverton Engineering Clamp Feet (FR-944-025-TOOLING GUIDELINE.JPG
