MCBailey-CTS/0Library/Documentation/ModifiedFastenersIssue.pdf

## Modified Fasteners Issue (NX11)

Issue – If there are modified fasteners in a design, it causes unnecessary updates and slows save/load times.

Cause - This happens when fastener(s) are wave linked and the “Fix at current time stamp” check box is on. Note all ufunc’s that wave link turn this off.

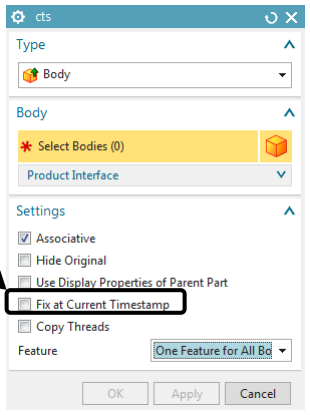
[picture p279: figure]

# Make sure “Fix at Current Timestamp” is check off when

manually wave linking bodies.

Example

How to see if design has modified fasteners:
File – Close – All Parts
If there are fasteners in the list, they are modified.

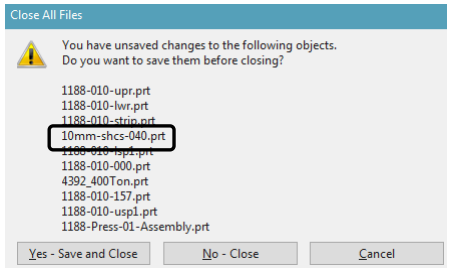
[picture p280: figure]
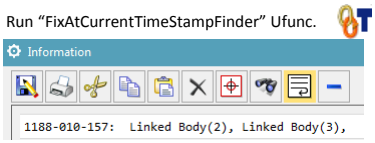
[picture p281: figure]

Run “FixAtCurrentTimeStampFinder” Ufunc.

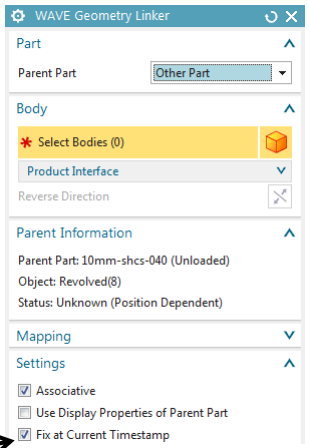
[picture p282: figure]

Make 1188-010-157 the displayed part and double click on Linked Body (2) and check OFF “Fix at Current Timestamp” and select OK. Repeat for Linked Body(3).
Save the file and the next time you open the assembly, the 10mm-shcs-040 fastener will no longer show as modified.
