MCBailey-CTS/0Library/0Customer/UGS/2103-000_Details 105 & 106.PDF

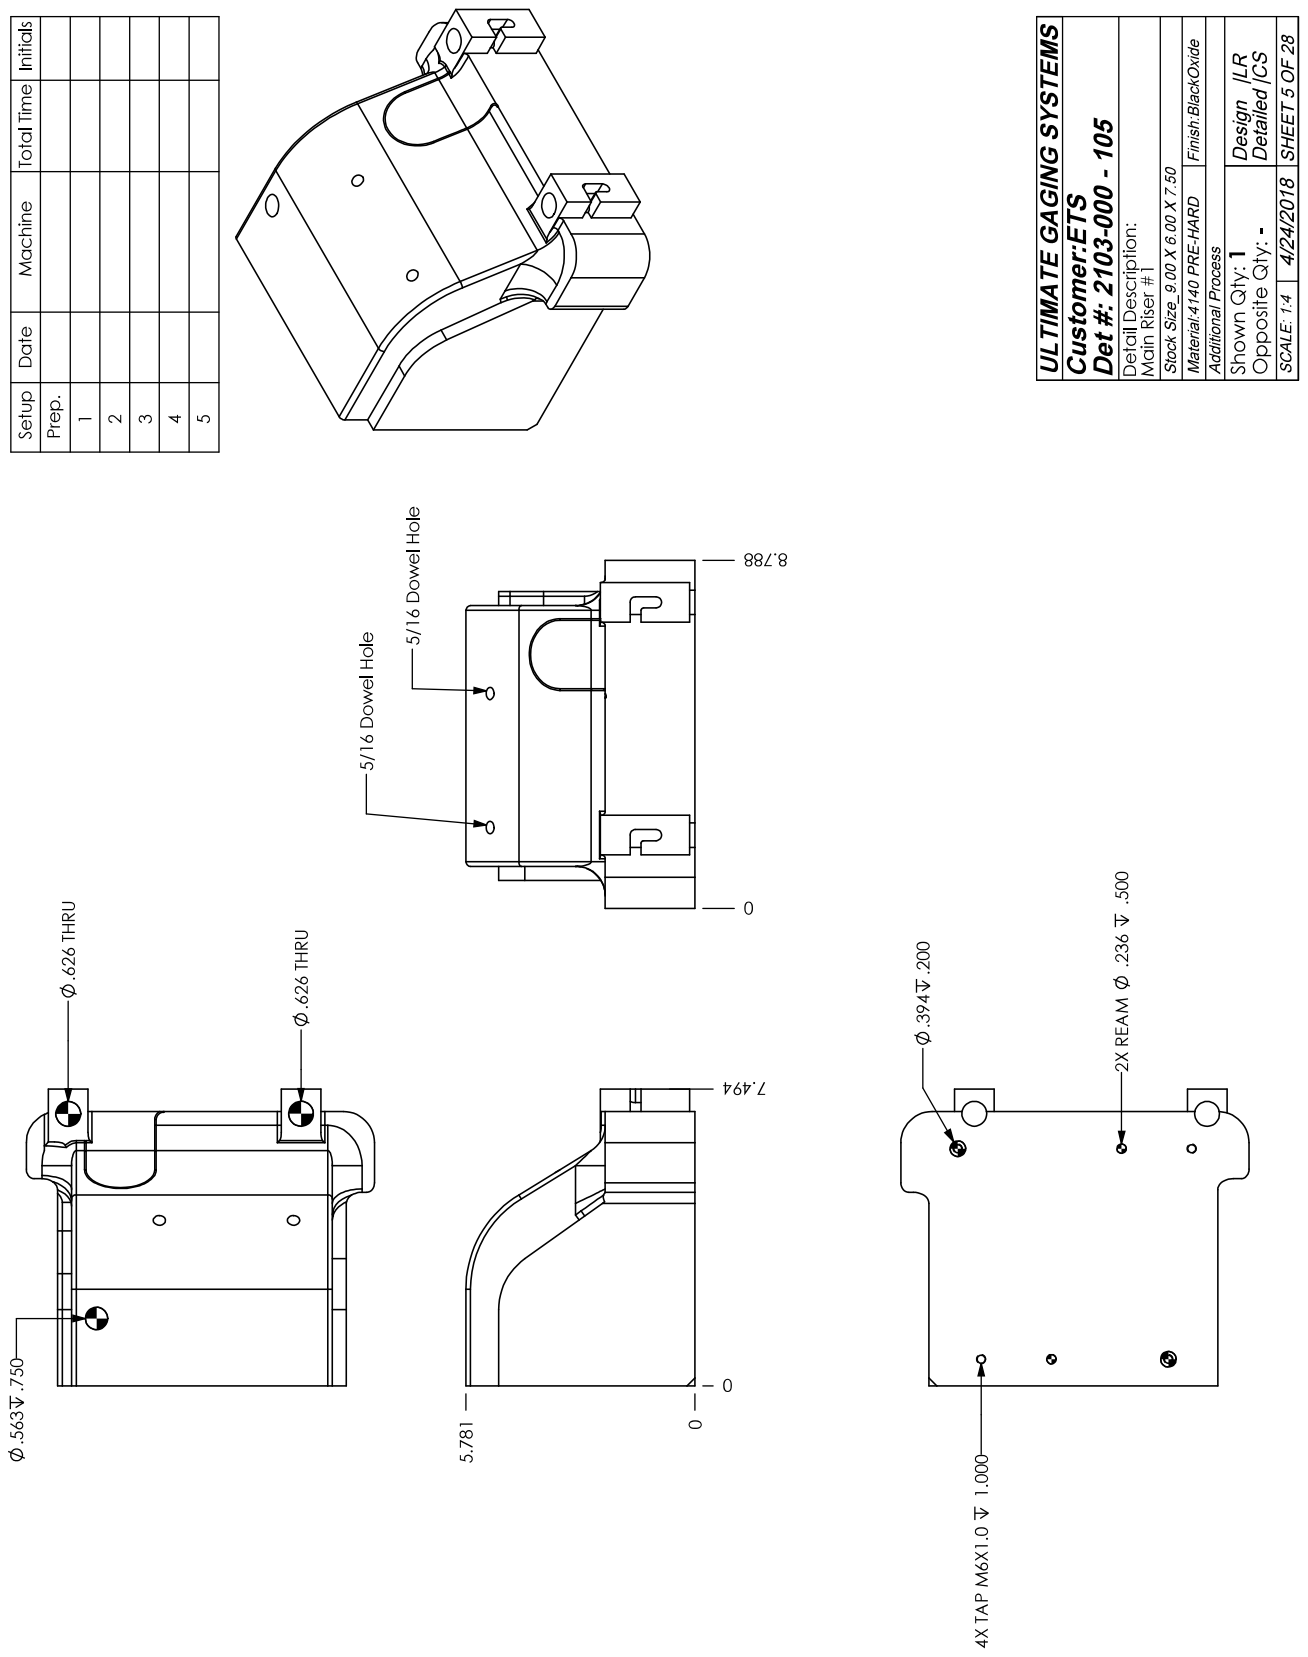
[picture p315: page 1]
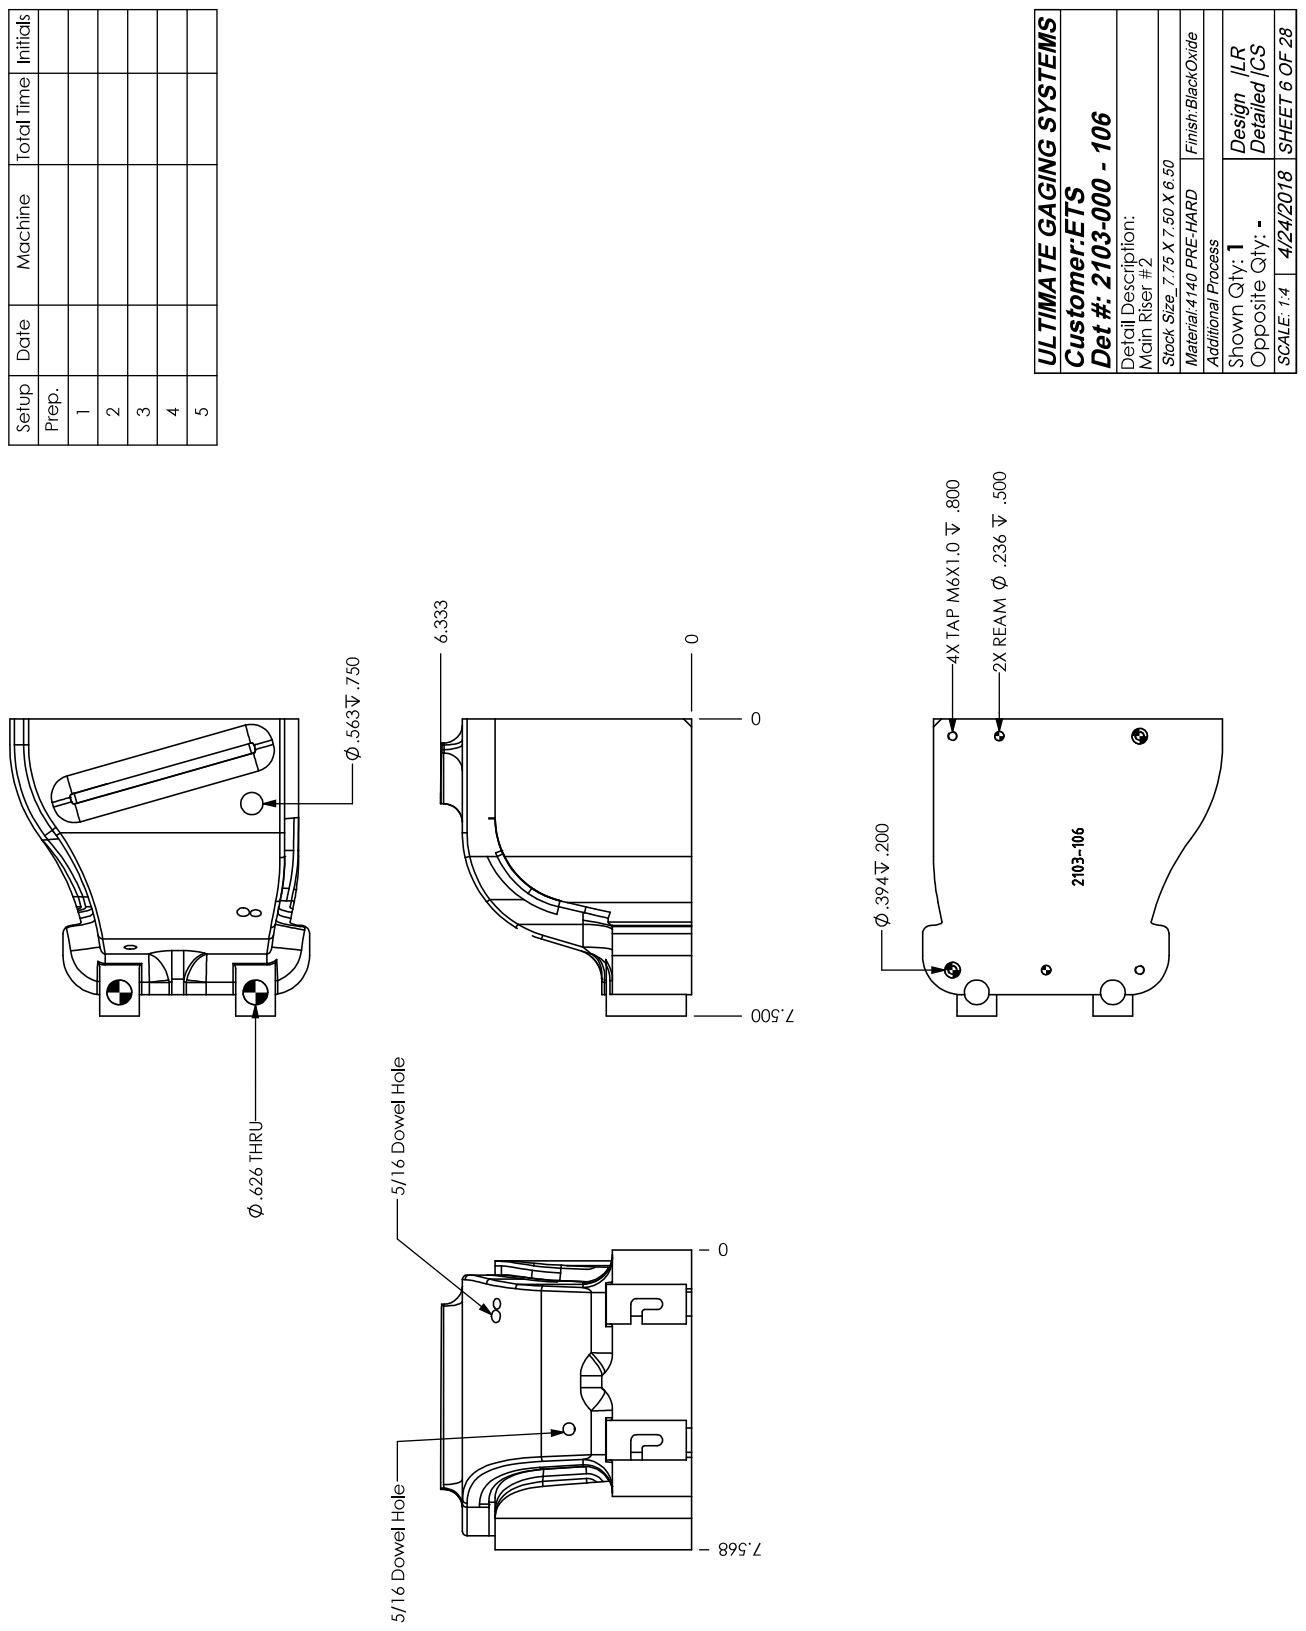
[picture p316: page 2]
