MCBailey-CTS/0Library/DieSetGuidePlates/Metric/Misumi/Oil Free Heel Guide Plates OG.pdf

OIL-FREE HEEL GUIDE PLATES | HEEL GUIDE PLATES WITH OIL GROOVES

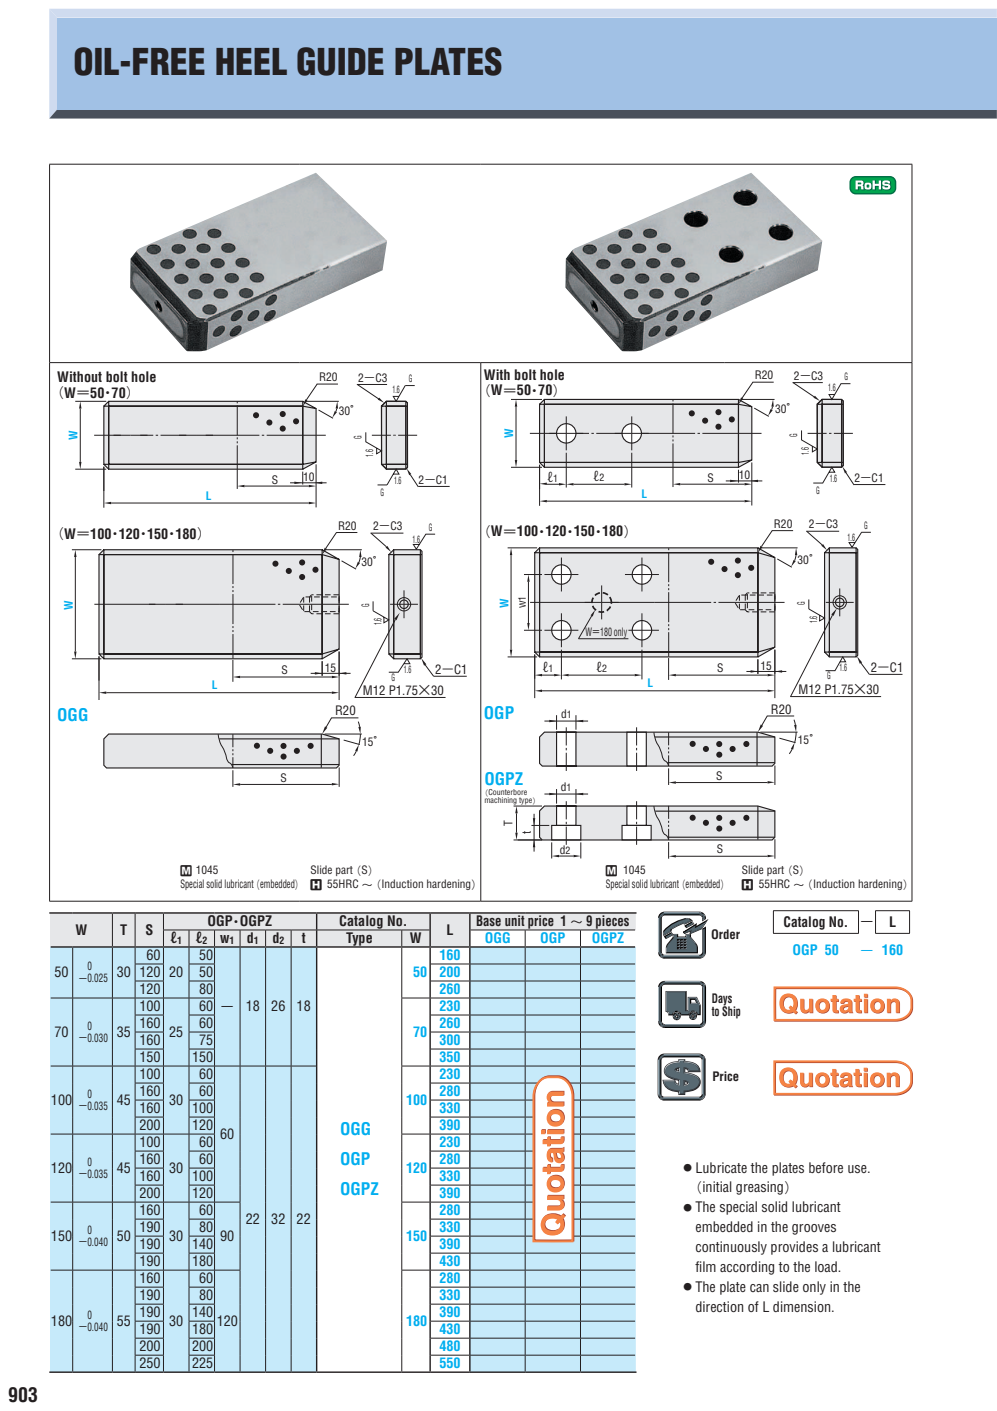
[picture p283: page 1]
Slide part （S） ʻ 55HRC ～（Induction hardening）; W＝180 only; OGP・OGPZ; Catalog No.; Base unit price 1 ～ 9 pieces ℓ1; Type; OGG; OGP; OGPZ; Order; OGP 50; Days to Ship; （Counterbore machining type）; Price

Without bolt hole

With bolt hole

Special solid lubricant （embedded）

－0.025 | 30 | 60 | 20 | 50 | － | 18 | 26 | 18 | OGG OGP OGPZ | 50 | 160

120 | | 50 | | | | | | | 200
120 | | 80 | | | | | | | 260

160 | | 60 | | | | | | | 260
160 | | 75 | | | | | | | 300
150 | | 150 | | | | | | | 350

160 | | 60 | | | | | | | 280
160 | | 100 | | | | | | | 330
200 | | 120 | | | | | | | 390

● Lubricate the plates before use.
（initial greasing）
● The special solid lubricant
embedded in the grooves
continuously provides a lubricant
film according to the load.
● The plate can slide only in the
direction of L dimension.

190 | | 80 | | | | | | | 330
190 | | 140 | | | | | | | 390
190 | | 180 | | | | | | | 430

200 | | 200 | | | | | | | 480
250 | | 225 | | | | | | | 550
