MCBailey-CTS/0Library/0Customer/UGS/2103-000_Details.PDF

PIN SIZES TOLERANCES

DESCRIPTION | Tolerances
LOCATOR PINS | .01MM
STAB PINS | .01MM
GO PINS | +.015MM/-.000MM

ULTIMATE GAGING SYSTEMS
Customer:ETS
Job # 2103-000
MACHINING TOLERANCES
Date:4/24/2018

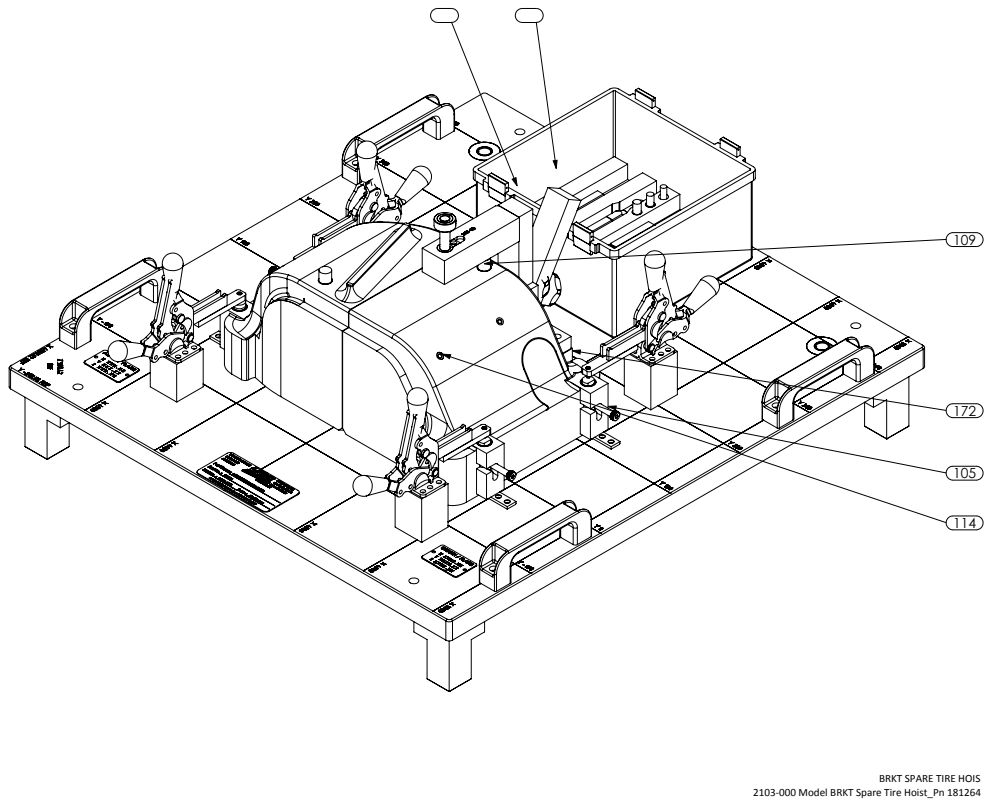
[picture p284: page 2]

BRKT SPARE TIRE HOIS

2103-000 Model BRKT Spare Tire Hoist_Pn 181264

Det # | QTY. | Shown Qty | Description | StockSize | Material | Vendor
100 | 1 | 1 | Base Plate | 25.00 X 27.00 X 1.00 | CT & J Aluminum | Clinton
101 | 4 | 4 | Gage Handle | Plastic Handle JCL-1675 | PUR | ESS
102 | 4 | 4 | Destaco Clamp 2002-U | DESTACO CLAMP # TC-2002-U | PUR | ESS
103 | 4 | 4 | Headless Drill Bushing | 1/2 ID X 5/8 OD X 3/4 L | PUR | United
| 1 | | NEMA Box 7.874 x 7.874 x 5.906 | 200.00 X 200.00 X 150.00 - NBF-32014 | PUR | MouserElectronics
105 | 1 | 1 | Main Riser #1 | 9.00 X 6.00 X 7.50 | 4140 PRE-HARD | Goodmet
106 | 1 | 1 | Main Riser #2 | 7.75 X 7.50 X 6.50 | 4140 PRE-HARD | Goodmet
107 | 1 | 1 | Shaft collar | Shaft Collar #6435K130 | PUR | McMaster
108 | 4 | 4 | Shoulder Screw | Shoulder Screw 91259A544 | PUR | McMaster
109 | 2 | 2 | -B-/-C-_MMC Locator | DIA 9/16" HSS DB | PUR | United
110 | 2 | 2 | Clamp Riser | 1.500 X 1.500 X 2.250 | 6061 ALUM | Clinton
111 | 2 | 2 | Clamp Ext #1 | .250 X .500 X 2.750 | CRS | Goodmet
112 | 2 | 2 | Clamp Riser | 2.0000 X 1.500 X 1.500 | 6061 ALUM | Clinton
113 | 2 | 2 | Clamp Ext #1 | .250 X .500 X 2.750 | CRS | Goodmet
114 | 4 | 4 | P Bushing 5/32 X 5/16 X 1/2 L | Bushing P-20-8-0.1563ID | PUR | United
115 | 1 | 1 | P Bushing 13/32 X 5/8 X 3/4 L | Bushing P-40-12-0.4063ID | PUR | United
116 | 8 | 4 | P Bushing 1/2 X 5/8 X 1/2 L | Bushing P-40-8-0.5000ID | PUR | United
120 | 1 | 1 | Feeler "B" | 8.50(+.00/-.02)MM X 11.50(+.02/-.00)MM Straight Feeler | PUR | United
121 | 1 | 1 | Feeler 'A' | 5.50(+.00/-.02)MM X 6.50(+.02/-.00)MM Ball Feeler | PUR | United
122 | 1 | 1 | Key | 0.125 X 0.375 X 0.500 | O-1 GS | UGS Stock
123 | 1 | 1 | Stab Block | 1.000 X 1.250 X 4.250 | 4140 PRE-HARD | Goodmet
131 | 1 | 1 | -B-/-C- GoNoGo | 7/32" HSS DB | PUR | United
136 | 1 | 1 | Pin Holder | 1.250 X 7.500 X 7.500 | RED BOARD (PP-1052) | UGS
138 | 2 | 2 | 3WSE Handle | 3WSE (HANDLE) | PUR | United
139 | 1 | 1 | PIN HANDLE | 3WDE (HANDLE) | PUR | United
140 | 1 | 1 | Stab #1 | DIA 1/4" HSS DB | PUR | United
144 | 1 | 1 | Flush Gage "A" | DIA 3/8" HSS DB | PUR | United
145 | 1 | 1 | Flush Gage "B" | DIA 3/8" HSS DB | PUR | United
147 | 1 | 1 | Stab #2 | DIA 13/32" HSS DB | PUR | United
148 | 1 | 1 | Stab #1 Go/NoGo | 9/32 HSS DB | PUR | United
149 | 1 | 1 | Stab #2 Go/NoGo | DIA 27/64 HSS DB | PUR | United
155 | 1 | 1 | Misumi Vertical Hinge_JHTS30-60 | Misumi Vertical Hinge_JHTS30-60 | PUR | MISUMI
167 | 2 | 2 | Retractable A1, A2 | DIA 0.5000 X 2.1024 | O-1 Roundstock | Goodmet
171 | 1 | 1 | Flush Gage "C" | DIA 3/8" HSS DB | PUR | United
172 | 1 | 1 | Hinge Riser | 1.0000 X 2.2500 X 4.0000 | Aluminum | Clinton
180 | 2 | 4 | Retractable Net Stop | .5000 X 0.5000 X 1.2500 | O-1 GS | Goodmet
181 | 2 | 4 | Retractor Stop Block | 0.1250 X 1.3750 X 0.5000 | O-1 GS | Goodmet
200 | 1 | 1 | UGS Standard Cart Weldment | Cart Weldment Fit Base 24.000 x 26.000 See Print | PUR | TSG
168 | 2 | 2 | Retractable A3, A4 | DIA 0.5000 X 2.3750 | O-1 Roundstock | Goodmet
Shown Qty: Opposite Qty: | Design |LR Detailed |CS
STOCK LIST | SHEET 3 OF 28

## ULTIMATE GAGING SYSTEMS

## Customer:ETS Job#: 2103-000

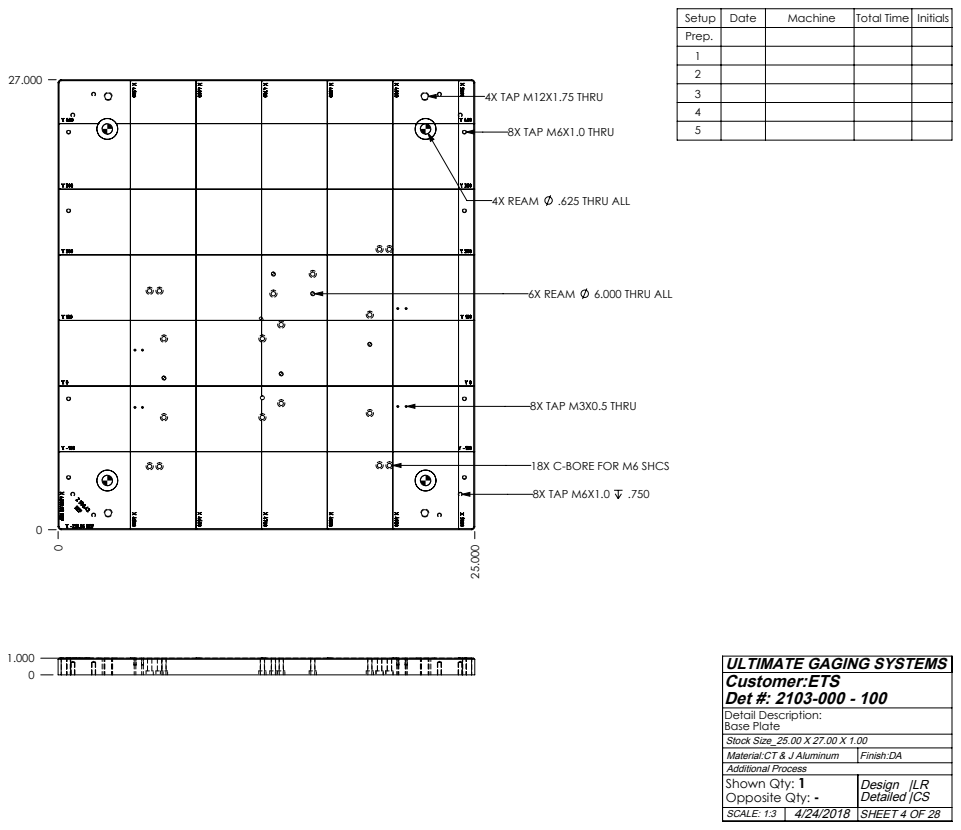
[picture p285: page 4]
4X TAP M12X1.75 THRU; 8X TAP M6X1.0 THRU; 4X REAM; .625 THRU ALL; 6X REAM; 6.000 THRU ALL; 8X TAP M3X0.5 THRU; Material:CT & J Aluminum; Finish:DA

Setup | Date | Machine | Total Time | Initials
Prep.

18X C-BORE FOR M6 SHCS
8X TAP M6X1.0 .750

ULTIMATE GAGING SYSTEMS
Customer:ETS
Det #: 2103-000 - 100
Detail Description:
Base Plate
Stock Size_25.00 X 27.00 X 1.00
Additional Process

Shown Qty: 1 Opposite Qty: -

SCALE: 1:3 | SHEET 4 OF 28

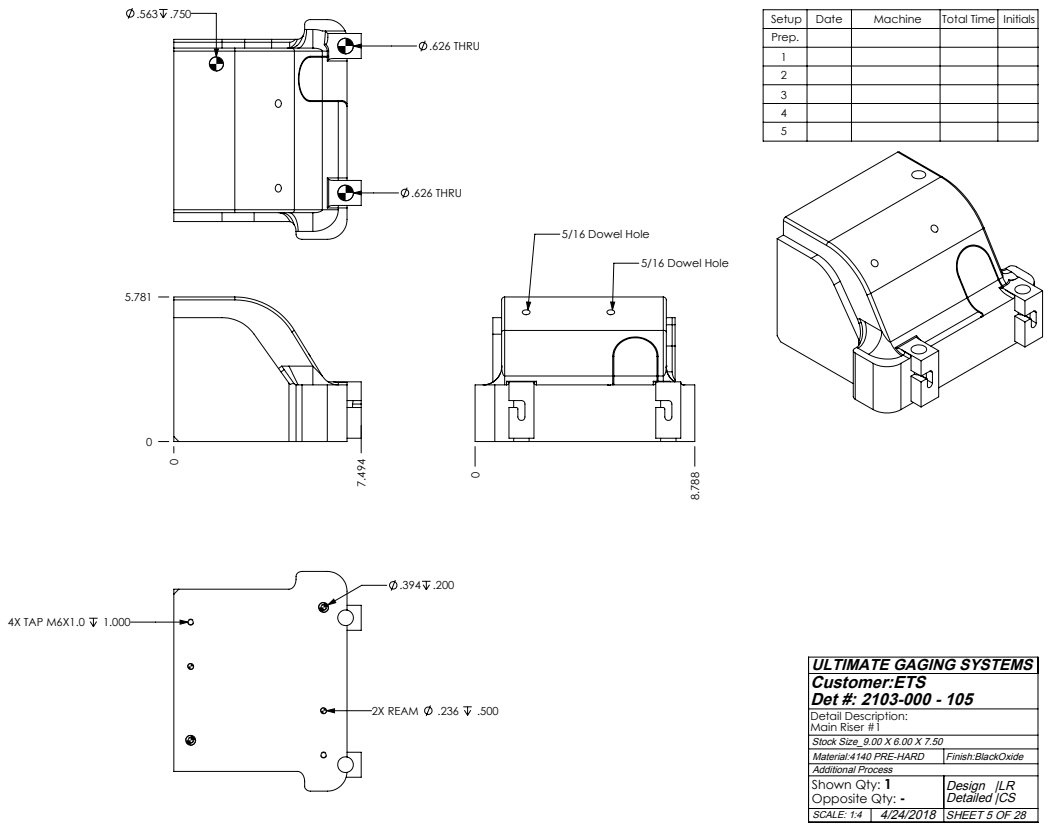
[picture p286: page 5]
.626 THRU; 5/16 Dowel Hole; 4X TAP M6X1.0 1.000; 2X REAM; Material:4140 PRE-HARD; Finish:BlackOxide; SCALE: 1:4; SHEET 5 OF 28

ULTIMATE GAGING SYSTEMS
Customer:ETS
Det #: 2103-000 - 105
Detail Description:
Main Riser #1
Stock Size_9.00 X 6.00 X 7.50
Additional Process

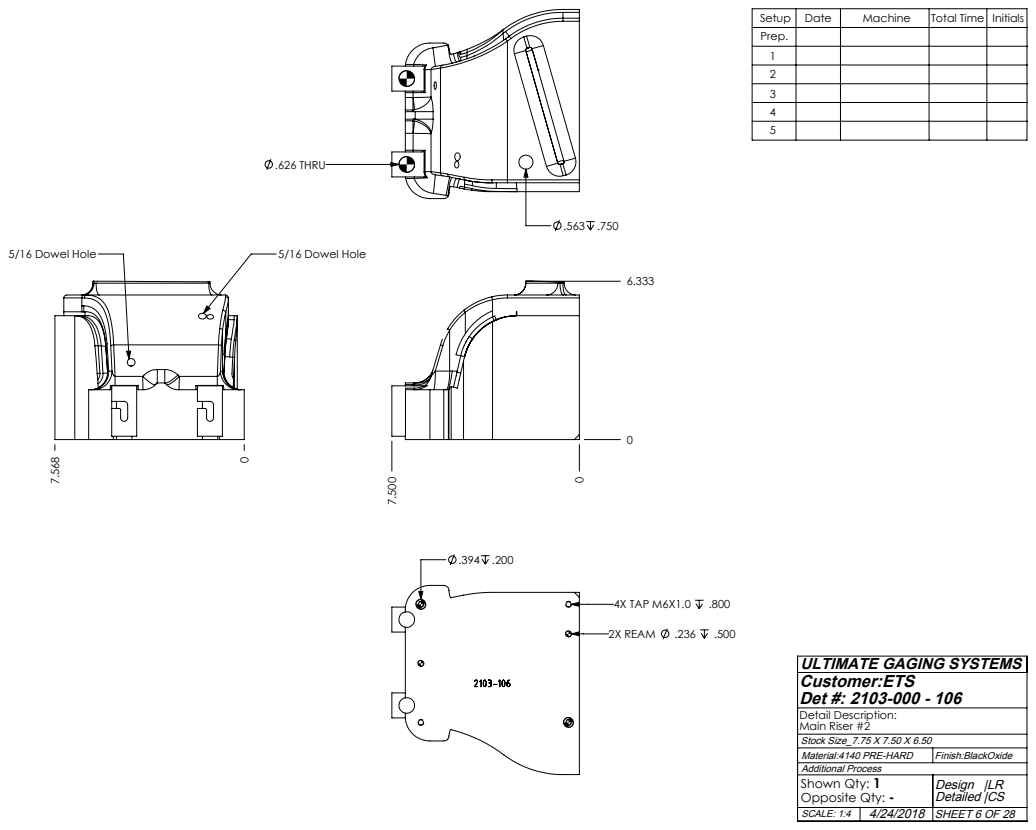
[picture p287: page 6]
4X TAP M6X1.0 .800; 2X REAM; 5/16 Dowel Hole; .626 THRU; Material:4140 PRE-HARD; Finish:BlackOxide; SCALE: 1:4; SHEET 6 OF 28

ULTIMATE GAGING SYSTEMS
Customer:ETS
Det #: 2103-000 - 106
Detail Description:
Main Riser #2
Stock Size_7.75 X 7.50 X 6.50
Additional Process

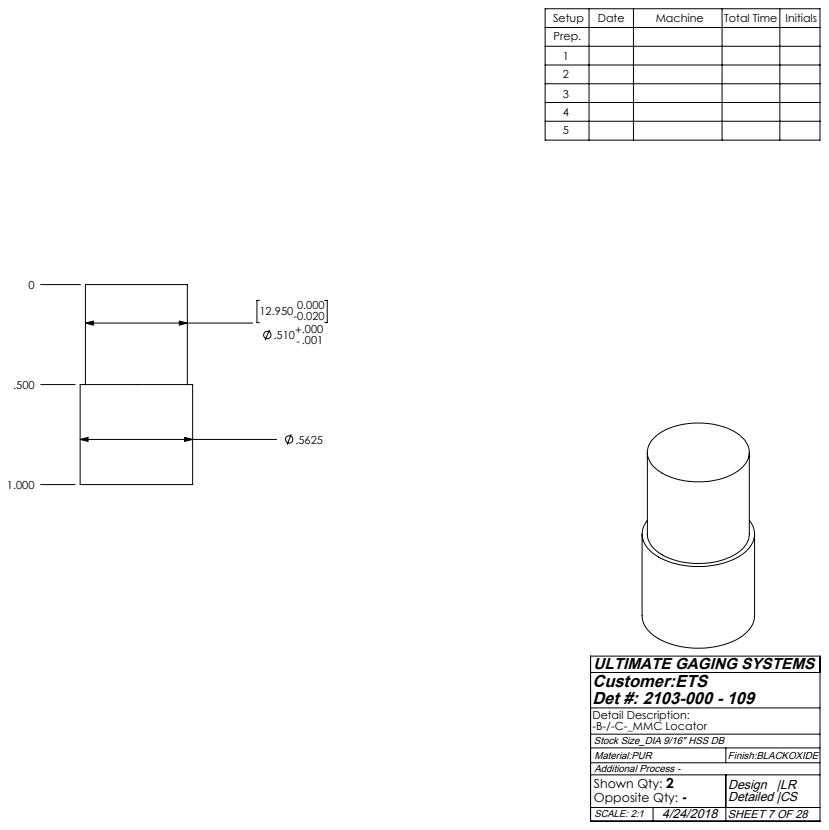
[picture p288: page 7]
SCALE: 2:1; SHEET 7 OF 28

ULTIMATE GAGING SYSTEMS
Customer:ETS
Det #: 2103-000 - 109
Detail Description:
-B-/-C-_MMC Locator
Stock Size_DIA 9/16" HSS DB
Additional Process -

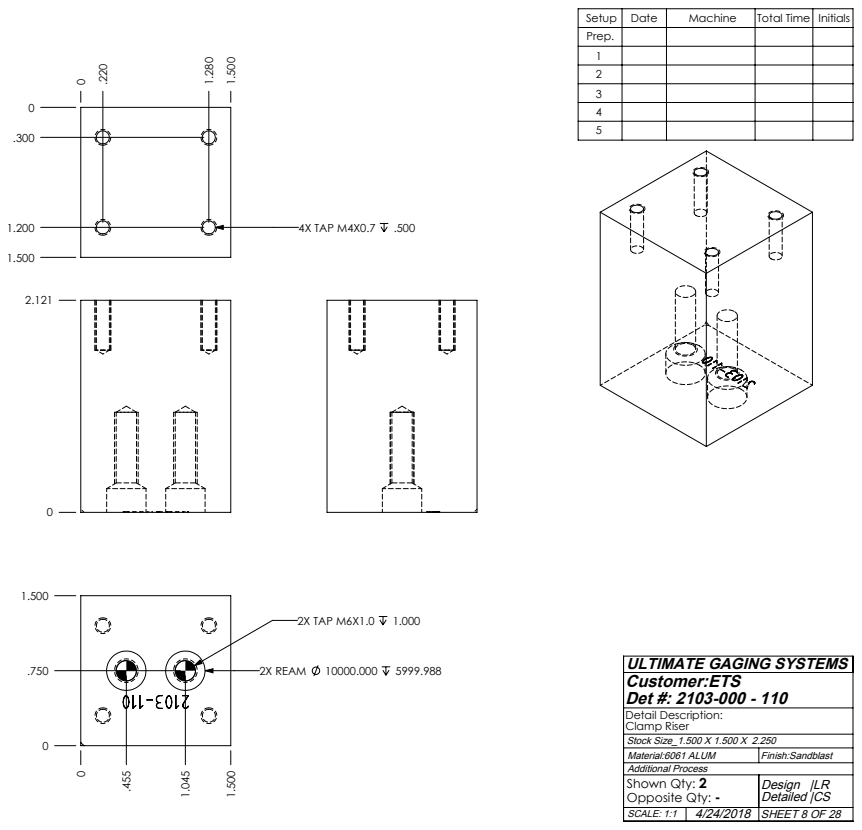
[picture p289: page 8]
4X TAP M4X0.7 .500; 2X REAM; 2X TAP M6X1.0 1.000; Material:6061 ALUM; Finish:Sandblast; SCALE: 1:1; SHEET 8 OF 28

ULTIMATE GAGING SYSTEMS
Customer:ETS
Det #: 2103-000 - 110
Detail Description:
Clamp Riser
Stock Size_1.500 X 1.500 X 2.250
Additional Process

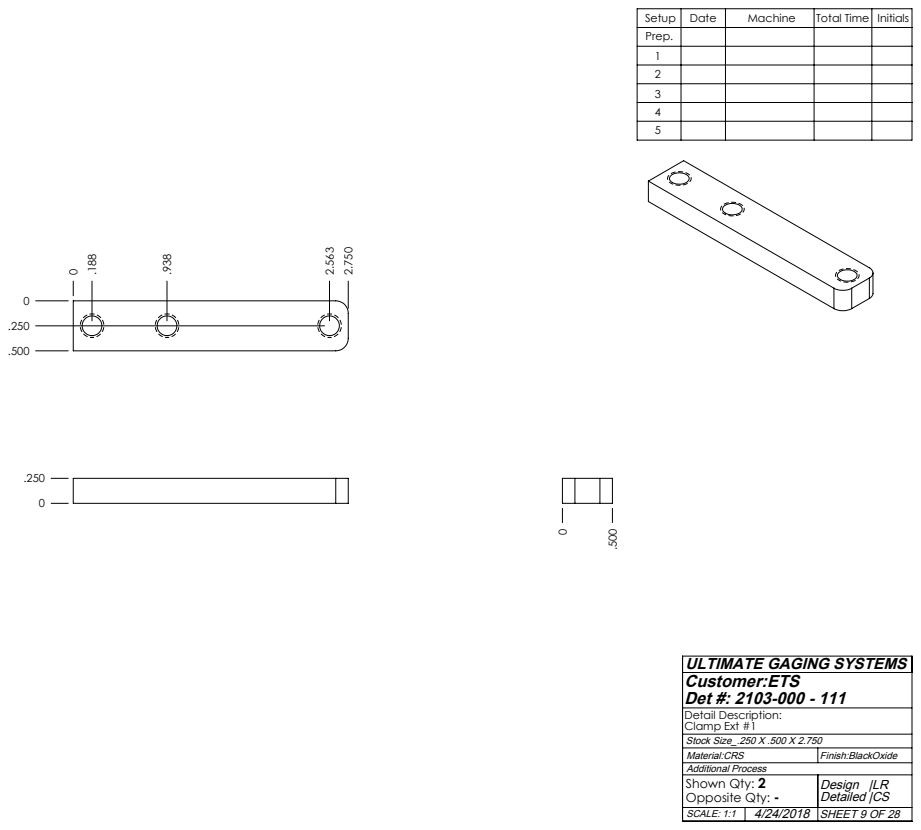
[picture p290: page 9]
SCALE: 1:1; SHEET 9 OF 28

ULTIMATE GAGING SYSTEMS
Customer:ETS
Det #: 2103-000 - 111
Detail Description:
Clamp Ext #1
Stock Size_.250 X .500 X 2.750
Additional Process

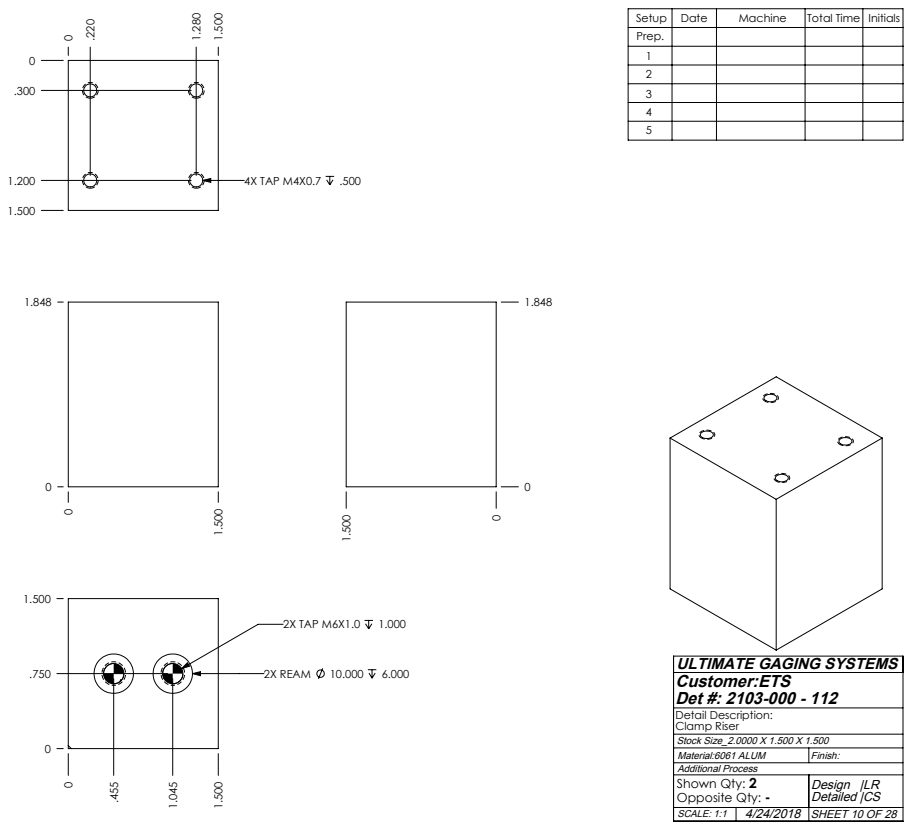
[picture p291: page 10]
2X REAM; 2X TAP M6X1.0 1.000; 4X TAP M4X0.7 .500; Material:6061 ALUM; Finish:; SCALE: 1:1; SHEET 10 OF 28

ULTIMATE GAGING SYSTEMS
Customer:ETS
Det #: 2103-000 - 112
Detail Description:
Clamp Riser
Stock Size_2.0000 X 1.500 X 1.500
Additional Process

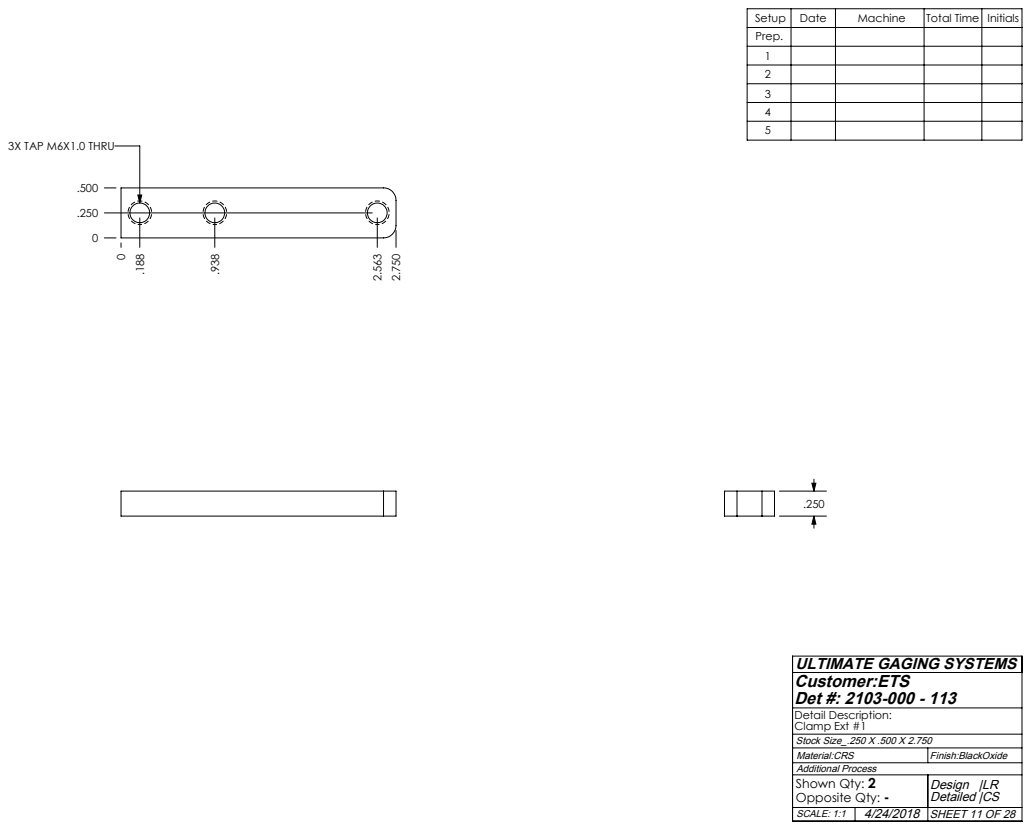
[picture p292: page 11]
3X TAP M6X1.0 THRU; SCALE: 1:1; SHEET 11 OF 28

ULTIMATE GAGING SYSTEMS
Customer:ETS
Det #: 2103-000 - 113
Detail Description:
Clamp Ext #1
Stock Size_.250 X .500 X 2.750
Additional Process

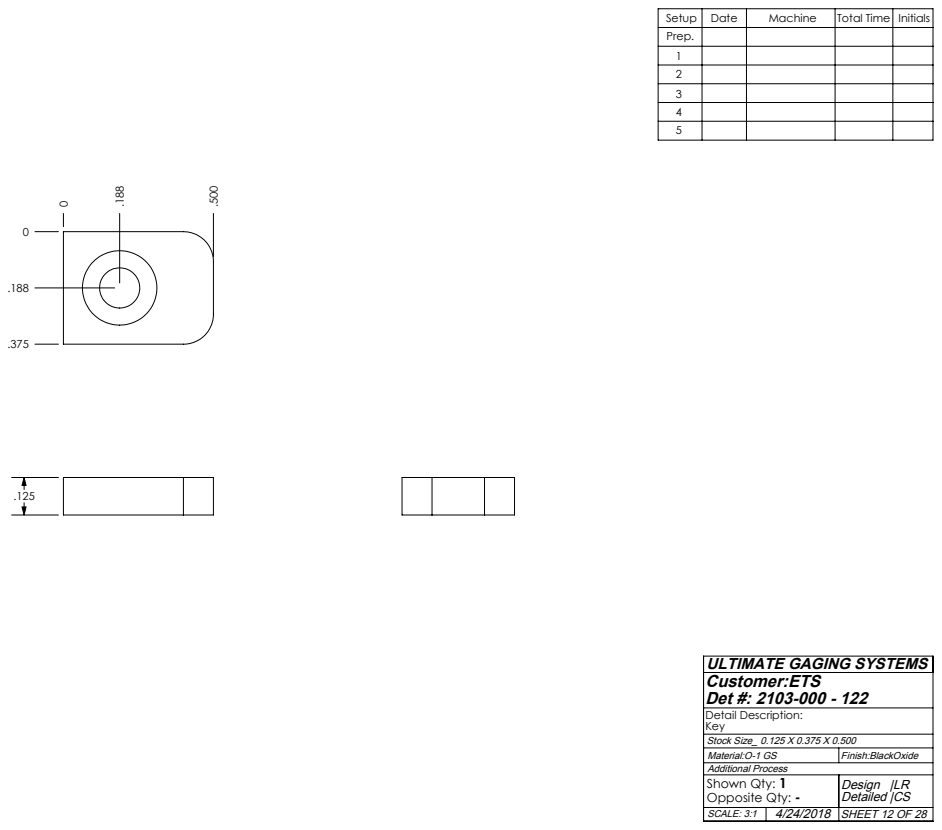
[picture p293: page 12]
Material:O-1 GS; Finish:BlackOxide; SCALE: 3:1; SHEET 12 OF 28

ULTIMATE GAGING SYSTEMS
Customer:ETS
Det #: 2103-000 - 122
Detail Description:
Key
Stock Size_ 0.125 X 0.375 X 0.500
Additional Process

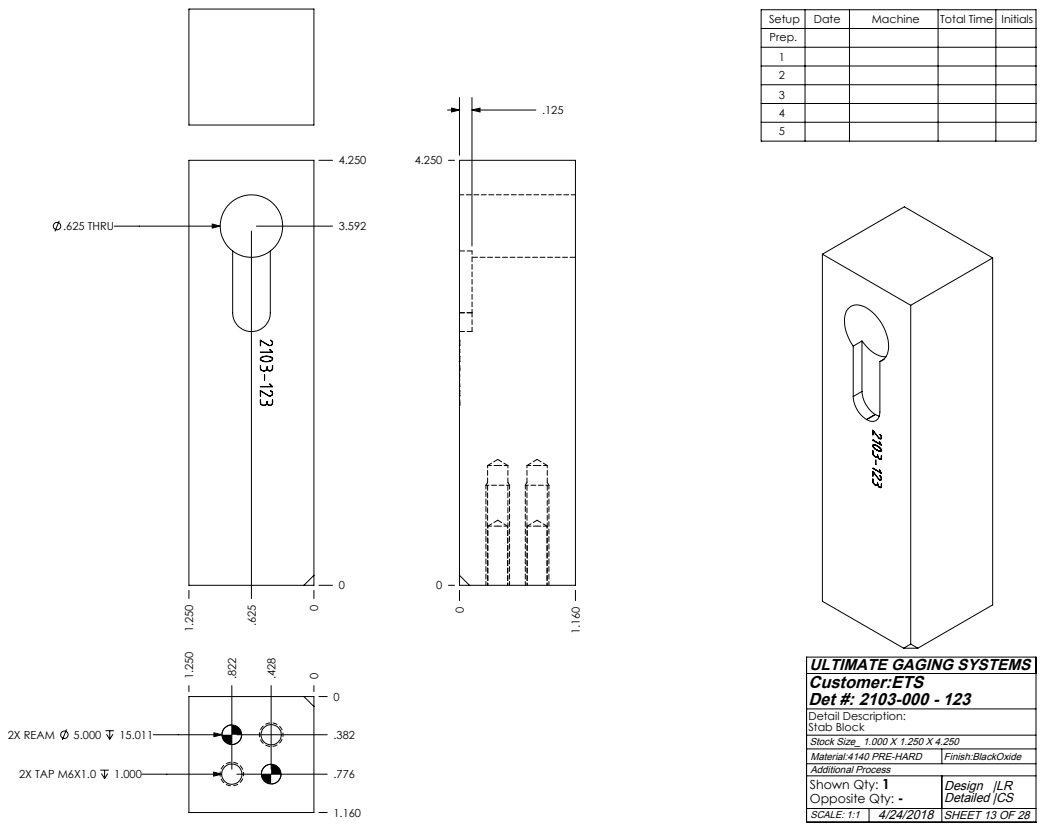
[picture p294: page 13]
2X REAM; 2X TAP M6X1.0 1.000; .625 THRU; Material:4140 PRE-HARD; Finish:BlackOxide; SCALE: 1:1; SHEET 13 OF 28

ULTIMATE GAGING SYSTEMS
Customer:ETS
Det #: 2103-000 - 123
Detail Description:
Stab Block
Stock Size_ 1.000 X 1.250 X 4.250
Additional Process

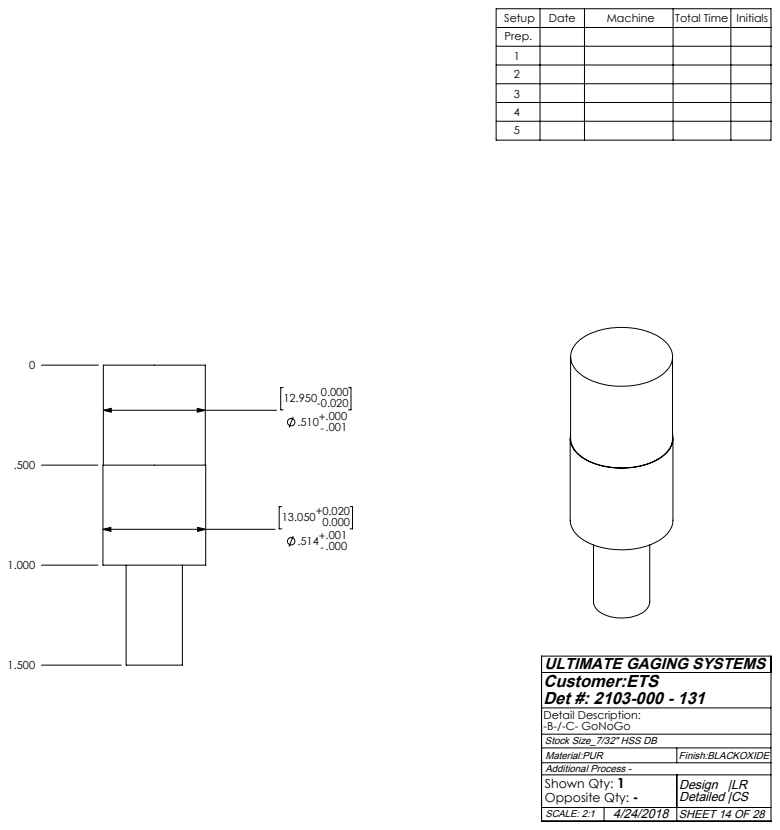
[picture p295: page 14]
SCALE: 2:1; SHEET 14 OF 28

ULTIMATE GAGING SYSTEMS
Customer:ETS
Det #: 2103-000 - 131
Detail Description:
-B-/-C- GoNoGo
Stock Size_7/32" HSS DB
Additional Process -

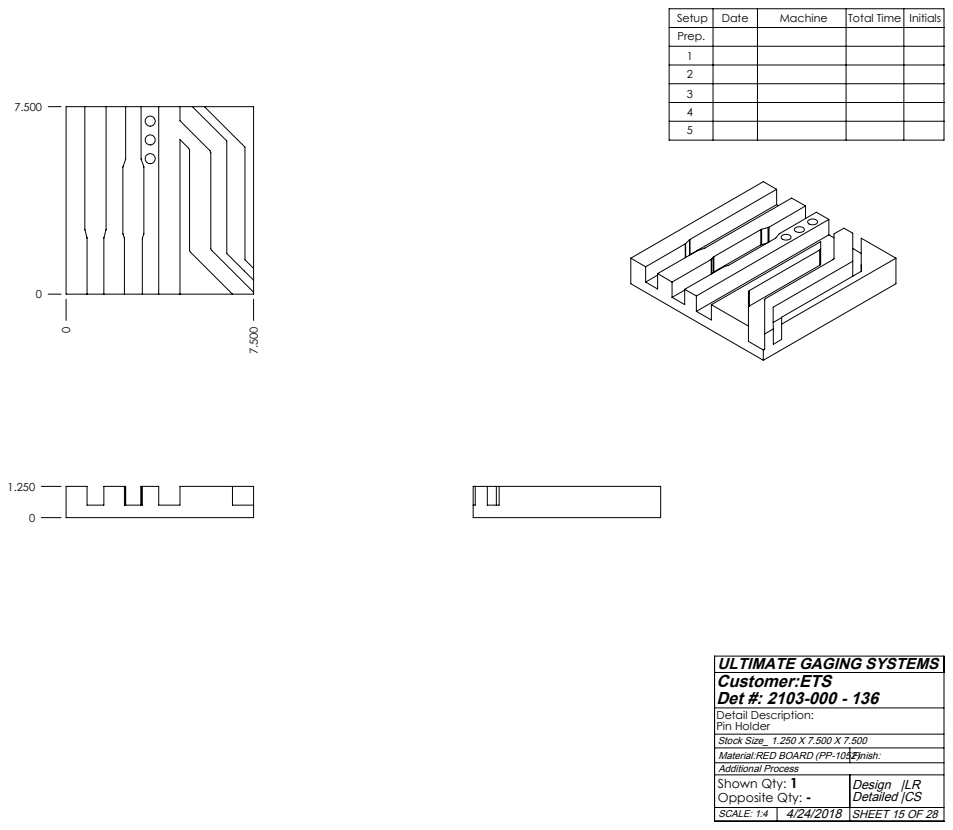
[picture p296: page 15]
SCALE: 1:4; SHEET 15 OF 28

ULTIMATE GAGING SYSTEMS
Customer:ETS
Det #: 2103-000 - 136
Detail Description:
Pin Holder
Stock Size_ 1.250 X 7.500 X 7.500
Material:RED BOARD (PP-1052)Finish:
Additional Process

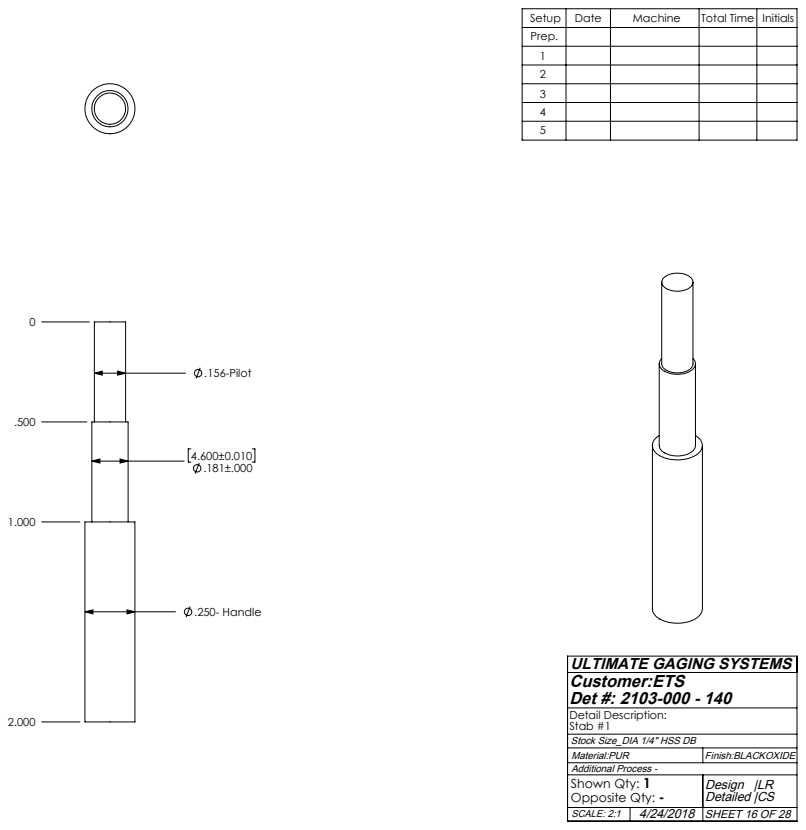
[picture p297: page 16]
.250- Handle; SCALE: 2:1; SHEET 16 OF 28

ULTIMATE GAGING SYSTEMS
Customer:ETS
Det #: 2103-000 - 140
Detail Description:
Stab #1
Stock Size_DIA 1/4" HSS DB
Additional Process -

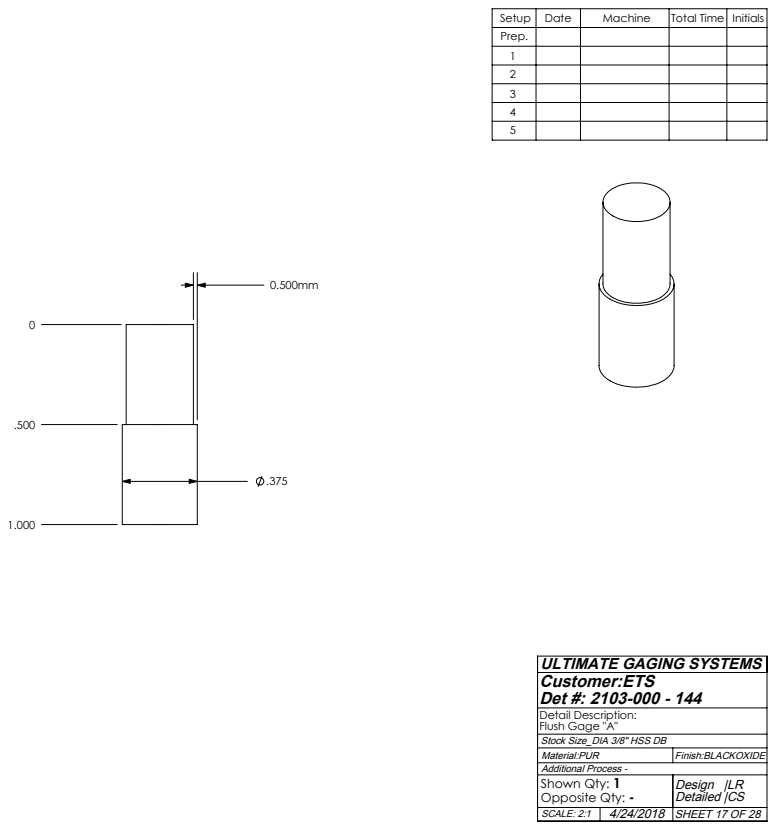
[picture p298: page 17]
SCALE: 2:1; SHEET 17 OF 28

ULTIMATE GAGING SYSTEMS
Customer:ETS
Det #: 2103-000 - 144
Detail Description:
Flush Gage "A"
Stock Size_DIA 3/8" HSS DB
Additional Process -

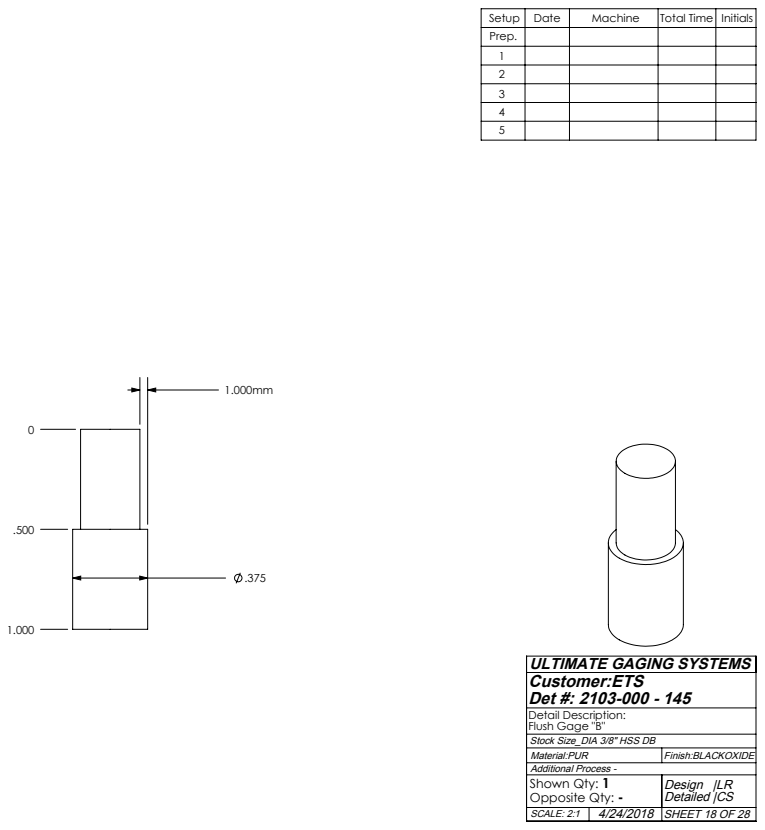
[picture p299: page 18]
SCALE: 2:1; SHEET 18 OF 28

ULTIMATE GAGING SYSTEMS
Customer:ETS
Det #: 2103-000 - 145
Detail Description:
Flush Gage "B"
Stock Size_DIA 3/8" HSS DB
Additional Process -

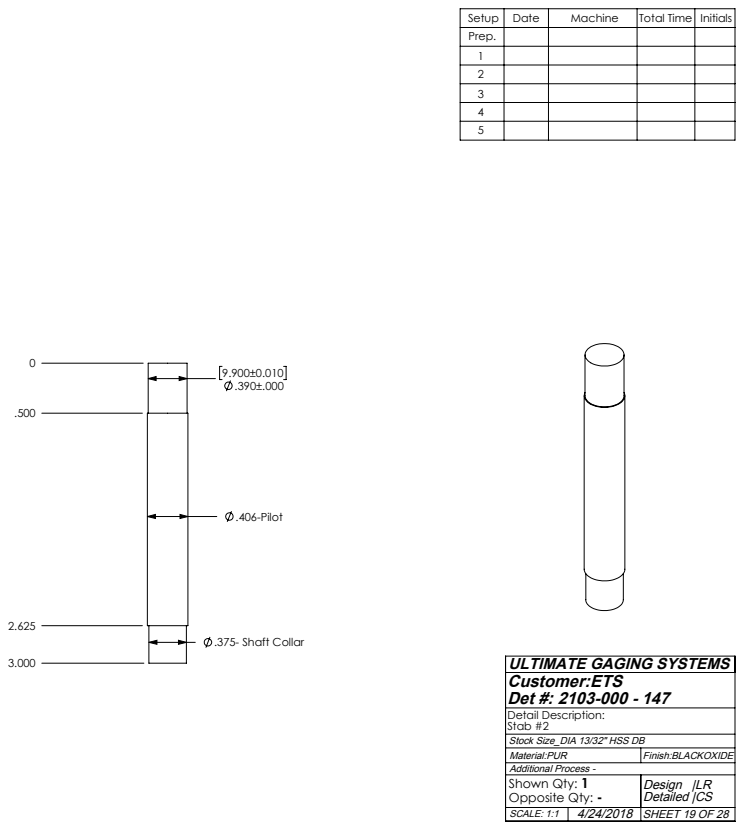
[picture p300: page 19]
.375- Shaft Collar; SCALE: 1:1; SHEET 19 OF 28

ULTIMATE GAGING SYSTEMS
Customer:ETS
Det #: 2103-000 - 147
Detail Description:
Stab #2
Stock Size_DIA 13/32" HSS DB
Additional Process -

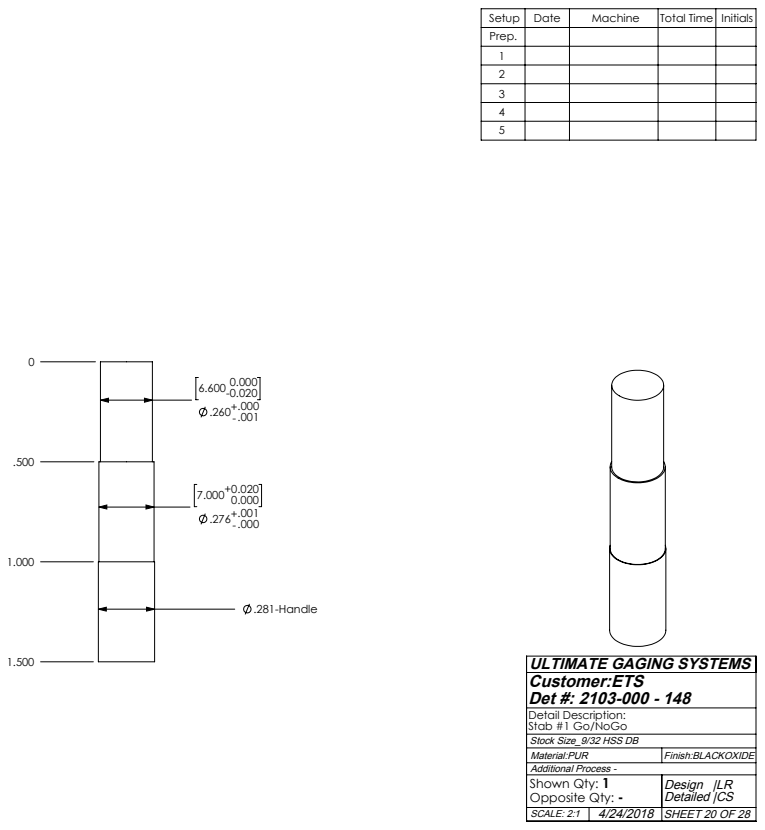
[picture p301: page 20]
SCALE: 2:1; SHEET 20 OF 28

ULTIMATE GAGING SYSTEMS
Customer:ETS
Det #: 2103-000 - 148
Detail Description:
Stab #1 Go/NoGo
Stock Size_9/32 HSS DB
Additional Process -

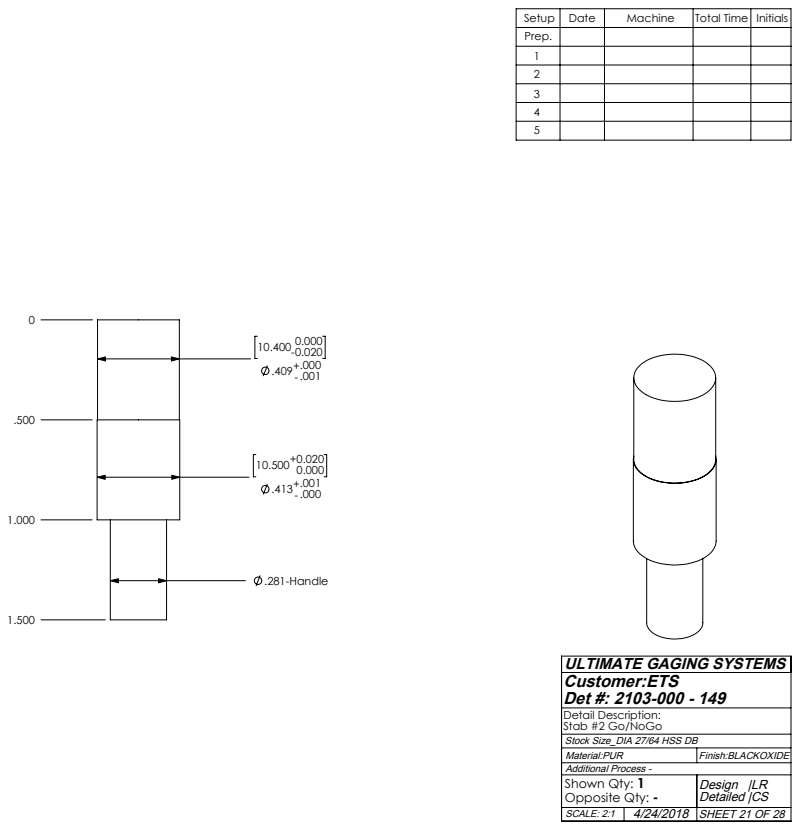
[picture p302: page 21]
SCALE: 2:1; SHEET 21 OF 28

ULTIMATE GAGING SYSTEMS
Customer:ETS
Det #: 2103-000 - 149
Detail Description:
Stab #2 Go/NoGo
Stock Size_DIA 27/64 HSS DB
Additional Process -

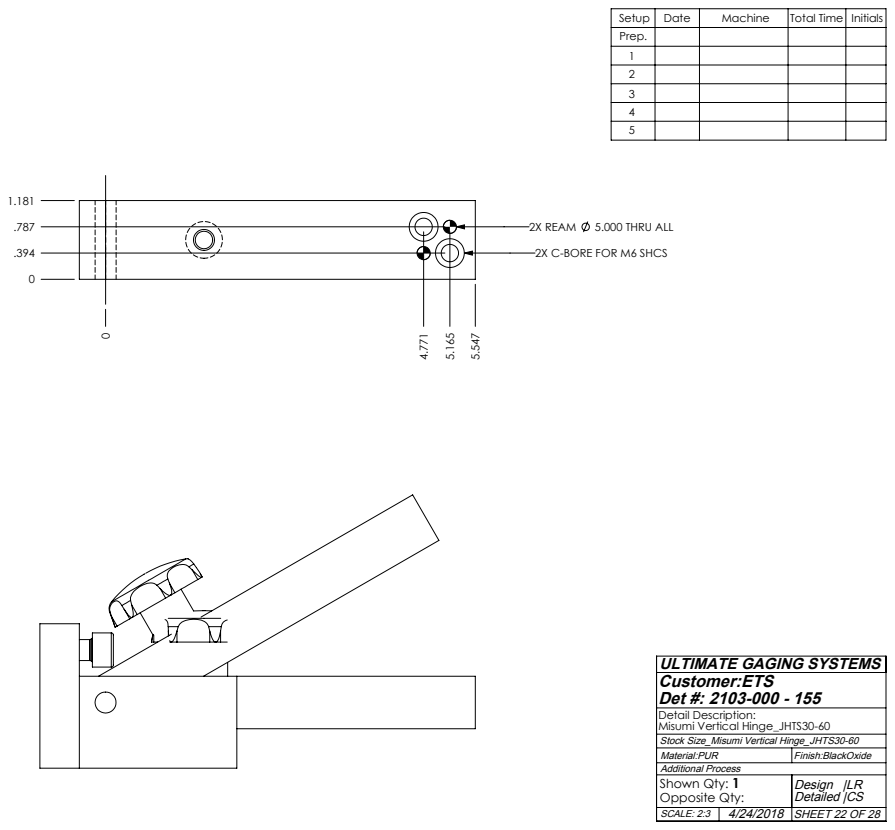
[picture p303: page 22]
2X REAM; 5.000 THRU ALL

2X C-BORE FOR M6 SHCS

ULTIMATE GAGING SYSTEMS
Customer:ETS
Det #: 2103-000 - 155
Detail Description:
Misumi Vertical Hinge_JHTS30-60
Stock Size_Misumi Vertical Hinge_JHTS30-60
Additional Process

Opposite Qty:
SCALE: 2:3 | SHEET 22 OF 28

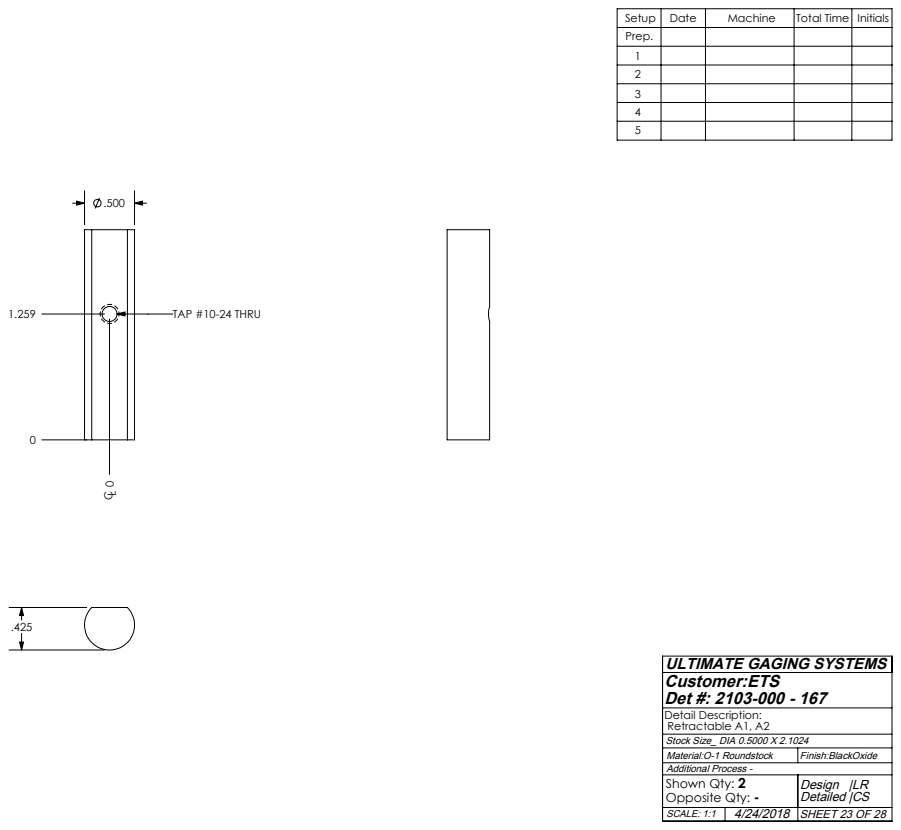
[picture p304: page 23]
TAP #10-24 THRU; Material:O-1 Roundstock; Finish:BlackOxide; SCALE: 1:1; SHEET 23 OF 28

ULTIMATE GAGING SYSTEMS
Customer:ETS
Det #: 2103-000 - 167
Detail Description:
Retractable A1, A2
Stock Size_ DIA 0.5000 X 2.1024
Additional Process -

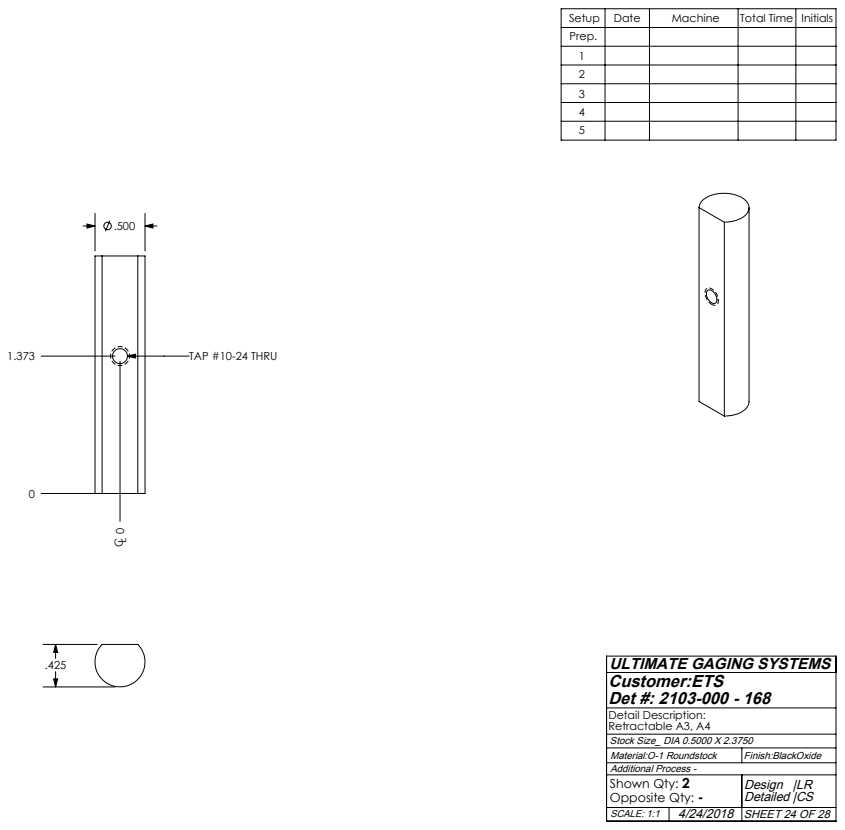
[picture p305: page 24]
TAP #10-24 THRU; Material:O-1 Roundstock; Finish:BlackOxide; SCALE: 1:1; SHEET 24 OF 28

ULTIMATE GAGING SYSTEMS
Customer:ETS
Det #: 2103-000 - 168
Detail Description:
Retractable A3, A4
Stock Size_ DIA 0.5000 X 2.3750
Additional Process -

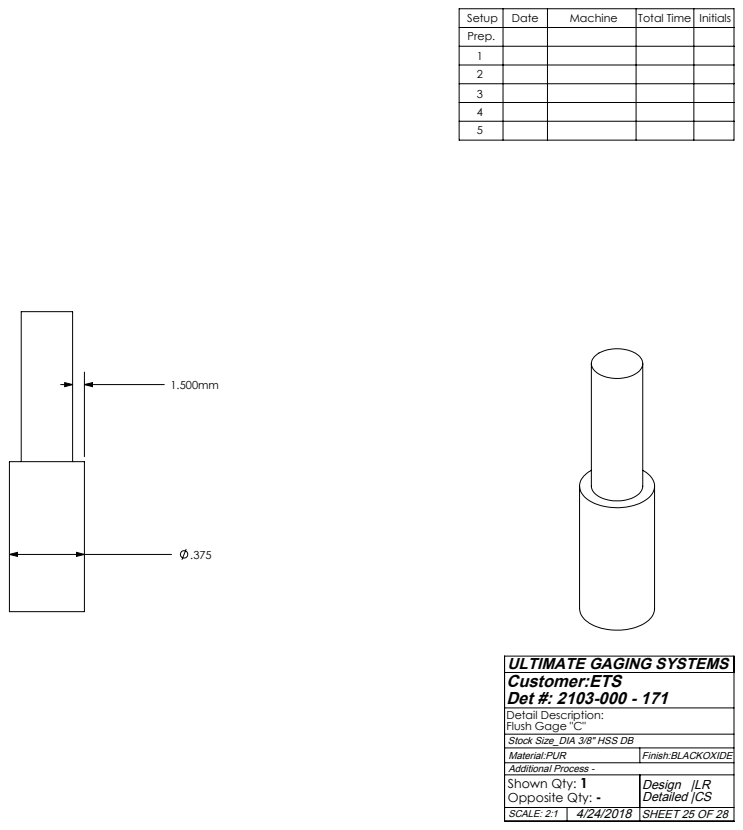
[picture p306: page 25]
SCALE: 2:1; SHEET 25 OF 28

ULTIMATE GAGING SYSTEMS
Customer:ETS
Det #: 2103-000 - 171
Detail Description:
Flush Gage "C"
Stock Size_DIA 3/8" HSS DB
Additional Process -

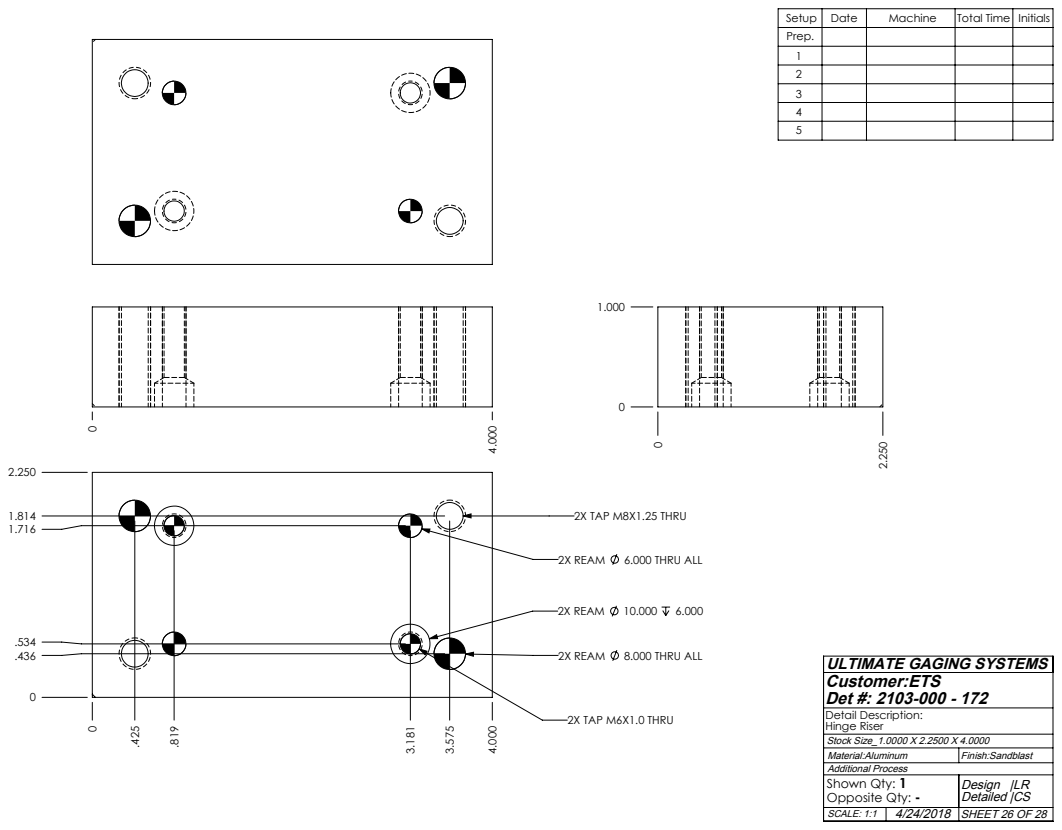
[picture p307: page 26]
2X REAM; 8.000 THRU ALL; 2X TAP M8X1.25 THRU; 6.000 THRU ALL; 2X TAP M6X1.0 THRU; SCALE: 1:1; SHEET 26 OF 28

ULTIMATE GAGING SYSTEMS
Customer:ETS
Det #: 2103-000 - 172
Detail Description:
Hinge Riser
Stock Size_1.0000 X 2.2500 X 4.0000
Additional Process

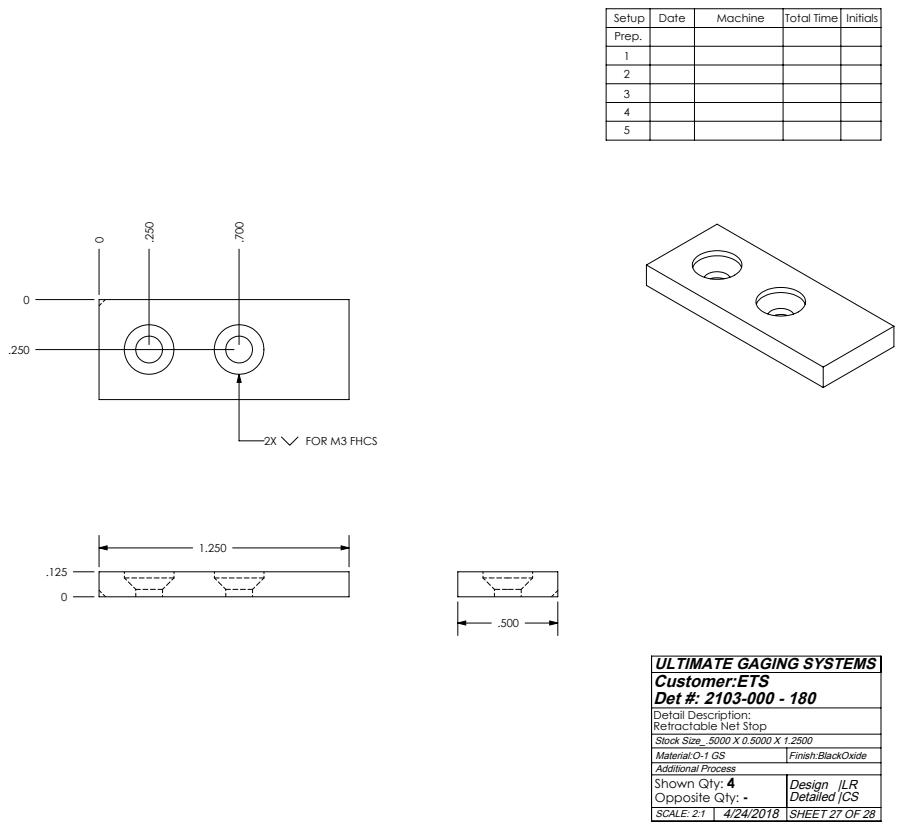
[picture p308: page 27]
FOR M3 FHCS; Material:O-1 GS; Finish:BlackOxide; SCALE: 2:1; SHEET 27 OF 28

ULTIMATE GAGING SYSTEMS
Customer:ETS
Det #: 2103-000 - 180
Detail Description:
Retractable Net Stop
Stock Size_.5000 X 0.5000 X 1.2500
Additional Process

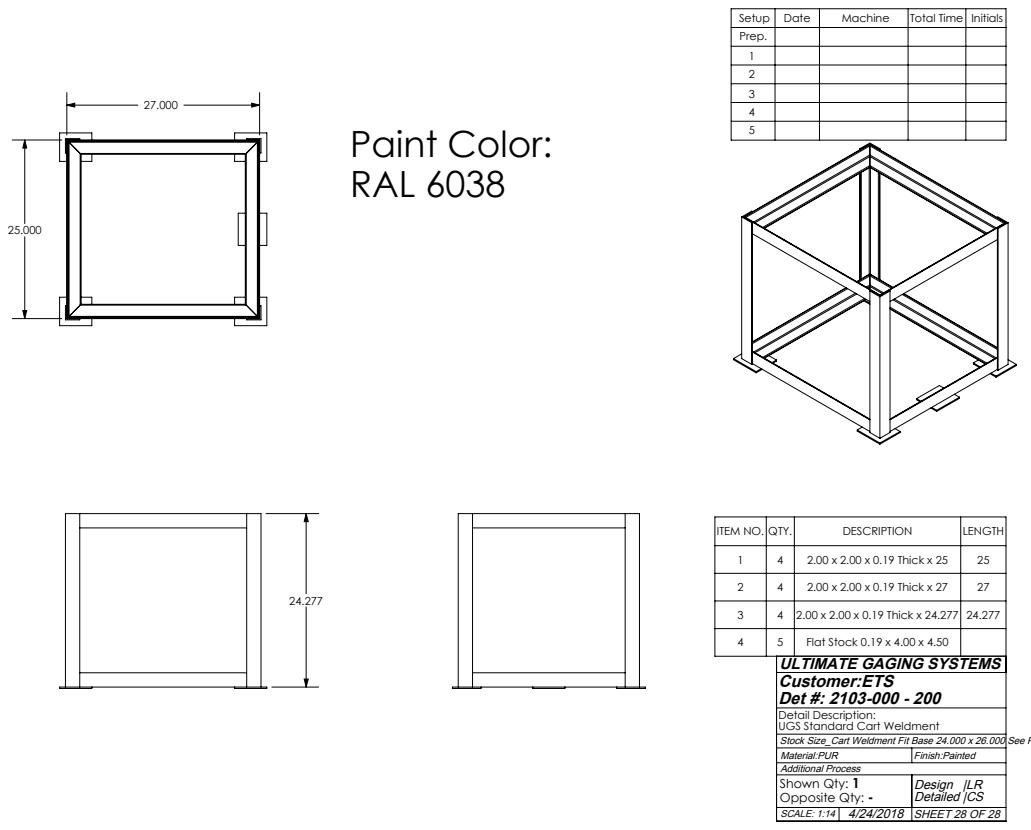
[picture p309: page 28]
Paint Color: RAL 6038; SCALE: 1:14; SHEET 28 OF 28

ITEM NO. QTY. | | DESCRIPTION | LENGTH
1 | 4 | 2.00 x 2.00 x 0.19 Thick x 25 | 25
2 | 4 | 2.00 x 2.00 x 0.19 Thick x 27 | 27
3 | 4 | 2.00 x 2.00 x 0.19 Thick x 24.277 | 24.277
4 | 5 | Flat Stock 0.19 x 4.00 x 4.50

ULTIMATE GAGING SYSTEMS
Customer:ETS
Det #: 2103-000 - 200
Detail Description:
UGS Standard Cart Weldment
Stock Size_Cart Weldment Fit Base 24.000 x 26.000 See Print
Additional Process
