MCBailey-CTS/0Library/SeedFiles/ClampFeetDocs/Otscon_660Ton_Press.pdf

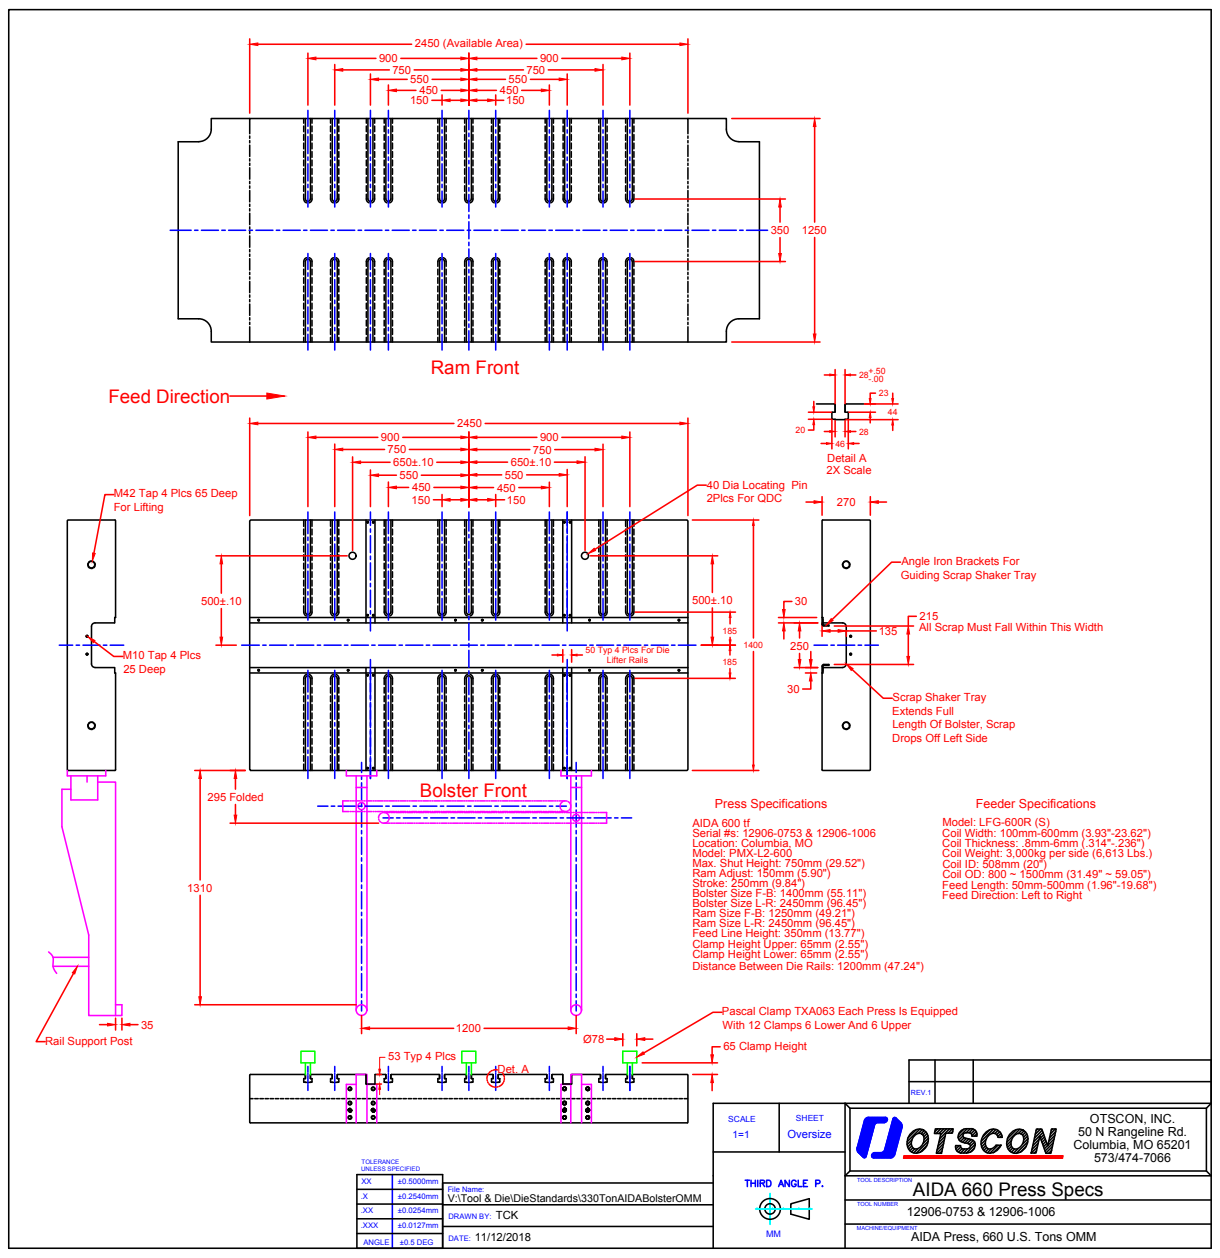
[picture p310: page 1]
ANGLE; ±0.5 DEG ±0.2540mm ±0.0127mm ±0.0254mm .XXX .XX .X; DATE:; MM DRAWN BY:; MACHINE/EQUIPMENT TOOL NUMBER TOOL DESCRIPTION UNLESS SPECIFIED TOLERANCE; SCALE 1=1; Oversize SHEET File Name:; TCK XX; REV.1; OTSCON, INC. 50 N Rangeline Rd. Columbia, MO 65201 573/474-7066 M42 Tap 4 Plcs 65 Deep For Lifting; 135 270 500±.10 40 Dia Locating Pin 2Plcs For QDC; Scrap Shaker Tray Extends Full Length Of Bolster, Scrap Drops Off Left Side Bolster Front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
