MCBailey-CTS/0Library/SeedFiles/ClampFeetDocs/Otscon_97Ton_Press.pdf

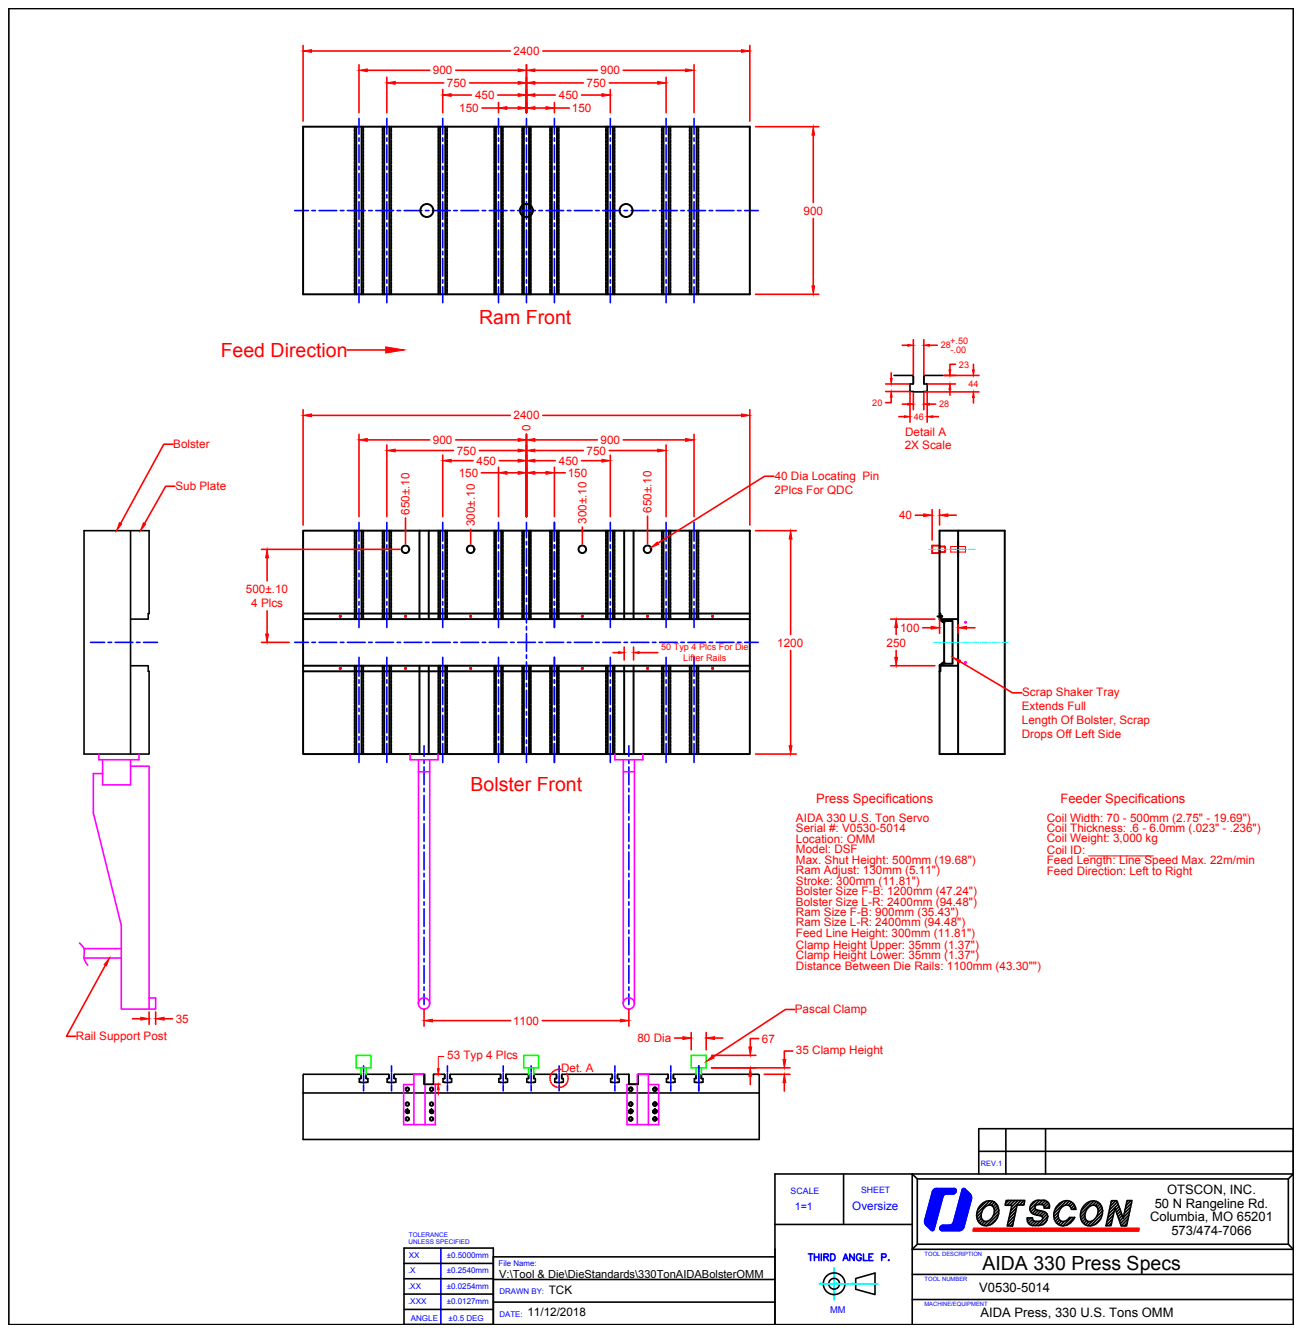
[picture p311: page 1]
MACHINE/EQUIPMENT TOOL NUMBER TOOL DESCRIPTION SCALE 1=1; Oversize SHEET; REV.1; OTSCON, INC. 50 N Rangeline Rd. Columbia, MO 65201 573/474-7066 AIDA 330 U.S. Ton Servo Serial #: V0530-5014 Location: OMM Model: DSF Max. Shut Height: 500mm (19.68") Ram Adjust: 130mm (5.11") Stroke: 300mm (11.81") Bolster Size F-B: 1200mm (47.24") Bolster Size L-R: 2400mm (94.48") Ram Size F-B: 900mm (35.43") Ram Size L-R: 2400mm (94.48") Feed Line Height: 300mm (11.81")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

650±.10 2400 500±.10 4 Plcs 1200 50 Typ 4 Plcs For Die Lifter Rails 40 Dia Locating Pin 2Plcs For QDC 250100 Scrap Shaker Tray Extends Full Length Of Bolster, Scrap Drops Off Left Side 40 Feed Direction Ram Front 28+.50 -.002344 28 46 20 Detail A 2X Scale Det. A 53 Typ 4 Plcs 35 Clamp Height Pascal Clamp 80 Dia 67 1100 Bolster Front 35 Rail Support Post 900 150450 750 900 150 450 750900 2400 Bolster Sub Plate ANGLE ±0.5 DEG ±0.2540mm ±0.0127mm ±0.0254mm .XXX .XX .X DATE: DRAWN BY: UNLESS SPECIFIED TOLERANCE File Name: V:\Tool & Die\DieStandards\330TonAIDABolsterOMM TCK 11/12/2018 XX ±0.5000mm AIDA 330 Press Specs AIDA Press, 330 U.S. Tons OMM V0530-5014 Press Specifications Feeder Specifications
