MCBailey-CTS/0Library/Stamps/Ridgeview/pdf/RVI-L-STAMP.PDF

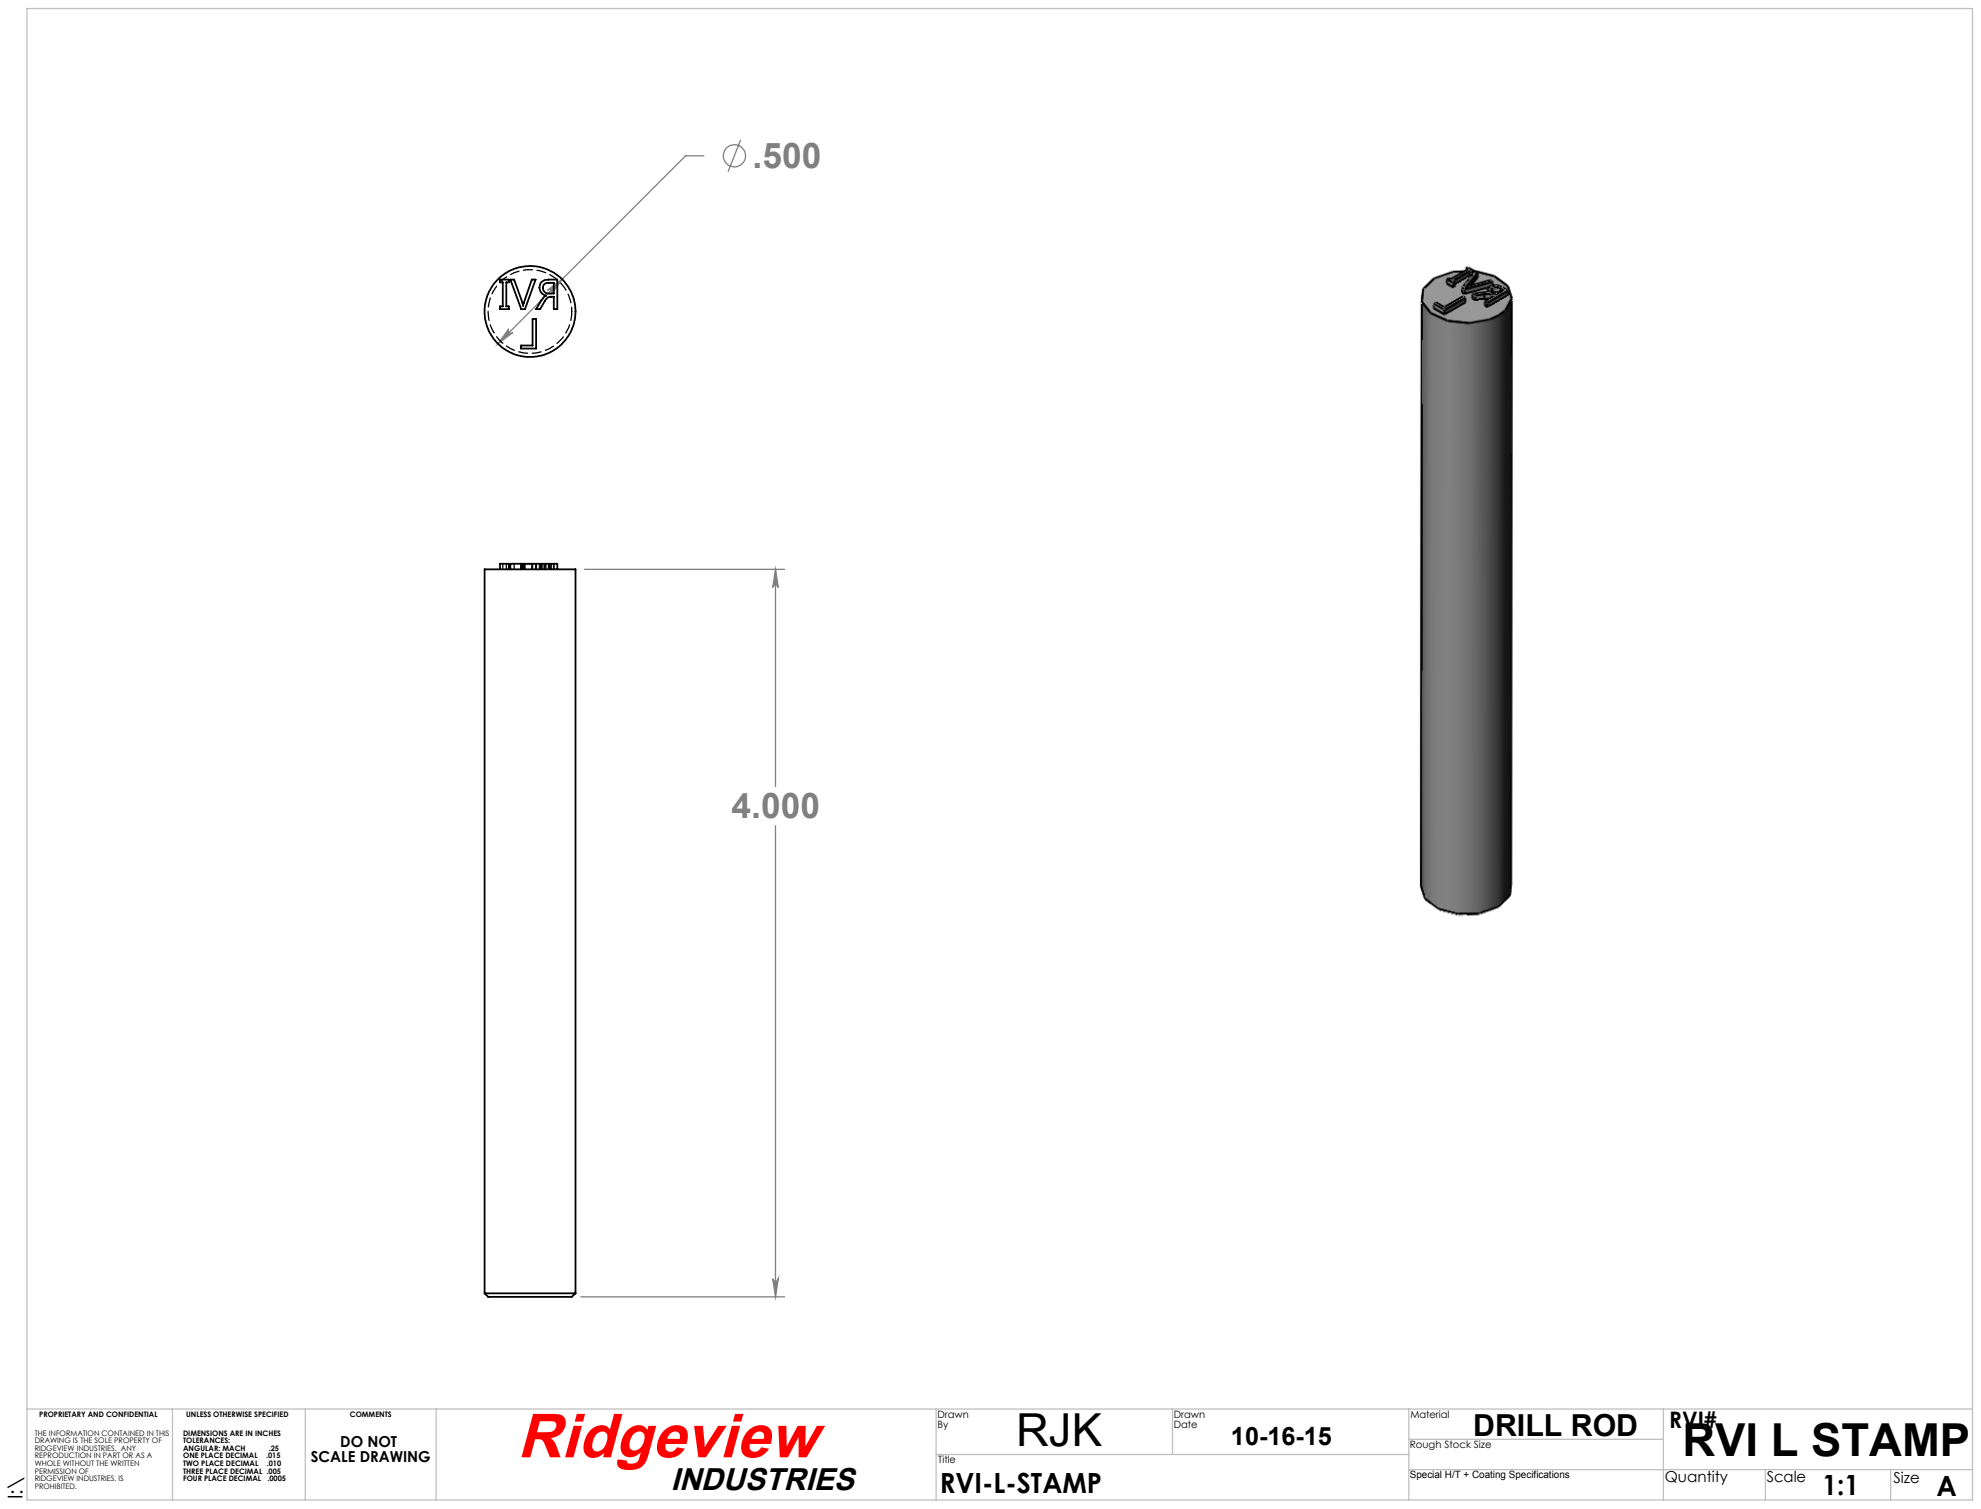
[picture p312: page 1]
A Size; PROPRIETARY AND CONFIDENTIAL; Material; DO NOT SCALE DRAWING; ANGULAR: MACH; Ridgeview; DRILL ROD; RVI L STAMP

RVI# Rough Stock Size

UNLESS OTHERWISE SPECIFIED
DIMENSIONS ARE IN INCHES
TOLERANCES:
ONE PLACE DECIMAL .015
TWO PLACE DECIMAL .010
THREE PLACE DECIMAL .005
FOUR PLACE DECIMAL .0005

THE INFORMATION CONTAINED IN THIS
DRAWING IS THE SOLE PROPERTY OF
RIDGEVIEW INDUSTRIES. ANY
REPRODUCTION IN PART OR AS A
WHOLE WITHOUT THE WRITTEN
PERMISSION OF
RIDGEVIEW INDUSTRIES. IS
PROHIBITED.

Special H/T + Coating Specifications
