MCBailey-CTS/0Library/Wearplates/Metric/Wearplates Info/10 mm Wearplates/Misumi 10 Bronze.pdf

# OIL-FREE SLIDE PLATES

## －COPPER ALLOY 10mm TYPE・2 BOLT HOLES / 4 BOLT HOLES－

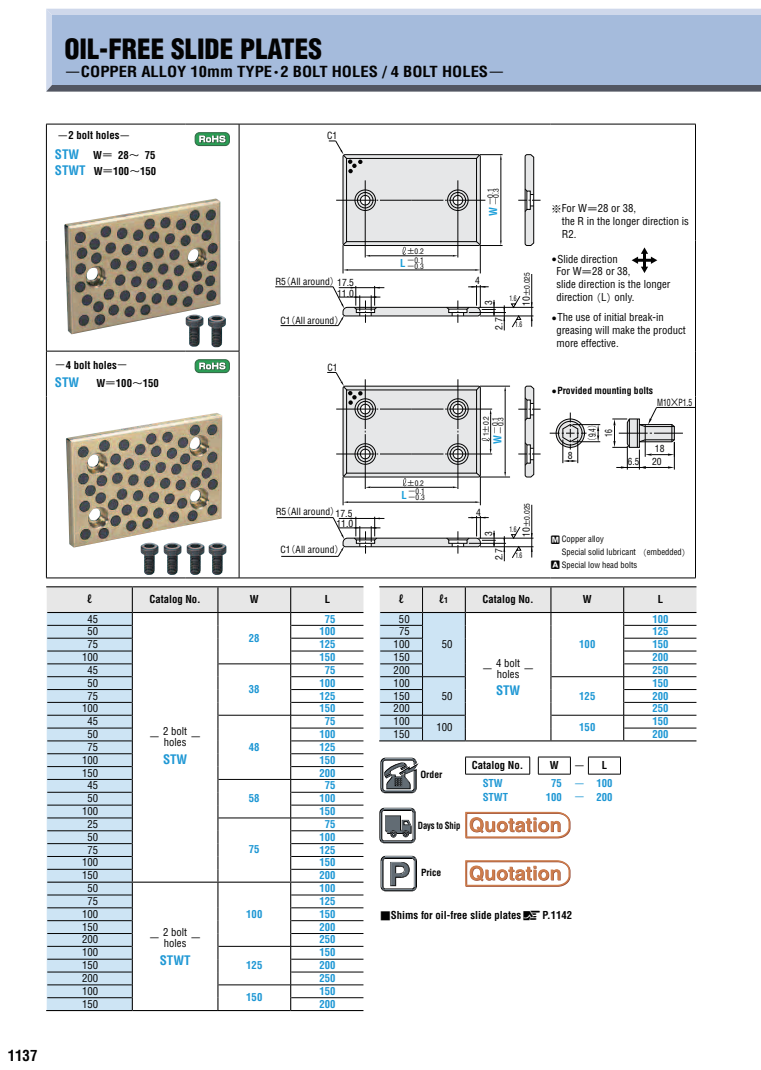
[picture p313: page 1]
－4 bolt holes－; STW W＝100～150; ● Provided mounting bolts; Catalog No.; Order; STW; STWT; Price; C1（All around）; R5（All around）

－2 bolt holes－
STW W＝ 28～ 75
STWT W＝100～150
■Shims for oil-free slide platesP.1142 ¹⁰±⁰.025 2.7

※For W＝28 or 38,
the R in the longer direction is
● Slide direction
For W＝28 or 38,
slide direction is the longer
direction （L） only.
● The use of initial break-in
greasing will make the product
more effective.

～ Copper alloy
Special solid lubricant （embedded）
Special low head bolts

45 | － 2 bolt holes － STW | 28 | 75 | 50 | 50 | － 4 bolt holes － STW | 100
50 | | | 100
75 | | | 125
100 | | | 150
45 | | 38 | 75
50 | | | 100 | 100 | 50 | | 125
45 | | 48 | 75
100 | | 150
150 | | 200
45 | 58 | 75

Days to Ship

150 | | | 200
50 | － 2 bolt holes － STWT | 100
