MCBailey-CTS/0Library/Wearplates/Metric/Wearplates Info/20 mm Wearplates/Misumi 20 Steel.pdf

# OIL-FREE SLIDE PLATES

## －SINTERED ALLOY 20mm TYPE・2 BOLT HOLES / 4 BOLT HOLES－

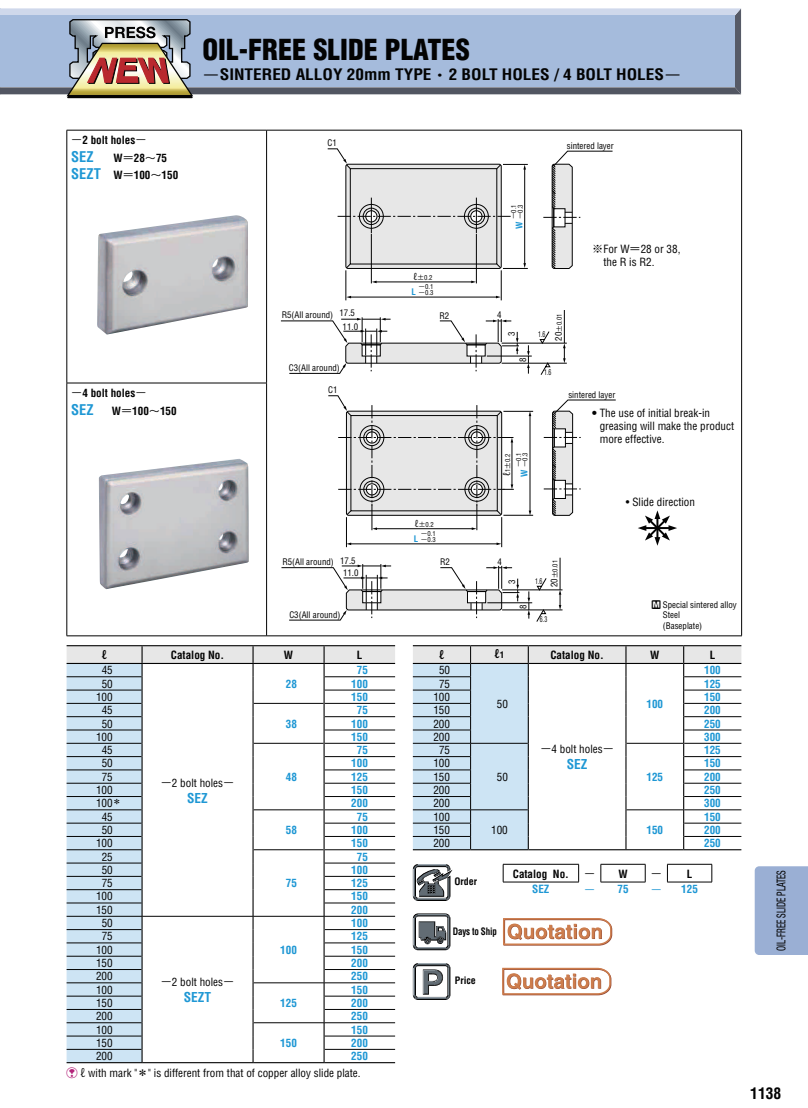
[picture p314: page 1]
－2 bolt holes－ SEZ W＝28～75 SEZT W＝100～150; －4 bolt holes－ SEZ W＝100～150; ※For W＝28 or 38, the R is R2.; Catalog No.; R5(All around); C3(All around); sintered layer; Order; SEZ; Price; • Slide direction

sintered layer
• The use of initial break-in
greasing will make the product
more effective.

R Special sintered alloy
Steel
(Baseplate)

45 | －2 bolt holes－ SEZ | 28 | 75 | 50 | 50 | －4 bolt holes－ SEZ | 100
50 | | | 100
100 | | | 150
45 | | 38 | 75
45 | | 48 | 75 | 75 | 50 | | 125
75 | | | 125
100＊ | | | 200
45 | | 58 | 75 | 100 | 100 | | 150
25 | | 75

OIL-FREE SLIDE PLATES

50 | －2 bolt holes－ SEZT | 100 | 100

Days to Ship

200 | | 250
100 | 125 | 150

V ℓ with mark "＊" is different from that of copper alloy slide plate.
